barebaric/rayforge/website/docs/ui/bottom-panel.md

---
description:
  "The bottom panel in Rayforge provides job progress, G-code preview, and machine status. Monitor
  your laser cutter during operation."
---

# Bottom Panel

The Bottom Panel at the bottom of the Rayforge window provides manual control over your laser
cutter's position, real-time machine status, a log view for monitoring operations, a G-code viewer,
and an asset browser.

## Overview

The Bottom Panel combines several functions into one convenient interface:

1. **Dockable Tabs**: Switch between Console, G-code Viewer, and Assets using the icon strip on the
   left
2. **Jog Controls**: Manual movement and positioning (always visible)
3. **Machine Status**: Real-time position and connection state
4. **Work Coordinate System (WCS)**: Quick WCS selection (always visible)

Each panel area has an icon tab strip on the left that lets you switch between the **Console**, the
**G-code Viewer**, and the **Assets** browser. The jog controls and WCS controls on the right side
remain visible regardless of which tab is active. Tabs can be reordered by dragging within their
strip, and you can drag tabs between panel areas or onto dividers to rearrange the layout into
multiple columns. Empty columns are removed automatically.

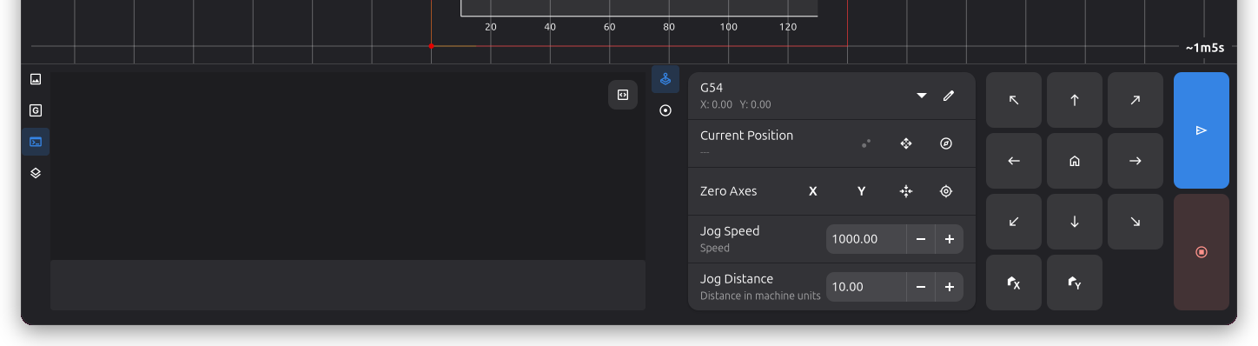
[picture p15: website/static/screenshots/bottom-panel-console.webp]
Bottom Panel


## Accessing the Bottom Panel

The Bottom Panel can be toggled via:

- **Menu**: View → Bottom Panel
- **Keyboard Shortcut**: Ctrl+L

<!-- prettier-ignore-start -->
:::note[Connection Required]
The jog controls are only available when connected to a machine that
supports jogging operations.
:::
<!-- prettier-ignore-end -->

## Jog Controls

The jog controls provide manual control over your laser cutter's position, allowing you to precisely
move the laser head for setup, alignment, and testing purposes.

### Homing Controls

Home your machine's axes to establish a reference position:

| Button | Function | Description |
| --- | --- | --- |
| Home All | Homes all axes | Homes all axes simultaneously |

<!-- prettier-ignore-start -->
:::tip[Homing Sequence]
It's recommended to home all axes before starting any job to ensure accurate
positioning.
:::
<!-- prettier-ignore-end -->

### Directional Movement

The jog controls provide buttons for directional movement:

```
  ↖  ↑  ↗
  ←  •  →
  ↙  ↓  ↘
```

| Button | Movement | Keyboard Shortcut |
| --- | --- | --- |
| ↑ | Y+ (Y- if machine is Y-flipped) | Up Arrow |
| ↓ | Y- (Y+ if machine is Y-flipped) | Down Arrow |
| ← | X- (left) | Left Arrow |
| → | X+ (right) | Right Arrow |
| ↖ (top-left) | X- Y+/- (diagonal) | - |
| ↗ (top-right) | X+ Y+/- (diagonal) | - |
| ↙ (bottom-left)  | X- Y-/+ (diagonal) | - |
| ↘ (bottom-right) | X+ Y-/+ (diagonal) | - |
| Z+ | Z axis up | Page Up |
| Z- | Z axis down | Page Down |

<!-- prettier-ignore-start -->
:::note[Focus Required]
Keyboard shortcuts only work when the main window has focus.
:::
<!-- prettier-ignore-end -->

### Visual Feedback

The jog buttons provide visual feedback:

- **Normal**: Button is enabled and safe to use
- **Warning (orange)**: Movement would approach or exceed soft limits
- **Disabled**: Movement is not supported or machine is not connected

### Jog Settings

Configure the behavior of jog operations:

**Jog Speed:**

- **Range**: 1-60,000 mm/min
- **Default**: 1,000 mm/min
- **Purpose**: Controls how fast the laser head moves
- **Persistence**: The last used speed is stored per machine

<!-- prettier-ignore-start -->
:::tip[Speed Selection]
- Use lower speeds (100-500 mm/min) for precise positioning
- Use higher speeds (1,000-3,000 mm/min) for larger movements
- Very high speeds may cause missed steps on some machines
:::
<!-- prettier-ignore-end -->

**Jog Distance:**

- **Range**: 0.1-1,000 mm
- **Default**: 10.0 mm
- **Purpose**: Controls how far the laser head moves per button press

<!-- prettier-ignore-start -->
:::tip[Distance Selection]
- Use small distances (0.1-1.0 mm) for fine-tuning
- Use medium distances (5-20 mm) for general positioning
- Use large distances (50-100 mm) for quick repositioning
:::
<!-- prettier-ignore-end -->

## Moving the Laser Head

In addition to jogging, the laser head can be moved to an exact position. All of these moves use the
**Jog Speed** setting described above.

### Move to Position Popover

Click the compass icon in the Current Position row to open the Move to Position popover. It is
prefilled with the current position, and coordinates are entered in the active work coordinate
system, matching the position readout:

| Control | Function |
| --- | --- |
| X / Y / Z | Target coordinates (Z only on machines with a Z axis) |
| Move | Moves the head to the entered coordinates |
| Lower-Left | Move to lower-left of the selection, or workarea if none  |
| Center | Move to center of the selection, or workarea if none |
| Upper-Right | Move to upper-right of the selection, or workarea if none |
| Move to WCS Origin | Move to X0 Y0 of the active WCS |

The popover and its shortcuts are disabled while the machine is offline.

### Click Canvas to Move Head

Click the move icon in the Current Position row (or press <kbd>Ctrl+M</kbd>) to arm the mode. The
next left-click on empty canvas space moves the head to that point, and the mode then deactivates
automatically. Right-clicking cancels the mode without moving the head. Arming this mode deactivates
Click to Zero, and vice versa.

### Move Head Here

Right-clicking empty canvas space offers a **Move Head Here** entry that moves the head directly to
the clicked point.

## Machine Status Display

The Control Panel displays real-time information about your machine:

### Current Position

Shows the laser head's position in the active coordinate system:

- Coordinates are relative to the selected WCS origin
- Updates in real-time as you jog or run jobs
- Format: X, Y, Z values in millimeters

### Connection Status

- **Connected**: Green indicator, machine is responding
- **Disconnected**: Gray indicator, no machine connection
- **Error**: Red indicator, connection or communication problem

### Machine State

- **Idle**: Machine is ready for commands
- **Run**: Job is currently executing
- **Hold**: Job is paused
- **Alarm**: Machine is in alarm state
- **Home**: Homing cycle is in progress

## Work Coordinate System (WCS)

The Control Panel provides quick access to Work Coordinate System management.

### Active System Selection

Select which coordinate system is currently active:

| Option | Type  | Description |
| --- | ----- | --- |
| G53 (Machine) | Fixed | Absolute machine coordinates, cannot be changed |
| G54 (Work 1)  | User  | First work coordinate system |
| G55 (Work 2)  | User  | Second work coordinate system |
| G56 (Work 3)  | User  | Third work coordinate system |
| G57 (Work 4)  | User  | Fourth work coordinate system |
| G58 (Work 5)  | User  | Fifth work coordinate system |
| G59 (Work 6)  | User  | Sixth work coordinate system |

### Setting WCS Zero

Define where the origin of the active WCS should be:

| Button | Function  | Description |
| --- | --- | --- |
| Click to Zero  | Set X,Y=0 | Click the crosshairs icon, then click on the canvas to set work zero |
| Go to WCS Zero | Move | Move the laser head to X0 Y0 of the active WCS |
| Edit Offsets | Edit | Manually edit WCS offset values |
| Zero X | Set X=0 | Makes current X position the X origin for active WCS |
| Zero Y | Set Y=0 | Makes current Y position the Y origin for active WCS |
| Zero Z | Set Z=0 | Makes current Z position the Z origin for active WCS |

<!-- prettier-ignore-start -->
:::note[G53 Cannot Be Changed]
Zero buttons are disabled when G53 (Machine Coordinates) is selected,
as machine coordinates are fixed by hardware.
:::
<!-- prettier-ignore-end -->

<!-- prettier-ignore-start -->
:::tip[Setting WCS Workflow]
1. Connect to your machine and home all axes
2. Select the WCS you want to configure (e.g., G54)
3. Jog the laser head to the desired origin position
4. Click Zero X and Zero Y to set this position as (0, 0)
5. The offset is stored in your machine's controller
:::
<!-- prettier-ignore-end -->

## Console Tab

The Console tab provides an interactive terminal-style interface for sending G-code commands and
monitoring machine communication. Click the console icon in the tab strip to switch to this view.

### Command Input

The command input box allows you to send raw G-code directly to the machine:

- **Multi-line Support**: Paste or type multiple commands
- **Enter**: Sends all commands
- **Shift+Enter**: Inserts a newline (for editing before sending)
- **History**: Use Up/Down arrows to navigate previously sent commands

### Log Display

The log shows communication between Rayforge and your machine with syntax highlighting for easy
reading:

- **User Commands** (blue): Commands you entered or sent during jobs
- **Timestamps** (gray): Time of each message
- **Errors** (red): Error messages from the machine
- **Warnings** (orange): Warning messages
- **Status Polls** (dim): Real-time position/status reports like
  `&lt;Idle|WPos:0.000,0.000,0.000|...&gt;`

### Verbose Mode

Click the terminal icon in the top-right corner of the console to toggle verbose output:

- **Off** (default): Hides frequent status polls and "ok" responses
- **On**: Shows all machine communication

### Auto-Scroll Behavior

The console automatically scrolls to show new messages:

- Scrolling up disables auto-scroll so you can review history
- Scrolling to the bottom re-enables auto-scroll
- New messages appear immediately when auto-scroll is active

### Using the Console for Troubleshooting

The console is invaluable for diagnosing issues:

- Verify commands are being sent correctly
- Check for error messages from the controller
- Monitor connection status and stability
- Review job execution progress in real-time
- Send diagnostic commands (e.g., `$$` to view GRBL settings)

## G-code Viewer Tab

The G-code Viewer tab displays the generated G-code for the current operations. Click the G-code
icon in the tab strip to switch to this view.

### Features

- **Syntax Highlighting**: G-code commands are color-coded for readability
- **Line Highlighting**: The currently executing line is highlighted during job execution
- **Auto-Refresh**: The G-code content updates automatically when operations or document settings
  change

## Assets Tab

The Assets tab shows all stock items and sketches in your document. Click the assets icon in the tab
strip to switch to this view.

When the asset list is empty, it displays buttons to add stock or create a new sketch. You can drag
assets from this list onto the canvas to place them. Double-clicking a stock asset opens its
properties.

Right-clicking an asset opens a context menu with options to create a new workpiece from the asset,
duplicate, copy, cut, or delete it. Right-clicking empty space in the asset list offers options to
create a new sketch, add stock, import a file, or paste from the clipboard.

When the Console or G-code Viewer tab is active, you can also press <kbd>Ctrl+F</kbd> to search
within the content.

## Laser Control

The Laser dock provides manual control over your laser for testing, alignment, and focusing. It
appears as a tab alongside the Controls dock in the bottom panel.

### Laser Head Selector

A dropdown lists all configured laser heads. When your machine has multiple heads, pick the one you
want to control. The subtitle shows the tool number and maximum power for the selected head.

### Toggle Button

The toggle button next to the head selector turns the laser on or off. When the laser is active, the
button turns red as a safety indicator. The laser can also be toggled from the toolbar button in the
main window header.

### Power

A slider and text entry control the laser power from 0 to 100 percent. When you switch to a
different laser head, the power resets to that head's configured focus power.

### Frequency and Pulse Width

These controls appear only when the selected laser head is a CO2 or Fiber type. They let you set the
PWM frequency (Hz) and pulse width (microseconds) for manual laser operation. For Diode lasers,
these fields are hidden.

### Duration (Auto-Off Timer)

Set a duration in seconds after which the laser automatically turns off. Set to 0 for continuous
operation — the laser stays on until you manually turn it off. A countdown label appears below the
controls while the timer is running.

### Safety

- All controls are disabled when no laser heads are configured
- The toggle button requires an active machine connection
- If the machine disconnects while the laser is on, the laser is turned off automatically and any
  running timer is cancelled

## Machine Compatibility

The Bottom Panel adapts to your machine's capabilities:

### Axis Support

- **X/Y Axis**: Supported by virtually all laser cutters
- **Z Axis**: Only available on machines with Z-axis control
- **Diagonal Movement**: Requires support for both X and Y axes

### Machine Types

| Machine Type | Jog Support | Notes |
| --- | --- | --- |
| GRBL (v1.1+) | Full | Supports all jog features |
| Smoothieware | Full | Supports all jog features |
| Custom Controllers | Variable | Depends on implementation |

## Safety Features

### Soft Limits

When soft limits are enabled in your machine profile:

- Buttons show orange warning when approaching limits
- Movement is automatically limited to prevent exceeding bounds
- Provides visual feedback to prevent crashes

### Connection Status

- All controls are disabled when not connected to a machine
- Buttons update sensitivity based on machine state
- Prevents accidental movement during operation

---

**Related Pages:**

- [Work Coordinate Systems (WCS)](../general-info/coordinate-systems.md) - Managing WCS
- [Machine Setup](../machine/general.md) - Configure your machine
- [Keyboard Shortcuts](../reference/shortcuts.md) - Complete shortcut reference
- [Main Window](main-window) - Main interface overview
- [General Settings](../machine/general.md) - Device configuration
