barebaric/rayforge/website/docs/application-settings/machines.md

---
description:
  "Manage machines in Rayforge - add, configure, export, import, and switch between different laser
  cutters and engravers for your projects."
---

# Machines

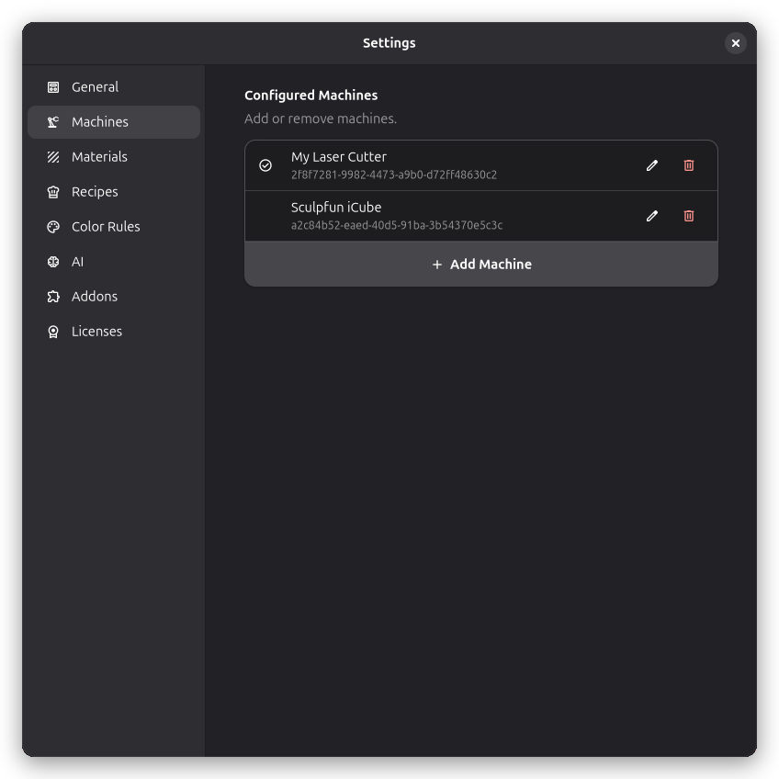
[picture p30: website/static/screenshots/app-settings-machines.webp]
Machines Settings


The Machines page in Application Settings shows a list of all configured machines. Each entry shows
the machine name and has buttons to edit or delete it. The currently active machine is marked with a
check icon.

## Adding a Machine

1. Click the **Add Machine** button at the bottom of the list
2. Select a device profile from the list to use as a template — each profile pre-configures the
   machine settings and G-code dialect

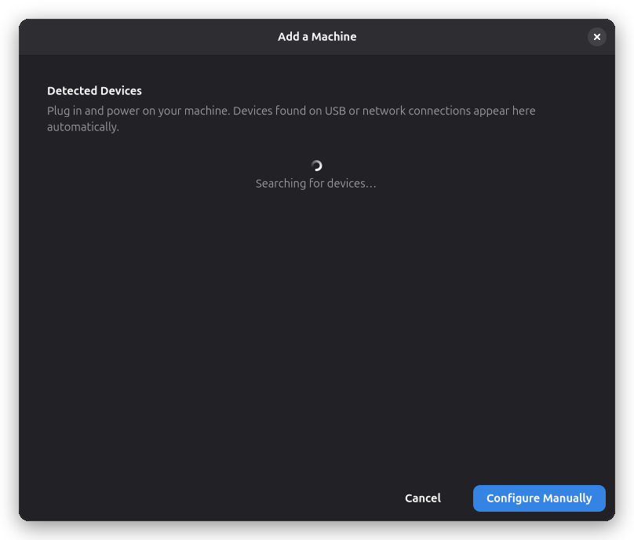
[picture p31: website/static/screenshots/app-settings-machines-add.webp]
Add Machine Dialog


3. The [machine settings dialog](../machine/general.md) opens where you can adjust the configuration

Alternatively:

- Click **Device Not Listed** to launch the
  [Configuration Wizard](../getting-started/first-time-setup.md), which walks you through
  configuring a machine step by step
- Click **Import from File…** to add a machine from a previously exported profile or from a
  LightBurn device profile (.lbdev). LightBurn profiles include camera calibration and laser
  settings that are applied to the new machine

## Editing a Machine

Click the edit icon next to a machine to open the [machine settings dialog](../machine/general.md).

## Machine Notes

The **Notes** category, directly after **General**, brings together guidance supplied by the device
profile and your own notes for that machine. Device notes are read-only; **My Notes** can be edited
with Markdown. Supported syntax includes headings, paragraphs, bold, italic, lists, links, inline
code, fenced code blocks, and expandable `:::details` sections.

When a profile includes setup guidance, it also appears on the wizard's final **Review & Name** page
and remains available under **Machine Settings → Notes** after the machine is created. Personal
notes are saved per machine and are not replaced when reviewing profile updates.

## Switching the Active Machine

Use the machine dropdown in the main window header to switch between configured machines. The
selection is remembered between sessions.

## Deleting a Machine

1. Click the delete icon next to the machine
2. Confirm the deletion

<!-- prettier-ignore-start -->
:::warning
Deleting a machine cannot be undone. Export the profile first if you want to preserve the
configuration.
:::
<!-- prettier-ignore-end -->
