barebaric/rayforge/website/docs/ui/3d-preview.md

---
description:
  "Preview your laser job in full 3D. Visualize toolpaths, rotary axis operations, and material
  removal before sending G-code to your machine."
---

# 3D View

The 3D view lets you visualize your G-code toolpaths and simulate job execution before sending them
to your machine.

3D Preview

## Opening 3D View

Access the 3D view:

- **Menu**: View → 3D View
- **Keyboard**: <kbd>F12</kbd>

## Navigation

### Mouse Controls

- **Rotate**: Left-click and drag (Z-axis), middle-click and drag (3-axis orbit)
- **Pan**: <kbd>shift</kbd> + middle-click and drag
- **Zoom**: Scroll wheel

### View Presets

Quick camera angles:

- **Top** (<kbd>1</kbd>): Bird's eye view
- **Front** (<kbd>2</kbd>): Front elevation
- **Right** (<kbd>3</kbd>): Right side view
- **Left** (<kbd>4</kbd>): Left side view
- **Back** (<kbd>5</kbd>): Back elevation
- **Isometric** (<kbd>7</kbd>): 3D isometric view

## Work Coordinate System Display

The 3D view visualizes the active Work Coordinate System (WCS) differently from the 2D canvas:

### Grid and Axes

- **Isolated display**: The grid and axes appear as if the WCS origin is the world origin
- **Offset applied**: The entire grid is shifted to align with the selected WCS offset
- **Labels relative to WCS**: Coordinate labels show positions relative to the WCS origin, not
  machine origin

This "in isolation" display makes it easy to understand where your job will run relative to the
selected work coordinate system, without being confused by the machine's absolute position.

### Changing WCS

The 3D view automatically updates when you change the active WCS:

- Select a different WCS from the toolbar dropdown
- The grid and axes shift to reflect the new WCS origin
- Labels update to show coordinates relative to the new WCS

<!-- prettier-ignore-start -->
:::tip[WCS in 3D View]
The 3D view shows your toolpaths relative to the selected WCS. When you change
WCS, you'll see the toolpaths appear to move because the reference point (the grid) has changed, not
because the toolpaths themselves moved.
:::
<!-- prettier-ignore-end -->

## Display Options

Visibility toggles are located as overlay buttons at the top-right of the 3D canvas. Each button
remembers its state between sessions:

- **Workpiece image**: Toggle the workpiece's base image on the stock surface — the same image shown
  on the 2D canvas
- **Stock**: Toggle the stock material blocks
- **Model**: Toggle the 3D machine model visibility
- **Grid**: Toggle the coordinate grid visibility
- **Ops underlay**: Toggle the semi-transparent raster engraving preview on the workpiece surface
- **Travel moves**: Toggle rapid travel move visibility
- **No-go zones**: Toggle no-go zone visibility. This button only appears when your machine has at
  least one no-go zone configured.

Perspective and orthographic projection are toggled with <kbd>P</kbd> or **View → Toggle
Perspective**.

### Toolpath Visualization

Customize what you see:

- **Show Rapid Moves**: Display travel moves (dotted lines)
- **Show Work Moves**: Display cutting/engraving moves (solid lines)
- **Color by Operation**: Different colors for each operation

<!-- prettier-ignore-start -->
:::tip[Per-Laser Colors]
When using machines with multiple laser heads, each laser can have its own
color configured in [Laser Settings](../machine/laser.md). This makes it easy to identify which
laser will perform each operation.
:::
<!-- prettier-ignore-end -->

### Laser Head Model

The 3D view renders a model of your laser head that moves along the toolpath during simulation. You
can assign a 3D model to each laser head in the [Laser Settings](../machine/laser.md) page of
Machine Settings. The model's scale, rotation, and focal distance can be adjusted to match your
physical setup.

During simulation, a glowing laser beam is drawn from the head downward when the laser is active.

## Physical Burn Model

When you engrave, the 3D view no longer shows the result as a flat overlay on top of the stock.
Laser raster and vector operations now **char the stock itself** — the preview shows burning driven
by a physically motivated model that accounts for:

- Your laser's **wavelength**, **optical wattage**, and **spot size** (configured in
  [Laser Settings](../machine/laser.md)).
- The **material's absorption** at that wavelength (defined in the
  [material library](../application-settings/materials.md#absorption)).
- The **scan speed**, which sets the energy delivered per unit area (fluence, in J/cm²).

The result is a power-keyed scorch ramp with a heat halo on top-facing surfaces. It works for rotary
too — engraving bakes into the rotary stock.

<!-- prettier-ignore-start -->
:::note[Calibration]
The burn model is physically motivated but not yet fully calibrated across all
materials and laser types. You can help improve it: run a
[material test grid](../features/operations/material-test-grid.md) and share the result photo along
with your machine data (wavelength, optical wattage, spot size, speed, and the powers/depths
tested).
:::
<!-- prettier-ignore-end -->

## Simulation

The 3D view includes a built-in simulator with playback controls overlaid at the bottom of the
canvas.

### Playback Controls

- **Play/Pause** (<kbd>space</kbd>): Animate toolpath execution
- **Step Forward/Back**: Advance or rewind by one operation at a time
- **Speed**: Cycle through playback speeds (1x, 2x, 4x, 8x, 16x)
- **Timeline slider**: Drag to scrub through the job

### Synchronized G-code View

The simulation stays in sync with the G-code viewer in the bottom panel. Stepping through the
simulation highlights the corresponding line in the G-code viewer, and clicking a line in the G-code
viewer jumps the simulation to that point.

### Layer Visibility

Toggle visibility of individual layers:

- Click a layer name to show or hide it
- Focus on specific layers for inspection

## Verification Checklist

Before sending to machine, verify:

- [ ] Toolpath is complete with no missing segments
- [ ] Engrave operations run before cuts
- [ ] Job starts at the expected position
- [ ] Holding tabs are in the correct locations

Some additional checks are performed automatically. When you run or export a job, Rayforge runs
[sanity checks](../features/sanity-checks.md) that verify machine extents, workarea boundaries, and
no-go zone collisions.

## Performance Tips

For large or complex jobs:

1. Hide rapid moves to focus on work moves only
2. Reduce the number of visible layers
3. Close other applications to free up GPU resources

## Troubleshooting

### Preview is blank or black

- Check that operations are enabled
- Verify objects have operations assigned

### Slow or laggy preview

- Hide rapid moves
- Hide 3D models
- Reduce the number of visible layers

---

**Related Pages:**

- [Work Coordinate Systems](../general-info/coordinate-systems.md) - WCS
- [Main Window](main-window) - Main interface overview
- [Settings](settings) - Application preferences
