barebaric/rayforge/website/i18n/uk/docusaurus-plugin-content-docs/current/machine/hardware.md

# Налаштування обладнання

Сторінка "Обладнання" у налаштуваннях машини налаштовує фізичні розміри, систему координат та
обмеження руху вашої машини.

Налаштування обладнання

## Осі

Налаштуйте діапазони осей та систему координат для вашої машини.

### Діапазон X/Y

Повний хід кожної осі в одиницях машини.

- Виміряйте фактичну область різання, а не зовнішній розмір машини
- Врахуйте будь-які перешкоди або обмеження
- Приклад: 400 для типового лазера K40

### Початок координат

Виберіть, де знаходиться початок координат (0,0) вашої машини. Це визначає, як інтерпретуються
координати.

- **Лівий нижній**: Найпоширеніший для пристроїв GRBL. X збільшується вправо, Y збільшується вгору.
- **Лівий верхній**: Поширений для деяких машин типу CNC. X збільшується вправо, Y збільшується
  вниз.
- **Правий верхній**: X збільшується вліво, Y збільшується вниз.
- **Правий нижній**: X збільшується вліво, Y збільшується вгору.

#### Визначення вашого початку координат

1. Виконайте回家 (homing) вашої машини за допомогою кнопки Home
2. Спостерігайте, куди переміщується лазерна головка
3. Ця позиція є вашим початком координат (0,0)

:::інформація Налаштування початку координат впливає на те, як генерується G-code. Переконайтеся, що
воно відповідає конфігурації homing у вашій прошивці. :::

### Напрямок осі

Змініть напрямок будь-якої осі за потреби:

- **Інвертувати вісь X**: Робить значення координат X від'ємними
- **Інвертувати вісь Y**: Робить значення координат Y від'ємними
- **Інвертувати вісь Z**: Увімкніть, якщо позитивна команда Z (наприклад, G0 Z10) переміщує головку
  вниз

### Вісь Z

Не кожен лазер має вісь Z — багато простих 2-вісних діодних машин її не мають. Використовуйте ці
налаштування, щоб повідомити Rayforge, чи може ваша машина рухатися по осі Z:

- **Має вісь Z**: Увімкніть, якщо ця машина має вісь Z (мотор фокусування, рухомий стіл або портал,
  що може рухатися вертикально). Якщо вимкнено, вісь Z вважається відсутньою: рухи по Z не
  генеруються, а 3D-полотно розміщує вміст на площині гравіювання замість того, щоб показувати
  головку, що рухається вздовж Z.
- **Інвертувати вісь Z**: Показується лише тоді, коли увімкнено **Має вісь Z**. Увімкніть, якщо
  позитивна команда Z (наприклад, G0 Z10) переміщує головку вниз.
- **Z Min / Z Max**: Показується лише тоді, коли увімкнено **Має вісь Z**. Найнижча та найвища
  координата Z у системі відліку машини. Рухи jog по Z обмежуються цим діапазоном, а спливач
  «Перемістити до позиції» приймає повний діапазон Z між цими двома значеннями.

### Орієнтація панелі

Орієнтація панелі повертає плоску робочу область, як вона відображається на екрані, і перенаправляє
вивід назад на машину. Це корисно, коли фізично портретне розташування столу зручніше редагувати в
альбомному.

- **Рідний**: Робоча область відображається точно так, як орієнтована машина
- **Повернути ліворуч**: Робоча область повертається на 90 градусів проти годинникової стрілки
- **Повернути праворуч**: Робоча область повертається на 90 градусів за годинниковою стрілкою

Ротаційні шари потребують орієнтації **Рідний**.

## Робоча область

Поля визначають непридатний простір навколо країв діапазонів осей. Це корисно, коли ваша машина має
ділянки, куди лазер не може дістати (наприклад, через складальну частину лазерної головки, кабельні
ланцюги або інші перешкоди).

- **Ліве/Верхнє/Праве/Нижнє поле**: Непридатний простір від кожного краю в одиницях машини

Коли поля встановлені, робоча область (придатний простір) розраховується як діапазони осей мінус
поля.

## Програмні обмеження

Налаштовані межі безпеки для переміщення головки машини. Коли увімкнено, елементи керування
переміщенням запобігатимуть руху за межами цих обмежень. Коли вимкнено, переміщення не обмежується.

- **Увімкнути програмні обмеження**: Вмикає або вимикає перевірку обмежень переміщення
- **X/Y Мінімальна відстань від початку**: Найменша допустима відстань від кута початку координат по
  кожній осі
- **X/Y Максимальна відстань від початку**: Найбільша допустима відстань від кута початку координат
  по кожній осі

Програмні обмеження оцінюються в машинних координатах і залишаються прив'язаними до фізичної
станини, тому вони не переміщуються, коли робочий початок скидається на нуль. Значення вводяться як
відстані від кута початку координат у бік станини. Без власних обмежень під час увімкнення
використовуються діапазони осей. Обмеження автоматично обмежуються, щоб залишатися в межах
діапазонів осей (від 0 до значення діапазону).

:::порада Використовуйте програмні обмеження для захисту ділянок вашої робочої поверхні, які ніколи
не повинні досягатися під час переміщення, наприклад, ділянок з оснащенням або чутливим обладнанням.
:::

## Дивіться також

- [Загальні налаштування](general) - Назва машини та налаштування швидкості
- [Налаштування пристрою](device) - Налаштування homing та осей GRBL
