barebaric/rayforge/website/i18n/zh-CN/docusaurus-plugin-content-docs/current/machine/hardware.md

# 硬件设置

机器设置中的硬件页面配置机器的物理尺寸、坐标系统和移动限制。

硬件设置

## 轴

配置机器的轴范围和坐标系统。

### X/Y 范围

每个轴在机器单位中的完整行程范围。

- 测量实际切割区域，而不是机器外部
- 考虑任何障碍物或限制
- 例如：典型的 K40 激光为 400

### 坐标原点

选择机器坐标原点 (0,0) 的位置。这决定了坐标的解释方式。

- **左下角**：GRBL 设备最常见。X 向右增加，Y 向上增加。
- **左上角**：某些 CNC 风格的机器常见。X 向右增加，Y 向下增加。
- **右上角**：X 向左增加，Y 向下增加。
- **右下角**：X 向左增加，Y 向上增加。

#### 查找原点

1. 使用归零按钮归零机器
2. 观察激光头移动到的位置
3. 该位置就是您的 (0,0) 原点

<!-- prettier-ignore-start -->
:::info
坐标原点设置影响 G 代码的生成方式。确保它与您的固件归零配置匹配。
:::
<!-- prettier-ignore-end -->

### 轴方向

如需要，反转任何轴的方向：

- **反转 X 轴方向**：使 X 坐标值为负
- **反转 Y 轴方向**：使 Y 坐标值为负
- **反转 Z 轴方向**：如果正 Z 命令（例如 G0 Z10）使头向下移动，则启用

### Z 轴

并非所有激光器都有 Z 轴 — 许多简单的 2 轴二极管机器没有。使用这些设置告诉 Rayforge 您的机器是否可以沿 Z 移动：

- **有 Z 轴**：如果这台机器有 Z 轴（对焦电机、可移动床台或可以垂直移动的龙门架），则启用。禁用时，Z 轴被视为不存在：不生成 Z 移动，3D 画布将内容分层放置在雕刻平面上，而不是显示沿 Z 移动的激光头。
- **反转 Z 轴方向**：仅在启用**有 Z 轴**时显示。如果正 Z 命令（例如 G0 Z10）使头向下移动，则启用。
- **Z Min / Z
  Max**：仅在启用**有 Z 轴**时显示。机器坐标系中的最低和最高 Z 坐标。Z 点动移动会被限制在此范围内，“移动到位置”弹出框接受两个值之间的完整 Z 范围。

### 面板方向

面板方向旋转平面工作区在屏幕上的呈现方式，并将输出重新映射回机器。当物理纵向工作台更容易以横向方式编辑时，这很有用。

- **原生**：工作区按机器的实际方向显示
- **向左旋转**：工作区逆时针旋转 90 度
- **向右旋转**：工作区顺时针旋转 90 度

旋转层需要**原生**方向。

## 工作区域

边距定义轴范围边缘周围不可使用的空间。当您的机器有激光无法到达的区域（例如，由于激光头组件、电缆链或其他障碍物）时，这很有用。

- **左/上/右/下边距**：从每个边缘开始的不可使用空间（机器单位）

设置边距后，工作区域（可用空间）计算为轴范围减去边距。

## 软限位

可配置的点动机器头的安全边界。启用后，点动控制将阻止超出这些限制的移动。禁用后，点动不受限制。

- **启用软限位**：开启或关闭点动限制检查
- **X/Y 距原点最小距离**：每个轴允许的距原点角的最小距离
- **X/Y 距原点最大距离**：每个轴允许的距原点角的最大距离

软限位在机器坐标中计算，并固定在物理工作台上，因此在重新设置工作原点时它们不会移动。数值以距坐标原点角向工作台内部的距离输入。启用但没有自定义边界时，使用轴范围。限位自动限制在轴范围内（0 到范围值）。

<!-- prettier-ignore-start -->
:::tip
使用软限位保护工作表面上永远不应到达的区域，例如有夹具或敏感设备的区域。
:::
<!-- prettier-ignore-end -->

## 另请参阅

- [常规设置](general) - 机器名称和速度设置
- [设备设置](device) - GRBL 归零和轴设置
