barebaric/rayforge/website/i18n/hi/docusaurus-plugin-content-docs/current/machine/hardware.md

---
description:
  "Rayforge में हार्डवेयर सेटिंग्स कॉन्फ़िगर करें — स्टेपर मोटर, त्वरण, चालन सीमाएँ, और अपने लेज़र
  कटर की भौतिक विमाएँ."
---

# हार्डवेयर सेटिंग्स

मशीन सेटिंग्स का हार्डवेयर पृष्ठ आपकी मशीन की भौतिक विमाएँ, निर्देशांक प्रणाली, और गति सीमाएँ
कॉन्फ़िगर करता है.

हार्डवेयर सेटिंग्स

## अक्ष

अपनी मशीन के लिए अक्ष विस्तार और निर्देशांक प्रणाली कॉन्फ़िगर करें.

### X/Y विस्तार

मशीन इकाइयों में प्रत्येक अक्ष की पूर्ण चालन सीमा.

- वास्तविक कटिंग क्षेत्र मापें, मशीन का बाहरी भाग नहीं
- किसी भी बाधा या सीमा की गिनती करें
- उदाहरण: एक सामान्य K40 लेज़र के लिए 400

### निर्देशांक मूल

चुनें कि आपकी मशीन का निर्देशांक मूल (0,0) कहाँ स्थित है. यह निर्धारित करता है कि निर्देशांक कैसे
व्याख्या किए जाते हैं.

- **निचला बायाँ**: GRBL डिवाइसों के लिए सबसे सामान्य. X दाईं ओर बढ़ता है, Y ऊपर बढ़ता है.
- **ऊपरी बायाँ**: कुछ CNC-शैली मशीनों के लिए सामान्य. X दाईं ओर बढ़ता है, Y नीचे बढ़ता है.
- **ऊपरी दायाँ**: X बाईं ओर बढ़ता है, Y नीचे बढ़ता है.
- **निचला दायाँ**: X बाईं ओर बढ़ता है, Y ऊपर बढ़ता है.

#### अपना मूल बिंदु खोजें

1. Home बटन से अपनी मशीन होम करें
2. देखें कि लेज़र हेड कहाँ चला जाता है
3. वह स्थिति आपका (0,0) मूल बिंदु है

<!-- prettier-ignore-start -->
:::info
निर्देशांक मूल सेटिंग प्रभावित करती है कि G-code कैसे जनरेट होता है. सुनिश्चित करें कि वह
आपके फ़र्मवेयर की होमिंग कॉन्फ़िगरेशन से मेल खाती है.
:::
<!-- prettier-ignore-end -->

### अक्ष दिशा

आवश्यकता होने पर किसी भी अक्ष की दिशा उलटें:

- **X-अक्ष दिशा उलटें**: X निर्देशांक मान ऋणात्मक बनाता है
- **Y-अक्ष दिशा उलटें**: Y निर्देशांक मान ऋणात्मक बनाता है
- **Z-अक्ष दिशा उलटें**: सक्षम करें यदि धनात्मक Z कमांड (जैसे, G0 Z10) हेड को नीचे ले जाता है

### Z-अक्ष

हर लेज़र में Z अक्ष नहीं होता — कई सरल 2-अक्ष डायोड मशीनों में नहीं होता. Rayforge को बताने के लिए
ये सेटिंग्स उपयोग करें कि आपकी मशीन Z में चल सकती है या नहीं:

- **Z-अक्ष सहित**: सक्षम करें यदि इस मशीन में Z अक्ष है (फ़ोकस मोटर, चलायमान बेड, या लंबवत चलने वाली
  गैंट्री). अक्षम होने पर Z अक्ष अनुपस्थित माना जाता है: कोई Z गति जनरेट नहीं होती, और 3D कैनवस Z पर
  चलते हेड दिखाने के बजाय सामग्री को उत्कीर्णन समतल पर परत बनाता है.
- **Z-अक्ष दिशा उलटें**: केवल तब दिखाया जाता है जब **Z-अक्ष सहित** सक्षम हो. सक्षम करें यदि धनात्मक
  Z कमांड (जैसे, G0 Z10) हेड को नीचे ले जाता है.
- **Z न्यूनतम / Z अधिकतम**: केवल तब दिखाया जाता है जब **Z-अक्ष सहित** सक्षम हो. मशीन फ़्रेम में
  न्यूनतम और अधिकतम Z निर्देशांक. Z जॉग गतियाँ इस सीमा तक सीमित होती हैं, और स्थिति पर ले जाएँ
  पॉपओवर दोनों मानों के बीच पूरी Z सीमा स्वीकार करता है.

### पैनल अभिविन्यास

पैनल अभिविन्यास समतल कार्यक्षेत्र को स्क्रीन पर प्रस्तुत होने अनुसार घुमाता है और आउटपुट को वापस
मशीन पर पुनः मैप करता है. यह तब उपयोगी होता है जब भौतिक रूप से पोर्ट्रेट-उन्मुख बेड को लैंडस्केप में
संपादित करना आसान हो.

- **Native**: कार्यक्षेत्र ठीक मशीन के उन्मुख होने अनुसार दिखाया जाता है
- **Rotate Left**: कार्यक्षेत्र 90 डिग्री वामावर्त घुमाया जाता है
- **Rotate Right**: कार्यक्षेत्र 90 डिग्री दक्षिणावर्त घुमाया जाता है

रोटरी लेयर को **Native** अभिविन्यास चाहिए.

## कार्य क्षेत्र

मार्जिन आपके अक्ष विस्तारों के किनारों के चारों ओर का अप्रयोग्य स्थान परिभाषित करते हैं. यह तब
उपयोगी है जब आपकी मशीन में ऐसे क्षेत्र हों जहाँ लेज़र नहीं पहुँच सकता (जैसे, लेज़र हेड असेंबली, केबल
चेन, या अन्य बाधाओं के कारण).

- **बायाँ/ऊपरी/दायाँ/निचला मार्जिन**: प्रत्येक किनारे से मशीन इकाइयों में अप्रयोग्य स्थान

मार्जिन सेट होने पर, कार्य क्षेत्र (उपयोग योग्य स्थान) अक्ष विस्तारों माइनस मार्जिन के रूप में गणना
होता है.

## सॉफ़्ट लिमिट

मशीन हेड जॉग करने के लिए कॉन्फ़िगर योग्य सुरक्षा सीमाएँ. सक्षम होने पर, जॉग नियंत्रण इन सीमाओं के
बाहर गति रोक देंगे. अक्षम होने पर, जॉगिंग सीमित नहीं होती है.

- **सॉफ़्ट लिमिट सक्षम करें**: जॉग लिमिट जाँच चालू या बंद करता है
- **X/Y न्यूनतम**: प्रत्येक अक्ष का न्यूनतम निर्देशांक
- **X/Y अधिकतम**: प्रत्येक अक्ष का अधिकतम निर्देशांक

सॉफ़्ट लिमिट का मूल्यांकन मशीन निर्देशांकों में किया जाता है और ये भौतिक बेड से बंधे रहते हैं, इसलिए
कार्य मूल बिंदु को फिर से शून्य पर सेट करने पर ये नहीं हिलते. मान निर्देशांक मूल कोने से बेड की ओर
की दूरियों के रूप में दर्ज किए जाते हैं. बिना कस्टम सीमाओं के सक्षम करने पर अक्ष विस्तारों का उपयोग
किया जाता है. सीमाएँ अक्ष विस्तारों (0 से विस्तार मान तक) के भीतर रहने के लिए स्वतः सीमित होती हैं.

<!-- prettier-ignore-start -->
:::tip
जॉगिंग के दौरान कभी न पहुँचे जाने वाले अपने कार्य सतह के क्षेत्रों की रक्षा के लिए सॉफ़्ट
लिमिट उपयोग करें, जैसे फ़िक्स्चर या संवेदनशील उपकरण वाले क्षेत्र.
:::
<!-- prettier-ignore-end -->

## यह भी देखें

- [सामान्य सेटिंग्स](general) - मशीन नाम और गति सेटिंग्स
- [डिवाइस सेटिंग्स](device) - GRBL होमिंग और अक्ष सेटिंग्स
