barebaric/rayforge/website/i18n/hi/docusaurus-plugin-content-blog/2024-12-15-welcome-to-rayforge.md

---
slug: welcome-to-rayforge
title: "Rayforge में आपका स्वागत है: आधुनिक लेज़र नियंत्रण सॉफ़्टवेयर"
authors: rayforge_team
tags: [introduction, features]
description:
  "Rayforge का परिचय — GRBL-आधारित लेज़र कटरों और उत्कीर्णकों के लिए एक आधुनिक, ओपन-सोर्स G-code
  सेंडर और नियंत्रण सॉफ़्टवेयर. निर्माताओं के लिए मुफ़्त लेज़र कटिंग सॉफ़्टवेयर."
---

Rayforge मुख्य विंडो

हम GRBL-आधारित लेज़र कटरों और उत्कीर्णकों के लिए विशेष रूप से डिज़ाइन किए गए एक आधुनिक, ओपन-सोर्स
G-code सेंडर और नियंत्रण सॉफ़्टवेयर, Rayforge का परिचय देने के लिए उत्साहित हैं.

<!-- truncate -->

## Rayforge क्यों?

लेज़र कटिंग और उत्कीर्णन की दुनिया में, विश्वसनीय, सहज सॉफ़्टवेयर होना उतना ही महत्वपूर्ण है जितना
गुणवत्तापूर्ण हार्डवेयर होना. Rayforge निम्नलिखित पर ध्यान केंद्रित करते हुए शुरुआत से बनाया गया है:

- **आधुनिक उपयोगकर्ता अनुभव**: Gtk4 और Libadwaita से बना, Rayforge एक साफ़, नेटिव इंटरफ़ेस देता है
  जो Linux और Windows पर घर जैसा लगता है
- **पेशेवर सुविधाएँ**: मल्टी-लेयर वर्कफ़्लो, 3D पूर्वावलोकन, कैमरा एकीकरण, और उन्नत पाथ जनरेशन
- **लचीलापन**: कई मशीन प्रोफ़ाइल, कस्टम मैक्रो, और विस्तृत कॉन्फ़िगरेशन विकल्पों का समर्थन
- **खुला विकास**: समुदाय-संचालित, सभी योगदानों का स्वागत

## Rayforge को भिन्न क्या बनाता है?

### मल्टी-लेयर ऑपरेशन

Rayforge की उल्लेखनीय सुविधाओं में से एक उसका मल्टी-लेयर वर्कफ़्लो है. अपने डिज़ाइन में भिन्न लेयरों
को भिन्न ऑपरेशन निर्दिष्ट करें — एक लेयर पर महीन विवरण उत्कीर्ण करें, फिर दूसरी पर टुकड़ा काटकर अलग
करें. सब एक ही इंटरफ़ेस में बिना रुकावट प्रबंधित.

### 3D G-code पूर्वावलोकन

मशीन को अपना जॉब भेजने से पहले, हमारे 3D G-code पूर्वावलोकन से देखें कि ठीक क्या होगा. संभावित
समस्याएँ होने से पहले पकड़ें और समय तथा सामग्री बचाएँ.

### कैमरा एकीकरण

सटीक वर्कपीस संरेखण, स्थापना, और पृष्ठभूमि ट्रेसिंग के लिए एक USB कैमरे का उपयोग करें. पहले से मौजूद
सामग्री पर डिज़ाइन स्थित करने या जिग बनाने के लिए परफ़ेक्ट.

### उन्नत पाथ जनरेशन

Rayforge में उच्च-गुणवत्ता छवि ट्रेसिंग, ट्रैवल समय अनुकूलन, पाथ स्मूदिंग, और स्पॉट आकार इंटरपोलेशन
शामिल है ताकि आपकी परियोजनाएँ ठीक योजना अनुसार निकलें.

## शुरुआत करना

Rayforge आज़माने के लिए तैयार? शुरुआत करने के लिए हमारी
[इंस्टॉलेशन गाइड](/docs/getting-started/installation) देखें. चाहे आप Ubuntu चला रहे हों, Snap के
माध्यम से कोई अन्य Linux वितरण, या Windows, हमने आपको कवर किया है.

## समुदाय से जुड़ें

Rayforge ओपन-सोर्स और समुदाय-संचालित है. हम सभी प्रकार के योगदानों का स्वागत करते हैं:

- [GitHub Issues](https://github.com/barebaric/rayforge/issues) पर बग रिपोर्ट करें और सुविधाएँ
  माँगें
- [पुल अनुरोधों](https://github.com/barebaric/rayforge/pulls) द्वारा कोड योगदान दें
- दस्तावेज़ीकरण सुधारें
- अपनी परियोजनाएँ और अनुभव साझा करें

---

_प्रश्न या प्रतिक्रिया है? GitHub पर बातचीत में शामिल हों या हमारा
[दस्तावेज़ीकरण](/docs/getting-started/installation) देखें._
