barebaric/rayforge/website/i18n/hi/docusaurus-plugin-content-blog/2025-01-10-multi-laser-support.md

---
slug: multi-laser-support
title: "Rayforge में मल्टी-लेज़र समर्थन"
authors: rayforge_team
tags: [features, multi-laser]
description:
  "Rayforge अब एक ही मशीन पर कई लेज़र समर्थन करता है. कटिंग और उत्कीर्णन वर्कफ़्लो के लिए भिन्न
  लेज़र हेड कॉन्फ़िगर करें और उनके बीच स्विच करें."
---

Rayforge की सबसे शक्तिशाली सुविधाओं में से एक है एक ही जॉब के भीतर भिन्न ऑपरेशनों को भिन्न लेज़र
निर्दिष्ट करने की क्षमता. यह मल्टी-टूल सेटअप और विशिष्ट वर्कफ़्लो के लिए रोमांचक संभावनाएँ खोलता है.

<!-- truncate -->

## मल्टी-लेज़र समर्थन क्या है?

यदि आपकी मशीन में कई लेज़र मॉड्यूल हैं — कहें, उत्कीर्णन के लिए एक डायोड लेज़र और कटिंग के लिए एक
CO2 लेज़र, या भिन्न सामग्रियों के लिए अनुकूलित भिन्न शक्ति के डायोड लेज़र — तो Rayforge आपको इस
सेटअप का पूरा लाभ उठाने देता है.

मल्टी-लेज़र समर्थन के साथ, आप:

- अपने जॉब में **भिन्न ऑपरेशनों को भिन्न लेज़र निर्दिष्ट** कर सकते हैं
- जॉब निष्पादन के दौरान **लेज़र मॉड्यूलों के बीच स्वतः स्विच** कर सकते हैं
- प्रत्येक ऑपरेशन के लिए सही टूल उपयोग करके **सामग्री और कार्य के लिए अनुकूलित** कर सकते हैं

## उपयोग प्रसंग

### संकर उत्कीर्णन और कटिंग

सोचिए आप किसी लकड़ी के साइन परियोजना पर काम कर रहे हैं:

1. **ऑपरेशन 1**: महीन टेक्स्ट और विस्तृत ग्राफ़िक्स उत्कीर्णित करने के लिए कम-शक्ति डायोड लेज़र
   उपयोग करें
2. **ऑपरेशन 2**: साइन आकृति काटकर अलग करने के लिए अधिक-शक्ति CO2 लेज़र पर स्विच करें

Rayforge के साथ, आप बस प्रत्येक ऑपरेशन को अपनी मशीन प्रोफ़ाइल में उपयुक्त लेज़र को निर्दिष्ट करते
हैं, और सॉफ़्टवेयर बाकी संभाल लेता है.

### सामग्री-विशिष्ट अनुकूलन

भिन्न लेज़र प्रकार भिन्न सामग्रियों में उत्कृष्ट होते हैं:

- **डायोड लेज़र**: लकड़ी उत्कीर्णन, चमड़े, और कुछ प्लास्टिक के लिए बेहतरीन
- **CO2 लेज़र**: एक्रिलिक, लकड़ी, और अन्य जैविक सामग्रियों काटने के लिए उत्कृष्ट
- **फ़ाइबर लेज़र**: धातुओं पर चिह्नांकन के लिए परफ़ेक्ट

यदि आपके पास गैंट्री प्रणाली पर कई लेज़र प्रकार हैं, तो Rayforge का मल्टी-लेज़र समर्थन आपको अपनी
परियोजना के प्रत्येक भाग के लिए अनुकूल टूल उपयोग करने देता है.

## कैसे सेट करें

### 1. अपनी मशीन प्रोफ़ाइल में कई लेज़र कॉन्फ़िगर करें

**Machine Setup → Multiple Lasers** पर जाएँ और अपनी प्रणाली में प्रत्येक लेज़र मॉड्यूल परिभाषित
करें. आप निर्दिष्ट कर सकते हैं:

- लेज़र प्रकार और शक्ति सीमा
- ऑफ़सेट स्थितियाँ (यदि लेज़र भिन्न स्थानों पर लगे हों)
- सामग्री संगतता

विस्तृत निर्देशों के लिए हमारा [लेज़र कॉन्फ़िगरेशन गाइड](/docs/machine/laser) देखें.

### 2. ऑपरेशनों को लेज़र निर्दिष्ट करें

अपनी परियोजना में ऑपरेशन बनाते समय:

1. ऑपरेशन चुनें (Contour, Raster आदि)
2. ऑपरेशन सेटिंग्स में, ड्रॉपडाउन से चुनें कि कौन सा लेज़र उपयोग करना है
3. उस लेज़र के लिए विशिष्ट ऑपरेशन पैरामीटर कॉन्फ़िगर करें

### 3. पूर्वावलोकन और चलाएँ

अपने टूलपाथ सत्यापित करने के लिए 3D पूर्वावलोकन का उपयोग करें, फिर जॉब मशीन को भेजें. Rayforge
आवश्यकता अनुसार लेज़रों के बीच स्विच करने के लिए उपयुक्त G-code कमांड स्वतः जनरेट करेगा.

## तकनीकी विवरण

पर्दे के पीछे, Rayforge लेज़र मॉड्यूलों के बीच स्विच करने के लिए G-code कमांड उपयोग करता है. सटीक
कार्यान्वयन आपके फ़र्मवेयर और हार्डवेयर सेटअप पर निर्भर करता है, लेकिन सामान्य दृष्टिकोणों में शामिल
हैं:

- **टूल ऑफ़सेट के साथ M3/M4**: टूल बदलाव कमांडों का उपयोग करके लेज़रों के बीच स्विच करें
- **GPIO नियंत्रण**: भिन्न लेज़र मॉड्यूल सक्षम/अक्षम करने के लिए फ़र्मवेयर-समर्थित GPIO पिन उपयोग
  करें
- **कस्टम मैक्रो**: लेज़र स्विचिंग के लिए प्री- और पोस्ट-ऑपरेशन मैक्रो परिभाषित करें

## शुरुआत करना

मल्टी-लेज़र समर्थन Rayforge 0.15 और बाद में उपलब्ध है. शुरुआत करने के लिए:

1. नवीनतम संस्करण पर अपडेट करें
2. अपनी मशीन प्रोफ़ाइल को कई लेज़रों के साथ कॉन्फ़िगर करें
3. किसी परीक्षण परियोजना पर इसे आज़माएँ!

अधिक विवरण के लिए [मशीन प्रोफ़ाइल दस्तावेज़ीकरण](/docs/machine/general) देखें.

---

_क्या आपके पास मल्टी-लेज़र सेटअप है? हम आपके अनुभव के बारे में सुनना चाहेंगे! अपनी परियोजनाएँ और
प्रतिक्रिया [GitHub](https://github.com/barebaric/rayforge) पर साझा करें._
