barebaric/rayforge/website/i18n/hi/docusaurus-plugin-content-blog/2026-01-29-rayforge-1.0-first-birthday.md

---
slug: rayforge-1.0-first-birthday
title: Rayforge 1.0 - पहली जयंती उत्सव
authors: rayforge_team
tags: [release, 1.0, milestone]
description:
  "Rayforge 1.0 यहाँ है — मुफ़्त ओपन-सोर्स लेज़र कटिंग और उत्कीर्णन सॉफ़्टवेयर जो एक एकल कमिट से
  पूर्ण-सुविधा LightBurn विकल्प बना."
---

Rayforge 1.0

आज Rayforge के लिए एक विशेष पड़ाव है - हम परियोजना की पहली जयंती पर ठीक संस्करण 1.0 रिलीज़ कर रहे
हैं! जो 1 फ़रवरी 2025 को एक एकल कमिट से शुरू हुआ था, वह पूर्ण-सुविधा लेज़र कटिंग और उत्कीर्णन
प्लेटफ़ॉर्म बन गया है.

<!-- truncate -->

## अब तक का सफ़र

पिछले वर्ष में, Rayforge एक बुनियादी लेज़र नियंत्रण उपकरण से एक व्यापक डिज़ाइन और विनिर्माण
प्लेटफ़ॉर्म में विकसित हुआ है. हमने सब कुछ शुरुआत से बनाया है: एक पैरामीट्रिक 2D CAD प्रणाली, 3D
G-code पूर्वावलोकन, मल्टी-लेयर समर्थन, मल्टी-लेज़र समर्थन, कैमरा संरेखण, वर्क निर्देशांक प्रणालियाँ,
और बहुत कुछ.

यह रिलीज़ उस दृष्टि की पराकाष्ठा है - एक स्थिर, उत्पादन-तैयार उपकरण जो वास्तविक दुनिया के लेज़र
कटिंग और उत्कीर्णन वर्कफ़्लो संभाल सकता है.

## 1.0 में नया क्या है

### परियोजना सहेजें/लोड करें

सबसे माँगी गई सुविधा अंततः यहाँ है. अब आप अपने पूरे वर्कफ़्लो सहेज सकते हैं और बाद में उन्हें
पुनर्स्थापित कर सकते हैं. `.ryp` (परियोजना) और `.rfs` (स्केच) फ़ाइल एक्सटेंशन पूरे सिस्टम में
पंजीकृत हैं, इसलिए आप अपनी परियोजनाएँ सीधे खोलने के लिए डबल-क्लिक कर सकते हैं. हाल की फ़ाइलों का
मेनू आपके काम तक त्वरित पहुँच देता है.

### टेक्स्ट समर्थन वाला पैरामीट्रिक स्केचर

स्केचर अब पूर्ण कॉन्स्ट्रेंट एकीकरण के साथ टेक्स्ट समर्थन करता है. अपने स्केच में टेक्स्ट जोड़ें,
आस्पेक्ट अनुपात कॉन्स्ट्रेंट लागू करें, और स्थापना तथा आकार पैरामीट्रिक रूप से नियंत्रित करें. यह
लेज़र-उत्कीर्णित साइन, लेबल, और सजावटी तत्वों के लिए डिज़ाइन की संभावनाओं की एक पूरी नई दुनिया खोलता
है.

### एकीकृत निचला पैनल

जॉग संवाद और लॉग दृश्य एक एकल, एकीकृत निचले पैनल में मिला दिए गए हैं. यह समेकन आवश्यक मशीन नियंत्रण
और निगरानी उपकरण आसानी से सुलभ रखते हुए एक साफ़ कार्यक्षेत्र देता है. पैनल में जॉग नियंत्रण और लॉग
आउटपुट तक टैब्ड पहुँच है, जिससे स्क्रीन स्थान खोए बिना ऑपरेशनों के बीच स्विच करना आसान हो जाता है.

### अन्य सुधार

- **निचला पैनल**: जॉग संवाद और लॉग दृश्य अब एकीकृत निचले पैनल में मिला दिए गए हैं
- **आयात संवाद**: त्रुटियाँ अब एकत्रित होकर साथ दिखाई देती हैं
- **आयातक**: बेहतर परीक्षण योग्यता के लिए लगभग पूरी तरह पुनर्लिखित
- **स्केचर स्थिरता**: सॉल्वर अब अधिक स्थिर खींचने के लिए बिंदुओं को झुकाव देता है
- **बग सुधार**: मल्टी-लेयर DXF आयात, संरेखण बग, केंद्रित समस्याएँ, और अधिक

## सुविधा मुख्य बिंदु

Rayforge 1.0 में 60 से अधिक सुविधाएँ शामिल हैं:

**डिज़ाइन उपकरण**

- पैरामीट्रिक स्केचिंग वाला 2D CAD
- ज्यामितीय और विमीय कॉन्स्ट्रेंट
- स्केच में टेक्स्ट समर्थन
- मल्टी-लेयर समर्थन

**विनिर्माण**

- 2.5D ऑपरेशन (कॉन्टूर, रास्टर, गहराई उत्कीर्णन)
- मल्टी-लेज़र समर्थन
- वर्क निर्देशांक प्रणालियाँ (G54-G59)
- पाथ अनुकूलन और स्मूदिंग
- स्वतः-स्थापना वाले होल्डिंग टैब

**आयात/निर्यात**

- SVG, DXF, PDF, JPEG, PNG, BMP, Ruida फ़ाइल समर्थन
- कई एल्गोरिदमों वाला वेक्टर ट्रेसिंग
- छवि पूर्व-प्रोसेसिंग (शोर हटाना, उलटें, थ्रेशोल्ड)

**मशीन नियंत्रण**

- मल्टी-मशीन प्रोफ़ाइल
- GRBL, Smoothieware, Marlin के लिए फ़र्मवेयर सेटिंग्स
- G-code मैक्रो और हुक
- वेरिएबल प्रतिस्थापन
- लाइव स्थिति वाला टर्मिनल कंसोल

**विज़ुअलाइज़ेशन**

- पूर्ण सिमुलेशन वाला 3D G-code पूर्वावलोकन
- कैमरा संरेखण
- डार्क और लाइट थीम
- बहुभाषी समर्थन

## एक नज़र पीछे

पहला कमिट 1 फ़रवरी 2025 को 19:37:27 बजे किया गया था. यह बुनियादी SVG रेंडरिंग समर्थन वाला एक सरल
"initial import" था. तब से, हमने:

- 28 संस्करण रिलीज़ किए (0.13 से 0.28, साथ में 1.0)
- 60 से अधिक सुविधाएँ जोड़ीं
- सैकड़ों बग ठीक किए
- उपयोगकर्ताओं और योगदानकर्ताओं का समुदाय बनाया
- Windows, Linux (deb, snap, flatpak), और macOS के लिए इंस्टॉलर बनाए

## आगे क्या?

संस्करण 1.0 एक पड़ाव है, गंतव्य नहीं. आगे के रोडमैप में शामिल है:

- संवर्धित वेक्टर उपकरण और संपादन क्षमताएँ
- व्यापक हार्डवेयर समर्थन
- बड़ी परियोजनाओं के लिए प्रदर्शन अनुकूलन
- अधिक मशीन प्रोफ़ाइल और डायलेक्ट
- समुदाय-संचालित पैकेज पारिस्थितिकी

## Rayforge 1.0 डाउनलोड करें

नवीनतम संस्करण हमारी वेबसाइट से लें: https://rayforge.org/

इंस्टॉलर उपलब्ध हैं:

- Windows (इंस्टॉलर)
- Linux (deb, snap, flatpak)
- macOS (dmg)

## समुदाय से जुड़ें

- **GitHub**: https://github.com/barebaric/rayforge
- **Discord**: https://discord.gg/sTHNdTtpQJ
- **Patreon**: https://www.patreon.com/c/knipknap

इस पिछले वर्ष में योगदान देने, परीक्षण करने, बग रिपोर्ट करने, या केवल Rayforge का उपयोग करने वाले हर
व्यक्ति को धन्यवाद. ओपन-सोर्स विनिर्माण का भविष्य बनाने के एक और वर्ष के लिए शुभकामनाएँ!

---

_जन्मदिन मुबारक, Rayforge! 🎂_
