barebaric/rayforge/website/i18n/de/docusaurus-plugin-content-docs/current/machine/remote.md

---
description:
  "Betreiben Sie Ihre Maschine über einen kleinen Computer direkt neben der Hardware, während
  Rayforge woanders läuft. Jobs überstehen Verbindungsabbrüche, und beim Wiederverbinden wird der
  Fortschritt exakt synchronisiert."
---

# Remote-Geräte

Betreiben Sie Ihre Maschine über einen kleinen Computer direkt neben der Hardware (zum Beispiel
einen Raspberry Pi in der Werkstatt), während Rayforge auf Ihrem Laptop oder Desktop läuft. Jobs
laufen auf dem Geräte-Host und laufen weiter, selbst wenn Rayforge die Verbindung trennt; beim
Wiederverbinden wird der Fortschritt exakt synchronisiert.
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
