barebaric/rayforge/website/content/docs/images/machine-camera.png

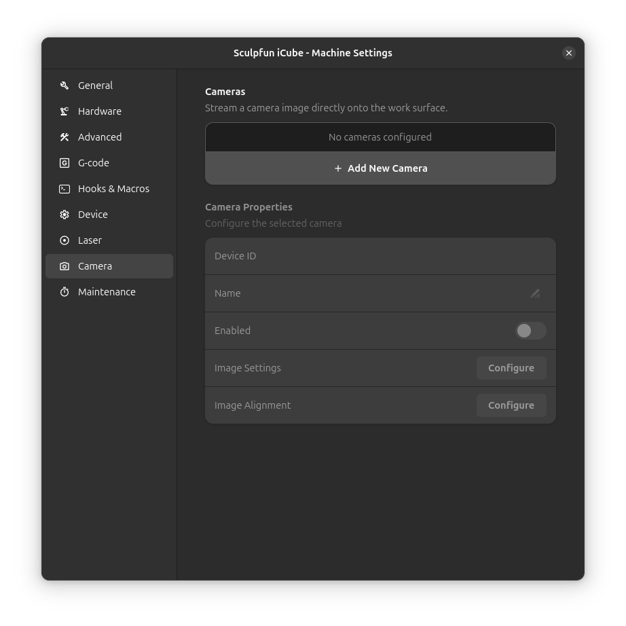
website/content/docs/images/machine-camera.png
