barebaric/rayforge/website/content/docs/images/machine-gcode.png

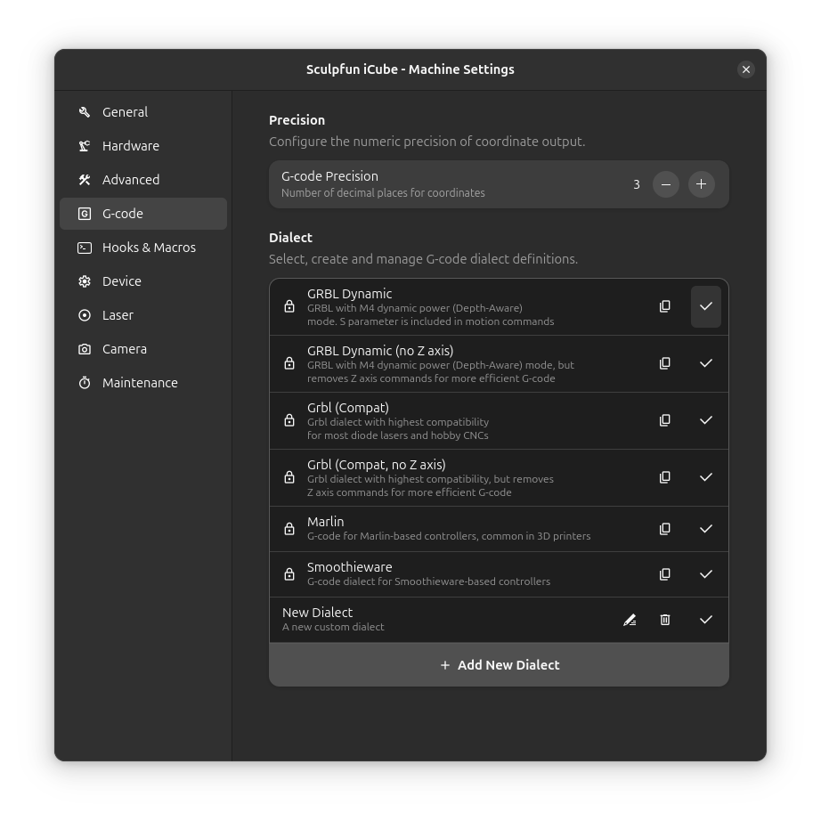
website/content/docs/images/machine-gcode.png
