barebaric/rayforge/website/i18n/hi/docusaurus-plugin-content-docs/current/features/operations/material-test-grid.md

---
description:
  "किसी भी सामग्री के लिए अनुकूल लेज़र शक्ति और गति सेटिंग्स खोजने के लिए एक सामग्री परीक्षण ग्रिड
  जनरेट करें. अपने लेज़र कटर को व्यवस्थित रूप से कैलिब्रेट करें."
---

# सामग्री परीक्षण ग्रिड

सामग्री परीक्षण ग्रिड जनरेटर विभिन्न सामग्रियों के लिए अनुकूल लेज़र सेटिंग्स खोजने में मदद के लिए
पैरामीट्रिक परीक्षण पैटर्न बनाता है.

## अवलोकन

सामग्री परीक्षण लेज़र कार्य के लिए आवश्यक है - भिन्न सामग्रियों को भिन्न शक्ति और गति सेटिंग्स
चाहिए. सामग्री परीक्षण ग्रिड यह प्रक्रिया स्वचालित करता है:

- कॉन्फ़िगर योग्य गति/शक्ति सीमाओं वाले परीक्षण ग्रिड जनरेट करके
- सामान्य लेज़र प्रकारों (डायोड, CO2) के लिए प्रीसेट देकर
- सुरक्षा के लिए निष्पादन क्रम अनुकूलित करके (सबसे तेज़ गतियाँ पहले)
- प्रत्येक परीक्षण सेल की सेटिंग्स पहचानने के लिए लेबल जोड़कर

## सामग्री परीक्षण ग्रिड बनाना

### चरण 1: जनरेटर खोलें

सामग्री परीक्षण ग्रिड जनरेटर तक पहुँचें:

- मेनू: **Tools → Material Test Grid**
- यह एक विशेष वर्कपीस बनाता है जो परीक्षण पैटर्न जनरेट करता है

### चरण 2: एक प्रीसेट चुनें (वैकल्पिक)

Rayforge सामान्य प्रसंगों के लिए प्रीसेट शामिल करता है:

| प्रीसेट | गति सीमा | शक्ति सीमा | उपयोग के लिए |
| --- | --- | --- | --- |
| **डायोड उत्कीर्णन** | 1000-10000 mm/min | 10-100% | डायोड लेज़र उत्कीर्णन |
| **डायोड कट** | 100-5000 mm/min | 50-100% | डायोड लेज़र कटिंग |
| **CO2 उत्कीर्णन** | 3000-20000 mm/min | 10-50% | CO2 लेज़र उत्कीर्णन |
| **CO2 कट** | 1000-20000 mm/min | 30-100% | CO2 लेज़र कटिंग |

प्रीसेट शुरुआती बिंदु हैं - चुनने के बाद आप सभी पैरामीटर समायोजित कर सकते हैं.

### चरण 3: पैरामीटर कॉन्फ़िगर करें

सेटिंग्स संवाद में परीक्षण ग्रिड पैरामीटर समायोजित करें. विकल्प बदलने पर ग्रिड कैनवस पर स्वतः अपडेट
होता रहता है:

सामग्री परीक्षण ग्रिड सेटिंग्स

#### परीक्षण प्रकार

- **उत्कीर्णन**: वर्गों को रास्टर पैटर्न से भरता है
- **कट**: वर्गों की आउटलाइन काटता है

#### गति सीमा

- **न्यूनतम गति**: परीक्षण की जाने वाली सबसे धीमी गति (mm/min)
- **अधिकतम गति**: परीक्षण की जाने वाली सबसे तेज़ गति (mm/min)
- ग्रिड के कॉलम भिन्न गतियों को दर्शाते हैं

#### शक्ति सीमा

- **न्यूनतम शक्ति**: परीक्षण की जाने वाली सबसे कम शक्ति (%)
- **अधिकतम शक्ति**: परीक्षण की जाने वाली सबसे अधिक शक्ति (%)
- ग्रिड की पंक्तियाँ भिन्न शक्ति स्तरों को दर्शाती हैं

#### ग्रिड विमाएँ

- **कॉलम**: गति भिन्नताओं की संख्या (प्रायः 3-7)
- **पंक्तियाँ**: शक्ति भिन्नताओं की संख्या (प्रायः 3-7)

#### आकार और स्पेसिंग

- **आकृति आकार**: प्रत्येक परीक्षण वर्ग का आकार mm में (डिफ़ॉल्ट: 20mm)
- **स्पेसिंग**: वर्गों के बीच अंतर mm में (डिफ़ॉल्ट: 5mm)

#### लेबल

- **लेबल शामिल करें**: गति और शक्ति मान दिखाने वाले अक्ष लेबल सक्षम/अक्षम करें
- लेबल बाएँ और ऊपरी किनारों पर दिखाई देते हैं
- **लेबल शक्ति (%)**: लेबल उत्कीर्णित करने की शक्ति सेटिंग
- **लेबल गति (mm/min)**: लेबल उत्कीर्णित करने की गति (डिफ़ॉल्ट: 1000 mm/min)

लेबल परीक्षण ग्रिड से पहले उत्कीर्ण किए जाते हैं, ताकि वे परीक्षण पैटर्न से ढके न जाएँ.

#### रेखा अंतराल (केवल उत्कीर्णन परीक्षण)

- **रेखा अंतराल (mm)**: उत्कीर्णन परीक्षण प्रकार उपयोग करते समय स्कैन रेखाओं के बीच स्पेसिंग
- छोटे मान घने भराव बनाते हैं लेकिन निष्पादन में अधिक समय लेते हैं
- सामान्य मान: 0.1-0.3mm

## ग्रिड लेआउट समझना

### ग्रिड संगठन

```
Power (%)     Speed (mm/min) →
    ↓      1000   2500   5000   7500   10000
  100%     [  ]   [  ]   [  ]   [  ]   [  ]
   75%     [  ]   [  ]   [  ]   [  ]   [  ]
   50%     [  ]   [  ]   [  ]   [  ]   [  ]
   25%     [  ]   [  ]   [  ]   [  ]   [  ]
   10%     [  ]   [  ]   [  ]   [  ]   [  ]
```

- **कॉलम**: गति बाएँ से दाएँ बढ़ती है
- **पंक्तियाँ**: शक्ति नीचे से ऊपर बढ़ती है
- **लेबल**: प्रत्येक पंक्ति/कॉलम के सटीक मान दिखाते हैं

### ग्रिड आकार गणना

**लेबल के बिना:**

- चौड़ाई = कॉलम × (आकृति_आकार + स्पेसिंग) - स्पेसिंग
- ऊँचाई = पंक्तियाँ × (आकृति_आकार + स्पेसिंग) - स्पेसिंग

**लेबल के साथ:**

- लेबल स्थान के लिए बाएँ और ऊपर 15mm मार्जिन जोड़ें

**उदाहरण:** 20mm वर्ग और 5mm स्पेसिंग वाला 5×5 ग्रिड:

- लेबल के बिना: 120mm × 120mm
- लेबल के साथ: 135mm × 135mm

## निष्पादन क्रम (जोखिम अनुकूलन) {#execution-order-risk-optimization}

Rayforge सामग्री क्षति रोकने के लिए परीक्षण सेल **जोखिम-अनुकूलित क्रम** में निष्पादित करता है:

1. **सबसे तेज़ गति पहले**: तेज़ गतियाँ सुरक्षित हैं (कम ताप संचय)
2. **गति के भीतर न्यूनतम शक्ति**: प्रत्येक गति स्तर पर जोखिम न्यूनतम करता है

यह धीमी, अधिक-शक्ति संयोजनों से शुरू होने वाली झुलसन या आग को रोकता है.

**3×3 ग्रिड के लिए उदाहरण निष्पादन क्रम:**

```
Order:  1  2  3
        4  5  6  ← Highest speed, power increasing
        7  8  9

(Fastest speed/lowest power executed first)
```

## सामग्री परीक्षण परिणाम उपयोग करना

### चरण 1: परीक्षण चलाएँ

1. अपनी सामग्री लेज़र में लोड करें
2. लेज़र ठीक से फ़ोकस करें
3. सामग्री परीक्षण ग्रिड जॉब चलाएँ
4. परीक्षण निगरानी करें - कोई सेल समस्या करे तो रोकें

### चरण 2: परिणाम मूल्यांकन करें

परीक्षण पूरा होने के बाद, प्रत्येक सेल जाँचें:

- **बहुत हल्का**: शक्ति बढ़ाएँ या गति घटाएँ
- **बहुत गहरा/झुलसा**: शक्ति घटाएँ या गति बढ़ाएँ
- **परफ़ेक्ट**: गति/शक्ति संयोजन नोट करें

### चरण 3: सेटिंग्स रिकॉर्ड करें

भविष्य के संदर्भ के लिए अपनी सफल सेटिंग्स दस्तावेज़ित करें:

- सामग्री प्रकार और मोटाई
- ऑपरेशन प्रकार (उत्कीर्णन या कट)
- गति और शक्ति संयोजन
- पास की संख्या
- कोई विशेष नोट

<!-- prettier-ignore-start -->
:::tip[सामग्री डेटाबेस]
भविष्य की परियोजनाओं में त्वरित खोज के लिए अपने सामग्री परीक्षण परिणामों का एक
संदर्भ दस्तावेज़ बनाने पर विचार करें.
:::
<!-- prettier-ignore-end -->

## उन्नत उपयोग

### अन्य ऑपरेशनों के साथ संयोजन

सामग्री परीक्षण ग्रिड सामान्य वर्कपीस हैं - आप उन्हें अन्य ऑपरेशनों के साथ जोड़ सकते हैं:

**उदाहरण वर्कफ़्लो:**

1. सामग्री परीक्षण ग्रिड बनाएँ
2. पूरे ग्रिड के चारों ओर कॉन्टूर कट जोड़ें
3. परीक्षण चलाएँ, स्वतंत्र काटें, परिणाम मूल्यांकन करें

यह परीक्षण टुकड़े को स्टॉक सामग्री से काटकर अलग करने के लिए उपयोगी है.

### कस्टम परीक्षण सीमाएँ

सूक्ष्म-ट्यूनिंग के लिए, संकीर्ण-सीमा परीक्षण बनाएँ:

**मोटा परीक्षण** (अनुमानित क्षेत्र खोजें):

- गति: 1000-10000 mm/min (5 कॉलम)
- शक्ति: 10-100% (5 पंक्तियाँ)

**सूक्ष्म परीक्षण** (अनुकूलित करें):

- गति: 4000-6000 mm/min (5 कॉलम)
- शक्ति: 35-45% (5 पंक्तियाँ)

### भिन्न सामग्रियाँ, वही ग्रिड

अपनी सामग्री लाइब्रेरी तेज़ी से बनाने के लिए भिन्न सामग्रियों पर वही ग्रिड कॉन्फ़िगरेशन चलाएँ.

## सुझाव और सर्वोत्तम प्रथाएँ

### ग्रिड डिज़ाइन

✅ **प्रीसेट से शुरू करें** - सामान्य प्रसंगों के लिए अच्छे शुरुआती बिंदु ✅ **5×5 ग्रिड उपयोग
करें** - विवरण और परीक्षण समय का अच्छा संतुलन ✅ **लेबल सक्षम करें** - परिणाम पहचानने के लिए आवश्यक
✅ **वर्ग ≥20mm रखें** - परिणाम देखने और मापने में आसान

### परीक्षण रणनीति

✅ **पहले स्क्रैप पर परीक्षण करें** - कभी अंतिम सामग्री पर परीक्षण न करें ✅ **एक बार में एक चर**

- गति या शक्ति सीमा परीक्षण करें, दोनों चरम नहीं ✅ **ठंडा होने दें** - उसी सामग्री पर परीक्षणों के
  बीच प्रतीक्षा करें ✅ **संगत फ़ोकस** - सभी परीक्षणों के लिए वही फ़ोकस दूरी

### सुरक्षा

⚠️ **परीक्षणों की निगरानी करें** - चल रहे परीक्षण कभी अकेला न छोड़ें ⚠️ **रूढ़िवादी शुरू करें** - कम
शक्ति सीमाओं से शुरू करें ⚠️ **वेंटिलेशन जाँचें** - उचित धुएँ का निकास सुनिश्चित करें ⚠️ **आग
निगरानी** - अग्निशामक तैयार रखें

## समस्या निवारण

### परीक्षण सेल गलत क्रम में निष्पादित होते हैं

- Rayforge जोखिम-अनुकूलित क्रम उपयोग करता है (सबसे तेज़ गतियाँ पहले)
- यह जानबूझकर है और बदला नहीं जा सकता
- ऊपर [निष्पादन क्रम](#execution-order-risk-optimization) देखें

### परिणाम असंगत हैं

- **जाँचें**: सामग्री समतल और ठीक से बंधी है
- **जाँचें**: पूरे परीक्षण क्षेत्र में फ़ोकस संगत है
- **जाँचें**: लेज़र शक्ति स्थिर है (पावर सप्लाई जाँचें)
- **आज़माएँ**: परीक्षण क्षेत्र घटाने के लिए छोटा ग्रिड

## संबंधित विषय

- **[3D पूर्वावलोकन](../../ui/3d-preview.md)** - चलाने से पहले परीक्षण निष्पादन का पूर्वावलोकन करें
- **[उत्कीर्णन](engrave)** - उत्कीर्णन ऑपरेशन समझना
- **[कॉन्टूर कटिंग](contour)** - कट ऑपरेशन समझना
