barebaric/rayforge/rayforge/builtin_addons/rayforge-addon-materials/materials/aluminum.webp

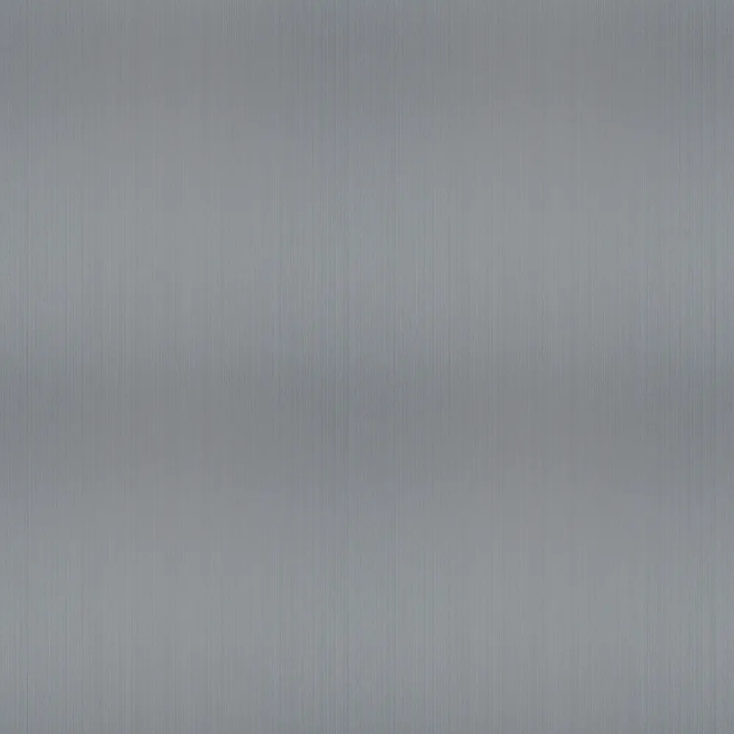
rayforge/builtin_addons/rayforge-addon-materials/materials/aluminum.webp
