barebaric/rayforge/rayforge/builtin_addons/rayforge-addon-materials/materials/ash.webp

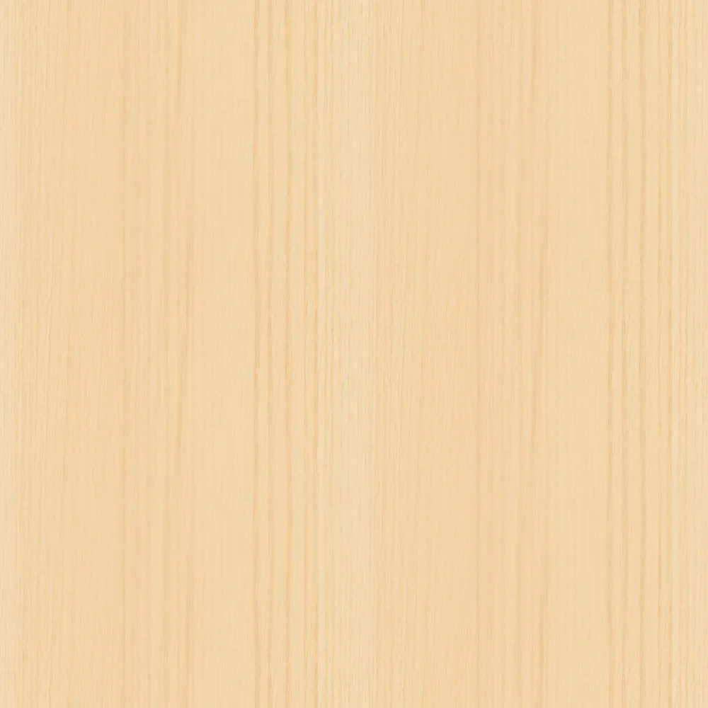
rayforge/builtin_addons/rayforge-addon-materials/materials/ash.webp
