barebaric/rayforge/rayforge/builtin_addons/rayforge-addon-materials/materials/bamboo.webp

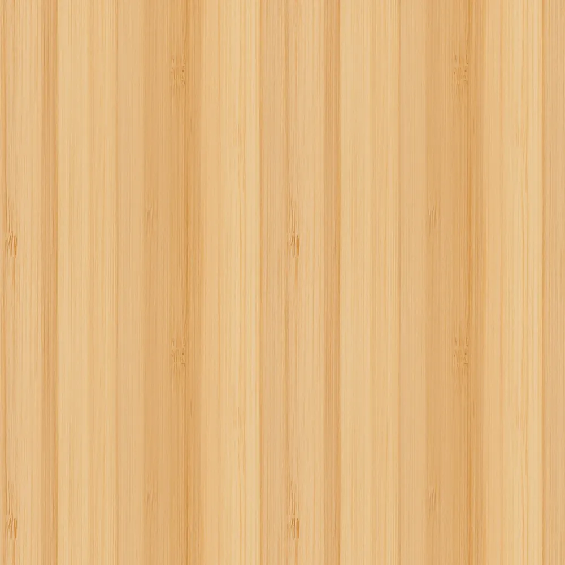
rayforge/builtin_addons/rayforge-addon-materials/materials/bamboo.webp
