barebaric/rayforge/rayforge/builtin_addons/rayforge-addon-materials/materials/birch.webp

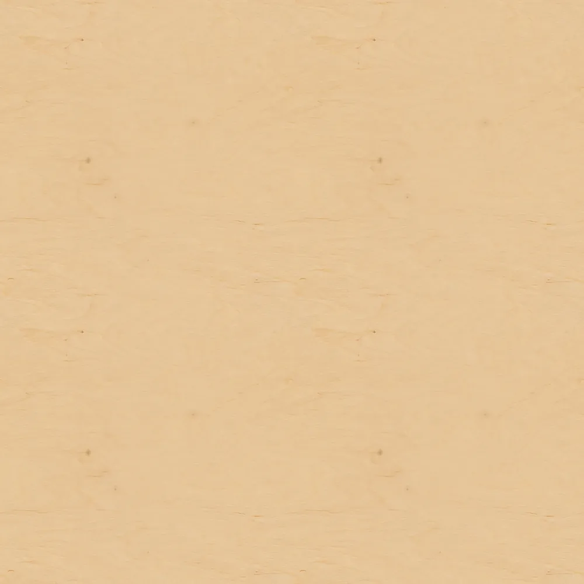
rayforge/builtin_addons/rayforge-addon-materials/materials/birch.webp
