barebaric/rayforge/rayforge/builtin_addons/rayforge-addon-materials/materials/brass.webp

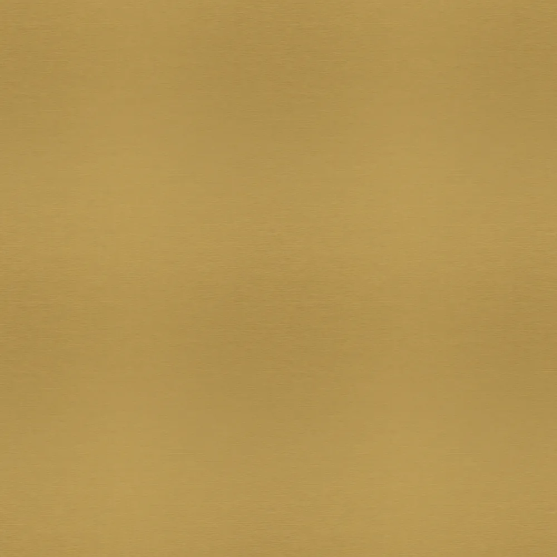
rayforge/builtin_addons/rayforge-addon-materials/materials/brass.webp
