barebaric/rayforge/rayforge/builtin_addons/rayforge-addon-materials/materials/cedar.webp

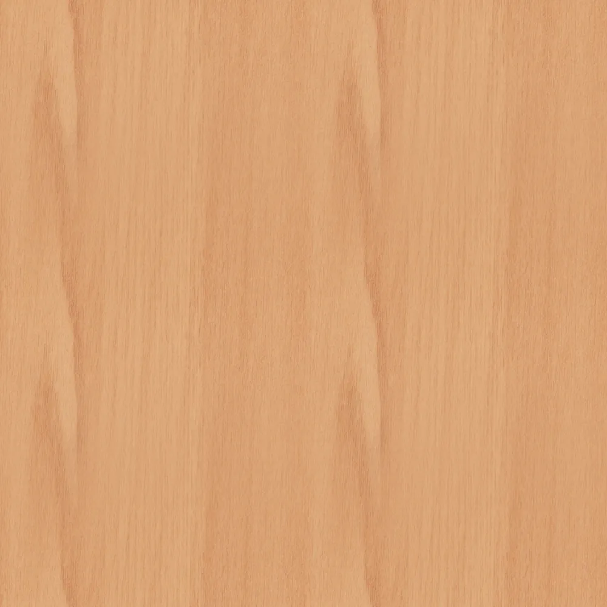
rayforge/builtin_addons/rayforge-addon-materials/materials/cedar.webp
