barebaric/rayforge/rayforge/builtin_addons/rayforge-addon-materials/materials/cherry.webp

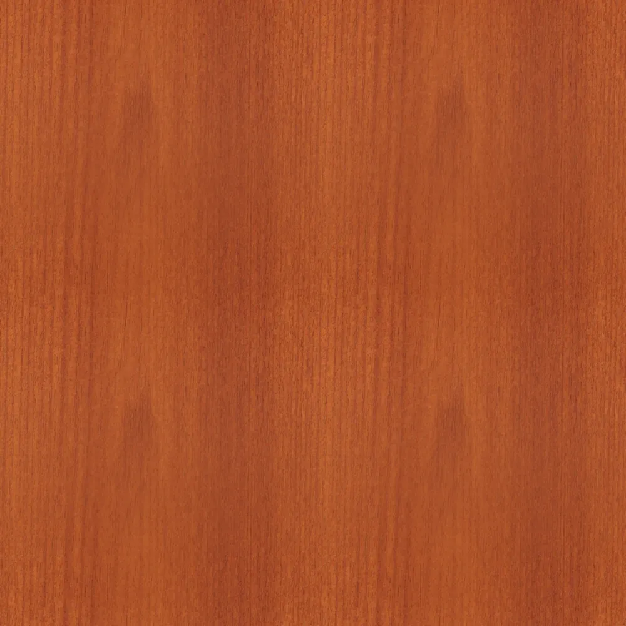
rayforge/builtin_addons/rayforge-addon-materials/materials/cherry.webp
