barebaric/rayforge/rayforge/builtin_addons/rayforge-addon-materials/materials/copper.webp

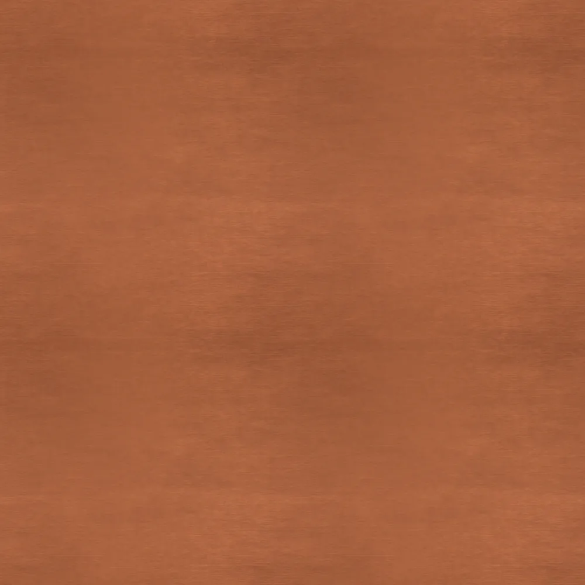
rayforge/builtin_addons/rayforge-addon-materials/materials/copper.webp
