barebaric/rayforge/rayforge/builtin_addons/rayforge-addon-materials/materials/cork.webp

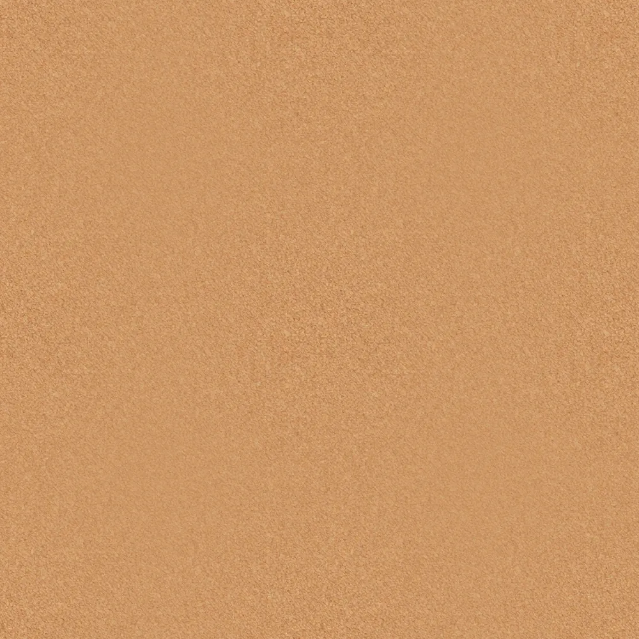
rayforge/builtin_addons/rayforge-addon-materials/materials/cork.webp
