barebaric/rayforge/rayforge/builtin_addons/rayforge-addon-materials/materials/elm.webp

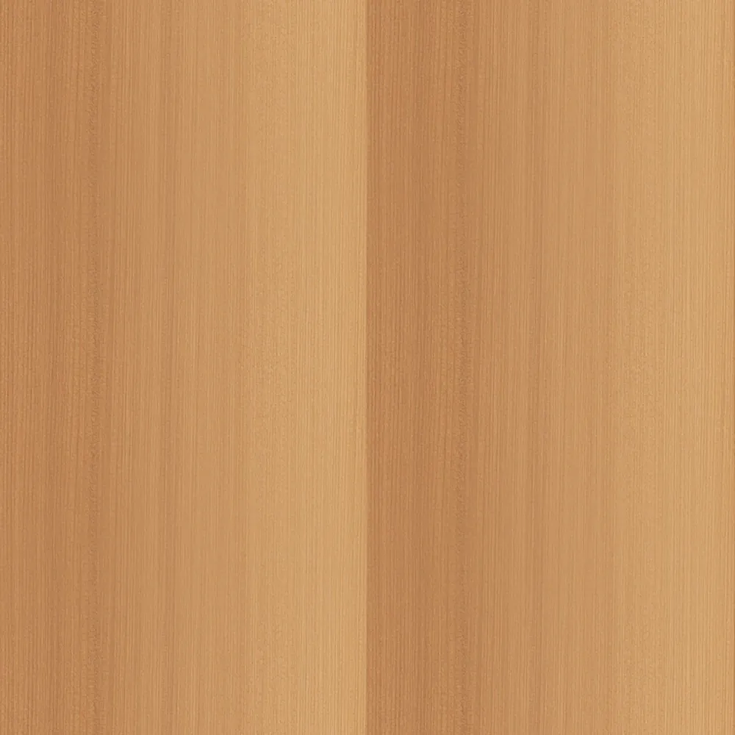
rayforge/builtin_addons/rayforge-addon-materials/materials/elm.webp
