barebaric/rayforge/rayforge/builtin_addons/rayforge-addon-materials/materials/fabric_canvas.webp

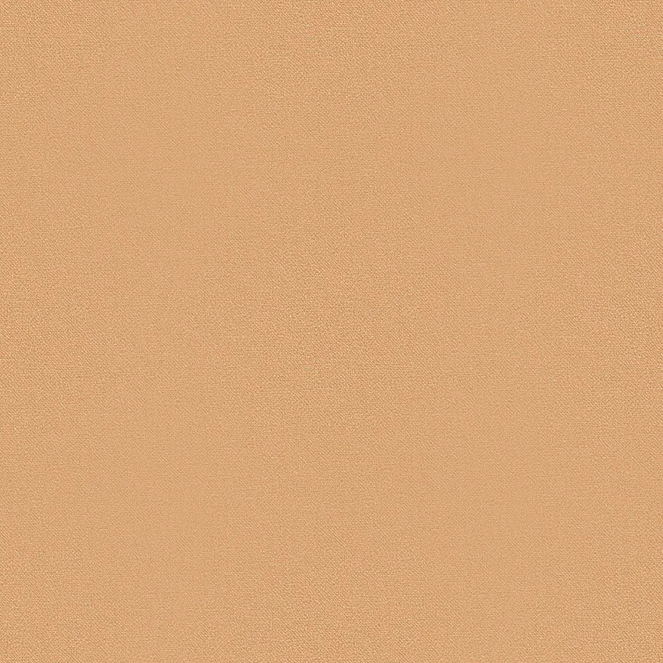
rayforge/builtin_addons/rayforge-addon-materials/materials/fabric_canvas.webp
