barebaric/rayforge/rayforge/builtin_addons/rayforge-addon-materials/materials/fabric_denim.webp

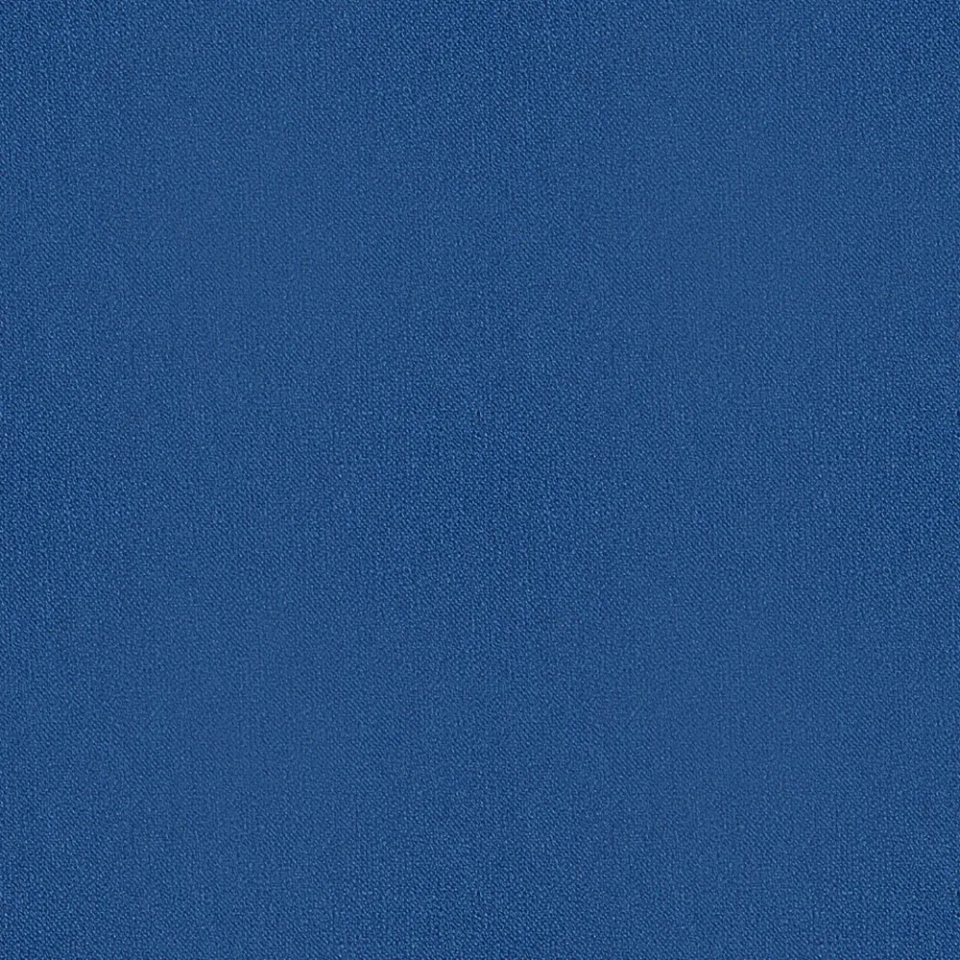
rayforge/builtin_addons/rayforge-addon-materials/materials/fabric_denim.webp
