barebaric/rayforge/rayforge/builtin_addons/rayforge-addon-materials/materials/fabric_felt.webp

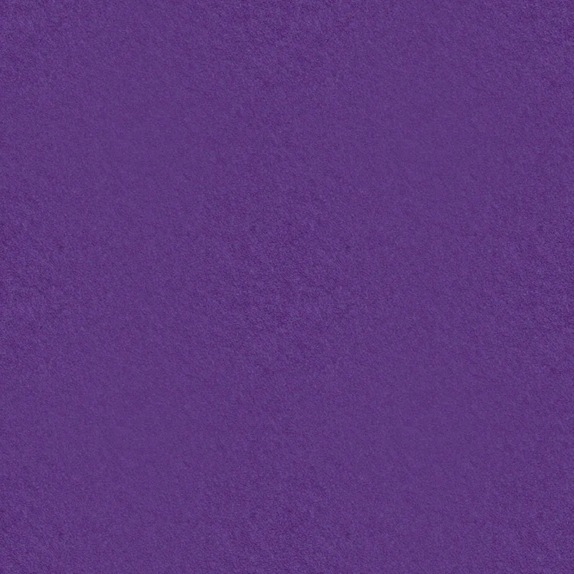
rayforge/builtin_addons/rayforge-addon-materials/materials/fabric_felt.webp
