barebaric/rayforge/rayforge/builtin_addons/rayforge-addon-materials/materials/galvanized_steel.webp

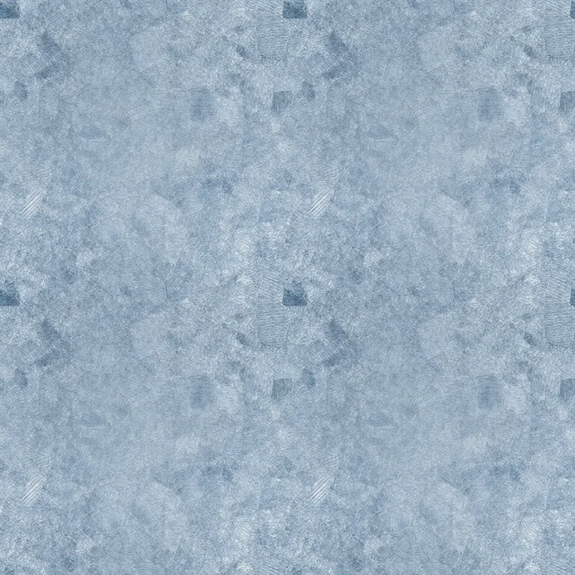
rayforge/builtin_addons/rayforge-addon-materials/materials/galvanized_steel.webp
