barebaric/rayforge/rayforge/builtin_addons/rayforge-addon-materials/materials/granite.webp

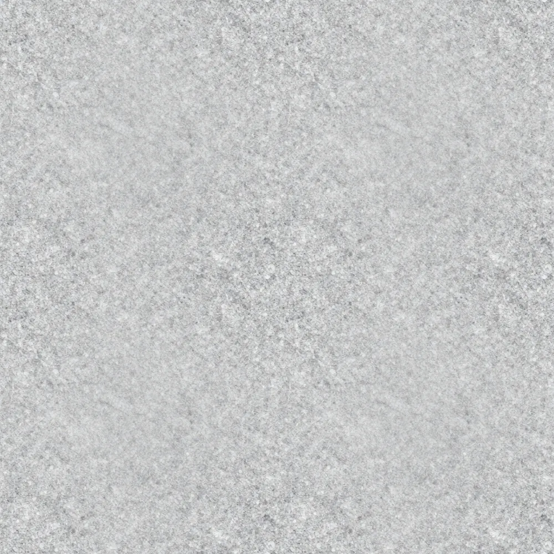
rayforge/builtin_addons/rayforge-addon-materials/materials/granite.webp
