barebaric/rayforge/rayforge/builtin_addons/rayforge-addon-materials/materials/hickory.webp

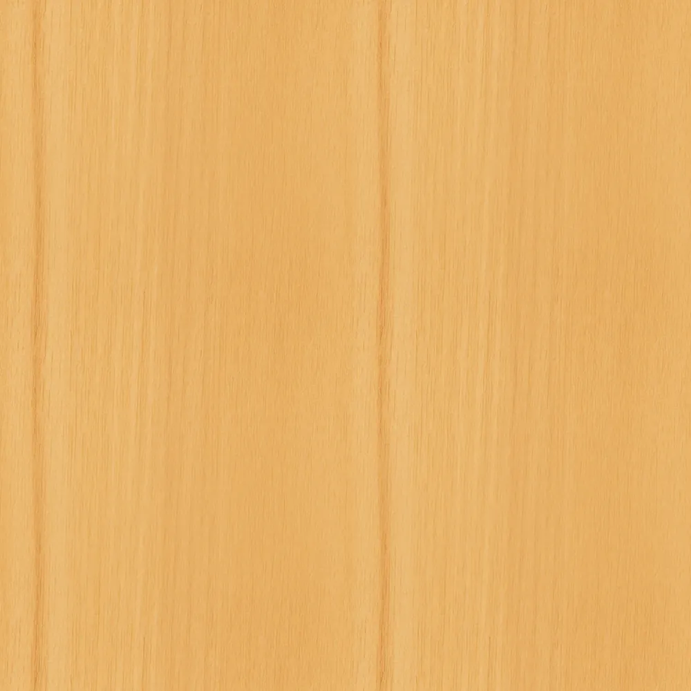
rayforge/builtin_addons/rayforge-addon-materials/materials/hickory.webp
