barebaric/rayforge/rayforge/builtin_addons/rayforge-addon-materials/materials/lead.webp

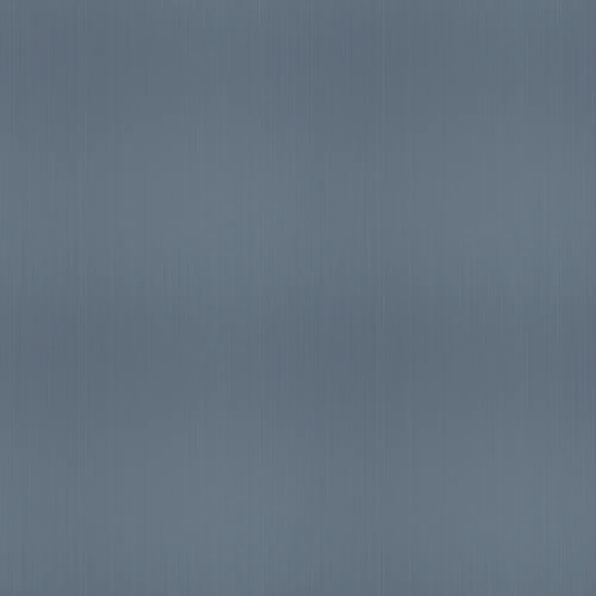
rayforge/builtin_addons/rayforge-addon-materials/materials/lead.webp
