barebaric/rayforge/rayforge/builtin_addons/rayforge-addon-materials/materials/leather.webp

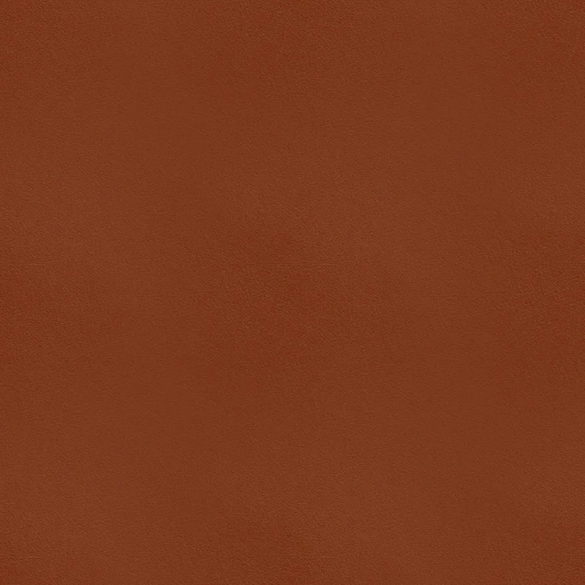
rayforge/builtin_addons/rayforge-addon-materials/materials/leather.webp
