barebaric/rayforge/rayforge/builtin_addons/rayforge-addon-materials/materials/mahogany.webp

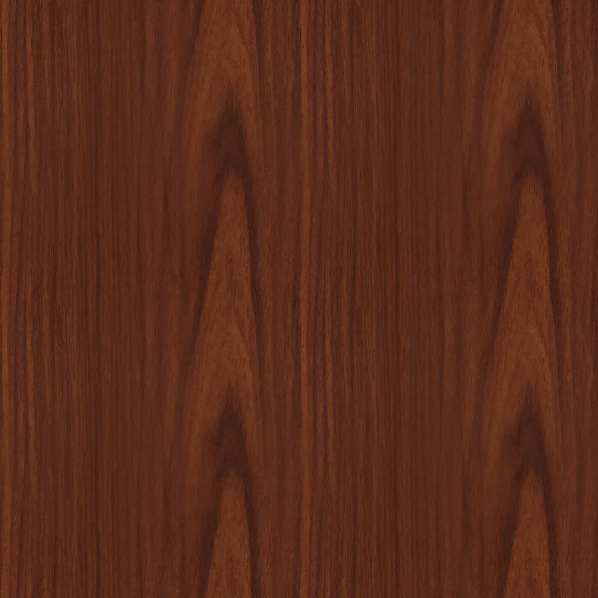
rayforge/builtin_addons/rayforge-addon-materials/materials/mahogany.webp
