barebaric/rayforge/rayforge/builtin_addons/rayforge-addon-materials/materials/maple.webp

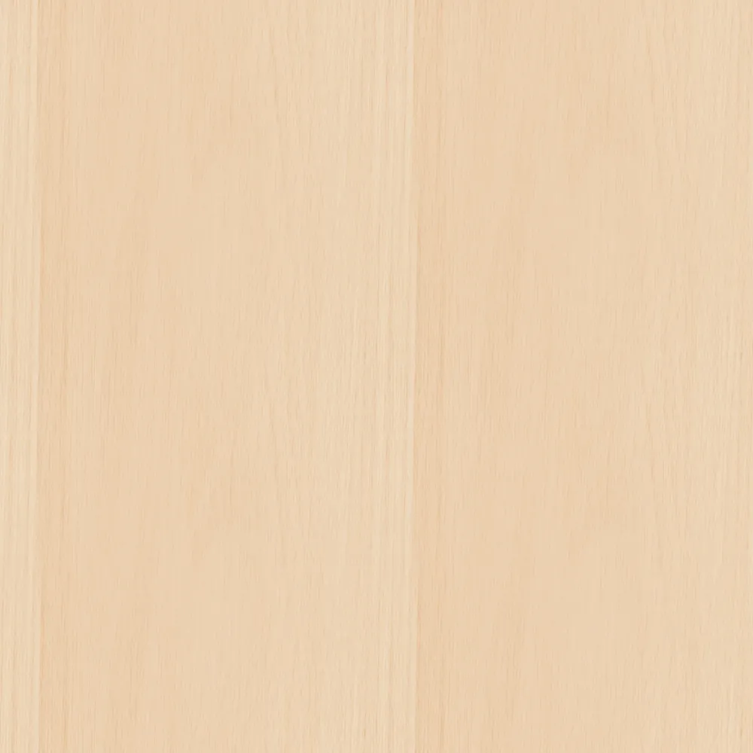
rayforge/builtin_addons/rayforge-addon-materials/materials/maple.webp
