barebaric/rayforge/rayforge/builtin_addons/rayforge-addon-materials/materials/marble.webp

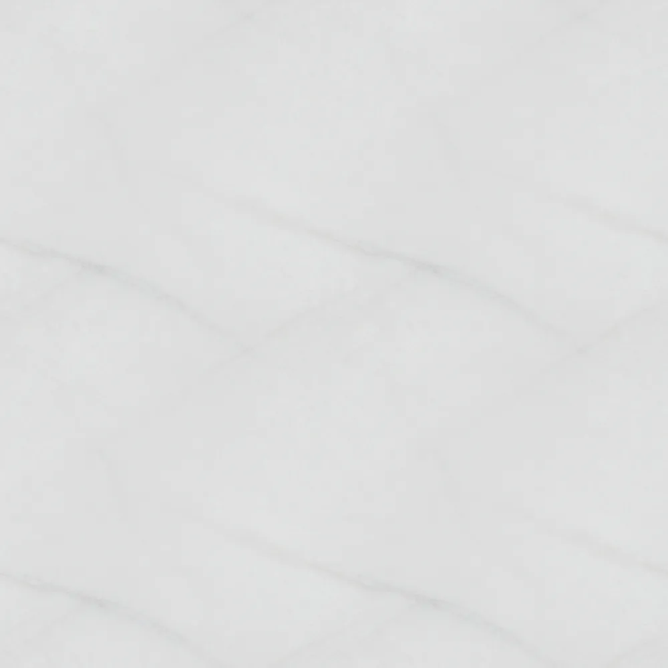
rayforge/builtin_addons/rayforge-addon-materials/materials/marble.webp
