barebaric/rayforge/rayforge/builtin_addons/rayforge-addon-materials/materials/nickel.webp

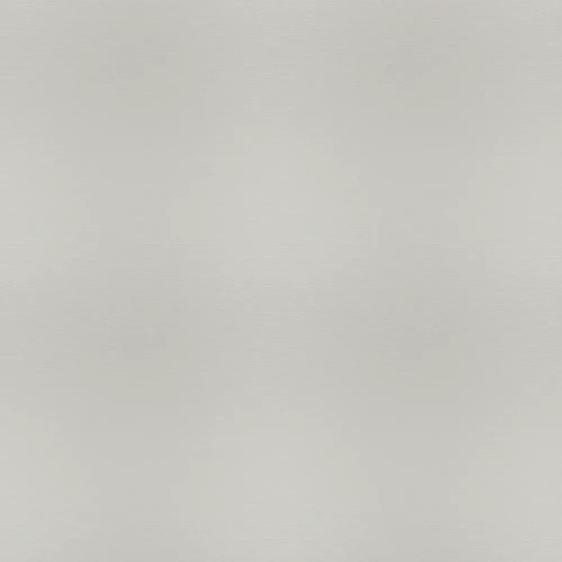
rayforge/builtin_addons/rayforge-addon-materials/materials/nickel.webp
