barebaric/rayforge/rayforge/builtin_addons/rayforge-addon-materials/materials/oak.webp

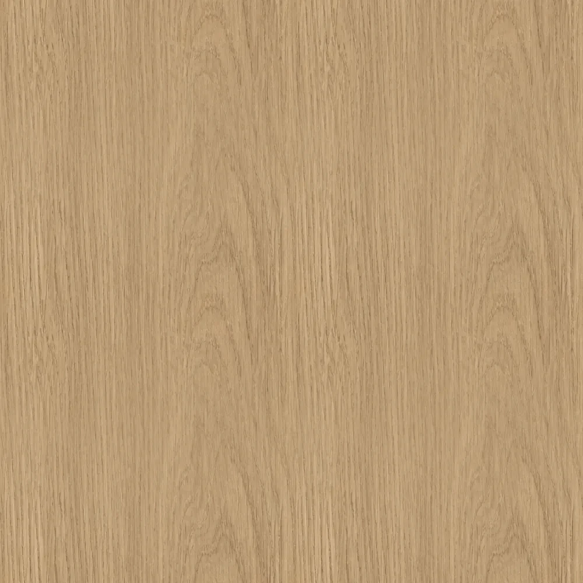
rayforge/builtin_addons/rayforge-addon-materials/materials/oak.webp
