barebaric/rayforge/rayforge/builtin_addons/rayforge-addon-materials/materials/pine.webp

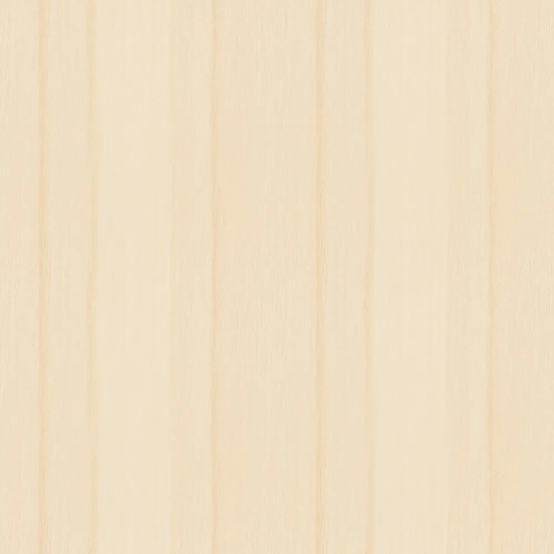
rayforge/builtin_addons/rayforge-addon-materials/materials/pine.webp
