barebaric/rayforge/rayforge/builtin_addons/rayforge-addon-materials/materials/plywood.webp

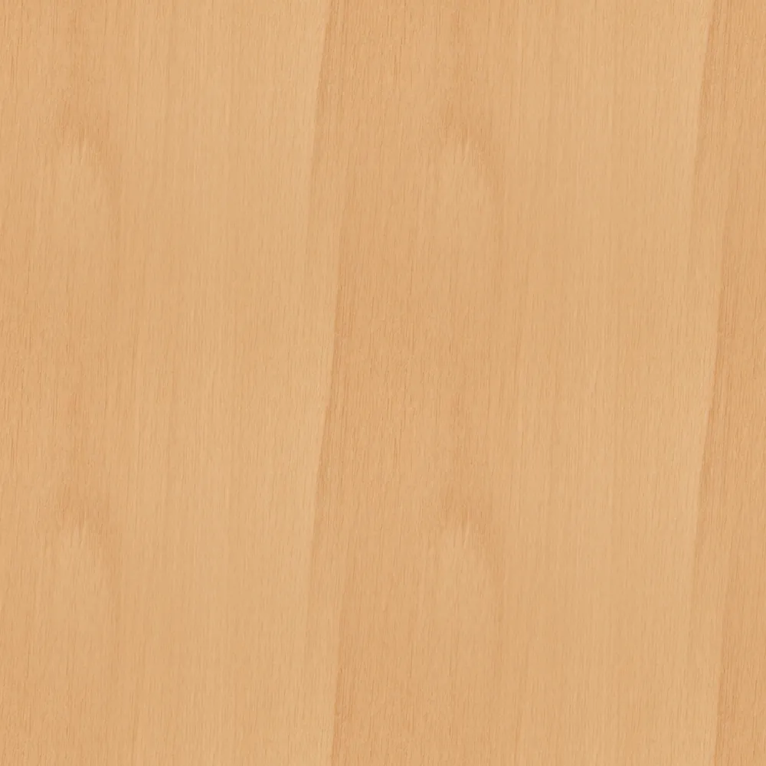
rayforge/builtin_addons/rayforge-addon-materials/materials/plywood.webp
