barebaric/rayforge/rayforge/builtin_addons/rayforge-addon-materials/materials/rosewood.webp

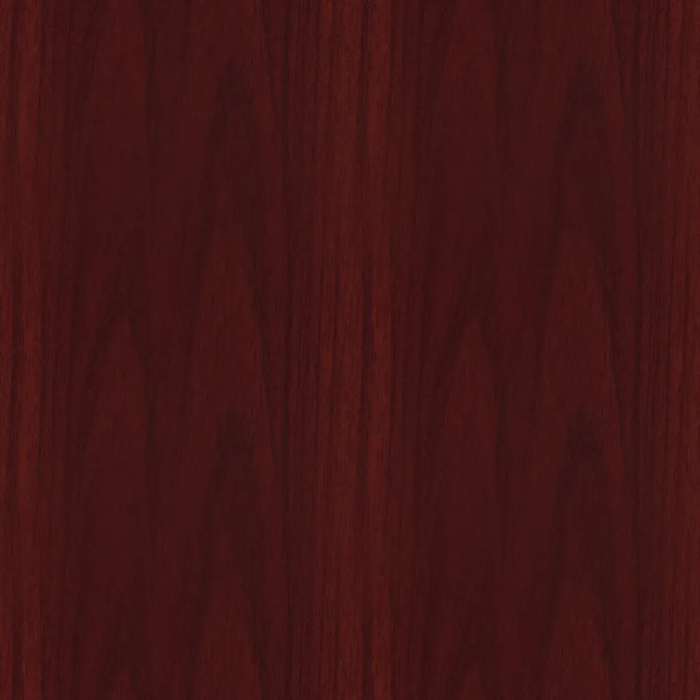
rayforge/builtin_addons/rayforge-addon-materials/materials/rosewood.webp
