barebaric/rayforge/rayforge/builtin_addons/rayforge-addon-materials/materials/slate.webp

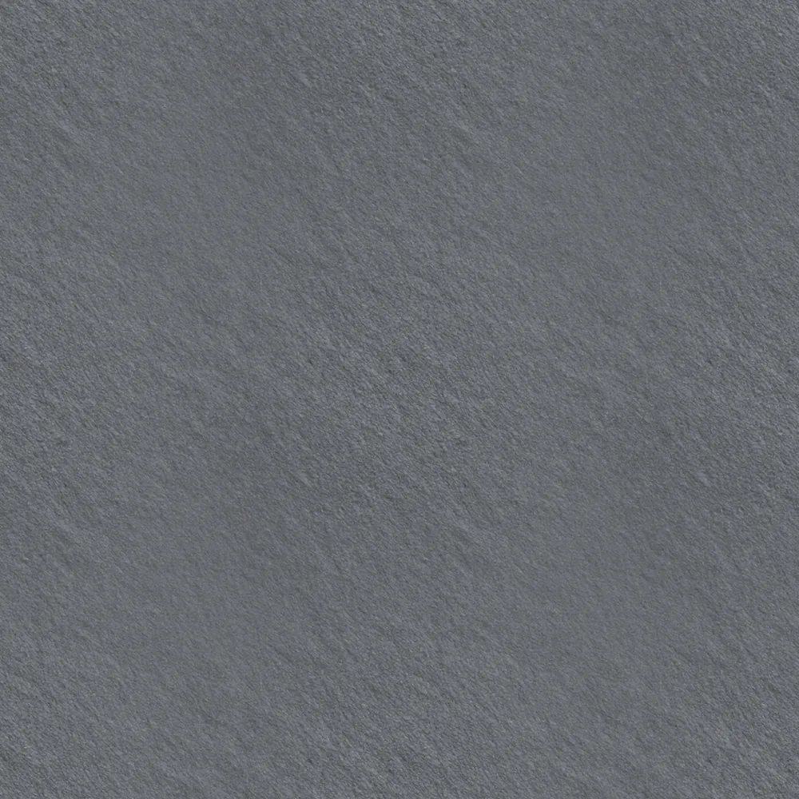
rayforge/builtin_addons/rayforge-addon-materials/materials/slate.webp
