barebaric/rayforge/rayforge/builtin_addons/rayforge-addon-materials/materials/slate_blue.webp

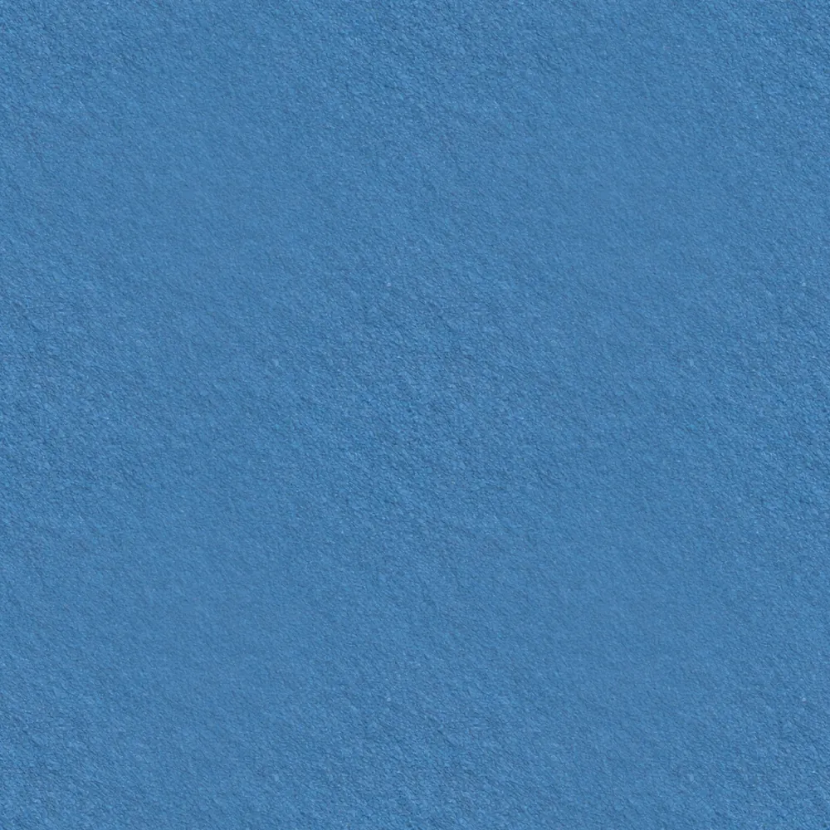
rayforge/builtin_addons/rayforge-addon-materials/materials/slate_blue.webp
