barebaric/rayforge/rayforge/builtin_addons/rayforge-addon-materials/materials/stainless_steel.webp

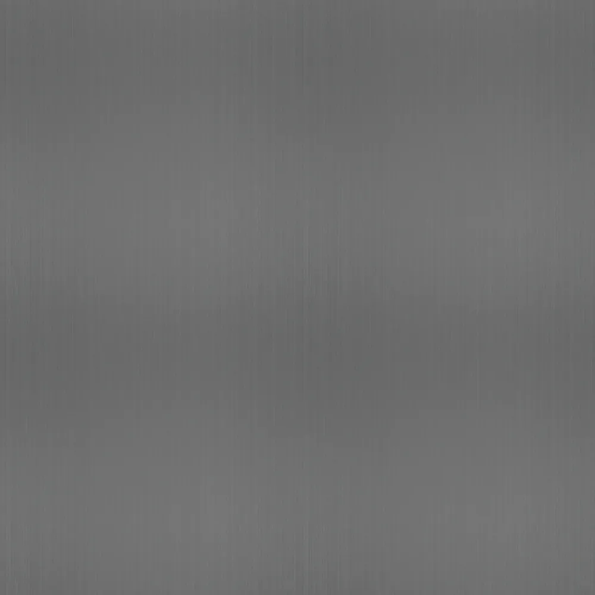
rayforge/builtin_addons/rayforge-addon-materials/materials/stainless_steel.webp
