barebaric/rayforge/rayforge/builtin_addons/rayforge-addon-materials/materials/stone.webp

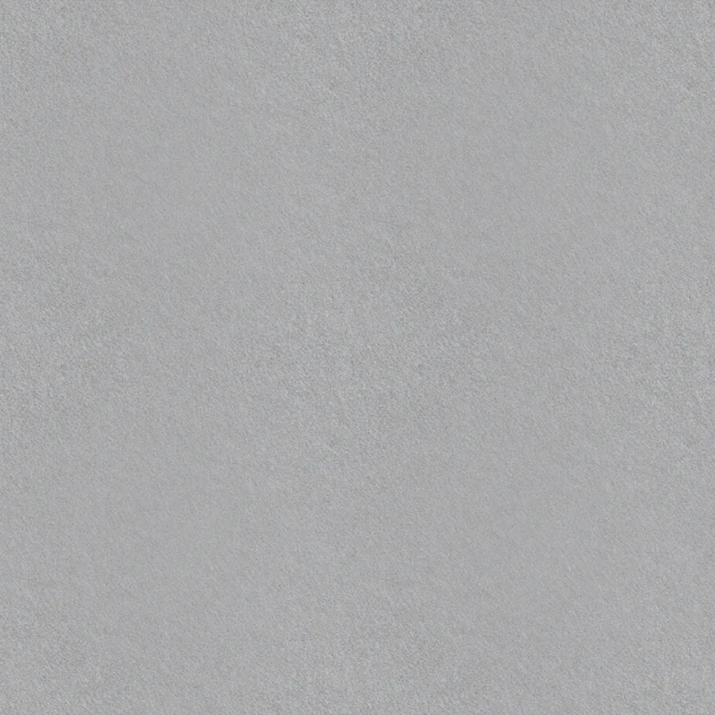
rayforge/builtin_addons/rayforge-addon-materials/materials/stone.webp
