barebaric/rayforge/rayforge/builtin_addons/rayforge-addon-materials/materials/teak.webp

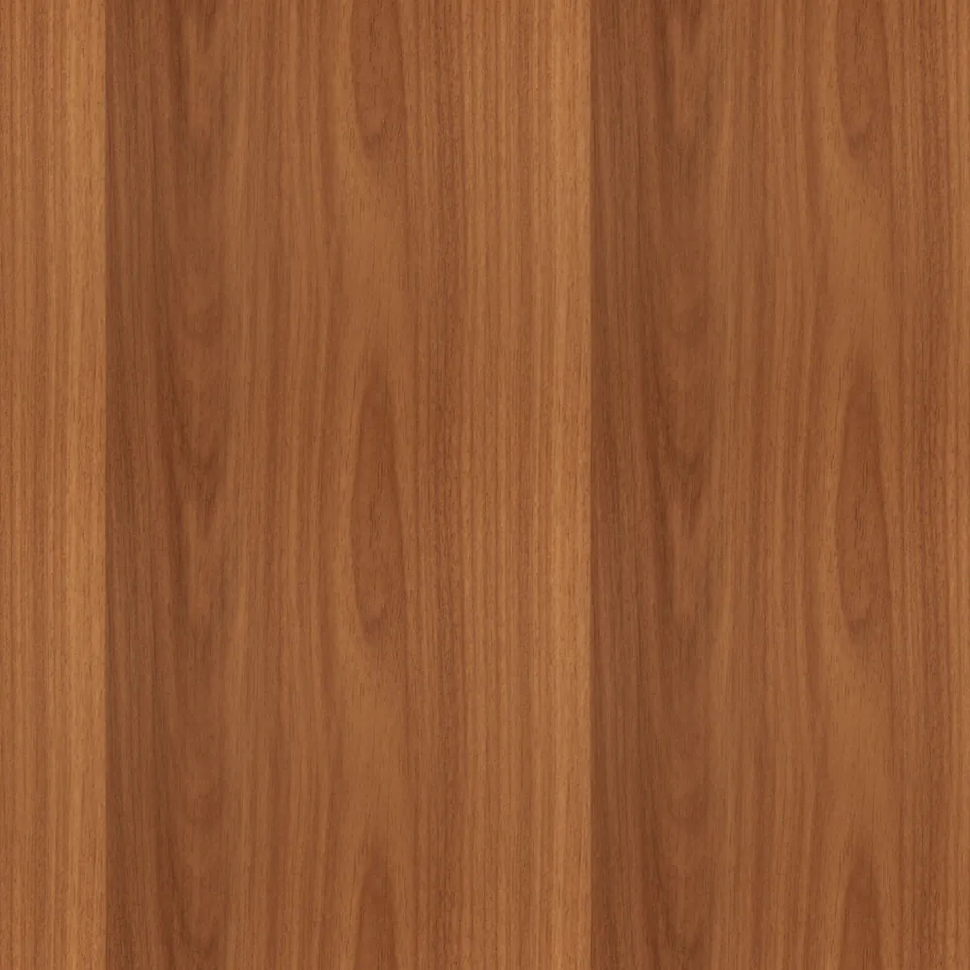
rayforge/builtin_addons/rayforge-addon-materials/materials/teak.webp
