barebaric/rayforge/rayforge/builtin_addons/rayforge-addon-materials/materials/titanium.webp

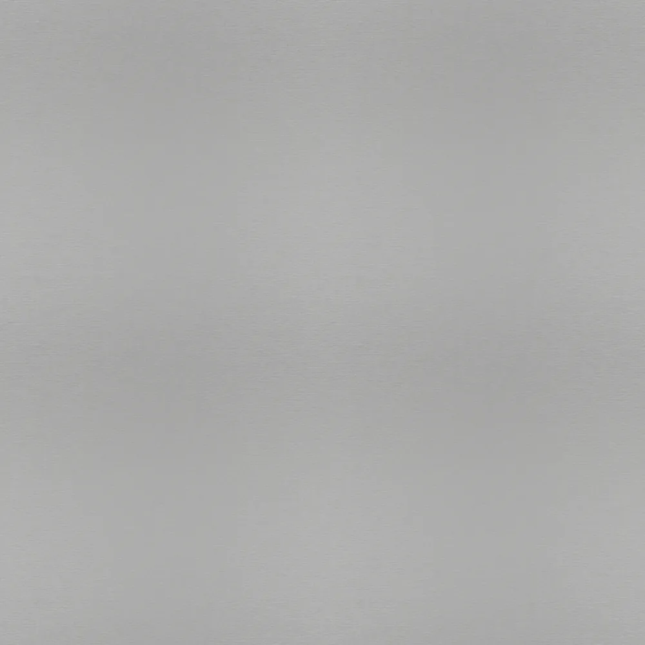
rayforge/builtin_addons/rayforge-addon-materials/materials/titanium.webp
