barebaric/rayforge/rayforge/builtin_addons/rayforge-addon-materials/materials/walnut.webp

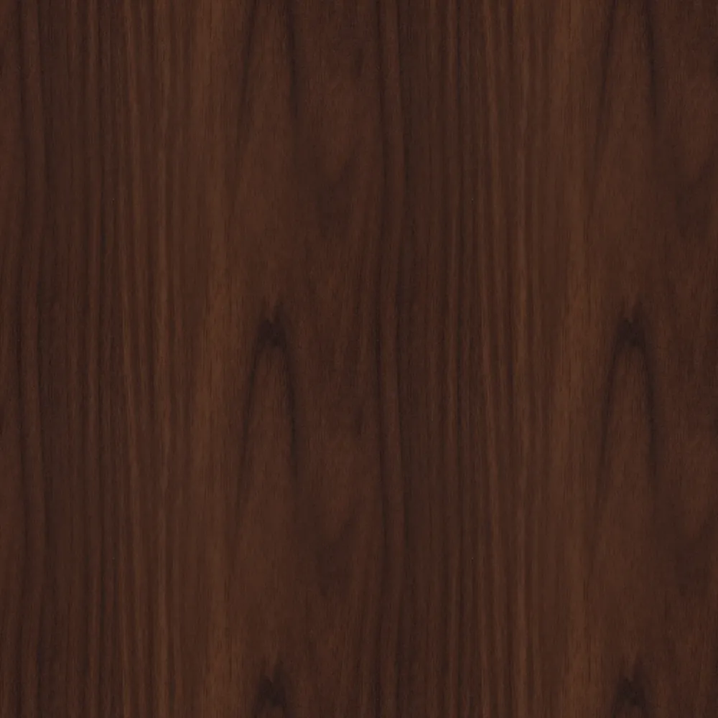
rayforge/builtin_addons/rayforge-addon-materials/materials/walnut.webp
