barebaric/rayforge/rayforge/resources/models/head-diode.FCStd

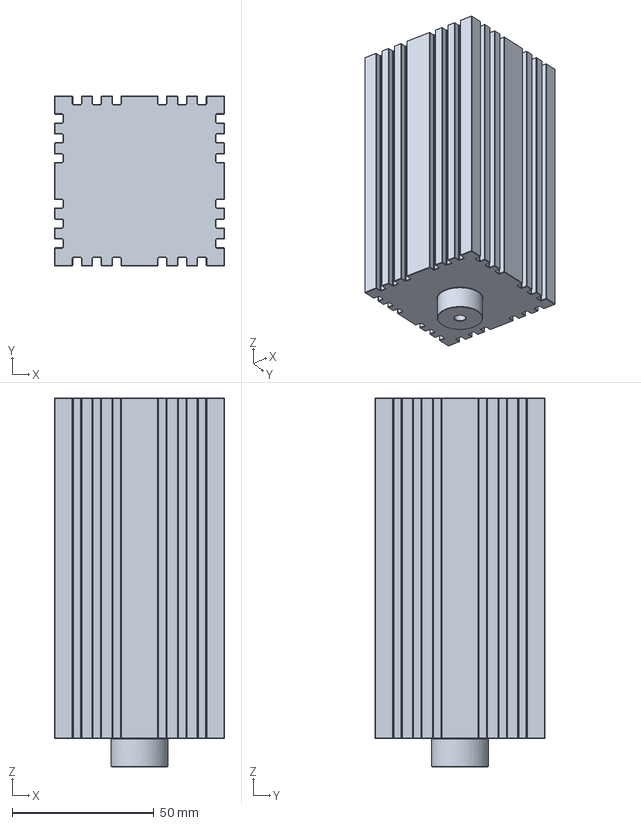
[picture p109: CAD file, 2026-05-10]
rayforge/resources/models/head-diode.FCStd
60.0 x 60.0 x 130.0 mm
