barebaric/rayforge/tests/image/dxf/acdbcircle.dxf

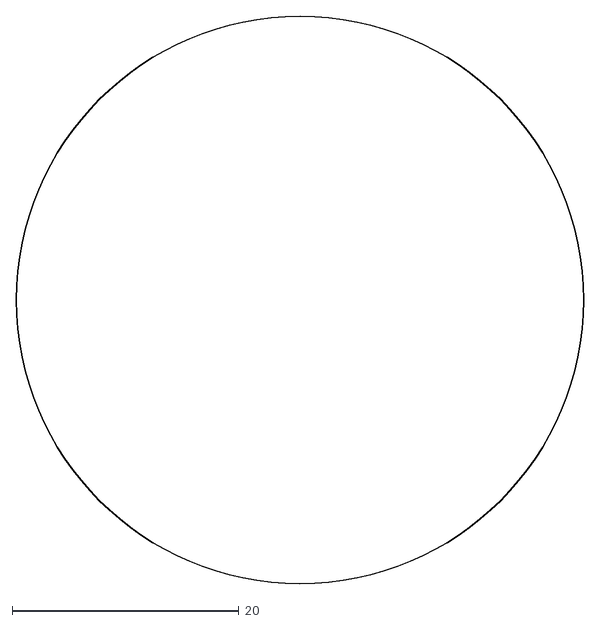
[picture p110: CAD file, 2026-01-08]
tests/image/dxf/acdbcircle.dxf
50.0 x 50.0
