barebaric/rayforge/rayforge/resources/models/head.FCStd

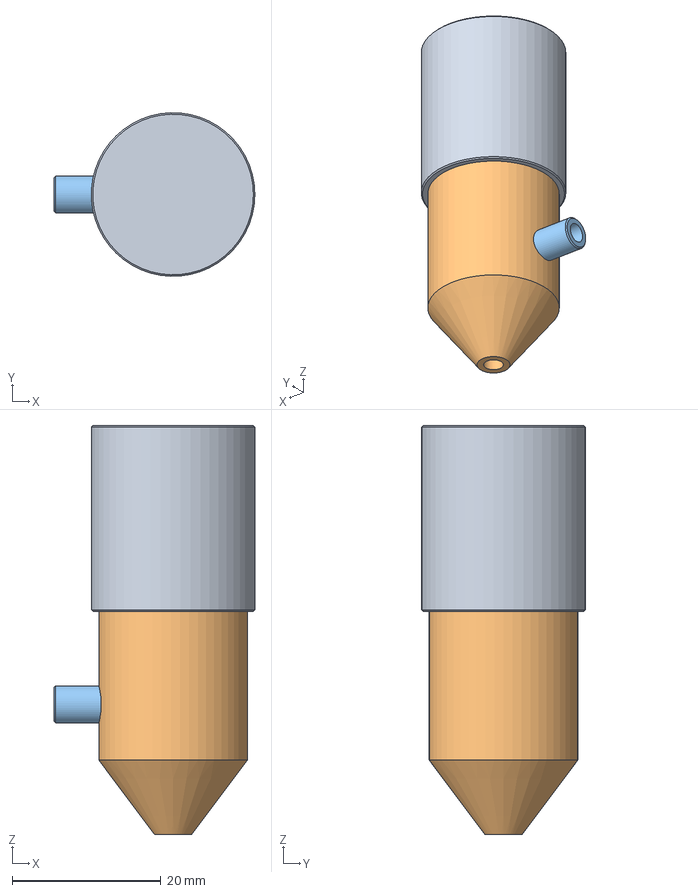
[picture p111: CAD file, 2026-05-05]
rayforge/resources/models/head.FCStd
27.0 x 22.0 x 55.0 mm
Lower body
Upper body
Air connector
