barebaric/rayforge/tests/image/dxf/acdbarc.dxf

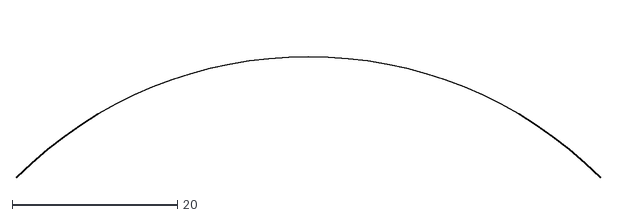
[picture p112: CAD file, 2026-01-08]
tests/image/dxf/acdbarc.dxf
70.7 x 19.5
