barebaric/rayforge/rayforge/resources/models/2axis-rotary.FCStd

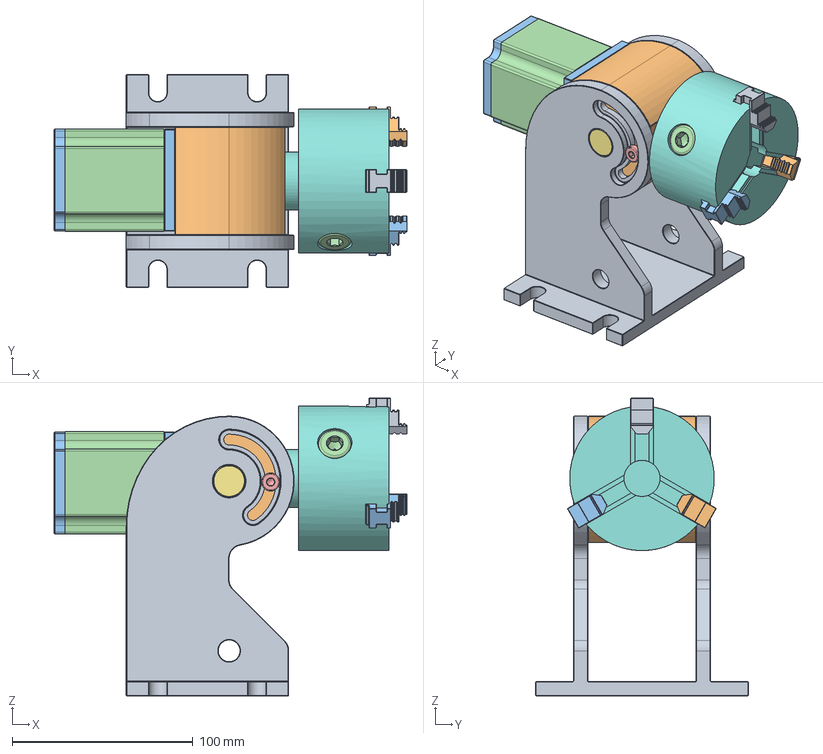
[picture p113: CAD file, 2026-04-10]
rayforge/resources/models/2axis-rotary.FCStd
195.5 x 118.0 x 165.0 mm
nema23
nema23-black
M6x10-Screw
M6x10-Screw002
Pin
chuck
Jaw1
M12x10-Screw
