barebaric/rayforge/rayforge/resources/models/creality-roller.FCStd

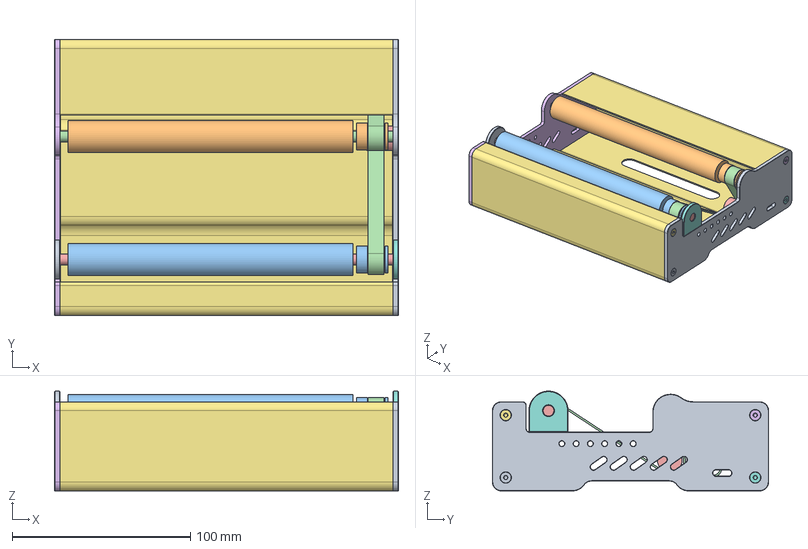
[picture p114: CAD file, 2026-04-01]
rayforge/resources/models/creality-roller.FCStd
193.0 x 155.0 x 56.0 mm
roller1
roller2
rod1
rod2
Body005 (Mirror #1)
Hull
Body008 (Mirror #2)
Belt
belt bearing
M3x8-Screw
M3x8-Screw004
M3x8-Screw007
M3x8-Screw008
M3x8-Screw017
M3x8-Screw018
M3x8-Screw019
M3x8-Screw020
