barebaric/rayforge/rayforge/resources/models/heads/head.FCStd

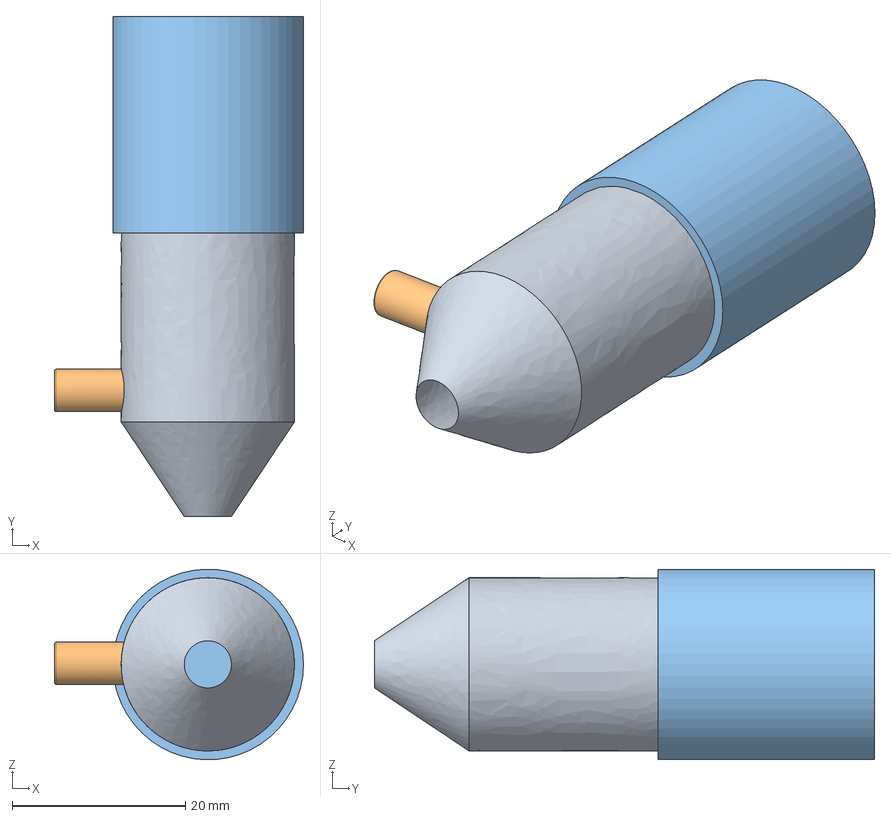
[picture p115: CAD file, 2026-04-05, an earlier design]
rayforge/resources/models/heads/head.FCStd
28.7 x 57.8 x 22.0 mm
