barebaric/rayforge/(list of files, cad)

Other CAD files:
tests/image/dxf/circle.dxf
