barebaric/rayforge/website/docs/features/operations/engrave.md

---
description:
  "Laser engraving modes in Rayforge — constant power, variable power, dithering, and 3D relief.
  Configure engrave operations for photos, text, and artwork."
---

# Engrave

Engrave operations fill areas with raster scanning lines, supporting multiple modes for different
engraving effects. From smooth grayscale photos to 3D relief effects, choose the mode that best
suits your design and material.

## Overview

Engrave operations:

- Fill closed shapes with scanning lines
- Support multiple engraving modes for different effects
- Work with both vector shapes and bitmap images
- Use bidirectional scanning for speed
- Create permanent marks on many materials

## Engrave Modes

### Variable Power Mode

Variable Power mode varies laser power continuously based on image brightness, creating smooth
grayscale engraving with gradual transitions.

**Best For:**

- Smooth grayscale photos and images
- Natural gradients and transitions
- Portraits and artwork
- Wood and leather engraving

**Key Features:**

- Continuous power modulation
- Min/max power control
- Smooth gradients
- Better tonal quality than dithering

### Constant Power Mode

Constant Power mode engraves at full power, with a threshold determining which pixels are engraved.
This creates clean black/white results.

**Best For:**

- Text and logos
- High-contrast graphics
- Clean black/white engravings
- Simple shapes and patterns

**Key Features:**

- Threshold-based engraving
- Consistent power output
- Faster than variable power mode
- Clean edges

### Dither Mode

Dither mode converts grayscale images to binary patterns using dithering algorithms, enabling
high-quality photo engraving with better tonal reproduction than simple threshold-based methods.

**Best For:**

- Engraving photographs on wood or leather
- Creating halftone-style artwork
- Images with smooth gradients
- When standard raster doesn't capture enough detail

**Key Features:**

- Multiple dithering algorithm choices
- Better detail preservation
- Perceived continuous tones
- Ideal for photographs

### Multiple Depths Mode

Multiple Depths mode creates 3D relief effects by varying laser power based on image brightness,
with multiple passes for deeper carving.

**Best For:**

- Creating 3D portraits and artwork
- Terrain and topographic maps
- Lithophanes (light-transmitting 3D images)
- Embossed logos and designs
- Relief sculptures

**Key Features:**

- Depth mapping from image brightness
- Configurable min/max depth
- Smooth gradients
- Multiple passes for deeper engraving
- Z-stepping between passes

## When to Use Engrave

Use engrave operations for:

- Engraving text and logos
- Creating images and photos on wood/leather
- Filling solid areas with texture
- Marking parts and products
- Creating 3D relief effects
- Halftone-style artwork

**Don't use engrave for:**

- Cutting through material (use [Contour](contour) instead)
- Precise outlines (raster creates filled areas)
- Fine line work (vectors are cleaner)

## Creating an Engrave Operation

### Step 1: Prepare Content

Engrave works with:

- **Vector shapes** - Filled with scanning lines
- **Text** - Converted to filled paths
- **Images** - Converted to grayscale and engraved

### Step 2: Add Engrave Operation

- **Menu:** Operations → Add Engrave
- **Shortcut:** <kbd>ctrl+shift+e</kbd>
- **Right-click:** Context menu → Add Operation → Engrave

### Step 3: Choose Mode

Select the engraving mode that best suits your needs:

- **Variable Power** - Smooth grayscale engraving
- **Constant Power** - Clean black/white engraving
- **Dither** - High-quality photo engraving
- **Multiple Depths** - 3D relief effects

### Step 4: Configure Settings

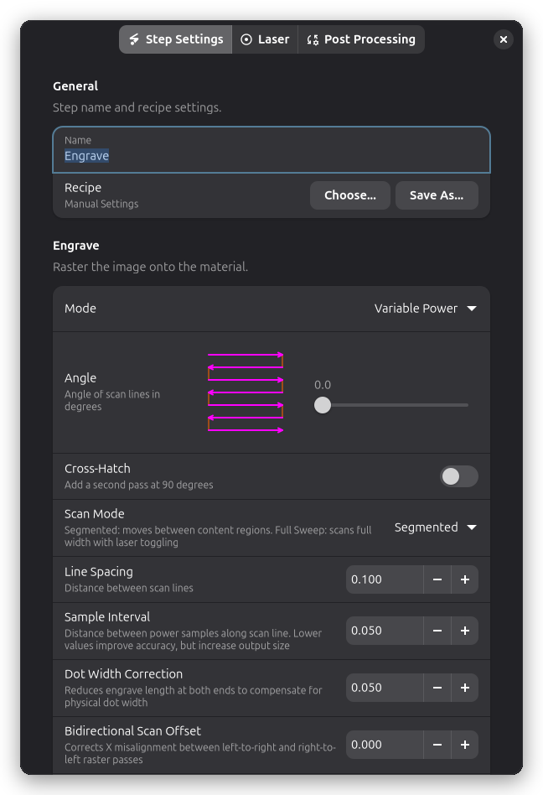
[picture p132: website/static/screenshots/step-settings-engrave-general-variable.webp]
Engrave step settings


## Engrave Settings

The **Engrave** and **Power** groups on the _Step Settings_ tab control the scan pattern, mode, and
power modulation, in row order. Laser power and speed live on the **Laser** page (see below).

### Mode

The **Mode** row selects one of the four engraving modes. Each mode exposes different settings,
described below.

### Mode-Specific Settings

#### Variable Power Mode Settings

Variable Power mode settings

**Min Power (%):**

- Laser power for lightest areas (white pixels)
- Usually 0-20%
- Set higher to avoid very shallow areas

**Max Power (%):**

- Laser power for darkest areas (black pixels)
- Usually 40-80% depending on material
- Lower = subtle relief, higher = dramatic depth

**Power Range Examples:**

| Min | Max | Effect |
| --- | --- | --- |
| 0%  | 40% | Subtle, light relief  |
| 10% | 60% | Medium depth, safe |
| 20% | 80% | Deep, dramatic relief |

**Inverting the image:**

Black engraves deep and white stays shallow. To swap them, for lithophanes (light areas should be
thin) or embossing (raised areas), select the workpiece and use **Tools - Invert Image**. See
[Image Editing](../../addons/image-editing.md).

**Brightness Range:**

Controls how image brightness values are mapped to laser power. The histogram shows the distribution
of brightness values in your image.

- **Auto Levels** (default): Automatically adjusts the black and white points based on image
  content. Values below the black point are treated as black, values above the white point are
  treated as white. This stretches the image's contrast to use the full power range.
- **Manual Mode**: Disable Auto Levels to manually set black and white points by dragging the
  markers on the histogram.

This is particularly useful for:

- Low-contrast images that need contrast enhancement
- Images with limited tonal range
- Ensuring consistent results across different source images

#### Constant Power Mode Settings

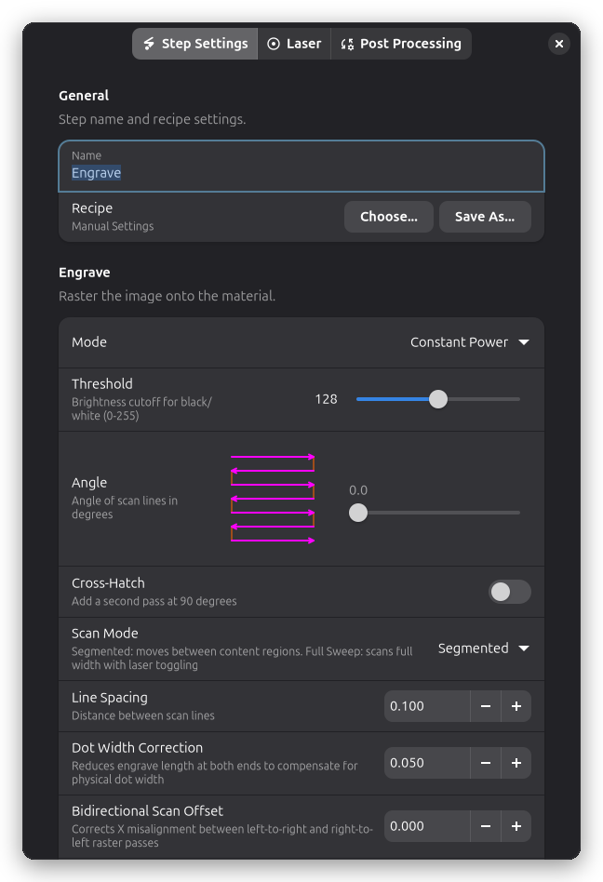
[picture p133: website/static/screenshots/step-settings-engrave-general-constant_power.webp]
Constant Power mode settings


**Threshold (0-255):**

- Brightness cutoff for black/white separation
- Lower = more black engraved
- Higher = more white engraved

**Typical values:**

- 128 (50% gray threshold)
- Adjust based on image contrast

#### Dither Mode Settings

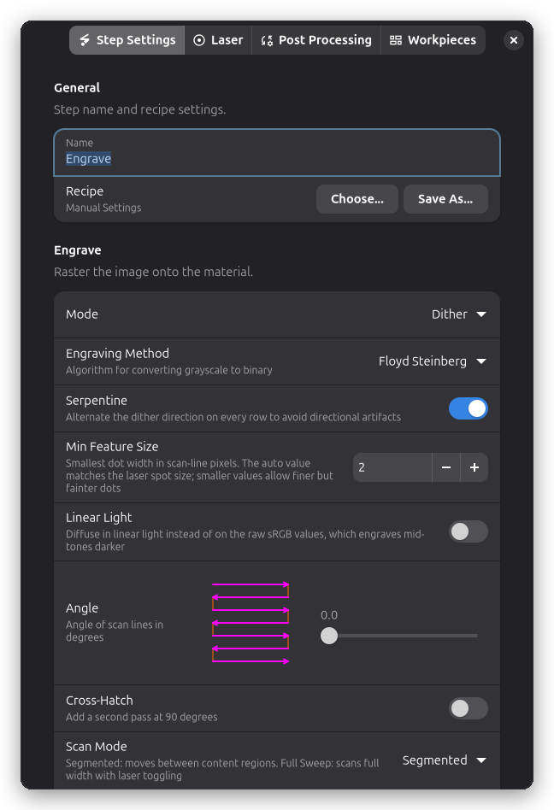
[picture p134: website/static/screenshots/step-settings-engrave-general-dither.webp]
Dither mode settings


**Dithering Algorithm:**

Choose the algorithm that best suits your image and material:

| Algorithm | Quality | Speed | Best For |
| --- | --- | --- | --- |
| Floyd-Steinberg | Highest | Slowest | Photos, portraits, smooth gradients |
| Bayer 2x2 | Low | Fastest | Coarse halftone effect |
| Bayer 4x4 | Medium  | Fast | Balanced halftone |
| Bayer 8x8 | High | Medium  | Fine detail, subtle patterns |
| Atkinson | Medium  | Medium  | High-contrast images, wood |
| Stucki | Highest | Slow | Portraits, smooth skin tones |
| Jarvis, Judice & Ninke | Highest | Slow | Soft gradients, fine grain |
| Sierra (3-row, 2-row, Lite) | High | Medium  | Lighter alternatives to Stucki |
| Burkes | High | Medium  | Photos, faster than Stucki |
| Newsprint | Medium  | Fastest | Clustered newspaper-style dots |
| Halftone | Medium  | Fast | Round dots, adjustable size and angle |

**Floyd-Steinberg** is default and recommended for most photo engravings. It uses error diffusion to
distribute quantization errors to neighboring pixels, creating natural-looking results.

**Bayer dithering** creates regular patterns that can produce artistic effects resembling
traditional halftone printing.

**Stucki, Jarvis, Sierra, Burkes and Atkinson** are error-diffusion algorithms like Floyd-Steinberg
that spread the error over a wider neighborhood, which gives a smoother grain in flat areas such as
skin tones. Atkinson diffuses only part of the error, which raises contrast. **Serpentine** (on by
default) alternates the scan direction on every row and avoids directional streaks.

**Min Feature Size** groups each scan line into cells before diffusing, so no dot is smaller than
the given number of pixels. The auto value matches the laser spot size, which keeps every dot at
full strength; smaller values allow finer but fainter dots.

**Linear Light** diffuses in linear light instead of on the raw sRGB values. Dithering the sRGB
values keeps the dot coverage at the tone the image shows on screen; linear light engraves mid-tones
noticeably darker.

**Newsprint** and **Halftone** group pixels into dots. Halftone draws round dots on a grid set by
**Halftone Cell Size** (the distance between dot centers) and **Halftone Angle**; use a cell size of
at least a few laser spot widths.

#### Multiple Depths Mode Settings

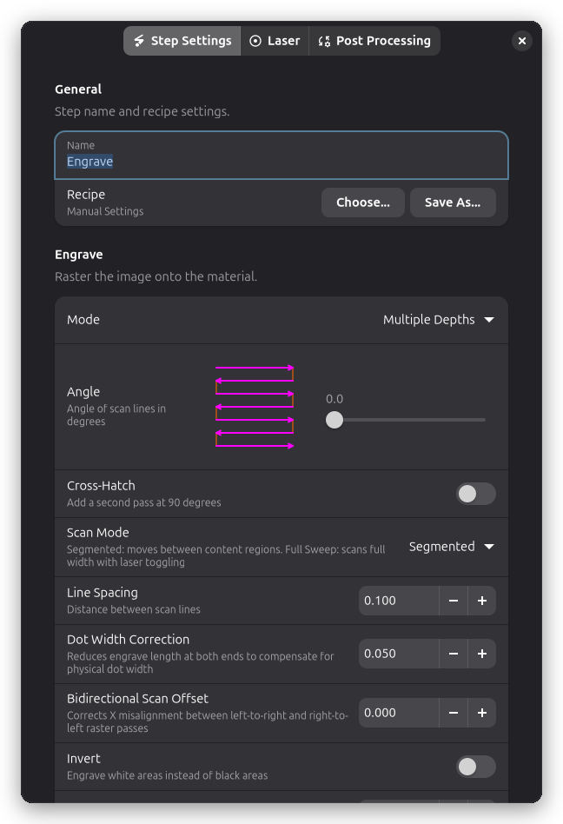
[picture p135: website/static/screenshots/step-settings-engrave-general-multi_pass.webp]
Multiple Depths mode settings


**Number of Depth Levels:**

- Number of discrete depth levels
- More levels = smoother gradients
- Typical: 5-10 levels

**Z Step-Down per Level (mm):**

- How far to step down between depth passes
- Creates deeper total depth with multiple passes
- Typical: 0.1-0.5mm

**Rotate Angle Per Pass:**

- Degrees to rotate each successive pass
- Creates crosshatch-like 3D effect
- Typical: 0-45 degrees

**Inverting the image:**

Black engraves deep and white stays shallow. To swap them, for lithophanes (light areas should be
thin) or embossing (raised areas), select the workpiece and use **Tools - Invert Image**. See
[Image Editing](../../addons/image-editing.md).

### Scan Pattern

#### Line Interval

**Line Interval (mm):**

- Spacing between scan lines
- Smaller = higher quality, longer job time
- Larger = faster, visible lines

| Interval | Quality | Speed | Use For |
| --- | --- | --- | --- |
| 0.05mm | Highest | Slowest | Photos, fine detail |
| 0.1mm | High | Medium  | Text, logos, graphics |
| 0.2mm | Medium  | Fast | Solid fills, textures |
| 0.3mm+ | Low | Fastest | Draft, testing |

**Recommended:** 0.1mm for general use

<!-- prettier-ignore-start -->
:::tip[Resolution Match]
For images, line interval should match or exceed image resolution. If your image is 10 pixels/mm
(254 DPI), use 0.1mm line interval or smaller.
:::
<!-- prettier-ignore-end -->

#### Sample Interval

**Sample Interval (mm):**

- Distance between samples along each scan line, in every raster mode
- In dithering it sets the length of each dot; in power-modulated engraving it sets how often the
  power changes along the line
- Smaller = finer detail, larger output files
- The auto value gives square dots in dithering (it follows the line spacing) and is half the laser
  spot width in power-modulated modes

**Recommended:** keep the auto value. A sample interval much larger than the line interval makes
each dot a long dash, which shows up as visible texture on gradations.

#### Scan Direction

**Scan Angle (degrees):**

- Direction of scan lines
- 0 = horizontal (left to right)
- 90 = vertical (top to bottom)
- 45 = diagonal

**Why change angle?**

- Wood grain: Engrave perpendicular to grain for better results
- Pattern orientation: Match design aesthetics
- Reduce banding: Different angle can hide imperfections

**Bidirectional Scanning:**

Rayforge always scans bidirectionally (left-to-right, then right-to-left), since firing on every
pass roughly doubles engraving speed compared to returning without firing between lines.

Slight mechanical or firing delay differences between the two directions can cause visible banding
on some machines. If you see this, calibrate the **Bidirectional Scan Offset** below to correct it
directly, rather than losing the speed benefit.

#### Bidirectional Scan Offset

Corrects a fixed mechanical or firing delay skew between left-to-right and right-to-left raster
passes, which otherwise misaligns alternate scan rows (visible as banding, especially in photo
engraves).

- Set in millimeters, positive or negative depending on which direction needs to shift
- A non-zero value here always wins; when it is 0, the step falls back to the machine's
  [Bidirectional Scan Offset by Speed](../../machine/advanced.md#bidirectional-scan-offset-by-speed)
  table, which interpolates an offset for this step's speed
- Defaults to 0 (no correction)

**Calibrating the offset:**

1. Engrave a test pattern with visible vertical detail (e.g. a fine grid) using bidirectional
   scanning
2. Compare alternate rows to find the direction and amount of misalignment
3. Adjust the offset in small increments (0.01-0.05mm) and re-test until alternating rows line up

If the misalignment changes noticeably across your usual engraving speeds, a single offset cannot
fix every job. Leave the step offset at 0 and enter a speed-dependent offset table in
[Machine Settings - Advanced](../../machine/advanced.md#bidirectional-scan-offset-by-speed) instead.

## Laser settings

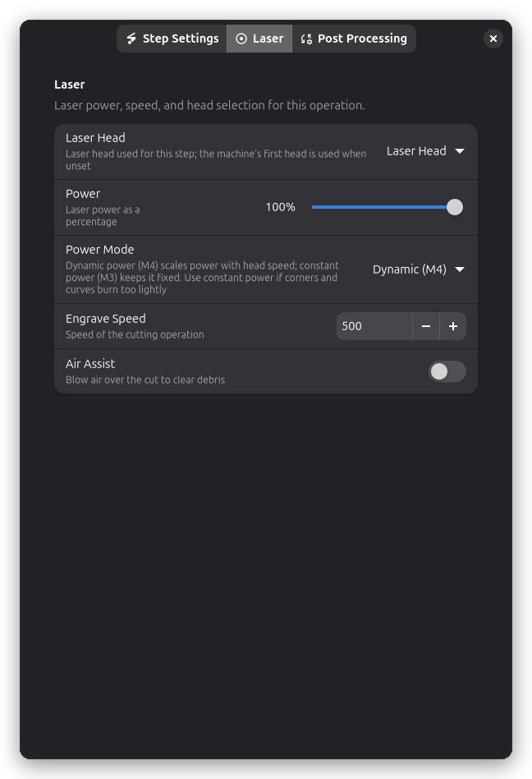
[picture p136: website/static/screenshots/step-settings-engrave-laser.webp]
Laser settings


Power, speed, and laser head selection live on the **Laser** page of the step settings dialog.

### Power & Speed

**Power (%):**

- Laser intensity for engraving
- Lower power for lighter marking
- Higher power for deeper engraving

**Speed (mm/min):**

- How fast the laser scans
- Faster = lighter, slower = darker

## Post-Processing

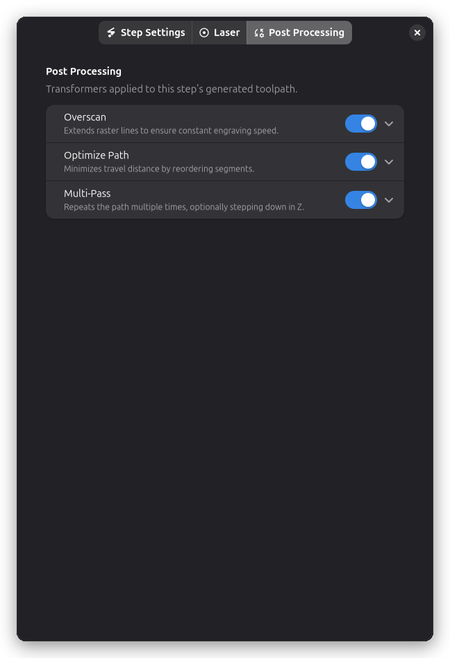
[picture p137: website/static/screenshots/step-settings-engrave-post.webp]
Engrave post-processing settings


Engrave operations support several post-processing options:

- **[Overscan](../overscan.md)** - Extend raster lines for consistent engraving quality
- **[Path Optimization](../path-optimization.md)** - Reduce travel distance
- **[Multi-Pass](../multi-pass.md)** - Repeat engraving for deeper results

### Overscan

**Overscan Distance (mm):**

- How far beyond the design the laser travels before turning around
- Allows laser to reach full speed before entering the design
- Prevents burn marks at line starts/ends

**Typical values:**

- 2-5mm for most jobs
- Larger for high speeds

See [Overscan](../overscan.md) for details.

## Tips & Best Practices

### Material Selection

**Best materials for engraving:**

- Wood (natural variations create beautiful results)
- Leather (burns to dark brown/black)
- Anodized aluminum (removes coating, reveals metal)
- Coated metals (removes coating layer)
- Some plastics (test first!)

**Challenging materials:**

- Clear acrylic (doesn't show engraving well)
- Metals without coating (requires special marking compounds)
- Glass (requires special settings/coatings)

### Quality Settings

**For best quality:**

- Use smaller line interval (0.05-0.1mm)
- Calibrate the Bidirectional Scan Offset if you see banding
- Increase overscan (3-5mm)
- Use lower power, multiple passes
- Ensure material is flat and secured

**For faster engraving:**

- Use larger line interval (0.15-0.2mm)
- Minimum overscan (1-2mm)
- Single pass at higher power

### Common Issues

**Burn marks at line ends:**

- Increase overscan distance
- Check acceleration settings
- Reduce power slightly

**Visible scan lines:**

- Decrease line interval
- Reduce power (over-burning creates gaps)
- Check that material is flat

**Uneven engraving:**

- Ensure material is flat
- Check focus consistency
- Verify laser power stability
- Clean laser lens

**Banding (dark/light stripes):**

- Calibrate the [Bidirectional Scan Offset](#bidirectional-scan-offset)
- Check belt tension
- Reduce speed
- Try different scan angle

## Troubleshooting

### Engraving too light

- **Increase:** Power setting
- **Decrease:** Speed setting
- **Check:** Focus is correct
- **Try:** Multiple passes

### Engraving too dark/burning

- **Decrease:** Power setting
- **Increase:** Speed setting
- **Increase:** Line interval
- **Check:** Material is appropriate

### Inconsistent darkness

- **Check:** Material is flat
- **Check:** Focus distance is consistent
- **Verify:** Laser beam is clean
- **Test:** Different area of material (grain varies)

### Image looks pixelated

- **Decrease:** Line interval
- **Check:** Source image resolution
- **Try:** Smaller line interval (0.05mm)
- **Verify:** Image isn't being upscaled

### Scan lines visible

- **Decrease:** Line interval
- **Reduce:** Power (over-burning creates gaps)
- **Try:** Different scan angle
- **Ensure:** Material surface is smooth

## Related Topics

- **[Contour Cutting](contour)** - Cutting outlines and shapes
- **[Overscan](../overscan.md)** - Improving engraving quality
- **[Material Test Grid](material-test-grid)** - Finding optimal settings
- **[Multi-Layer Workflow](../multi-layer.md)** - Combining engrave with other operations
