barebaric/rayforge/website/i18n/zh-CN/docusaurus-plugin-content-docs/current/addons/print-and-cut.md

# 打印与切割

通过在设计上注册参考点并将其匹配到材料上的实际物理位置，将激光切割对齐到预印材料上。这适用于切割贴纸、标签或任何需要与现有印刷品对齐的物品。

## 前提条件

此插件需要一台已配置的机器。在移动步骤中，您的机器必须已连接。您还需要在画布上选中一个工件或分组。

## 打开向导

在画布上选择一个工件或分组，然后打开
**工具 - 对齐到物理位置**。向导以三步对话框的形式打开，左侧显示工件的预览，右侧显示控制面板。

## 第一步：选择设计点

选择设计点

左侧面板显示所选工件的渲染图。直接在渲染图上点击以放置第一个对齐点（绿色标记），然后再次点击放置第二个点（蓝色标记）。一条虚线连接两个点。

选择两个对应于物理材料上可识别特征的点——例如，印刷的对准标记或明显的角落。两个点需要相距足够远以确保精确对齐。放置后可以拖动任一点来微调位置。

使用滚轮放大预览，中键拖动进行平移。底部的 **重置** 按钮清除两个点，让您重新开始。

两个点都放置好后，点击 **下一步** 继续。

## 第二步：记录物理位置

记录物理位置

在此页面上，您将激光移动到与所选两个设计点对应的物理位置。右侧面板显示一个方向键盘用于移动，以及一个距离控件来设置每步激光移动的距离。

将激光移动到与第一个设计点匹配的物理位置，然后点击位置1旁边的
**记录**。记录的坐标将显示在该行中。对位置2重复此过程。您可以随时点击 **前往**
按钮返回到已记录的位置。

**聚焦激光**
开关以配置的聚焦功率打开激光，在材料上产生一个可见的光点，帮助您精确定位。此开关需要在激光设置中设置大于零的聚焦功率值。

如果您的激光头带有对准指示器，**Pointer Alignment**
开关会在指示光点处而不是光束处记录位置，因此计算出的变换会跟随您瞄准的光点。它需要在[激光设置](../machine/laser.md)中配置指示器偏移。

激光的当前位置显示在面板底部。两个位置都记录后，点击 **下一步** 继续。

## 第三步：查看并应用变换

查看并应用变换

最后一页显示计算得出的对齐结果，包括平移偏移和旋转角度。这些值是根据您的设计点与记录的物理位置之间的差异计算得出的。

默认情况下，缩放锁定为1.0。如果您的物理材料在尺寸上与设计不同——例如由于打印机缩放——请启用
**允许缩放**
开关。缩放因子将根据两个点之间的物理距离与设计距离的比率计算得出。当缩放被锁定但距离不匹配时，会显示一条提示，表明第二个点可能无法精确对齐。

点击 **应用** 将画布上的工件移动和旋转以匹配物理位置。变换作为可撤销的操作应用。

## 相关主题

- [工件定位](../features/workpiece-positioning.md) - 手动定位和变换工件
- [激光设置](../machine/laser.md) - 配置激光的聚焦功率
