barebaric/rayforge/website/docs/getting-started/installation.mdx

---
description: "Install Rayforge — free open-source laser cutter software for Linux, Windows, and macOS. Supports Snap, Flathub, AppImage, and source installation."
---

# Installation

import InstallGuide from '@site/src/components/InstallGuide';
import InstallAnchors from '@site/src/components/InstallAnchors';

Rayforge is available for Linux, Windows, and macOS. Choose your platform below
and follow the installation instructions.

<InstallAnchors />

<InstallGuide />

---

## System Requirements

| Resource | Installed | Recommended |
|---|---|---|
| Disk Space | < 1 GB | Varies by project |
| RAM | 1 GB | Varies by project |

Actual disk and memory requirements depend on project complexity. Simple
projects may need little beyond the installed footprint, while complex projects
can easily consume 10 GB of RAM or more and require significant additional disk
space.

## Next Steps

Now that Rayforge is installed, proceed to
[First Time Setup](first-time-setup) to configure your machine.
