barebaric/rayforge/website/i18n/zh-CN/docusaurus-plugin-content-docs/current/general-info/usage-tracking.md

# 使用情况跟踪

Rayforge 包含可选的匿名使用情况跟踪，帮助我们了解应用程序的使用方式并优先考虑未来的开发。本页面解释了我们跟踪的内容、工作原理以及您的隐私。

## 完全可选

使用情况跟踪是**完全可选的**。当您首次启动 Rayforge 时，系统会询问您是否愿意参与：

- **是**：匿名使用数据将被发送到我们的分析服务器
- **否**：永远不会收集或传输任何数据

您可以随时在常规设置中更改此选择。

## 我们跟踪什么

启用后，我们只收集匿名的页面浏览数据——类似于网站分析。以下是我们能看到的内容：

| 数据 | 示例 |
| --- | --- |
| 屏幕分辨率 | 1920x1080 |
| 机器类型 | grbl、二极管激光、430x400 |
| 语言设置 | zh-CN |
| 浏览的页面/对话框 | /machine-settings/general |
| 页面停留时间 | 6分3秒 |
| 会话ID | a1b2c3d4-e5f6-... |

会话ID是每次启动Rayforge时生成的随机标识符。它使我们能够区分不同的使用会话，同时保持跟踪完全匿名。

## 我们看到什么

以下是分析仪表板的示例：

| 路径 | 访问者 | 访问次数 | 浏览量 | 跳出率 | 访问时长 |
| --- | --- | --- | --- | --- | --- |
| / | 1 | 1 | 5 | 0% | 27分35秒 |
| /machine-settings/general | 1 | 1 | 5 | 0% | 27分27秒 |
| /view/3d | 1 | 1 | 2 | 0% | 25分14秒 |
| /camera-alignment-dialog  | 1 | 1 | 2 | 0% | 6分3秒 |
| /machine-settings/camera  | 1 | 1 | 2 | 0% | 6分16秒  |
| /settings/general | 1 | 1 | 2 | 0% | 16分36秒 |
| /step-settings/rasterizer | 1 | 1 | 2 | 0% | 11秒 |

## 我们不跟踪什么

我们致力于保护您的隐私：

- **无个人信息** – 无姓名、电子邮件或账户
- **无文件内容** – 您的设计和项目保持私密
- **无机器标识符** – 无序列号或唯一ID
- **不存储IP地址** – 我们使用不存储IP的Umami分析
- **无跨站点跟踪** – 数据仅限于Rayforge

## 我们为什么跟踪

使用数据帮助我们：

- **识别热门功能** – 了解哪些功能运作良好
- **发现痛点** – 了解用户在哪里花费时间或遇到困难
- **优先开发** – 专注于人们实际使用的功能
- **了解多样性** – 了解需要支持哪些语言和屏幕尺寸

## 工作原理

Rayforge 使用 [Umami](https://umami.is/)，一个注重隐私的开源分析平台。跟踪功能：

- 在后台发送小型HTTP请求
- 不影响应用程序性能
- 离线工作（失败的请求会被静默忽略）
- 发送时使用与操作系统匹配的浏览器风格 User-Agent

## 禁用跟踪

您可以随时禁用跟踪：

1. 打开 **设置** → **常规**
2. 关闭 **发送匿名使用统计**

禁用后，绝对不会发送任何数据。

## 相关页面

- **[应用程序设置](../ui/settings.md)** – 配置跟踪偏好
