barebaric/rayforge/website/i18n/uk/docusaurus-plugin-content-docs/current/addons/print-and-cut.md

# Print & Cut

Вирівняйте лазерну різку на попередньо надрукованому матеріалі, зареєструвавши контрольні точки на
вашому дизайні та співставивши їх із фізичними позиціями на матеріалі. Це корисно для вирізання
наліпок, етикеток або будь-чого, що повинно збігатися з наявним друком.

## Передумови

Аддон потребує налаштованої машини. Ваша машина повинна бути підключена для кроку переміщення. Вам
також потрібно вибрати один workpiece або групу на полотні.

## Відкриття майстра

Виберіть один workpiece або групу на полотні, потім відкрийте **Інструменти - Вирівняти до фізичної
позиції**. Майстер відкривається як діалог із трьох кроків із попереднім переглядом вашого workpiece
зліва та елементами керування справа.

## Крок 1: Вибір точок дизайну

Вибір точок дизайну

Ліва панель показує відображення вашого вибраного workpiece. Натисніть безпосередньо на відображене
зображення, щоб розмістити першу точку вирівнювання (позначена зеленим), потім натисніть ще раз, щоб
розмістити другу точку (позначена синім). Пунктирна лінія з'єднує дві точки.

Виберіть дві точки, які відповідають розпізнаваним особливостям на вашому фізичному матеріалі —
наприклад, надруковані реєстраційні позначки або помітні кути. Точки повинні бути достатньо
віддалені одна від одної для точного вирівнювання. Ви можете перетягнути будь-яку точку після
розміщення для точного коригування позиції.

Використовуйте колесо прокрутки для збільшення попереднього перегляду та клік середньою кнопкою з
перетягуванням для панорамування. Кнопка **Скинути** внизу очищає обидві точки і дозволяє почати
заново.

Після розміщення обох точок натисніть **Далі**, щоб продовжити.

## Крок 2: Запис фізичних позицій

Запис фізичних позицій

На цій сторінці ви переміщуєте лазер до фізичних позицій, які відповідають двом вибраним точкам
дизайну. Права панель відображає напрямний блок для переміщення та елемент керування відстанню, який
визначає, на скільки лазер переміщується за крок.

Перемістіть лазер до фізичної позиції, що відповідає вашій першій точці дизайну, потім натисніть
**Записати** поруч із Позицією 1. Записані координати з'являться в рядку. Повторіть процес для
Позиції 2. Ви можете повернутися до записаної позиції в будь-який час, натиснувши кнопку **Перейти
до** поруч із нею.

Перемикач **Фокусний лазер** вмикає лазер на налаштованій потужності фокусування, створюючи видиму
крапку на матеріалі, щоб допомогти вам точно визначити позиції. Цей перемикач вимагає значення
потужності фокусування більше нуля в налаштуваннях лазера.

Якщо ваша лазерна головка має вирівнювальний вказівник, перемикач **Pointer Alignment** записує
позиції за крапкою вказівника замість променя, тож обчислене перетворення слідує за крапкою, на яку
ви цілись. Він вимагає налаштованого зсуву вказівника у [налаштуваннях лазера](../machine/laser.md).

Поточна позиція лазера відображається внизу панелі. Коли обидві позиції записані, натисніть
**Далі**, щоб продовжити.

## Крок 3: Перевірка та застосування перетворення

Перевірка та застосування перетворення

Остання сторінка показує обчислене вирівнювання як зсув переміщення та кут обертання. Ці значення
отримуються з різниці між вашими точками дизайну та записаними фізичними позиціями.

Типово масштабування заблоковане на 1.0. Якщо ваш фізичний матеріал відрізняється за розміром від
дизайну — наприклад, через масштабування принтера — увімкніть перемикач **Дозволити масштабування**.
Коефіцієнт масштабу обчислюється з відношення фізичної відстані до відстані дизайну між вашими двома
точками. Примітка з'являється, коли масштабування заблоковане, але відстані не збігаються, вказуючи
на те, що друга точка може не вирівнятися точно.

Натисніть **Застосувати**, щоб перемістити та повернути workpiece на полотні відповідно до фізичних
позицій. Перетворення застосовується як дія, яку можна скасувати.

## Пов'язані теми

- [Позиціонування workpiece](../features/workpiece-positioning.md) - Позиціонування та перетворення
  workpiece вручну
- [Налаштування лазера](../machine/laser.md) - Налаштувати потужність фокусування лазера
