barebaric/rayforge/website/i18n/hi/docusaurus-plugin-content-docs/current/getting-started/installation.mdx

---
description: "Rayforge इंस्टॉल करें — Linux, Windows, और macOS के लिए मुफ़्त ओपन-सोर्स लेज़र कटर सॉफ़्टवेयर. Snap, Flathub, और स्रोत इंस्टॉलेशन का समर्थन करता है."
---

# इंस्टॉलेशन

import InstallGuide from '@site/src/components/InstallGuide';
import InstallAnchors from '@site/src/components/InstallAnchors';

Rayforge Linux, Windows, और macOS के लिए उपलब्ध है. नीचे अपना प्लेटफ़ॉर्म चुनें और
इंस्टॉलेशन निर्देशों का पालन करें.

<InstallAnchors />

<InstallGuide />

---

## सिस्टम आवश्यकताएँ

| संसाधन | इंस्टॉल | अनुशंसित |
|---|---|---|
| डिस्क स्थान| < 1 GB | परियोजना अनुसार |
| RAM | 1 GB | परियोजना अनुसार |

वास्तविक डिस्क और मेमोरी आवश्यकताएँ परियोजना जटिलता पर निर्भर करती हैं. सरल परियोजनाओं को इंस्टॉल
फ़ुटप्रिंट से परे थोड़ा ही चाहिए होता है, जबकि जटिल परियोजनाएँ आसानी से 10 GB RAM या अधिक का उपभोग
कर सकती हैं और महत्वपूर्ण अतिरिक्त डिस्क स्थान चाहती हैं.

## अगले चरण

अब जब Rayforge इंस्टॉल हो गया है, अपनी मशीन कॉन्फ़िगर करने के लिए
[पहली बार का सेटअप](first-time-setup) पर आगे बढ़ें.
