barebaric/rayforge/website/i18n/zh-CN/docusaurus-plugin-content-docs/current/getting-started/quick-start.md

# 快速入门指南

现在 Rayforge 已安装完成，您的机器也已配置好，让我们运行您的第一个激光任务！本指南将带您了解导入设计、配置操作以及将 G 代码发送到您的机器。

## 第 1 步：导入设计

Rayforge 支持多种文件格式，包括 SVG、DXF、PDF、Ruida (.rd) 和光栅图像（JPEG、PNG、BMP）。

1. **点击** **文件 → 打开** 或按 <kbd>ctrl+o</kbd>
2. 导航到您的设计文件并选择它
3. 设计将显示在画布上

导入设计的画布

<!-- prettier-ignore-start -->
:::tip[还没有设计？]
您可以使用绘图器创建简单的形状，或从 [Flaticon](https://www.flaticon.com/) 或
[SVG Repo](https://www.svgrepo.com/) 等网站下载免费的 SVG 文件。
:::
<!-- prettier-ignore-end -->

## 第 2 步：定位您的设计

使用画布工具定位和调整您的设计：

- **平移**：中键拖动，或按住 <kbd>space</kbd> 拖动
- **缩放**：滚轮，或 <kbd>ctrl+"+"</kbd> / <kbd>ctrl+"-"</kbd>
- **移动**：点击并拖动您的设计
- **旋转**：选择设计并使用旋转手柄
- **缩放**：选择设计并拖动角手柄

## 第 3 步：分配操作

操作定义 Rayforge 如何处理您的设计。常见操作包括：

- **轮廓切割**：沿形状轮廓切割
- **光栅雕刻**：用往返线条填充形状（用于雕刻）
- **深度雕刻**：从图像创建 3D 深度效果

### 添加操作

1. 在画布上选择您的设计
2. 点击 **操作 → 添加操作** 或按 <kbd>ctrl+shift+a</kbd>
3. 选择操作类型（例如，"轮廓切割" 用于切割）
4. 配置操作设置：
   - **功率**：激光功率百分比（从低开始并测试！）
   - **速度**：移动速度，单位 mm/min
   - **次数**：重复操作的次数（适用于切割厚材料）

操作设置

<!-- prettier-ignore-start -->
:::warning[从低功率开始]
处理新材料时，始终从较低的功率设置开始并运行测试切割。逐渐增加功率，直到达到预期效果。使用[材料测试网格](../features/operations/material-test-grid.md)功能系统地找到最佳设置。
:::
<!-- prettier-ignore-end -->

## 第 4 步：预览

在发送到机器之前，在 3D 中预览刀具路径：

1. 点击 **视图 → 3D 预览** 或按 <kbd>F12</kbd>
2. 3D 预览窗口显示完整的刀具路径
3. 使用鼠标旋转和缩放预览
4. 验证路径看起来正确

3D 预览

<!-- prettier-ignore-start -->
:::tip[尽早发现错误]
3D 预览可帮助您发现问题，例如：

- 缺失路径
- 顺序错误
- 操作应用于错误的对象
- 超出工作区域的路径
:::
<!-- prettier-ignore-end -->

## 第 5 步：发送到机器

<!-- prettier-ignore-start -->
:::danger[安全第一]
- 确保工作区域清空
- 操作期间切勿离开机器
- 附近备有消防安全设备
- 佩戴适当的护目镜
:::
<!-- prettier-ignore-end -->

### 准备材料

1. 将材料放在激光床上
2. 根据机器说明聚焦激光
3. 使用[工件定位指南](../features/workpiece-positioning.md)中的方法之一定位您的设计

### 开始任务

1. **定位激光**：使用点动控制将激光移动到起始位置。点击 **视图 → 控制面板** 或按
   <kbd>ctrl+l</kbd>，然后使用箭头按钮或键盘箭头移动激光。

2. **框选设计**：运行框选功能以验证位置。点击
   **机器 → 框选**，激光将以低功率描绘设计边界框。验证它在材料范围内。

3. **开始任务**：点击 **机器 → 开始任务**
4. 在状态栏中监控进度

### 任务执行期间

状态栏右侧显示当前进度和总执行时间估计。使用控制面板中的暂停和停止按钮来控制任务。注意
<kbd>esc</kbd> 退出模拟模式，但不会停止活动任务。

## 第 6 步：完成

任务完成后：

1. 等待排风扇清除烟雾
2. 小心取出完成的作品
3. 如有必要，清洁激光床

<!-- prettier-ignore-start -->
:::success[恭喜！]
您已完成第一个 Rayforge 任务！现在您可以探索更多高级功能。
:::
<!-- prettier-ignore-end -->

## 下一步

现在您已完成第一个任务，探索这些功能：

- **[工件定位](../features/workpiece-positioning.md)**：掌握所有定位方法（对焦模式、边框预览、WCS、相机）
- **[多层操作](../features/multi-layer.md)**：为图层分配不同操作
- **[固定标签](../features/holding-tabs.md)**：在切割期间保持切割件固定
- **[相机集成](../machine/camera.md)**：使用相机进行精确对齐
- **[钩子和宏](../machine/hooks-macros.md)**：自动化重复任务

## 成功提示

1. **保存工作**：使用 <kbd>ctrl+s</kbd> 经常保存项目
2. **测试切割**：始终先在废料上运行测试切割
3. **材料数据库**：记录不同材料的成功功率/速度设置
4. **维护**：保持激光透镜清洁，定期检查皮带张力
5. **空气辅助**：如果您的机器有空气辅助，使用它以防止烧焦并提高切割质量

---

**需要帮助？** 查看[故障排除](../troubleshooting/connection.md)部分或访问
[GitHub Issues](https://github.com/barebaric/rayforge/issues) 页面。
