barebaric/rayforge/website/i18n/de/docusaurus-plugin-content-docs/current/getting-started/installation.mdx

# Installation

import InstallGuide from '@site/src/components/InstallGuide';
import InstallAnchors from '@site/src/components/InstallAnchors';

Rayforge ist für Linux, Windows und macOS verfügbar. Wähle deine Plattform unten
und folge den Installationsanweisungen.

<InstallAnchors />

<InstallGuide />

---

## Systemanforderungen

| Ressource | Installiert | Empfohlen |
|---|---|---|
| Speicherplatz | < 1 GB | Je nach Projekt |
| Arbeitsspeicher | 1 GB | Je nach Projekt |

Der tatsächliche Speicherplatz- und Arbeitsspeicherbedarf hängt von der Projektkomplexität ab.
Einfache Projekte benötigen kaum mehr als die Installationsgröße, während komplexe Projekte
leicht 10 GB RAM oder mehr verbrauchen und erheblichen zusätzlichen Speicherplatz
erfordern können.

## Nächste Schritte

Nachdem Rayforge installiert ist, fahre mit
[Ersteinrichtung](first-time-setup) fort, um deine Maschine zu konfigurieren.
