barebaric/rayforge/website/i18n/es/docusaurus-plugin-content-docs/current/getting-started/installation.mdx

# Instalación

import InstallGuide from '@site/src/components/InstallGuide';
import InstallAnchors from '@site/src/components/InstallAnchors';

Rayforge está disponible para Linux, Windows y macOS. Elige tu plataforma a continuación
y sigue las instrucciones de instalación.

<InstallAnchors />

<InstallGuide />

---

## Requisitos del Sistema

| Recurso | Instalado  | Recomendado |
|---|---|---|
| Espacio en disco | < 1 GB | Varía según el proyecto |
| RAM | 1 GB | Varía según el proyecto |

Los requisitos reales de disco y memoria dependen de la complejidad del proyecto.
Los proyectos simples pueden necesitar poco más de lo instalado, mientras que los
proyectos complejos pueden consumir fácilmente 10 GB de RAM o más y requerir un
espacio en disco adicional significativo.

## Siguientes Pasos

Ahora que Rayforge está instalado, continúa con
[Configuración Inicial](first-time-setup) para configurar tu máquina.
