barebaric/rayforge/website/i18n/fr/docusaurus-plugin-content-docs/current/getting-started/installation.mdx

# Installation

import InstallGuide from '@site/src/components/InstallGuide';
import InstallAnchors from '@site/src/components/InstallAnchors';

Rayforge est disponible pour Linux, Windows et macOS. Choisissez votre plateforme ci-dessous
et suivez les instructions d'installation.

<InstallAnchors />

<InstallGuide />

---

## Configuration Système Requise

| Ressource | Installé | Recommandé |
|---|---|---|
| Espace disque | < 1 Go | Variable selon le projet |
| Mémoire RAM | 1 Go | Variable selon le projet |

Les besoins réels en disque et en mémoire dépendent de la complexité du projet.
Les projets simples peuvent nécessiter peu de ressources au-delà de l'installation,
tandis que les projets complexes peuvent facilement consommer 10 Go de RAM ou plus
et nécessiter un espace disque supplémentaire important.

## Prochaines Étapes

Maintenant que Rayforge est installé, passez à la
[Configuration Initiale](first-time-setup) pour configurer votre machine.
