barebaric/rayforge/website/i18n/uk/docusaurus-plugin-content-docs/current/getting-started/installation.mdx

# Встановлення

import InstallGuide from '@site/src/components/InstallGuide';
import InstallAnchors from '@site/src/components/InstallAnchors';

Rayforge доступний для Linux, Windows та macOS. Виберіть свою платформу нижче
та дотримуйтесь інструкцій з встановлення.

<InstallAnchors />

<InstallGuide />

---

## Системні вимоги

| Ресурс | Встановлено | Рекомендовано |
|---|---|---|
| Дисковий простір | < 1 ГБ | Залежить від проекту |
| Оперативна пам'ять  | 1 ГБ | Залежить від проекту |

Фактичні вимоги до диска та пам'яті залежать від складності проекту. Прості проекти
можуть потребувати небагато більше встановленого обсягу, тоді як складні проекти можуть
легко спожити 10 ГБ оперативної пам'яті або більше та вимагати значного додаткового
дискового простору.

## Наступні кроки

Тепер, коли Rayforge встановлено, перейдіть до
[Першого налаштування](first-time-setup), щоб налаштувати вашу машину.
