barebaric/rayforge/website/i18n/zh-CN/docusaurus-plugin-content-docs/current/getting-started/installation.mdx

# 安装

import InstallGuide from '@site/src/components/InstallGuide';
import InstallAnchors from '@site/src/components/InstallAnchors';

Rayforge 适用于 Linux、Windows 和 macOS。选择您的平台并按照安装说明操作。

<InstallAnchors />

<InstallGuide />

---

## 系统要求

| 资源 | 安装占用 | 推荐 |
|---|---|---|
| 磁盘空间 | < 1 GB | 因项目而异 |
| 内存 | 1 GB | 因项目而异 |

实际的磁盘和内存需求取决于项目的复杂度。简单项目可能只需要很少的额外资源，而复杂项目可能轻松消耗 10 GB 或更多内存，并需要大量额外的磁盘空间。

## 下一步

现在 Rayforge 已安装完成，请继续[首次设置](first-time-setup)以配置您的机器。
