barebaric/rayforge/website/i18n/fr/docusaurus-plugin-content-docs/current/features/operations/contour.md

# Coupe de Contour

La coupe de contour trace le contour des formes vectorielles pour les couper librement du matériau.
C'est l'opération laser la plus courante pour créer des pièces, des enseignes et des pièces
décoratives.

## Aperçu

Les opérations de contour :

- Suivent les parcours vectoriels (lignes, courbes, formes)
- Coupent le long du périmètre des objets
- Supportent des passes uniques ou multiples pour les matériaux épais
- Peuvent utiliser des parcours de coupe intérieur, extérieur ou sur la ligne
- Fonctionnent avec toute forme vectorielle fermée ou ouverte

## Quand Utiliser le Contour

Utilisez la coupe de contour pour :

- Couper des pièces libres du matériau de stock
- Créer des contours et bordures
- Couper des formes dans le bois, l'acrylique, le carton
- Percer ou marquer (avec puissance réduite)
- Créer des pochoirs et modèles

**N'utilisez pas le contour pour :**

- Remplir des zones (utilisez [Gravure](engrave) à la place)
- Les images bitmap (convertissez-les d'abord en vecteurs)

## Créer une Opération de Contour

### Étape 1 : Sélectionner les Objets

1. Importez ou dessinez des formes vectorielles sur le canevas
2. Sélectionnez les objets que vous voulez couper
3. Assurez-vous que les formes sont des parcours fermés pour des coupes complètes

### Étape 2 : Ajouter une Opération de Contour

- **Menu :** Opérations → Ajouter Contour
- **Raccourci :** <kbd>ctrl+shift+c</kbd>
- **Clic droit :** Menu contextuel → Ajouter Opération → Contour

### Étape 3 : Configurer les Paramètres

Paramètres d'étape de contour

## Paramètres Clés

La boîte de dialogue des paramètres d'étape comporte quatre onglets : **Paramètres d'étape**,
**Laser**, **Post-Traitement** et **Pièces**. Les paramètres sont décrits ci-dessous dans l'ordre
des onglets.

### Paramètres de Contour

Paramètres d'étape de contour

Le groupe **Paramètres de Contour** de l'onglet _Paramètres d'étape_ contrôle la façon dont le
contour est tracé.

#### Côté de Coupe et Décalage de Parcours

Contrôle où le laser coupe par rapport au parcours vectoriel :

| Décalage | Description | Utilisation |
| --- | --- | --- |
| **Sur la Ligne** | Coupe directement sur le parcours | Coupes sur la ligne centrale, marquage |
| **Intérieur** | Coupe à l'intérieur de la forme | Pièces qui doivent correspondre à une taille exacte |
| **Extérieur** | Coupe à l'extérieur de la forme | Trous dans lesquels les pièces s'insèrent |

**Distance de Décalage :**

- Jusqu'où décaler vers l'intérieur/extérieur (mm)
- Typiquement défini à la moitié de votre largeur de kerf
- Kerf = largeur du matériau retiré par le laser
- Exemple : décalage de 0.15mm pour un kerf de 0.3mm

#### Ordre de Coupe

Contrôle l'ordre dans lequel les parcours imbriqués sont traités :

**Intérieur-Extérieur :**

- Coupe d'abord les caractéristiques intérieures, puis travaille vers l'extérieur
- Maintient les parties extérieures du matériau intactes le plus longtemps

**Extérieur-Intérieur :**

- Coupe d'abord le périmètre extérieur, puis se déplace vers l'intérieur
- Maintient la pièce fixée au stock le plus longtemps

**Recommandé :** Intérieur-Extérieur (défaut)

#### Supprimer les Parcours Intérieurs

Pour les designs comportant des trous ou des découpes internes, vous pouvez choisir de tracer
uniquement la limite la plus extérieure :

- **Supprimer les Parcours Intérieurs :** lorsqu'il est activé, seul le contour le plus extérieur
  est tracé
- Les trous internes et les découpes sont ignorés

Ceci est utile lorsque vous voulez découper une forme tout en préservant l'intérieur, comme pour
créer un cadre ou un contour sans couper les détails internes.

#### Surcoupe

Prolonge les parcours de coupe fermés au-delà de leur point de départ pour que le faisceau laser
chevauche le début de la coupe :

**Surcoupe :**

- Distance en unités machine pour prolonger la coupe au-delà de la jonction début/fin
- Définissez à **0** pour désactiver (défaut)
- Valeurs typiques : 1–5 pour la plupart des matériaux
- Maximum : 100

**Pourquoi utiliser la surcoupe :**

Au début et à la fin d'un contour fermé, le laser peut ne pas pénétrer complètement en raison de
l'accélération et de la décélération. La surcoupe garantit que le faisceau se chevauche à la
jonction, créant une coupe nette et complètement sectionnée. Ceci est particulièrement utile pour :

- Les matériaux épais où la pénétration complète est marginale
- Les coupes à grande vitesse où les effets d'accélération sont plus prononcés
- Les pièces qui doivent tomber sans post-traitement

La surcoupe s'applique à la fois aux contours extérieurs et aux trous internes.

<!-- prettier-ignore-start -->
:::tip[Entrée/Sortie vs Surcoupe]
[L'entrée/sortie](../lead-in-out.md) ajoute des mouvements
d'approche et de sortie à puissance nulle avant et après le parcours de coupe. La surcoupe prolonge
le parcours de coupe lui-même au-delà de la jonction. Ils peuvent être utilisés ensemble pour une
qualité de coupe optimale.
:::
<!-- prettier-ignore-end -->

#### Retraçage avec Seuil Personnalisé

Lorsque vous travaillez avec des images bitmap converties en vecteurs, vous pouvez contrôler quelles
parties sont tracées :

- **Rescan du contenu :** Active un seuil de luminosité personnalisé pour le traçage
- **Seuil de traçage (0.0-1.0) :** Valeur de coupure de luminosité lorsque le rescan est activé
  - Les valeurs plus basses ne tracent que les zones plus sombres
  - Les valeurs plus élevées incluent les zones plus claires

Ceci est utile lorsque le traçage par défaut ne capture pas le niveau de détail dont vous avez
besoin.

### Paramètres Laser

Paramètres laser

La puissance, la vitesse et la sélection de la tête laser se trouvent sur la page **Laser** de la
boîte de dialogue des paramètres d'étape.

#### Puissance & Vitesse

**Puissance (%) :**

- Intensité laser de 0-100%
- Puissance plus élevée pour les matériaux plus épais
- Puissance plus basse pour le marquage

**Vitesse (mm/min) :**

- À quelle vitesse le laser se déplace
- Plus lent = plus d'énergie = coupe plus profonde
- Plus rapide = moins d'énergie = coupe plus légère

#### Mode de Puissance

Le réglage du Mode de Puissance contrôle comment la puissance laser est émise pendant les mouvements
:

| Mode | G-code | Comportement |
| --- | --- | --- |
| **Dynamique (M4)** | `M4` | Ajuste la puissance à la vitesse de déplacement (défaut) |
| **Constant (M3)**  | `M3` | Maintient la puissance fixe quelle que soit la vitesse |

La puissance dynamique réduit la puissance lorsque la tête ralentit dans un virage, ce qui protège
le matériau, mais sur certaines machines elle laisse les coins et les courbes serrées visiblement
sous-brûlés. Passe en **Constant (M3)** si les coins et les courves brûlent trop faiblement.

#### Compensation de Kerf

Le kerf est la largeur du matériau retiré par le faisceau laser :

**Pourquoi c'est important :**

- Un cercle coupé « sur la ligne » sera légèrement plus petit que prévu
- Le laser retire ~0.2-0.4mm de matériau (selon la largeur du faisceau)

**Comment compenser :**

1. Mesurez votre kerf sur des coupes de test
2. Utilisez un décalage de parcours = kerf/2
3. Pour les pièces : décalez **vers l'intérieur** de kerf/2
4. Pour les trous : décalez **vers l'extérieur** de kerf/2

Voir [Kerf](../kerf.md) pour un guide détaillé.

## Post-Traitement

Paramètres de post-traitement du contour

Les opérations de contour supportent plusieurs options de post-traitement :

- **[Lissage de Parcours](../smooth.md)** - Réduire les bords irréguliers dans les parcours de coupe
- **[Ponts de Maintien](../holding-tabs.md)** - Maintenir les pièces coupées attachées au matériau
  de stock
- **[Rognage au Stock](../crop-to-stock.md)** - Limiter les coupes à la limite du matériau
- **[Optimisation de Parcours](../path-optimization.md)** - Réduire la distance de déplacement entre
  les coupes
- **[Passe Multiple](../multi-pass.md)** - Répéter les coupes pour les matériaux épais
- **[Entrée/Sortie](../lead-in-out.md)** - Ajouter des mouvements d'approche et de sortie à
  puissance nulle pour des extrémités de coupe plus propres

### Coupe Multi-Passes

Pour les matériaux plus épais qu'une seule passe ne peut couper :

**Passes :**

- Nombre de fois pour répéter la coupe
- Chaque passe coupe plus profond

**Profondeur de Passe (Z-step) :**

- De combien abaisser l'axe Z par passe (si supporté)
- Nécessite le contrôle de l'axe Z sur votre machine
- Crée une véritable coupe 2.5D
- Définissez à 0 pour des passes multiples à la même profondeur

<!-- prettier-ignore-start -->
:::warning[Axe Z Requis]
La profondeur de passe ne fonctionne que si votre machine dispose d'un contrôle de l'axe Z. Pour les
machines sans axe Z, utilisez des passes multiples à la même profondeur.
:::
<!-- prettier-ignore-end -->

## Conseils & Meilleures Pratiques

### Test de Matériau

**Testez toujours d'abord :**

1. Coupez de petites formes de test sur du rebut
2. Commencez avec des paramètres conservateurs (puissance plus basse, vitesse plus lente)
3. Augmentez progressivement la puissance ou diminuez la vitesse
4. Enregistrez les paramètres réussis

### Ordre de Coupe

**Meilleures pratiques :**

- Gravez avant de couper (garde le matériau sécurisé)
- Coupez les caractéristiques intérieures avant le périmètre extérieur
- Utilisez des ponts de maintien pour les pièces qui pourraient bouger
- Coupez les plus petites pièces d'abord (moins de vibrations)

## Dépannage

### Les coupes ne traversent pas le matériau

- **Augmentez :** Le paramètre de puissance
- **Diminuez :** Le paramètre de vitesse
- **Ajoutez :** Plus de passes
- **Vérifiez :** La mise au point est correcte
- **Vérifiez :** Le faisceau est propre (lentille sale)

### Brunissage ou brûlure excessifs

- **Diminuez :** Le paramètre de puissance
- **Augmentez :** Le paramètre de vitesse
- **Utilisez :** L'assistance air
- **Essayez :** Des passes multiples plus rapides au lieu d'une seule lente
- **Vérifiez :** Le matériau est approprié pour la découpe laser

### Les pièces tombent pendant la coupe

- **Ajoutez :** [Ponts de maintien](../holding-tabs.md)
- **Utilisez :** L'optimisation de l'ordre de coupe
- **Coupez :** Les caractéristiques intérieures avant l'extérieur
- **Assurez-vous :** Le matériau est plat et sécurisé

### Profondeur de coupe incohérente

- **Vérifiez :** L'épaisseur du matériau est uniforme
- **Vérifiez :** Le matériau est plat (pas gondolé)
- **Vérifiez :** La distance de mise au point est cohérente
- **Vérifiez :** La puissance laser est stable

### Coins ou courbes manqués

- **Diminuez :** La vitesse (surtout sur les coins)
- **Vérifiez :** Les paramètres d'accélération de la machine
- **Vérifiez :** Les courroies sont tendues
- **Réduisez :** La complexité du parcours (simplifiez les courbes)

## Détails Techniques

### Système de Coordonnées

Les opérations de contour fonctionnent en :

- **Unités :** Millimètres (mm)
- **Origine :** Dépend de la configuration de la machine et du travail
- **Coordonnées :** Plan X/Y (Z pour la profondeur multi-passe)

### Génération de Parcours

Rayforge convertit les formes vectorielles en G-code :

1. Décalage du parcours (si coupe intérieur/extérieur)
2. Optimisation de l'ordre du parcours (minimiser le déplacement)
3. Ajout des ponts de maintien (si configurés)
4. Génération des commandes G-code

### Commandes G-code

G-code de contour typique :

```gcode
G0 X10 Y10          ; Déplacement rapide au départ
M3 S204             ; Laser activé à 80% puissance
G1 X50 Y10 F500     ; Coupe vers le point à 500 mm/min
G1 X50 Y50 F500     ; Coupe vers le point suivant
G1 X10 Y50 F500     ; Continue la coupe
G1 X10 Y10 F500     ; Complète le carré
M5                  ; Laser éteint
```

## Sujets Connexes

- **[Gravure](engrave)** - Remplir des zones avec des motifs de gravure
- **[Ponts de Maintien](../holding-tabs.md)** - Maintenir les pièces sécurisées pendant la coupe
- **[Kerf](../kerf.md)** - Améliorer la précision de coupe
- **[Grille de Test de Matériau](material-test-grid)** - Trouver les paramètres puissance/vitesse
  optimaux
