barebaric/rayforge/website/i18n/hi/docusaurus-plugin-content-docs/current/features/operations/shrink-wrap.md

---
description:
  "श्रिंक-रैप ऑपरेशन उत्कीर्णन को आपके डिज़ाइन की सटीक आकृति में स्वतः फ़िट करते हैं. वेक्टर आउटलाइन
  के भीतर उत्कीर्णन के लिए आदर्श."
---

# श्रिंक रैप

श्रिंक रैप एक ऐसी सीमा जनरेट करके कई ऑब्जेक्टों के चारों ओर एक कुशल कटिंग पाथ बनाता है जो उनके
"चारों ओर सिकुड़ती" है. न्यूनतम बर्बादी के साथ शीट से कई पार्ट काटने के लिए उपयोगी है.

## अवलोकन

श्रिंक रैप ऑपरेशन:

- ऑब्जेक्ट समूहों के चारों ओर सीमा पाथ बनाते हैं
- सामग्री बर्बादी न्यूनतम करते हैं
- पाथ जोड़कर कटिंग समय घटाते हैं
- क्लीयरेंस के लिए ऑफ़सेट दूरियों का समर्थन करते हैं
- वेक्टर आकृतियों के किसी भी संयोजन के साथ काम करते हैं

## कब श्रिंक रैप उपयोग करें

श्रिंक रैप का उपयोग करें:

- शीट से कई छोटे पार्ट काटने के लिए
- सामग्री बर्बादी न्यूनतम करने के लिए
- कुशल नेस्टिंग सीमाएँ बनाने के लिए
- पार्ट समूहों को अलग करने के लिए
- कुल कटिंग समय घटाने के लिए

**श्रिंक रैप का उपयोग इनके लिए न करें:**

- एकल ऑब्जेक्टों के लिए (इसके बजाय [कॉन्टूर](contour) उपयोग करें)
- जिन पार्टों को व्यक्तिगत सीमाएँ चाहिए
- सटीक आयताकार कटों के लिए

## श्रिंक रैप कैसे काम करता है

श्रिंक रैप एक कम्प्यूटेशनल ज्यामिति एल्गोरिदम का उपयोग करके एक सीमा बनाता है:

1. सभी ऑब्जेक्टों के चारों ओर एक उत्तल हल के साथ **शुरू** करें
2. सीमा को ऑब्जेक्टों की ओर भीतर **सिकोड़ें**
3. ऑब्जेक्ट समूह के चारों ओर कसकर **लपेटें**
4. निर्दिष्ट दूरी से बाहर की ओर **ऑफ़सेट** करें

परिणाम एक कुशल कटिंग पाथ है जो क्लीयरेंस बनाए रखते हुए आपके पार्टों के समग्र आकार का पालन करता है.

## श्रिंक रैप ऑपरेशन बनाना

### चरण 1: ऑब्जेक्ट व्यवस्थित करें

1. जिन सभी पार्टों को लपेटना है उन्हें कैनवस पर रखें
2. वांछित स्पेसिंग के साथ उन्हें स्थित करें
3. कई अलग समूह एक साथ श्रिंक-रैप किए जा सकते हैं

### चरण 2: ऑब्जेक्ट चुनें

1. श्रिंक रैप में शामिल करने के लिए सभी ऑब्जेक्ट चुनें
2. भिन्न आकृतियाँ, आकार, और प्रकार हो सकते हैं
3. सभी चयनित ऑब्जेक्ट एक साथ लपेटे जाएँगे

### चरण 3: श्रिंक रैप ऑपरेशन जोड़ें

- **मेनू:** Operations Add Shrink Wrap
- **राइट-क्लिक:** संदर्भ मेनू Add Operation Shrink Wrap

### चरण 4: सेटिंग्स कॉन्फ़िगर करें

## मुख्य सेटिंग्स

स्टेप सेटिंग्स संवाद में तीन टैब हैं: **Step Settings**, **Laser**, और **Post Processing**. सेटिंग्स
नीचे टैब क्रम में वर्णित हैं.

### श्रिंक रैप

श्रिंक रैप स्टेप सेटिंग्स

_Step Settings_ टैब का **श्रिंक रैप** समूह नियंत्रित करता है कि हल सामग्री के चारों ओर कैसे फ़िट
होता है.

#### चिकनापन

नियंत्रित करता है कि सीमा ऑब्जेक्ट आकृतियों का कितनी निकटता से पालन करती है:

**अधिक चिकनापन:**

- ऑब्जेक्टों का अधिक निकटता से पालन करता है
- अधिक जटिल पाथ
- लंबा कटिंग समय
- कम सामग्री बर्बादी

**कम चिकनापन:**

- सरल, अधिक गोल पाथ
- छोटा कटिंग समय
- थोड़ी अधिक सामग्री बर्बादी

**अनुशंसित:** अधिकांश स्थितियों के लिए मध्यम चिकनापन

#### कट पक्ष

नियंत्रित करता है कि लेज़र श्रिंक-रैप पाथ के सापेक्ष कहाँ काटता है:

| कट पक्ष | विवरण | उपयोग के लिए |
| --- | --- | --- |
| **केंद्र रेखा** | सीधे पाथ पर काटता है  | मानक कटिंग |
| **बाहर** | सीमा के बाहर काटता है | कट थोड़ा बड़ा बनाने के लिए |
| **भीतर** | सीमा के भीतर काटता है | कट थोड़ा छोटा बनाने के लिए |

#### ऑफ़सेट दूरी

**ऑफ़सेट (mm):**

- पार्टों के चारों ओर कितनी क्लीयरेंस
- ऑब्जेक्टों से श्रिंक-रैप सीमा तक की दूरी
- बड़ा ऑफ़सेट = पार्टों के चारों ओर अधिक सामग्री बची

**सामान्य मान:**

- **2-3mm:** तंग रैप, न्यूनतम बर्बादी
- **5mm:** सुखद क्लीयरेंस
- **10mm+:** संभालने के लिए अतिरिक्त सामग्री

**ऑफ़सेट क्यों मायने रखता है:**

- बहुत छोटा: पार्टों में कटने का जोखिम
- बहुत बड़ा: सामग्री बर्बाद करता है
- विचार करें: कर्फ़ चौड़ाई, कटिंग सटीकता

### लेज़र सेटिंग्स

लेज़र सेटिंग्स

शक्ति, गति, और लेज़र हेड चयन स्टेप सेटिंग्स संवाद के **Laser** पृष्ठ पर रहते हैं.

अन्य कटिंग ऑपरेशनों की तरह:

**शक्ति (%):**

- कटिंग के लिए लेज़र तीव्रता
- वही जो आप [कॉन्टूर](contour) कटिंग के लिए उपयोग करते

**गति (mm/min):**

- लेज़र कितनी तेज़ चलता है
- अपनी सामग्री की कटिंग गति से मेल खाएँ

सीमा को एक से अधिक बार काटने के लिए, एक [मल्टी-पास](../multi-pass.md) पोस्ट-प्रोसेसर जोड़ें.

## उपयोग के प्रसंग

### बैच पार्ट उत्पादन

**प्रसंग:** एक बड़ी शीट से 20 छोटे पार्ट काटना

**श्रिंक रैप के बिना:**

- पूरी शीट सीमा काटें
- पार्टों के चारों ओर की सारी सामग्री बर्बाद करें
- लंबा कटिंग समय

**श्रिंक रैप के साथ:**

- पार्ट समूह के चारों ओर तंग सीमा काटें
- अन्य परियोजनाओं के लिए सामग्री बचाएँ
- तेज़ कटिंग (छोटी परिधि)

### नेस्टिंग अनुकूलन

**वर्कफ़्लो:**

1. पार्ट शीट पर कुशलता से नेस्ट करें
2. पार्ट खंडों में समूहित करें
3. प्रत्येक खंड श्रिंक रैप करें
4. खंड अलग-अलग काटें

**लाभ:**

- जारी रखते हुए पूरे हुए खंड हटा सकते हैं
- कटे हुए पार्ट संभालना आसान
- पार्ट खिसकने का कम जोखिम

### सामग्री संरक्षण

**उदाहरण:** महँगी सामग्री पर छोटे पार्ट

**प्रक्रिया:**

1. पार्ट कसकर व्यवस्थित करें
2. 3mm ऑफ़सेट के साथ श्रिंक रैप करें
3. शीट से स्वतंत्र काटें
4. शेष सामग्री बचाएँ

**परिणाम:** अधिकतम सामग्री दक्षता

## अन्य ऑपरेशनों के साथ संयोजन

### श्रिंक रैप + कॉन्टूर

सामान्य वर्कफ़्लो:

1. व्यक्तिगत पार्टों पर **कॉन्टूर** ऑपरेशन (विवरण काटें)
2. समूह के चारों ओर **श्रिंक रैप** (शीट से स्वतंत्र काटें)

**निष्पादन क्रम:**

- पहले: पार्टों में विवरण काटें (बंधे होने पर)
- अंत में: श्रिंक रैप समूह को स्वतंत्र काट देता है

विवरण के लिए [मल्टी-लेयर वर्कफ़्लो](../multi-layer.md) देखें.

### श्रिंक रैप + रास्टर

**उदाहरण:** उत्कीर्णित और कटे हुए पार्ट

1. पार्टों पर लोगो **रास्टर** उत्कीर्णित करें
2. पार्ट आउटलाइन **कॉन्टूर** काटें
3. पूरे समूह के चारों ओर **श्रिंक रैप**

**लाभ:**

- सारा उत्कीर्णन तब होता है जब सामग्री बंधी होती है
- अंतिम श्रिंक रैप पूरा बैच स्वतंत्र काट देता है

## पोस्ट-प्रोसेसिंग

श्रिंक रैप पोस्ट-प्रोसेसिंग सेटिंग्स

श्रिंक रैप ऑपरेशन कई पोस्ट-प्रोसेसिंग विकल्प समर्थन करते हैं:

- **[पाथ चिकना करें](../smooth.md)** - सीमा पाथ में खुरदरे किनारे घटाएँ
- **[होल्डिंग टैब](../holding-tabs.md)** - कटे हुए पार्टों को स्टॉक सामग्री से बंधा रखें
- **[स्टॉक पर क्रॉप करें](../crop-to-stock.md)** - कट सामग्री सीमा तक सीमित करें
- **[पाथ अनुकूलन](../path-optimization.md)** - ट्रैवल दूरी घटाएँ
- **[मल्टी-पास](../multi-pass.md)** - मोटी सामग्री के लिए कट दोहराएँ
- **[लीड-इन/आउट](../lead-in-out.md)** - साफ़ कट सिरों के लिए शून्य-शक्ति अप्रोच और एग्ज़िट गतियाँ
  जोड़ें

### पार्ट स्पेसिंग

**अनुकूल स्पेसिंग:**

- पार्टों के बीच 5-10mm
- श्रिंक रैप के लिए अलग ऑब्जेक्ट पहचानने के लिए पर्याप्त
- इतना अधिक नहीं कि सामग्री बर्बाद हो

**बहुत निकट:**

- पार्ट एक साथ लपेटे जा सकते हैं
- श्रिंक रैप अंतरालों पर पुल बना सकता है
- कटिंग के बाद अलग करना कठिन

**बहुत दूर:**

- सामग्री बर्बाद करता है
- लंबा कटिंग समय
- शीट का अकुशल उपयोग

### सामग्री विचार

**सर्वोत्तम के लिए:**

- उत्पादन रन (कई समान पार्ट)
- बड़ी शीटों से छोटे पार्ट
- महँगी सामग्रियाँ (बर्बादी न्यूनतम)
- बैच कटिंग जॉब

**आदर्श नहीं:**

- एकल बड़े पार्ट
- पूरी शीट भरने वाले पार्ट
- जब आपको पूरी शीट कट चाहिए

### सुरक्षा

**हमेशा:**

- जाँचें कि सीमा पार्टों के साथ ओवरलैप न करे
- सत्यापित करें कि ऑफ़सेट पर्याप्त है
- [3D पूर्वावलोकन](../../ui/3d-preview.md) में पूर्वावलोकन करें
- पहले स्क्रैप पर परीक्षण करें

**नज़र रखें:**

- श्रिंक रैप पार्टों में काट रहा हो (ऑफ़सेट बढ़ाएँ)
- श्रिंक रैप पूरा होने से पहले पार्ट खिसक रहे हों
- सामग्री टेढ़ी होकर पार्ट स्थिति से बाहर खींच रही हो

## उन्नत तकनीकें

### कई श्रिंक रैप

भिन्न समूहों के लिए अलग सीमाएँ बनाएँ:

**प्रक्रिया:**

1. पार्ट तार्किक समूहों में व्यवस्थित करें
2. समूह 1 श्रिंक रैप करें (ऊपरी पार्ट)
3. समूह 2 श्रिंक रैप करें (निचले पार्ट)
4. समूह अलग-अलग काटें

**लाभ:**

- जॉब के दौरान पूरे हुए समूह हटाएँ
- बेहतर संगठन
- पार्ट निकालना आसान

### नेस्टेड श्रिंक रैप

एक बड़ी सीमा के भीतर श्रिंक रैप:

**उदाहरण:**

1. भीतरी श्रिंक रैप: छोटे विस्तृत पार्ट
2. बाहरी श्रिंक रैप: बड़े पार्ट शामिल करता है
3. कॉन्टूर: पूरी शीट सीमा

**उपयोग के लिए:** जटिल बहु-पार्ट लेआउट

### क्लीयरेंस परीक्षण

उत्पादन रन से पहले:

1. श्रिंक रैप बनाएँ
2. [3D पूर्वावलोकन](../../ui/3d-preview.md) के साथ पूर्वावलोकन करें
3. सत्यापित करें कि क्लीयरेंस पर्याप्त है
4. जाँचें कि कोई पार्ट प्रतिच्छेदित नहीं है
5. स्क्रैप सामग्री पर परीक्षण करें

## समस्या निवारण

### श्रिंक रैप पार्टों में काटता है

- **बढ़ाएँ:** ऑफ़सेट दूरी
- **जाँचें:** पार्ट एक-दूसरे के बहुत निकट नहीं हैं
- **सत्यापित करें:** पूर्वावलोकन में श्रिंक रैप पाथ
- **गिनती करें:** कर्फ़ चौड़ाई (लेज़र बीम चौड़ाई)

### सीमा आकृतियों का पालन नहीं करती

- **बढ़ाएँ:** चिकनापन सेटिंग
- **जाँचें:** पार्ट ठीक से चयनित हैं
- **आज़माएँ:** छोटा ऑफ़सेट (बहुत दूर लपेट रहा हो सकता है)

### पार्ट एक साथ लपेटे जाते हैं

- **बढ़ाएँ:** पार्टों के बीच स्पेसिंग
- **जोड़ें:** व्यक्तिगत पार्टों के चारों ओर मैन्युअल कॉन्टूर
- **विभाजित करें:** कई श्रिंक रैप ऑपरेशनों में

### कटिंग में बहुत समय लगता है

- **घटाएँ:** चिकनापन (सरल पाथ)
- **बढ़ाएँ:** ऑफ़सेट (अधिक सीधी सीमाएँ)
- **विचार करें:** कई छोटे श्रिंक रैप

### कटिंग के दौरान पार्ट खिसकते हैं

- **जोड़ें:** पार्ट रोकने के लिए छोटे टैब ([होल्डिंग टैब](../holding-tabs.md) देखें)
- **उपयोग करें:** कटिंग क्रम: भीतर से बाहर
- **सुनिश्चित करें:** सामग्री समतल और बंधी है
- **जाँचें:** शीट टेढ़ी नहीं है

## तकनीकी विवरण

### एल्गोरिदम

श्रिंक रैप कम्प्यूटेशनल ज्यामिति उपयोग करता है:

1. **उत्तल हल** - बाहरी सीमा खोजें
2. **अल्फ़ा आकृति** - ऑब्जेक्टों की ओर सिकोड़ें
3. **ऑफ़सेट** - ऑफ़सेट दूरी से फैलाएँ
4. **सरल करें** - चिकनापन सेटिंग के आधार पर

### पाथ अनुकूलन

सीमा पाथ इनके लिए अनुकूलित है:

- न्यूनतम कुल लंबाई
- चिकने वक्र (चिकनापन पर आधारित)
- कुशल प्रारंभ/अंत बिंदु

### निर्देशांक प्रणाली

- **इकाइयाँ:** मिलीमीटर (mm)
- **परिशुद्धता:** 0.01mm सामान्य
- **निर्देशांक:** कार्यक्षेत्र जैसे ही

## संबंधित विषय

- **[कॉन्टूर कटिंग](contour)** - व्यक्तिगत ऑब्जेक्ट आउटलाइन काटना
- **[मल्टी-लेयर वर्कफ़्लो](../multi-layer.md)** - ऑपरेशन प्रभावी ढंग से जोड़ना
- **[होल्डिंग टैब](../holding-tabs.md)** - कटिंग के दौरान पार्ट सुरक्षित रखना
- **[3D पूर्वावलोकन](../../ui/3d-preview.md)** - कटिंग पाथ का पूर्वावलोकन
- **[सामग्री परीक्षण ग्रिड](material-test-grid)** - अनुकूल कटिंग सेटिंग्स खोजना
