barebaric/rayforge/website/i18n/hi/docusaurus-plugin-content-docs/current/features/operations/wavefront.md

---
description:
  "वेवफ़्रंट अनुकूली क्लीयरिंग पॉकेट क्षेत्रों को केंद्र से बाहर फैलते समकेंद्री टूलपाथ से भरती है.
  भराव घनत्व और सीमा क्लीयरेंस नियंत्रित करने के लिए स्टेप-ओवर और वॉल ऑफ़सेट कॉन्फ़िगर करें."
---

# वेवफ़्रंट

वेवफ़्रंट अनुकूली क्लीयरिंग बंद वेक्टर आकृतियों को समकेंद्री टूलपाथ से भरती है जो तालाब में लहरों की
तरह पॉकेट केंद्र से बाहर की ओर फैलती हैं. फैलते छल्ले भीतरी द्वीपों को स्वतः संभालते हैं और रास्टर
स्कैनिंग के नुकीले उलटफेरों के बिना चिकने, सतत टूलपाथ देते हैं.

## अवलोकन

पारंपरिक रास्टर उत्कीर्णन के विपरीत, जो समानांतर रेखाओं में इधर-उधर स्वीप करता है, वेवफ़्रंट
प्रत्येक पॉकेट के केंद्र से विकिरित होने वाले समकेंद्री पास जनरेट करता है. इससे एक समरूप, तरंग जैसी
फ़िनिश मिलती है जो उन अनुप्रयोगों के लिए उपयुक्त है जहाँ भराव पैटर्न स्वयं दृश्य परिणाम में योगदान
देता है.

वेवफ़्रंट ऑपरेशन:

- बंद वेक्टर आकृतियों (पॉकेट) को समकेंद्री पास से भरते हैं
- पॉकेट केंद्र से बाहर की ओर फैलते हैं
- भीतरी द्वीपों (पॉकेट के भीतर के छेद) के चारों ओर स्वतः मार्ग बनाते हैं
- दिशा उलटफेरों के बिना चिकने टूलपाथ देते हैं

## कब वेवफ़्रंट उपयोग करें

वेवफ़्रंट पॉकेट क्षेत्रों के लिए एक वैकल्पिक भराव पैटर्न है. इसके समकेंद्री छल्ले समानांतर रास्टर
रेखाओं से अधिक दृश्यात्मक रूप से सुखद हो सकते हैं, और फैलता पैटर्न वृत्तीय या प्राकृतिक आकृतियों को
स्वाभाविक रूप से पूरक होता है.

वेवफ़्रंट अनुकूली क्लीयरिंग का उपयोग करें:

- वेक्टर डिज़ाइनों में पॉकेट भरने के लिए
- मुहर और डाई निर्माण — वेवफ़्रंट पृष्ठभूमि पॉकेट साफ़ करता है जबकि उठी हुई सुविधाओं को भीतरी
  द्वीपों के रूप में सुरक्षित रखता है
- उन अनुप्रयोगों के लिए जहाँ भराव बनावट तैयार टुकड़े में दिखाई देती है

**वेवफ़्रंट का उपयोग इनके लिए न करें:**

- आउटलाइन पर काटने के लिए (इसके बजाय [कॉन्टूर](contour) उपयोग करें)
- बिटमैप छवियाँ भरने के लिए (इसके बजाय [उत्कीर्णन](engrave) उपयोग करें)
- पतली दीवार खंडों के लिए जहाँ कोई पॉकेट मौजूद नहीं

## वेवफ़्रंट ऑपरेशन बनाना

### चरण 1: ऑब्जेक्ट चुनें

1. कैनवस पर बंद वेक्टर आकृतियाँ आयात करें या बनाएँ
2. पॉकेट सीमा परिभाषित करने वाले ऑब्जेक्ट चुनें
3. सुनिश्चित करें कि आकृतियाँ बंद पाथ हैं

### चरण 2: वेवफ़्रंट ऑपरेशन जोड़ें

- **मेनू:** Operations → Add Wavefront
- **राइट-क्लिक:** संदर्भ मेनू → Add Operation → Wavefront

### चरण 3: सेटिंग्स कॉन्फ़िगर करें

अपनी सामग्री और वांछित फ़िनिश से मेल खाने के लिए स्टेप-ओवर और ऑफ़सेट समायोजित करें.

वेवफ़्रंट ऑपरेशन परिणाम

## मुख्य सेटिंग्स

स्टेप सेटिंग्स संवाद में तीन टैब हैं: **Step Settings**, **Laser**, और **Post Processing**. सेटिंग्स
नीचे टैब क्रम में वर्णित हैं.

### वेवफ़्रंट सेटिंग्स

वेवफ़्रंट स्टेप सेटिंग्स

_Step Settings_ टैब का **वेवफ़्रंट** समूह भराव पैटर्न नियंत्रित करता है.

#### स्टेप ओवर

क्रमिक वेवफ़्रंट पासों के बीच की दूरी (mm). छोटे मान अधिक पासों और लंबे जॉब समय के साथ घने कवरेज
देते हैं. बड़े मान पासों को दूर रखते हैं ताकि जल्दी पूरा हो.

**स्टेप ओवर डिफ़ॉल्ट रूप से लेज़र स्पॉट आकार होता है** और उसकी सीमा 0.05–50.0 mm है.

| स्टेप ओवर | रेखा घनत्व | जॉब समय |
| --- | --- | --- |
| 0.1 mm | घना, कई रेखाएँ  | सबसे धीमा |
| 0.3 mm | मध्यम | मध्यम |
| 1.0 mm+ | विरल, कम रेखाएँ | तेज़ |

अधिकांश अनुप्रयोगों के लिए सामान्य मान 0.1–0.5 mm हैं.

#### ऑफ़सेट

पॉकेट दीवार से अतिरिक्त क्लीयरेंस (mm). सबसे बाहरी वेवफ़्रंट पास और सीमा कॉन्टूर के बीच एक मार्जिन
बनाता है. यह तब उपयोगी है जब एक अलग [कॉन्टूर](contour) पास किनारा पूरा करेगा, या जब आप पॉकेट के
चारों ओर एक जानबूझकर बॉर्डर छोड़ना चाहते हों.

सीमा: 0.0–20.0 mm. डिफ़ॉल्ट 0.0 है (वेवफ़्रंट पास सीमा तक फैलते हैं).

### लेज़र सेटिंग्स

लेज़र सेटिंग्स

शक्ति, गति, और लेज़र हेड चयन स्टेप सेटिंग्स संवाद के **Laser** पृष्ठ पर रहते हैं.

**शक्ति (%):**

- कटिंग के लिए लेज़र तीव्रता
- अपनी सामग्री की कटिंग आवश्यकताओं से मेल खाएँ

**गति (mm/min):**

- लेज़र कितनी तेज़ चलता है
- अपनी सामग्री की कटिंग गति से मेल खाएँ

## वेवफ़्रंट कैसे काम करता है

1. **प्रवेश पास** — एक शीर्षाकार प्रवेश पॉकेट के केंद्र में उतरता है ताकि एक प्रारंभिक साफ़ क्षेत्र
   बने
2. **वेवफ़्रंट विस्तार** — साफ़ किए गए केंद्र से शुरू, समकेंद्री छल्ले बाहर की ओर फैलते हैं.
   प्रत्येक छल्ला पिछले से कॉन्फ़िगर की गई स्टेप-ओवर दूरी आगे निकलता है
3. **द्वीप प्रबंधन** — जैसे-जैसे वेवफ़्रंट बड़ा होता है, वह किसी भी भीतरी द्वीप से मिलता है और उनके
   चारों ओर मार्ग बनाता है, उन्हें खड़ा छोड़ देता है
4. **पूर्णता** — पूरा पॉकेट क्षेत्र कवर होने तक विस्तार जारी रहता है

## पोस्ट-प्रोसेसिंग

वेवफ़्रंट पोस्ट-प्रोसेसिंग सेटिंग्स

वेवफ़्रंट ऑपरेशन समर्थन करते हैं:

- **[पाथ चिकना करें](../smooth.md)** — टूलपाथ में खुरदरे किनारे घटाएँ
- **[पाथ अनुकूलन](../path-optimization.md)** — पासों के बीच ट्रैवल दूरी न्यूनतम करें

## सुझाव और सर्वोत्तम प्रथाएँ

### स्टेप ओवर चुनना

- घना कवरेज (छोटा स्टेप-ओवर) का अर्थ है अधिक पास और लंबा जॉब समय
- विरल कवरेज (बड़ा स्टेप-ओवर) तेज़ है लेकिन पासों के बीच अधिक सामग्री छोड़ता है
- अपने अनुप्रयोग के लिए घनत्व को जॉब समय के साथ संतुलित करें

### मुहर और डाई निर्माण

वेवफ़्रंट मुहर बनाने के लिए अच्छी तरह उपयुक्त है. फैलते समकेंद्री छल्ले स्वाभाविक रूप से पृष्ठभूमि
पॉकेट साफ़ करते हैं जबकि भीतरी द्वीपों के रूप में मानी गई उठी हुई सुविधाओं के चारों ओर नेविगेट करते
हैं.

### कॉन्टूर के साथ संयोजन

एक सामान्य वर्कफ़्लो है पॉकेट भीतर को वेवफ़्रंट से साफ़ करना, फिर साफ़ किनारे के लिए
[कॉन्टूर](contour) पास से सीमा पूरी करना. कॉन्टूर कट के लिए पर्याप्त मार्जिन छोड़ने के लिए ऑफ़सेट
सेट करें.

## संबंधित विषय

- **[कॉन्टूर](contour)** — वेक्टर आउटलाइन पर कटिंग
- **[उत्कीर्णन](engrave)** - रास्टर उत्कीर्णन पैटर्न से क्षेत्र भरना
- **[श्रिंक रैप](shrink-wrap)** — ऑब्जेक्टों के चारों ओर सीमा कटिंग
- **[पाथ चिकना करें](../smooth.md)** — टूलपाथ किनारे परिष्कृत करें
