barebaric/rayforge/website/i18n/zh-CN/docusaurus-plugin-content-docs/current/features/operations/contour.md

# 轮廓切割

轮廓切割沿矢量形状的轮廓进行切割，将它们从材料上切下来。这是创建零件、标志和装饰品最常见的激光操作。

## 概述

轮廓操作：

- 沿矢量路径（线、曲线、形状）行进
- 沿对象周边切割
- 支持厚材料的单次或多次遍
- 可使用内部、外部或在线切割路径
- 适用于任何闭合或开放的矢量形状

## 何时使用轮廓

对以下情况使用轮廓切割：

- 从材料上切割零件
- 创建轮廓和边框
- 从木材、亚克力、纸板上切割形状
- 打孔或划线（降低功率）
- 创建模板和样板

**不要将轮廓用于：**

- 填充区域（改用[雕刻](engrave)）
- 位图图像（先转换为矢量）

## 创建轮廓操作

### 第 1 步：选择对象

1. 在画布上导入或绘制矢量形状
2. 选择要切割的对象
3. 确保形状为闭合路径，以实现完整切割

### 第 2 步：添加轮廓操作

- **菜单：** 操作 → 添加轮廓
- **快捷键：** <kbd>ctrl+shift+c</kbd>
- **右键点击：** 上下文菜单 → 添加操作 → 轮廓

### 第 3 步：配置设置

轮廓步骤设置

## 关键设置

步骤设置对话框包含三个选项卡：**步骤设置**、**激光**和**后处理**。设置按选项卡顺序说明如下。
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
