barebaric/rayforge/website/content/docs/images/step-contour-step-settings.png

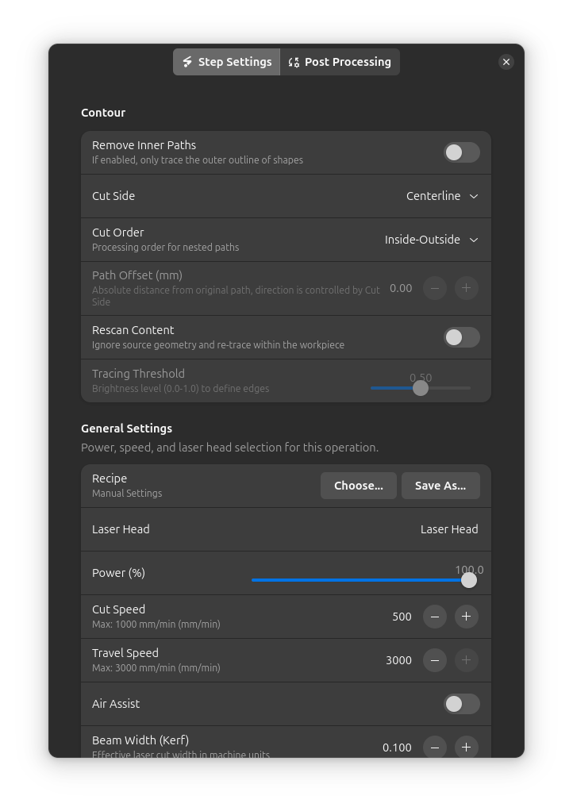
website/content/docs/images/step-contour-step-settings.png
