barebaric/rayforge/tests/image/bmp/img-8-bit-gray-2.bmp

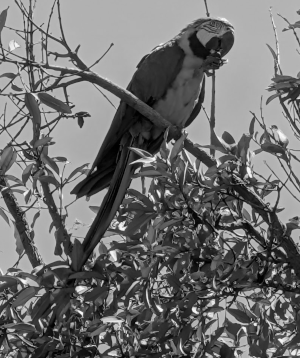
tests/image/bmp/img-8-bit-gray-2.bmp
