barebaric/rayforge/CHANGELOG.md

# Changelog

All notable changes to Rayforge will be documented in this file.

The format is based on [Keep a Changelog](https://keepachangelog.com/en/1.0.0/),
and this project adheres to [Semantic Versioning](https://semver.org/spec/v2.0.0.html).

## 1.14.0

### Added

- Machine: remote machines. Rayforge can now drive a machine that is
  attached to another computer on the network: a raydriver daemon
  running next to the hardware hosts the connection, and the new
  "Remote machine (raydriver)" driver connects to a device on that
  daemon. The daemon resolves the device's protocol and capabilities,
  so one driver covers GRBL, Smoothie and Marlin devices alike. The
  machine wizard discovers daemons and their devices on the network;
  alternatively the daemon is entered manually with hostname, port
  and token, and the device list is read live from the daemon.
  Probing works over the remote connection. Jobs run on the device
  host and keep going if Rayforge disconnects; reconnecting resyncs
  progress exactly (raydriver 1.3.2)
- Import: the import dialog's Layer Source combo starts from the
  choice made in the previous import. The auto-switch to color
  grouping only applies until a source has been picked manually; a
  remembered choice always wins

### Changed

- Optimize: raster scan lines stay in emission order by default.
  Reordering them makes the machine reverse and hop its Y axis
  between rows, and the mechanical play taken up on every reversal
  displaces the rows enough to show up as irregular horizontal
  banding. A new Reorder Scan Lines toggle (off by default) restores
  the old travel-optimizing behavior for machines with calibrated
  axes (raygeo 1.76.0, discussion #686)
- Engrave: the Sample Interval row is shown in every raster mode,
  and its auto value is mode-aware. In dithering the sample pitch is
  the length of each dot, not just a power-sampling distance; dither
  and constant-power modes now default it to the line spacing for
  square cells, while power-modulated modes keep half the spot
  width, where finer sampling smooths the power ramp (discussion
  #686)
- Dependencies: raygeo upgraded to 1.76.0, raydriver to 1.3.2

### Fixed

- Windows: the app launches again on machines with Windows Security.
  The installer shipped MSYS2's python-opencv, whose unsigned
  face-recognition DLL (libopencv_face-500.dll) Windows Security
  blocks; since the app imports cv2 at startup, the main window never
  appeared. The build now uses the same pinned contrib-free
  opencv-python wheel as macOS, provides python3.dll so the
  MSVC-built wheel loads under MSYS2's mingw Python, and a build-time
  guard fails the build if an OpenCV contrib DLL ever re-enters the
  bundle (#697)
- Machine: remote machines keep the generic remote driver when a
  probe matches a curated device profile; previously the machine was
  adopted as that local profile (e.g. GRBL serial) and appeared as a
  standard local device in machine settings. The wizard also skips
  profile selection for remote devices, which are identified by
  daemon and device instead of a local hardware profile
- Machine: the remote device picker reports problems inline instead
  of as a traceback: a failed device list (e.g. a wrong token) shows
  a "check the hostname and token" hint, and the picker shows its
  status (searching, no devices) instead of a silent empty dropdown.
  The token field explains how to get it ("raydriver daemon status"
  on the device host), and TLS fields are hidden for loopback
  daemons, which need no certificate

### Documentation

- A new Remote Devices page describes setting up a raydriver daemon
  on the device host, getting the token, and connecting from
  Rayforge, with screenshots of the wizard and machine settings, in
  all languages
- The engrave docs describe the Sample Interval setting and its
  mode-aware defaults, and the optimize docs describe the Reorder
  Scan Lines toggle, in all languages

## 1.14.0-beta2

### Added

- Engrave: the Dither mode's error-diffusion algorithms gain two new
  settings. Min Feature Size groups each scan line into cells before
  diffusing and stretches each cell's dot across the cell; Auto (the
  default) derives the cell width from the laser spot size, matching
  the former spot-derived setting, and smaller values allow finer but
  fainter dots. Linear Light diffuses in linear light instead of on
  the raw sRGB values, for users who want the previous, darker
  mid-tone rendering (#689)

### Changed

- Engrave: Serpentine now defaults to on for new steps, avoiding
  directional artifacts out of the box; documents saved before this
  change keep their stored value. Bayer and the screens are unaffected
- Dependencies: raygeo upgraded to 1.74.0

### Fixed

- Engrave: Dither mode no longer deletes short runs after diffusing.
  That filter removed exactly the isolated dots that carry light tones
  (82-98% of dots at sRGB 192-224), which destroyed smooth gradation
  and made engravings look darker and blotchier than other software.
  The error diffusion now runs in raygeo on the raw sRGB values, so
  dot coverage matches the tone the image shows on screen (#686)

## 1.14.0-beta1

### Added

- Addons: automatic update checks can be turned off; a new switch on
  the General settings page skips the addon update check at startup
  (#651, by heiserhorn)
- Addons: external addon services can be disabled; a new switch on
  the Addons settings page stops every connection to remote addon
  and license services, so the addon registry is not fetched,
  update checks and URL installs are skipped, and premium license
  validation answers "not found" without reaching the network (#652,
  by heiserhorn)

### Changed

- Machine: the Smoothie, Marlin and simple GRBL serial drivers now
  run their entire protocol stacks in Rust through the raydriver
  library. Class names, setup settings and existing machine
  configurations stay unchanged; connection handling, ping-pong
  streaming, status and position polling, holds and cancels move
  into the Rust sessions (raydriver 1.0.0)
- Console: with Show verbose enabled, the machine conversation shows
  every written line for the Rust-backed GRBL (Serial), GRBL
  (simple), Smoothie and Marlin drivers: streamed G-code, realtime
  commands and status polls are all reported, not only the device's
  replies (raydriver 1.0.0b5)
- CNC: profile passes follow the exact line-and-arc offset and emit
  arcs as true G2/G3 walls instead of segmented polylines, honouring
  the cut direction on both the polygon and curve-true paths.
  Adaptive clearing no longer strands uncut floor: the entry spiral
  machines the seed disk, the ramp entry seeds its actual swath at
  tool width and keeps clear of islands, the core resume strategy
  clears step-over-scale remainders, and an erosion pass machines
  slivers that high step-overs strand. Descents into material are
  emitted as cutting moves instead of rapid-classified travels (at
  the cut feed for now, since steps carry no plunge feed yet), wall
  margin now reaches the clearing pass's island clearance, and a
  wrong-side safehold reports an error instead of panicking
  (raygeo 1.73.0)
- Dependencies: ruida-pa upgraded to 0.24.0, which consolidates its
  modules under the ruida_pa namespace

### Fixed

- Tabs: the Tab Power setting takes effect again. The step's power
  and tab_power were missing from the settings handed to the tab
  generator, so the transformer always saw tab_power=0 and degraded
  every tab to the gap mode no matter what the Tab Power field said;
  tabs with Tab Power above 0% are now cut at reduced power
  (tab_power * power) instead of being skipped (#667)
- Addons: installs that fail while importing the addon's entry point
  are no longer invisible. Previously the error was only recorded
  internally, the addons list skipped the row and the install
  reported success; the row is now shown with its error, the failure
  dialog includes the actual error text, uninstall matches
  error-only addons, and unparsable addon directories can be cleaned
  up by directory name (#425)
- Addons: the zip download fallback also runs when the git clone
  fails; it previously ran only when GitPython itself was
  unavailable, so a clone failure (e.g. no usable git binary in a
  frozen macOS app) aborted the install even though the zip download
  would have worked
- Machine: custom Marlin firmware forks that announce themselves with
  a bare banner or plain ok acknowledgements instead of the start
  boot line can connect again; the Marlin driver now accepts any
  unprompted output as the connection handshake (raydriver 1.0.0)
  (#672)
- CNC: the ramp entry step passes its real tool radius to the ramp
  spec instead of relying on raygeo's 3.0 mm default, which is wrong
  for every tool that is not 6 mm wide, so the cleared area now
  matches the swath the ramp's floor-level tail actually machined
  (raygeo 1.71.0)
- Sketcher: long chains of connected segments no longer drift into
  phantom constraint conflicts after changing a parameter. The angle
  constraint's gradient treated the intersection of the two
  constrained lines as fixed when it actually moves with the line
  endpoints, so the solver terminated early with large residuals;
  the gradient is now evaluated by finite differences, which is
  exact including the intersection movement (#671)
- Import: children of a group in a LightBurn (.lbrn2) project stay on
  their own layers; they were merged onto the group's layer, which is
  often layer 0 or missing, putting shapes on the wrong layer with
  the wrong settings. Layers also import sorted by the file's
  priority value instead of in order of first appearance, so
  outlines no longer cut before their holes (#666, by medoix)
- Import: layers created by an import without a source colour pick an
  unused palette colour instead of all sharing the default, so the
  layers of a multi-layer import are distinguishable when operation
  colours are set to layer (#665, by medoix)
- Import: .lbrn2 paths that reference vertices or primitives stored
  on an earlier shape import again instead of being skipped, so
  repeated outlines are no longer lost; paths that end a rounding
  error short of their start close the gap instead of importing as
  open contours left out of the generated job (#664, by medoix)
- Camera: closing the lens calibration result dialog now keeps the
  calibration instead of silently discarding it; only an explicit
  Discard throws the result away. Alignment point coordinates are
  entered in the display unit measured from the work area origin,
  the point bubble explains what X and Y mean, and finishing the
  wizard without an applied alignment warns first (#648)
- UI: removing a machine no longer crashes the UI widgets that touch
  it; the removal could raise "No machine found with ID ..." from
  the machine manager, aborting the setup wizard finalize mid-way
  and leaving duplicate machine entries behind (#662)
- Packaging: deb packages ship compiled gettext catalogs again;
  packages were built with .po sources only, so the interface fell
  back to English (#303)
- macOS: the app launches again on macOS versions older than 26; the
  1.13.2 bundle shipped a Homebrew freetype built for macOS 26 whose
  binaries reference the macOS 26-only libhvf. The bundled binaries
  are now built from source on macOS 15, and a build-time gate fails
  the build if any bundled binary declares a higher minimum macOS
  version (#659)

## 1.13.2

### Added

- DXF: imports are flattened onto the Z=0 plane by default. 3D CAD
  exports often contain a part's outlines at two Z heights (top and
  bottom face of the stock), and the surviving Z values made the
  head plunge below the material surface mid-job. When the drawing
  spans more than one Z height, the import dialog offers a "Flatten
  Z Coordinates" switch under Import Mode (on by default); turning
  it off keeps the original Z heights and shows a warning banner.
  Flat drawings show no new UI, and the choice survives re-import
  and project reload (#646)
- Addons: addons not provided by the Rayforge team get a dedicated
  icon in the addon registry and the installed addons list, and
  installing one asks for confirmation first, naming its author and
  linking to its repository so the code can be reviewed. This
  applies to registry installs, premium addon unlocks, and manual
  URL installs (#647)
- Devices: a built-in profile for the OMTech SH-G570 (80W CO2 laser
  cutter, 700 x 500 mm work area, Ruida controller) (#641, by
  neostar)

### Fixed

- UI: file chooser errors are surfaced instead of failing silently.
  When the chooser cannot open at all - e.g. in the flatpak sandbox
  when the host's xdg-desktop-portal FileChooser is missing or
  broken - clicking Import or Open did nothing, with no log output
  and no UI feedback; real failures are now reported through each
  context's existing channel: main window toast, wizard error
  dialog, or the surrounding dialog's toast/error label (#649)
- Machine: the machine creation wizard prefills saved driver
  settings that are zero; previously only truthy values were
  restored, so a profile value of 0.0 (e.g. the OMTech SH-G570's
  image power bias) was replaced by the driver default (#641)
- Windows: sdist builds work again; pyo3 0.29 embeds the library
  name python3.dll directly into abi3 import tables, and MSYS2's
  mingw Python ships libpython3.dll but no python3.dll, so raygeo
  failed to import with "DLL load failed while importing raygeo"
  (raygeo 1.67.3) (#650)

## 1.13.1

### Fixed

- UI: renaming a workpiece or group no longer hangs or crashes; the
  focus change triggered by closing the rename editor re-entered the
  rename handling (#633)
- Machine: switching between machines no longer leaves the previous
  machine unable to reconnect; a cleaned-up driver is rebuilt instead
  of being reused, so switching back reconnects instead of failing
  with "Direct mode requires the direct backend" and a status stuck
  at Unknown until restart (#635, by medoix)
- Machine: selecting a work coordinate system works on Ruida
  controllers; Ruida's WCS names are not G-code commands, so the
  selection now goes through the driver instead of being sent as raw
  G-code, and a rebuilt Ruida driver keeps the machine's selection
  instead of reverting it to MACHINE (#636, by medoix)
- G-code: scanline merging restores the cutting power after each
  zero-power bridge between merged collinear cut lines; previously
  jobs with shared edges (Merge Lines feeding Optimize) only burned
  the first cut while the head kept moving (raygeo 1.67.2) (#639)

## 1.13.0

### Added

- Machine: device profiles gain reverse X/Y/Z axis switches, so they
  can ship machines whose controller reports negative machine
  coordinates (e.g. Grbl controllers where machine zero sits at the
  corner opposite the homing switches). The settings are wired into
  the profile review, machine export and machine creation (#613)
- Devices: a built-in profile for the FoxAlien Vasto (desktop CNC
  router, 400 x 400 mm, Grbl 1.1h, typically fitted with the FoxAlien
  40W diode module). The controller reports negative machine
  coordinates, so the profile ships origin top-right with both axes
  reversed (#615)
- Machine: a park position drives the head to a configurable machine
  coordinate after homing all axes, for machines whose homing
  pull-off parks the head past the machine origin, outside the soft
  limit range. The move uses the dialect's Move To Park command,
  which the grbl dialect flavors and all built-in Grbl profiles ship;
  the position is set on the Advanced settings page, and unset means
  no move (#619)
- Machine: a cleanup button in the G-code dialect list header deletes
  all custom dialects that no machine references, after a
  confirmation dialog lists the affected dialects (#632)

### Changed

- Machine: the reverse-axis setting subtitle states the actual
  semantics, machine coordinates count down from the origin, instead
  of the vague "Makes coordinate values negative" (#613)

### Fixed

- Canvas: the green work-origin marker is drawn as arrows above the
  extent frame and no-go zones, so it stays visible when the work
  origin sits on the frame corner; the arrowheads keep a fixed
  device-space size that no longer scales with zoom (#625)
- Windows: upgrading no longer deletes the previous installation
  before checking the deletion succeeded. The installer makes sure no
  instance is running, moves the previous installation aside with a
  rename, and renames it back if writing the new files fails, so a
  locked file can no longer leave the old version half-deleted and
  unusable (#627)
- Windows: the uninstaller no longer deletes whole file-extension
  registry keys shared with other applications (.png, .bmp, .jpeg,
  .jpg, .svg, .svgz, .dxf), discarding associations owned by other
  software; it removes only the Rayforge ProgID keys and restores the
  default association it replaced (#627)
- Windows: shared file types are registered via OpenWithProgids, which
  adds Rayforge to the "Open with" menu, instead of being claimed as
  the default; Rayforge-owned formats (.ryp, .rfs, .rd) keep their
  default registration (#627)
- Devices: the Creality Falcon A1 is declared with both axes
  reversed, because it homes to the maximum end of both axes and its
  machine coordinates count down from the park corner; jogs, soft
  limit clamping and G-code generation stay inside the reachable
  range again. Existing Falcon A1 machines pick the change up through
  the profile review flow, and the wizard now asks which profile
  matches instead of silently adopting the Falcon 2 Pro 22W, which
  shares the A1's USB id (#619)
- Devices: the Falcon A1 profile parks the head at the machine origin
  after homing, so the head lands inside the soft-limit range and the
  first jog after homing is no longer rejected with error:15 (#619)
- UI: the raster Line Spacing field's up/down arrows step in 0.1 mm
  increments instead of a full millimeter, so finer values are
  reachable; other fields keep their step of 1 (#629)

### Documentation

- The device docs describe the FoxAlien Vasto's confirmed coordinate
  layout: homing drives to the bottom-left corner while the controller
  reports negative machine positions, so machine zero sits at the
  opposite corner
- The projector-mode docs and the main-window screenshots show the
  arrow-shaped work-origin marker instead of a crosshair

## 1.13.0-beta5

### Added

- Addons: five hooks report job lifecycle and progress to addons:
  on_job_started, on_job_updated (rate-limited to roughly 1 Hz),
  on_job_paused, on_job_resumed and on_job_finished with the job's
  outcome. Plugin API version 23 -> 24, additive (#614)
- Machine: the jog speed set in the bottom panel is remembered per
  machine instead of resetting to 1000 mm/min (#617)

### Changed

- Machine: the soft limit rows in the hardware settings and wizard are
  retitled to "X Min Distance from Origin" and friends, with an
  explanation that the values are distances from the origin corner
  into the bed, not machine coordinates (#624)

### Fixed

- Machine: disabling soft limits now persists across restarts; the
  toggle silently reverted to enabled with full-axis bounds (#624)
- Machine: soft limits clamp the machine position against the physical
  bed again, so right and top jogs are no longer blocked after the
  work origin was zeroed at an object, and no jog can run past the bed
  into a firmware soft-limit alarm (#623)
- Canvas: the green work origin marker is visible again; it was drawn
  thinner than a pixel at most zoom levels (#623)
- Canvas: perfectly horizontal or vertical lines are selectable again
  and get a thin but fully usable selection box with resize handles
  (#609)
- Material test grid: a Line Interval of 0 resolves to the laser spot
  size as the setting's description promises, instead of exhausting
  memory (#620)
- Material test grid: only the speeds the grid actually engraves with
  are validated against the machine's maximum, removing the bogus "Cut
  speed (500 mm/min) exceeds the machine's maximum" warning on
  machines limited to the grid's top speed (#607)
- macOS: closing a dialog while the main window is in native full
  screen no longer blanks the window; dialogs detach their transient
  parent so GTK's macOS backend cannot tear the full-screen window out
  of its Space (#616)

### Documentation

- The hardware docs describe the soft limit fields as distances from
  the origin, in all languages

## 1.13.0-beta4

### Changed

- Republished 1.13.0-beta3 with its changelog and AppStream release
  notes included, so the Flatpak build can ship it. There are no
  functional changes.

## 1.13.0-beta3

### Fixed

- Machine: the focus laser now lights on GRBL firmware that applies the
  spindle PWM at motion start (confirmed on Creality Falcon and
  Sculpfun iCube) by arming it with a zero-distance move
- Machine: dialect edits apply to the connected session immediately
  instead of waiting for the next reconnect or job
- Laser control: the on/off toggle returns to its previous state when
  the command fails or times out instead of drifting out of sync
- Console: commands sent to the machine appear with verbose output, not
  only the device's replies
- Job generation: a step whose workpiece selection matches nothing now
  fails with a clear error instead of making Send and Frame wait
  forever without feedback (#596)
- Usage reporting: machine reports no longer raise a TypeError in the
  usage tracker
- macOS: closing a dialog while the main window is in native full
  screen no longer leaves a blank window behind

### Documentation

- Document the x86-64-v2 CPU requirement of the Linux packages, with a
  command to check and alternatives for older CPUs
- Fix the translated Bidirectional Scan Offset links to point at the
  explicit anchor used by the machine settings page

## 1.13.0-beta2

### Added

- Laser: a new Offset Fill step fills closed shapes with rings that run
  parallel to the outline, one Line Interval apart (defaulting to the
  laser spot size). An Offset sets the distance of the first ring from
  the outline and Fill Direction cuts Outside-Inside or Inside-Outside;
  holes stay free and open paths are ignored. Path Optimization, Smooth,
  Multi-Pass and Crop to Stock apply as on Contour (#524)
- Optimize: the path optimizer gains Choose Best Start Point, which
  starts each closed path at the vertex nearest the laser head, and
  Prefer Corners, which starts at a sharp corner when the path has one
  so the seam is less visible. Both are off by default (#523)
- Sketcher: Polygon tool (G+X) for regular polygons and stars, made of
  plain points and lines that constraints keep regular (#522)
- Vector editing: edit the nodes of imported paths: drag nodes and curve
  handles, delete and insert nodes, and turn segments into curves or
  lines (#521)
- Workpieces: the X/Y position can refer to the bounding box corner,
  the box center, or the geometry provider's reference point, which is
  the fixed origin for sketches. When parameters change or a sketch is
  edited, the chosen point stays fixed, so parametric cut and engrave
  sketches keep their alignment (#587)

### Fixed

- Console: raw machine communication is shown again with Show verbose;
  since the GRBL protocol moved into the Rust driver, only high-level
  state changes were displayed (#573)
- Machine: jog limits are evaluated in work coordinates, so jogs toward
  the origin no longer clamp to zero on machines whose machine
  coordinates are offset from the work origin; the soft limits toggle
  now disables jog limit checks as a whole and persists (#574)
- Canvas: the laser position dot follows the work position, so it no
  longer lands outside the work area when the controller carries a work
  coordinate offset (#580)
- Renaming a workpiece, group, step, layer or stock item no longer
  triggers a full re-render, which could crash GTK in large projects
  (#571)
- AppImage: TLS certificate verification for update and addon registry
  checks works, and GTK can compile keymaps on Wayland instead of
  crashing (#578)
- Properties: stepping the X/Y position spin row with several items
  selected no longer hangs the application in a move loop between the
  old and the new position (#594)
- Layers: double-clicking a word while renaming a sketch or workpiece
  no longer opens the sketch editor and hangs GTK's focus handling
  (#582)
- Recent files: file names containing underscores, ampersands and other
  special characters are shown correctly (#583)
- Ruida: identical workpieces are collapsed into one Ruida layer, and
  the last requested power is re-applied at genuine layer boundaries,
  so duplicated workpieces are no longer cut with the laser off (#564)
- Sketcher: the path tool closes a path onto its start point and ends
  editing instead of leaving a duplicate loose corner
- Sketcher: drag snapping no longer flickers on geometry coupled to the
  drag, both-axis snaps are recorded as a single coincident constraint,
  and array templates keep the coincident pairs that close their shapes

### Performance

- Sketcher: constraint solving and drags are much faster. The solver
  partitions constraints into independent components, leaves points no
  constraint references out of the solve, uses constant-time point
  lookups, and runs single-threaded to avoid BLAS synchronization
  overhead. A 60-rectangle sketch solves in about 11 ms instead of
  720 ms, and drag frames on large sketches drop from hundreds of
  milliseconds to under one.

## 1.13.0-beta1

### Added

- Import: HPGL plot files (`.plt`, `.hpgl`) from cutting plotters and
  CAD programs, with one selectable layer per pen. Pen moves, circles,
  arcs and rectangles are supported; labels and other skipped
  instructions are listed in the import dialog (#517)
- Import: Adobe Illustrator (`.ai`) and EPS/PostScript files. AI files
  saved with PDF compatibility (the default since Illustrator 9) import
  like PDFs; EPS, PostScript and older AI files are converted to PDF
  with Ghostscript, an optional dependency, with a clear message when
  it is missing. Text becomes outlines and the EPS bounding box sets
  the page size (#517)
- Import: GIF, TIFF and WebP bitmaps, traced like PNG. Animated GIFs
  and multi-page TIFFs import their first frame or page (#517)
- Import: compressed SVG (`.svgz`, Inkscape's "Compressed SVG"), with
  the same options as plain SVG. The file type is registered with the
  desktop, AppStream and the Windows installer (#546)
- Import: sources can be reloaded from disk in place and relinked to
  another file, updating every workpiece made from them as one undo
  step. Rayforge watches imported files and offers to reload those
  that changed, with an Auto-reload option and a General preference
  to turn watching off (#513, #537)
- Engrave: more dithering algorithms for photos. The error-diffusion
  kernels Atkinson, Stucki, Jarvis-Judice-Ninke, Sierra (3-row,
  2-row, Lite) and Burkes, with an optional serpentine scan, plus a
  clustered-dot Newsprint screen and a round-dot Halftone screen with
  adjustable cell size and angle. LightBurn imports keep the image
  layer's dither mode (#514)
- Laser: the Frame button opens a popover with an "Include Overscan
  Margin" switch. When it is off the frame traces only the envelope
  the laser burns instead of the full machine path, so it no longer
  overshoots the artwork by the raster overscan margin (raygeo 1.65.0,
  #563)
- Path clean-up tools in the Object menu and canvas context menu:
  Close Paths and Join Open Paths with a tolerance in mm, Delete
  Duplicates (duplicate contours inside a workpiece and stacked copies
  of whole workpieces), and Break Apart (one workpiece per contour,
  holes and open paths included). Each is a single undo step (#516)
- Contour: Perforation post-processor for dashed cuts. The laser
  fires for a Cut Length and is off for a Skip Length along every
  contour, starting with a full cut at the start of each contour; off
  by default (#525)
- Sketcher: boolean operations. Union, Difference, Intersection and
  Exclude bake the selected closed regions into multi-ring polygons
  (outer contours counter-clockwise, hole contours clockwise), so
  difference results cut correctly; the Sketch menu gains a Boolean
  section with shortcuts, and undo/redo restores the original
  entities and fills (#398)
- Optimize: acceleration-aware scanline merging. Parallel cut lines
  on the same scan row, including rows spanning multiple workpieces,
  are bridged at zero power when the machine's motion profile makes
  the merged sweep faster; a cost guard ensures merging never makes a
  job slower than the time estimate. Enabled by default, with a
  "Merge Scanlines" switch and an optional manual max-gap override
  (raygeo 1.60.0)
- Ruida: the setup wizard connection page gains a Connection mode
  selector (Auto, Network, USB) that shows only the fields relevant
  to the chosen transport; Auto opens USB when available and falls
  back to the network
- Ruida: network connections can use TCP alongside UDP; ruida-pa was
  upgraded to 0.22.0 (thanks to @medoix, #520)
- Machine: a Z homing mode lets machines choose between a Home Switch
  and the auto-focus Probe routine where the driver supports both.
  The Ruida driver routes Z home to its auto-focus routine by default,
  so existing machines keep homing Z as before (#548)
- Machine: a speed-dependent bidirectional scan offset table in the
  Advanced settings interpolates the raster offset for each step's
  speed, for lasers whose left-to-right/right-to-left skew grows with
  speed; a per-step offset still overrides the table (#307)
- Camera: the camera view can extend beyond the work area, with
  adjustable margins and border transparency (#543)
- Settings: a new Mouse Gestures page rebinds the 2D and 3D canvas
  and sketch-editor navigation gestures, helping with setups where
  specific mouse buttons are not delivered (#390)
- Linux: official AppImage builds are attached to GitHub releases
- Windows: Publish Rayforge through WinGet ("winget install rayforge")
- Image Editing addon: non-destructive image edits stored per
  workpiece and applied wherever its image is used (canvas, 3D preview,
  operations). The first edit is Tools > Invert Image (#515)
- Image Editing: Tools > Adjust Image... corrects the brightness,
  contrast and gamma of the selected images and sharpens them with an
  unsharp mask whose radius is in mm. The canvas shows the result while
  editing, and Apply is a single undo step (#515)
- Addons: the `register_image_edits` hook and image edit registry
  (plugin API 23) let addons provide their own image edits
- Step settings: a new Workpieces tab shows which workpieces a step
  processes on its layer. A step normally processes every workpiece of
  its layer; generated content like the Material Test Grid restricts
  its step to the workpiece it creates, and that selection is now
  visible instead of hidden

### Changed

- Engrave: Invert moved from the operation to the workpiece, as the
  Invert Image edit. Older projects are converted when they are opened,
  so their output stays the same (#515)
- Machines: the GRBL Serial driver now runs its entire protocol stack
  (handshake, character-counting flow control, streaming, stall
  detection and deadlock recovery) in Rust through the raydriver
  library. The experimental "GRBL (Rust)" driver replaces the old
  Python implementation under the familiar "GRBL (Serial)" name, so
  existing machine configurations continue to work unchanged.
  Machines saved while the driver carried its experimental name keep
  working through a compatibility alias
- Addon API 22: actions registered via the `register_actions` hook
  accept an `enabled_when` predicate for their enabled state, and the
  hook is invoked again when an addon is enabled while the window
  exists, so addons no longer need `action_extension_registry` for
  either
- Upgrade raygeo to 1.66.0: full-sweep raster passes are limited to
  each scan line's own content extent, so a shape that narrows in X
  (for example an hourglass) no longer sweeps the widest extent on
  every row (#565)
- Updated translations

### Fixed

- Addon API: disabling an addon did not reliably remove its
  `action_extension_registry` handlers when several addons registered
  same-named handlers, which could leave stale handlers behind or
  strip other addons' handlers
- Engrave: the step's Bidirectional Scan Offset had no effect since
  the pipeline moved to raygeo intents, because the value no longer
  reached the transformer; changing it now also refreshes the cached
  toolpath (#307)
- Step settings: choice rows backed by an enum (such as the Engrave
  step's dithering algorithm) now show the step's actual value when
  the dialog opens and after undo, instead of the first entry
- Machine: the running job ETA is derived from the modeled time
  remaining at the acknowledged command frontier instead of the recent
  command speed, so it no longer collapses during buffered bursts or
  swings on jobs that mix fast and slow phases (#496)
- Ruida: homing a single X or Y axis now jogs only that axis instead
  of moving both to the origin (#545)
- Engrave: the Crop to Stock post-processor is now offered on Engrave
  steps, so raster content can be clipped to the stock boundary (#508)
- Devices: the Sculpfun S30 focus laser uses constant power (M3), so
  it lights while the head is stationary; a dedicated Sculpfun S9
  profile was added (#512)
- Ruida: the setup wizard no longer requires the optional USB device
  and Magic fields, so Next is enabled again once a valid hostname is
  entered; the Magic field is prefilled with the standard 0x88
  (#501, #504)
- GRBL (Network): a new FluidNC protocol variant uses FluidNC's
  native command endpoint over its WebSocket and tolerates its
  response shapes, replacing the confusing "did not receive a valid
  HTTP response" error on ESP3D-style handshakes (#490)
- Device export: zipping a machine export no longer fails with "ZIP
  does not support timestamps before 1980" when exported 3D models
  carry such timestamps (#500)
- Text rendering: on-canvas text is drawn through Pango instead of
  Cairo's toy font API. Sketcher constraint labels and dimension
  input, pie menu labels, camera overlay messages, and the histogram
  placeholder now pick fonts with proper fallback, fixing garbled
  text and wrong sizes, especially for non-Latin languages (thanks
  to @atkaper, #507)
- macOS: adding a camera no longer crashes Rayforge; the app bundle
  now declares `NSCameraUsageDescription`, and the first frame waits
  for the capture session to settle before reading (#510)
- Material test: resizing the workpiece no longer leaves the grid's
  cells and labels misaligned with the workpiece image until the next
  rebuild; toolpath outputs are stamped with the size their ops were
  generated at instead of the workpiece's live size (#568)

## 1.12.0

### Added

- Addons: a new built-in "Automation" addon, debuting with the
  "Command" step. Add your own machine code at any position in a
  layer's workflow — one command per line, sent exactly where the
  step sits (#449). Handy for pre-positioning the head, toggling air
  assist between operations, or sending controller-specific codes.
  Lines can use the same variables as macros (`machine.*`, `layer.*`,
  `job.*`), the text is stored with the project, and a warning
  appears on machines whose driver does not consume machine code
  (e.g. Ruida)
- About dialog: a GitHub Discussions button next to Report an Issue

### Changed

- Usage tracking (opt-in) now reports the host OS and one anonymous
  machine event per configured machine, carrying its type (driver,
  laser type, optical power, bed size, rotary); each launch counts as
  its own session, and the consent prompt was reworded. Machine names
  and identifiers are never sent

### Fixed

- SVG: files that contain a DOCTYPE declaration, such as those
  exported by Affinity Studio, import again (raygeo 1.58.2, #484)
- Click to Zero and Click Canvas to Move Head round the clicked
  position to the machine's precision, so the machine can hit the
  requested position exactly; the ruler labels use a font that fits
  them (thanks to @atkaper, #479)
- Ruida: ruida-pa was upgraded to 0.21.2, fixing UDP connections on
  Windows (thanks to @StevenIsaacs, #486)
- Machine: a reported position outside the soft limits no longer
  turns every jog into a long move back to the nearest limit, which
  could drive an axis into its end stop (e.g. on a Ruida RDC8445S
  whose controller reports Z around 3176 mm). Jogs heading further
  out of range are now blocked, jogs back towards the range are
  allowed and stop at the far limit, and the soft-limit warning
  matches exactly (thanks to @medoix, #488)

## 1.12.0-beta2

### Added

- Machine: a new Notes category in Machine Settings combines the
  guidance shipped with the device profile with your own notes for
  the machine. Device notes are read-only; My Notes are edited with
  a built-in Markdown editor (headings, emphasis, lists, links,
  code blocks, and expandable details sections). Profile setup
  guidance also appears on the setup wizard's review page, and
  personal notes survive profile updates (thanks to @atkaper, #471)
- Camera: lens calibration now supports ArUco/AprilTag marker grids
  and printable dot grids alongside ChArUco boards. Marker grids
  tolerate partial views, and their dictionary, ID offset, origin
  corner and numbering order are all editable, so factory-printed
  patterns can be calibrated against directly instead of printing
  a new card (thanks to @TOverbye, #466)
- Drivers: the Ruida driver honors the step Power Mode setting —
  Dynamic enables the controller's power scaling and Constant
  disables it. The driver setup gains Power Scaling and Vector
  Power Floor toggles, and serial ports can be bound from a USB
  device dropdown with VID:PID matching (thanks to @StevenIsaacs,
  #476)
- Translations: Hindi is now available

### Changed

- raygeo and raydriver now ship aarch64 (ARM64) Linux wheels, so
  ARM64 installs use prebuilt binaries instead of compiling from
  source

### Fixed

- Framing now works on Ruida machines: framing became a driver
  capability, and the Ruida driver traces the outline with beam-off
  absolute moves (#470)
- Print and cut: capturing an alignment point now accounts for
  Pointer Alignment, so the computed transform no longer lands one
  pointer offset away from the printed marks; the wizard's jog
  panel gains a Pointer Alignment switch (#478)

## 1.12.0-beta1

### Added

- Drivers: a new "Ruida RPA" driver connects Rayforge to Ruida-based
  controllers over USB or UDP directly, or via TUI RPC through the
  Ruida Protocol Analyzer. It ships with all installs, and new
  Generic Ruida RPA and Monport MP-570 60W CO2 device profiles are
  included (thanks to @StevenIsaacs, #404)
- Camera: network cameras are supported as stream sources alongside
  USB cameras, with automatic reconnection after read failures
  (thanks to @atkaper, #438)
- Drivers: a new GRBL driver `GRBL (Rust)` (`GrblSerialNextDriver`):
  the complete GRBL serial protocol stack (character-counting flow
  control, job streaming, stall detection, deadlock recovery,
  cancel/safety shutdown, settings, WCS and probing) now runs in Rust
  through the `raydriver` package. Dialects and settings remain
  Rayforge data; this driver is experimental and can be selected per
  machine as a drop-in alternative to `GRBL (Serial)`
- Machine control: the laser head can now be moved to an arbitrary
  position. A "Move to Position" popover in the Current Position area
  offers direct X/Y (and Z, when available) coordinate entry and hosts
  the selection/workarea corner and WCS origin shortcuts, a "Click
  Canvas to Move Head" mode mirrors Click to Zero, and the canvas
  background context menu gains a "Move Head Here" action. These moves
  run at the configured Jog Speed (#452, #458)
- Machine control: Ctrl+M arms the "Click Canvas to Move Head" mode
  from the keyboard
- Machine control: a per-head pointer offset makes an alignment
  laser's dot a first-class aiming reference. While "Pointer
  Alignment" is on, aiming moves (Move to Position, the corner and
  WCS origin shortcuts, Click Canvas to Move Head, Move Head Here,
  and framing) are shifted so the pointer dot lands on the aimed
  position, zeroing accounts for the offset, and the canvas shows
  the pointer dot next to the beam dot. Starting a job asks whether
  to turn alignment off first, since jobs always burn with the
  unshifted beam (#423)
- Drivers: serial ports can be bound by USB VID:PID instead of a
  device path, so auto-reconnect follows the machine to its new
  port after the OS re-enumerates USB devices (#459)
- Laser: each step gains a Power Mode setting, Dynamic (M4) or
  Constant (M3). Constant power avoids power sags at corners during
  vector cuts, while raster engraving keeps dynamic power (#437)
- Laser: the Frame operation gains a Round Corners toggle and a
  corner radius setting, avoiding sharp, fragile corners without
  hand-drawing a rounded outline (#447, #448)
- Laser: framing at 0% power is now allowed and traces the outline
  with the beam off, so machines with an auxiliary alignment laser
  can frame without firing the main laser
- Sketcher: array tools now also lay out text boxes (#399)
- Machine: the dialect editor warns when "Continuous laser mode" is
  enabled on a dialect whose movement templates have no {s_command}
  placeholder, a combination that previously dropped all laser
  power (#403)
- Machine: G-code fields that contain only a number show a warning,
  since the value is most likely a mistake (#393, #396)
- Devices: a built-in profile for the Creality Falcon A1 Pro
  (thanks to @atkaper, #461)
- Devices: a built-in profile for the Creality Falcon 2 Pro 22W,
  shipping camera lens calibration and image settings as a starting
  default; the 40W profile's work area is corrected to the official
  400 x 415 mm spec (#463)
- Devices: the Falcon A1 and Falcon 10W profiles emit a bounds
  comment in the G-code preamble so their firmware can trace the
  job outline before running it
- Drivers: `move_to` accepts an optional absolute Z target; machines
  with a Z axis receive it in the same move
- Drivers: drivers may opt into live reconfiguration via
  `update_settings` instead of a teardown/rebuild when their setup
  arguments are edited

### Changed

- The prototype Ruida (UDP) driver has been removed; the RuidaRPA
  driver supersedes it, and affected device profiles were migrated
- Raster: the default threshold is now 254, so only pure white stays
  unengraved
- Upgrade raygeo to 1.56.1, which omits zero-length travel moves from
  generated G-code; this builds on 1.55.0's power-mode-aware laser
  commands (constant-power M3 output), frame corner radius support, and
  the contour nesting classification fix (#456)

### Fixed

- Machine: the time estimate in the machine dropdown counts down
  again while a job runs. The ETA now falls back to the job's
  estimated duration when GRBL acknowledges buffered commands faster
  than the machine executes them (previously no estimate was shown
  at all for short jobs), the dropdown refreshes it once per second
  instead of only on driver callbacks, and every bound status label
  (button face and popup rows) receives the update
- GRBL: flow-control state jammed by lost acknowledgements is
  detected and healed, so a firmware that stays silent after a
  cancel (e.g. the Sculpfun iCube over Bluetooth) no longer leaves
  "Read from Device" hanging and the machine controls dead (#428)
- GRBL: the work coordinate offset is refreshed from the WCS
  read-back, so zeroing again right after setting a zero no longer
  reads a stale position and writes the old offset back
- Machine: Z jog moves are clamped to the configured Z axis
  extents, the Move to Position popover accepts the full Z range,
  and the hardware settings page gains Z Min/Z Max rows (#459)
- Camera: the ChArUco card is detected again on blurry, unevenly
  lit frames by falling back through progressively more tolerant
  detection passes (#443, #465)
- Machine: dialect copies on existing machines stay linked to the
  built-in dialect they came from, so fixes to built-in dialects
  reach machines while user edits remain preserved
- Ruida: job encoding is routed by driver capability instead of a
  stale dialect, fixing garbled output after switching drivers (#420)
- Configuration, machine profiles, and recipes are persisted
  atomically with backups, so an interrupted save can no longer
  destroy them (#455)
- macOS: the full-screen main window stays visible when a dialog
  closes on top of it (#453)
- Material test: the test speed is capped at the machine's live
  speed limit (#439, #440)
- SVG: files that define a viewBox but no width/height attributes
  now import at the correct scale (thanks to @MausRundung, #434)
- Laser: rounded Frame corners are rendered with arc tolerance, so
  they come out smooth instead of segmented
- Sketcher: helper geometry now moves together with the array
  members it belongs to
- 3D simulation: the playback slider position is re-derived when the
  playback range shrinks
- Right panel: the estimated job time now stays fully visible in the
  status bar; its container's bottom margin was increased so it is no
  longer clipped behind adjacent widgets

## 1.11.2

### Fixed

- GRBL: cancelling a job now hard-aborts the streaming sender instead
  of waiting for the controller's RX buffer to drain, so the machine
  stops immediately; interactive commands issued while a cancelled job
  is winding down can no longer resume it, and a transient connection
  error no longer grays out the machine controls for the rest of the
  session (#428)
- Selecting a driver that requires connection details no longer
  crashes the app with a GTK assertion and a crash loop at startup
  (#415)
- Machine settings: a fast editing burst of driver setup arguments can
  no longer leave a cancelled driver rebuild touching live driver
  state (#416)
- The Machine Settings dialog is now a single instance per main window
  instead of opening duplicates, and the machine counters action opens
  the maintenance page instead of a nonexistent page (thanks to
  @StevenIsaacs, #416)
- Preview assembly failures for everyday states such as an empty
  document are no longer logged as errors
- Material textures are included again in wheel-based installs,
  repairing blank material thumbnails on flatpak and deb installs
  (#419)

### Changed

- Upgrade raygeo to 1.52.0
- Windows builds now use the UCRT64 environment, following the MSYS2
  deprecation of MINGW64

## 1.11.1

### Fixed

- Importing DXF or LBRN2 files on macOS no longer produces a garbled,
  wrongly scaled result caused by the generic binary MIME type routing
  files to the Ruida importer (#384)
- Sketcher: dragging elements no longer resizes the main window
  because the status bar's width changed while a drag was in progress
  (#385)
- Print and cut: the wizard now launches on machines whose position
  reports include an extra rotary axis instead of failing with an
  unpack error (#394)
- GRBL: reading device settings no longer aborts on grblHAL bitmask
  values, so the settings dialog refreshes correctly (#401)
- Material test: grid dimensions are truncated to whole numbers before
  the test grid is generated, repairing broken grids (thanks to
  @atkaper, #405)

## 1.11.0

### Fixed

- Sketcher: undoing a guide drag no longer spuriously rotates every
  array member, which could cause overlapping rectangles and missing
  contours in ops
- 3D simulation playback no longer stalls on large jobs; the playhead,
  slider, and G-code viewer now stay in sync (#370)
- 3D simulation: rotary arcs are reconstructed correctly, fixing
  stalls, off-cylinder X swings, and a frozen cylinder
- Simulation: playback completion anchors the final command so trailing
  M5s are applied and the laser turns off

### Performance

- Sketcher: point-usage reference counting and coincident-point
  caching make drag operations faster
- Sketcher: solver iterations capped at 5000 to guard against stalls

## 1.11.0-beta3

### Added

- Sketcher: new contour offset tool replaces selected contours with their
  offset; lone circles, arcs, and ellipses are updated in place, while
  chains of connected segments are replaced by a new polygon entity with
  a move/rotate/scale handle frame; open paths become closed slots with
  round end caps, and a live-preview dialog controls the distance
- Sketcher: grouped tools (arrays, constraints, waypoints, rectangles)
  are now presented as pie-menu submenus that appear in a partial outer
  ring when the inner ring runs out of space; radial corridors prevent
  accidental submenu switches

### Changed

- Upgrade raygeo to 1.49.0

### Fixed

- Startup dialogs (consent, setup wizard, profile/schema reviews) now
  run strictly in sequence so they no longer stack into an invisible
  modal that steals input and leaves buttons unresponsive

### Testing

- UI tests now run in a virtual display with a software renderer, so
  they no longer require a running desktop session

## 1.11.0-beta2

### Added

- Sketcher: new curve-along array tool distributes copies of the
  selection along a line, arc, or bezier guide, rotated to follow the
  curve's tangent
- Sketcher: Point on Curve constraint pins a point onto a bezier path;
  select a point plus a curve with the coincident tool
- Sketcher: rectangles are now defined with perpendicular constraints,
  so they stay rectangles when rotated
- Sketcher: circle, ellipse, rectangle, and rounded-rectangle tools
  share one interaction model: drag to commit, Shift draws from the
  center, Ctrl constrains to a square or circle
- Sketcher: dragging a radius point keeps the entity's center pinned
- Raster: dither mode now applies the histogram levels (auto levels,
  brightness range, white point) before dithering, so they shape the
  output; the Power section hides itself when it has no effect

### Changed

- Upgrade raygeo to 1.48.0
- The "Multiple Depths" raster depth mode is disabled on machines whose
  driver cannot support it (e.g. Ruida), and affected steps show a
  warning when opened
- The pie menu has an opaque background with outlined labels and grows
  to fit long item labels
- The right panel collapses entirely when it has no content
- Split the Sculpfun iCube profile into 3W and Pro-5W variants

### Fixed

- Windows: the installer now removes the previous installation before
  copying and aborts with a clear message when files are still locked;
  stale DLLs from older versions no longer crash the app at startup
- Travel speed settings are no longer hidden on machines whose driver
  speaks a binary protocol (e.g. Ruida), and machines created from a
  profile are no longer saved with the wrong G-code dialect
- The machine settings dialog could fail to open when stored driver
  settings did not match the selected driver type
- Discovery: serial ports are probed in parallel and ports that
  answered before a scan timeout are still reported
- Discovery: picking a network device after a USB device no longer
  stamps the board's USB identity onto it, and machines whose USB
  description carries only the brand name still match their profile
- OctoPrint: configured machine dimensions are picked up during
  probing, and transient state text no longer leaks into the profile
  name
- Sketcher: snap lines no longer reference stale geometry, the solver
  no longer re-triggers itself in a loop, and drags no longer jitter
  between moving snap attractors
- Sketcher: constraints violated by re-anchoring an array are now
  flagged
- Canvas: modifier key state is re-synced on focus changes so Shift/
  Ctrl no longer get stuck after dialogs or focus loss

### Performance

- Sketcher drags now solve only the dragged geometry and reuse a cached
  snap index, so dragging stays smooth regardless of sketch size

## 1.11.0-beta1

### Added

- On first launch, the machine setup wizard now opens automatically and
  discovers nearby devices for you
- The wizard checks serial-port and camera permissions before
  discovery, and when access is missing explains how to fix it per
  platform with one-click copyable commands
- Network device discovery via mDNS: OctoPrint servers and ESP3D boards
  appear in the wizard alongside USB serial devices
- Discovery now matches devices to profiles by USB id with confidence
  scoring, and marks already-configured devices as read-only
- GRBL auto-selects the G-code dialect from the `$I` compile flags;
  OctoPrint and Smoothieware are probed over the network
- Sketcher: mirror the selection vertically or horizontally across its
  center
- Sketcher: duplicate the selection in-place with Ctrl+D
- Sketcher: nudge selected entities with the arrow keys
- Sketcher: parametric circular array (polar pattern) tool with a guide
  circle and live preview dialog
- Sketcher: rectangles now create a center point; Shift-click draws the
  rectangle symmetrically around the start point
- New `--script` CLI flag runs Python at startup so scripts can register
  plugins and template functions; built-in text-box template functions
  (date, time, uuid, etc.) are available via a public registry
- `.rfs` sketch files now record a schema version (backward-compatible
  with older files)
- New right panel display mode setting
- 3D preview: a physical, fluence-based burn model chars the stock as
  you engrave (and works for rotary), with a power-keyed scorch ramp and
  heat halo
- Stock material-fold compute nodes in the pipeline, and the material
  manager now guarantees a default stock material

### Changed

- Upgrade raygeo to 1.47.0
- USB serial ports sort ahead of hardware ports; the port selector now
  shows the device path plus a dimmed description, and a configured but
  unplugged port stays pinned to the top
- Tool outputs (laser/aux) are turned off when a job is stopped or
  aborted
- Refined app icon and centralized icon generation
- Updated translations (de, es, fr, pt, uk, zh_CN)

### Fixed

- Slow GRBL serial handshake with grblHAL compatibility level 0
- Discovery shows the real GRBL banner and survives slow-booting devices
- Sketcher: text-editing undo/redo, stale cache, workspace lifecycle,
  control-point drag undo, and font changes are now handled correctly
- Sketcher: Ctrl+S now saves the document instead of triggering the
  symmetry tool
- Line-mode bezier violating the loop-vertex convention
- Bezier flipping to the opposite bow when committing a path segment
- Workflow row step button outline not updating on laser color change
- Sketcher saved-state tracking and history coalescing, with undo/redo
  buttons

### Performance

- Sketcher hot paths optimized: coincident-point lookup, ellipse
  tessellation, arc polygonization, and text-box tool costs
- Snap index is cached and invalidated on registry mutation

## 1.10.3

### Changed

- AppStream metainfo entries reordered and corrected to pass the
  Flathub linter

### Internal

- Added AppStream metainfo validation to lint

## 1.10.2

### Added

- Laser heads now carry physical power data: emission wavelength and
  optical output wattage, with researched values shipped for all
  built-in device profiles and effective fallback values shown when
  unset. These values are not used by any feature yet; they lay the
  groundwork for upcoming physics-based features. Laser settings are
  split into Properties and Optics groups
- Machines created from a device profile now detect when that profile
  has changed and offer a review dialog listing every differing
  setting before applying updates
- The Creality Falcon 10W preamble now turns on the extraction fan
- New device profile for the NEJE Master 2s

### Changed

- Upgrade raygeo to 1.45.1

### Fixed

- Framing applied the active work coordinate system offset twice,
  driving the head toward doubled coordinates (#362)
- A failed background job rebuild could wedge all later job sends;
  failures now surface as an error instead of blocking forever
- Toggling "Rescan Content" on a contour step now takes effect, and
  the threshold row appears directly below it
- Built-in device profiles for two-axis lasers now correctly report
  no Z axis, and the Z setting survives wizard edits and profile
  exports
- Numeric spin entries no longer lose in-progress text when a value
  gets clamped or after switching the display unit
- The 3D simulator camera no longer overshoots or spins wildly on
  far clicks; pan, zoom, and orbit now track the pointer consistently
  in every view
- The simulator always turns the laser off at the end of a job
- Expected cancellations during rapid rebuilds no longer produce
  tracebacks in the log
- Jog panel "Home All" button now sends $H instead of per-axis
  homing commands, fixing a hang on firmwares that do not support
  $HX/$HY/$HZ (#363)

## 1.10.1

### Fixed

- GRBL: the driver now owns the hold/pause state, so the hold/resume
  toggle stays in sync and Resume actually sends "~" instead of
  re-sending "!" (pause)
- GRBL: status polling is no longer starved while the send loop waits
  on a full RX buffer, so driver state no longer goes stale during
  pauses and buffer stalls
- GRBL: a job is now aborted (with a connection error) instead of
  retrying forever when the device stops responding during a buffer
  stall
- GRBL: realtime console commands (~, !, ?) are sent directly via the
  control path instead of being streamed as buffered gcode, so they no
  longer queue behind commands or start phantom jobs
- GRBL: the UI now reflects the RUN state at job start when status
  polling is disabled
- Refusing to start a job while another is running now shows an
  actionable message telling the user to wait for it to finish or press
  Stop
- Machine job failure notifications are now localized per job type
  (frame vs. send) with complete, translatable sentences
- The camera calibration wizard now passes the generated CharucoBoard
  to the capture page, so Capture Frame works again

## 1.10.0

### Added

- Stock is now rendered as solid, physically-shaded solids in the 3D
  canvas, with support for material textures; rotary stock appears as a
  textured cylinder rod with material selection
- Materials can carry textures (with roughness and metallic appearance
  fields) and per-instance stock colors, and textures are optimized to
  WebP to keep material files small
- New 3D canvas visibility toggles for stock, workpiece images, and the
  raster underlay; the no-go zone toggle is hidden when the machine has
  no no-go zones
- New Z-axis presence toggle for 2-axis lasers, and the 3D canvas now
  layers content correctly on machines without a Z axis
- Middle-click orbit now pivots on the object under the cursor instead
  of the floor plane
- Configurable panel orientation: device profiles and the machine
  wizard can rotate the working plane, and the 2D/3D canvases render
  the document in the rotated panel space
- CNC step settings dialog now has a spindle section (head selection,
  RPM, tool diameter, cooling) and icons for all CNC steps
- Material test grid labels are engraved in the user's preferred speed
  unit instead of hardcoded mm/min
- Hidden layers are dimmed in the layer list
- Steps warn when their speed exceeds the active machine's maximum

### Changed

- Upgrade raygeo to 1.43.0 (from 1.39.1)
- Material test step rows are now unit-aware (speed, offset)

### Fixed

- Framing now drives the rotary axis instead of the physical Y axis on
  rotary layers (#356)
- Arcs using more than a full circle no longer collapse when overcut
  (#357)
- Rotary toolpaths no longer sink below the cylinder in the 3d simulator
- Steps with generated workpieces no longer apply to every workpiece in
  the layer
- Material test preview no longer misaligns with the engraved ops after
  the workpiece is resized, and the grid no longer engraves smaller
  than the workpiece
- Raster histogram (levels) changes now commit on release instead of
  mid-drag and invalidate the compute cache properly
- Travel speed setting hidden on machines without support, and the
  speed field cursor no longer jumps when a value is clamped
- Workpiece selectability stays in sync with layer visibility
- 3D canvas: the raster texture underlay now draws correctly, and the
  laser beam no longer draws over the head model
- Ruida driver falls back to the machine reference point for named WCS
  on job start
- Camera alignment/calibration date comparison is now timezone-safe
- Traced contours no longer come out wider than the image content

## 1.9.3

### Added

- The recipe editor now shows all step settings (laser, raster,
  contour, frame, shrinkwrap, wavefront, material test, and CNC),
  matching the step settings dialog
- Layer items can now be renamed inline by double-clicking, using the
  context menu, or pressing F2
- When importing with "Map to Existing" layers, layers that still
  carry auto-generated names (e.g. "Layer 1") are renamed to the
  imported layer's name; manually renamed layers are left untouched

### Changed

- Recipe post-processing settings now use an apply toggle instead of
  the tri-state menu
- Upgrade raygeo to 1.39.1

### Fixed

- Shrinkwrap no longer runs once per face when the workpiece has
  multiple faces
- In the 3D preview, the toolpath and scanline trail are now
  depth-tested against the models, so they no longer draw on top of
  the laser head

## 1.9.2

### Fixed

- Loading projects that store a null ``opsproducer_dict`` no longer
  crashes (e.g. when an engrave step has no legacy producer
  parameters)
- Renaming a step now updates the step list in the main window's right
  pane immediately

## 1.9.1

### Added

- New "CNC Essentials" addon with Experimental CNC machining operations:
  adaptive clearing, flat spiral, helix plunge, inner and outer profiling,
  ramp entry, slotting, and toroidal clearing (disabled by default; enable
  it in the addon manager)
- Pipeline progress now shows the currently running operation with a
  friendly, translatable status label instead of an internal name

### Changed

- Recipes now target one or more step types instead of a single
  capability; the recipe editor gained a searchable step-type selector,
  and existing recipes are migrated automatically
- Post-processor settings (lead-in/out, multipass, overscan) can now be
  stored per recipe and applied to the targeted steps
- Show a confirmation dialog when enabling experimental addons
- Upgrade raygeo to 1.38.3

### Fixed

- Generated G-code could be wrong when axis reversal or a non-bottom-left
  origin was combined with a WCS offset
- Air assist settings in laser steps were not emitted to the G-code
  (M8/M9)

## 1.9.0

### Added

- Playback speeds up to x64 in simulated playback
- 3D preview renders raster scanlines at the physical laser dot
  width for a more accurate preview
- Addon-contributed settings pages now update live when the settings
  dialog is open
- Addon manifests support a default enabled/disabled state

### Changed

- Upgrade raygeo to 1.37.0
- Memory improvements in the pipeline: op data now uses a compressed
  array, assembly intermediates are released between builds, the
  final job ops are no longer cached, and a kinematic mapping is only
  computed when a rotary module is present

### Fixed

- 3D canvas panning now follows the mouse 1:1
- Cylinder angle interpolation during rotary animation could be
  incorrect
- 3D models could obscure ops in the 3D view
- Raster preview artifacts when zooming out (moire) fixed with
  max-reduction mipmaps
- Toolpath and scanline trail drawn above the raster texture
- 3D canvas not grabbing keyboard focus when clicked
- Right panel could obscure the canvas overlays
- 3D model loading errors no longer crash the app
- Machine switch config update now runs on the main thread
- `--exit` watcher is only armed after the uiscript has run

### Performance

- 3D canvas vertex uploads are prepared in a worker thread, reducing
  main-thread stalls during pipeline finishes

## 1.9.0-beta4

### Added

- Simulated playback now advances by simulated machine time at
  (approximately) real machine speed, with a 1x-16x speed multiplier:
  the toolpath reveal, laser head, and laser beam interpolate within
  each command so playback is smooth instead of stepping one command
  per frame
- Step forward/backward buttons glide to the next command over a short
  fixed duration instead of jumping; rapid clicks coalesce into a
  single glide that covers the net number of commands
- Zoom and orbit now rotate around the point under the cursor
- Playback controls (play, step, speed, slider) shown as a bar below
  the 3D canvas
- The 2D and 3D canvas grids draw in the preferred length unit
- Warn when a project uses cooling methods not supported by the
  current machine
- Recipe manager shows the selected step in the recipe description

### Changed

- Upgrade raygeo to 1.33.0: simulated playback now runs at accurate
  machine speed, ops no longer move slightly through the cylinder
  during rotary simulation, and stroke-only cut lines are no longer
  missing from the generated ops
- Internal: 3D canvas refactored into a scene presenter, camera
  controller, playback overlay, renderer registry, and chunked upload
  controller
- Updated translations

### Fixed

- Texture alpha no longer brightens after a layer completes
- Laser beam rendered over the scanline ring buffer
- Scanline overlay stays visible after playback completes
- Legacy opsproducer step parameters migrated when loading projects
- Step settings refresh when a recipe is applied
- Material colors applied per-widget in lists
- Simple GRBL driver wakes an in-flight ping-pong on cancel
- 3D canvas background falls back to the theme view background color
- Frequency and pulse width preserved in MachineState.copy

## 1.9.0-beta3

### Added

- Unit system support: metric/imperial selection in the machine
  settings, with automatic unit-system detection for GRBL (from `$13`)
  and Marlin (via `M149`) drivers and in the configuration wizard
- Length, speed, and acceleration inputs are now unit-aware: they
  convert between the configured display unit and base units, update
  live when the display unit changes, and show the unit as a tooltip
- The 2D and 3D canvas grids now follow the user's preferred length
  unit: grid lines snap to multiples of that unit and axis labels are
  displayed in it, updating live when the preference changes
- Generic service registry and settings-page hooks so addons can
  publish key-resolved services and contribute their own pages to the
  Settings dialog

### Changed

- Addon manifest `requires` are now enforced at load time with a
  topological pass so dependencies load before dependents
- Bump addon API version to 18
- Upgrade raygeo to 1.32.1

### Fixed

- Raster engraving could be rendered up to one pixel smaller than the
  workpiece size due to pixel-count truncation (raygeo 1.32.1), which
  could be larger if the workpiece is scaled.

## 1.9.0-beta2

### Added

- Unified machine configuration wizard with AI-powered device spec
  lookup
- Import SVG colors as layers
- Color rules that map SVG colors to step types, with a settings
  page to manage the rules
- Recipes can now target specific step types
- Assembly warnings (e.g. failed faces or regions) surfaced as toast
  notifications
- Right-click context menu on steps in the layer workflow strip with a
  delete option

### Changed

- Kerf and path offset merged into a single offset setting, defaulting
  to half the laser head spot size
- Raster power range on engrave steps renamed to min/max power level so
  it no longer clashes with the hardware max power setting
- Upgrade raygeo to 1.31.2 (SVG color layer import, multi-face parts,
  and fixed SVG `<defs>`/`<use>` traversal)
- Bump pypdf to 6.14.2, GitPython to 3.1.58, and aiohttp to 3.14.3 to
  fix security vulnerabilities
- Updated translations

### Fixed

- 3D toolpaths drawn at full brightness on first open instead of
  power-dimmed
- Raster full-sweep mode no longer engraves empty masked regions at
  full power (raygeo 1.31.2)
- Raster multi-pass mode no longer mixes Z levels when optimizing, and
  cross-hatch now interleaves both angles per pass instead of running
  all passes of one angle before the other
- CNC step attributes no longer dropped from project files on save
- ChArUco detection failing on some array shapes (camera calibration,
  by trixdaddy)
- Intent-rebuild hot loop on documents without workflow content
- Missing features dialog now reports the original step type
- Restored macOS Monterey-compatible bundles (by pgilfernandez)
- Replaced deprecated GTK CSS APIs
- Icons that fell back to the system theme (which breaks on some
  platforms) now ship with the app

## 1.9.0-beta1

### Added

- Array / Pattern tool with Grid, Point Rotation, and Circular modes
- Dot width correction for raster engraving (#316, by vyvcodd)
- LightBurn import: support for importing raster settings
  (dotWidth, interval, angle, scan_angle)
- Allow renaming layers and steps directly in the layer/step
  settings dialogs
- Asyncio support for parallel workpiece processing in the pipeline
- Configurable pipeline cache budget in settings
- Error notifications for pipeline failures

### Changed

- Upgrade raygeo to 1.27.0 (from 1.24.0) with migrated G-code encoder,
  BidirScanOffsetTransformer, and MultiPassTransformer to Rust;
  transformer application now uses Rust apply_transformers dispatch
- Replaced multiprocessing pipeline with raygeo intent
  orchestration: compute, raster, shrinkwrap, wavefront, contour,
  and view rendering now run in raygeo threads instead of
  subprocesses for improved performance and reliability
- Rewrote 3D scene compiler to use Rust `compile_scene_3d` with
  chunked GL upload for improved 3D canvas rendering performance
- Pipeline cache is now preserved across document and machine swaps
  for faster rebuilds
- Improved addon translation fallback: English is now used when
  no matching locale is found
- Wavefront icon and improved Gtk SVG compatibility for other icons
- Bump pypdf to 6.13.3
- Bump GitPython to 3.1.51

### Fixed

- Blank sketcher UI text on packaged installs (#315)
- Dragging of layers now works correctly
- Use persistent /dev/v4l/by-id/ paths for camera identification
  on Linux (#318)
- Spinrow input field too narrow in some cases
- Settings widget auto-value bugs: raster/wavefront sliders
  showing wrong defaults, overscan Automatic Distance switch
  permanently greyed out, and auto overscan/lead-in-out distance
  recalculating to a smaller value on toggle (#314, by vyvcodd)
- Fixed job generation hangs in the pipeline
- Fixed in-flight intent not cancelling on force_rebuild
- Fixed 3D rotary rendering missing mapped operations
- Fixed rotary module fallback not triggering pipeline rebuild on
  machine changes
- Fixed a race condition on Windows

## 1.8.5

### Changed

- Upgrade raygeo to 1.21.3 to fix adaptive wavefronts generating
  wave duplicates and mask_scan/dither raster mode ignoring
  step_power
- Group selections in the properties panel no longer reset
  relative positions, angles, and transformations between
  grouped workpieces (#311)

## 1.8.4

### Added

- Speed vs Offset mode in the material test grid for empirical
  bidirectional offset calibration (#312) by Github user vyvcodd.

### Changed

- Major pipeline refactor: replace OpsProducer system with
  assembler registry; all step settings now read/write step
  attributes directly (#309)
- Updated translations

### Fixed

- Upgrade raygeo to 1.12.2 to fix label power in material test
  grid
- Text from addons not translated

## 1.8.3

### Added

- Language selector in the General settings page to change the UI
  language at runtime (#303)
- Drag handle grab gizmo below the selection frame for easier
  workpiece grabbing (#173)
- Support for tool numbers outside the 0-255 range, with new device
  profile for Makera Carvera (#302)
- Air assist toggle to the material test grid (#304)
- CNC spindle and coolant fields in the G-code dialect

### Changed

- Upgrade raygeo to 1.21.1 with faster smoothing and 3D rendering
  performance
- Text rendering now handled by raygeo for better font support
  across platforms
- Updated translations

### Fixed

- G-code placeholders being incorrectly rejected in the encoder
  context
- Axis replacement mode emitting duplicate Y words causing GRBL
  error 25 (#310)
- Toggle buttons of varsets not changing background color when
  toggled on
- Material test grid missing workpiece UID section commands
- Out of memory crash when opening SVG files containing circles
- macOS-only transport test failures (#306)
- Pixi environment solving for osx-arm64 (#306)

## 1.8.2

### Added

- Configurable GRBL protocol variant for Longer Ray5 (by Uwe Woessner)
- Device profile modifications for Longer Ray5 (by Uwe Woessner)

### Changed

- Upgrade raygeo to 1.15.1
- Bump addon API version to 17 for incompatible raygeo changes
- Replace Cairo text path with Pango-based text_to_geometry for robust font
  fallback (#293)
- Defer histogram computation to idle callback and cap render resolution in
  raster widget
- Update pypdf to version 6.12.2
- Update macOS setup to use Brewfile (by Lukas Huber)
- Updated translations

### Fixed

- Various device profiles missing `{extra_cmd}` in G-code dialect causing
  A axis not emitted (#301)
- GRBL buffer stall recovery resending G-code to freshly reset firmware
  after cancel
- Contour producer dropping open contours in Outside/Inside cut modes
- Overscan transformer doubling up for drivers with native overscan (Ruida)
- Website markdown links using trailing-slash bug in React Router

## 1.8.1

### Added

- Wavefront (adaptive clearing) toolpath operation for efficient area
  clearing
- Migrate raygeo from local source to PyPI package

### Changed

- Upgrade raygeo to releases 0.8.0 through 0.13.2 with numerous API
  improvements and renames
- Update dependencies (aiohttp, pypdf) to fix security vulnerabilities
- Updated translations

### Fixed

- Multi-step composite blit positioning for correct step content placement
- GRBL error state recovery when machine enters HOLD
- Backward compatibility for legacy bezier curve formats in raygeo

## 1.8.0

### Added

- LightBurn device profile (.lbdev) import with camera calibration and
  device configuration
- Import LightBurn layer settings as Rayforge step parameters

### Changed

- Updated translations

## 1.8.0-beta3

### Added

- LightBurn (.lbrn / .lbrn2) file format import support

### Changed

- Updated to latest raygeo 0.6 API (Geometry API, bezier_to, fit_curves,
  optimizer, canonical imports)
- Updated translations

### Fixed

- Optimizer no longer splits continuous scanlines
- Tab clip points now correctly scaled by workpiece size to match producer
  transformation
- Fixed multiprocessing warnings on Python 3.12

## 1.8.0-beta2

### Added

- Device profile for the Acmer P3 laser engraver
- Lens calibration dialog with status icons and tooltips in camera
  properties, split from the image settings dialog

### Changed

- macOS app icons updated to Tahoe (Liquid Glass-style) design
- Rotary module selection is now disabled when the machine has no
  rotary modules
- Updated translations

### Fixed

- Slider power value no longer clamped to 1% after dialog re-population

## 1.8.0-beta1

### Added

- Simple GRBL serial driver with ping-pong protocol for devices with
  buffer-counting issues (GrblSerialSimpleDriver)
- "Go to WCS Zero" button in the Current Position section (#247)
- Device profile for the Creality Falcon 10W (#266)
- Device profile for the Sculpfun C1 engraver
- Allow finer raster line spacing (0.001 mm) for microfabrication (#252)
- Deadlock detection toggle in GRBL serial and telnet driver settings

### Changed

- Rewrote Ops container from List[Command] to Struct-of-Arrays with
  index-based access; ported all transformers, encoders, producers, and
  the 3D simulator to the new API
- Migrated tab operations, merge lines, overscan, lead-in/out, and hull
  computation to raygeo 0.6 Rust backend
- Replaced Python raster scan loops with Rust-accelerated raygeo functions
  (rasterize_power_modulation, rasterize_mask_scan, rasterize_multi_pass)
- Delegated image processing to raygeo.image (sRGB conversion, dithering,
  grayscale normalization)
- Adaptive deadlock timeouts based on per-command time estimates instead
  of fixed values
- Machine settings now apply immediately without requiring a restart
- Bumped addon API minimum version to 15 for raygeo 0.6
- File dialogs prefer Rayforge project and sketch MIME types over ZIP

### Fixed

- Fixed O(n) OpPlayer.seek() causing 3D canvas slider to freeze on large
  jobs; now uses pre-computed snapshots with binary search
- Fixed GRBL network disconnect with MKS DLC32 boards (#273)
- Fixed buffer stall recovery aborting jobs during slow moves (#256)
- Fixed machine settings not applying until restart (#267)
- Fixed ValueError when removing the active machine (#280)
- Fixed manual laser control routing
- Fixed WCS dropdown coordinates not updating on sync
- Detect and recover from crashed/unresponsive worker processes (#283)
- Fixed pipeline stress test: stale completions and busy state
- Fixed node state race: emit PROCESSING after task creation
- Skip stale cancelled tasks in worker pool queue
- Shut down multiprocessing Manager in TaskManager.shutdown() to prevent
  semaphore leaks
- Hardened pool shutdown for Windows CI

## 1.7.10

### Fixed

- Fixed contour offset producing hundreds of garbage micro-contours on shapes
  with multiple holes (raygeo v0.2.0)

## 1.7.9

### Added

- Raygeo version info in about dialog

### Fixed

- Fixed mirrored bezier control points and arc parameters in raygeo
- Fixed raster and frame icons not showing on some GTK versions

## 1.7.8

### Added

- Distance preset buttons in Print and Cut wizard for quick selection
- Updated addon API version to 13

### Changed

- Migrated geometry processing from Python to Rust (raygeo) for improved performance

### Fixed

- Fixed WCS offset applied twice in Move to Selection buttons (#245)

## 1.7.7

### Fixed

- Fixed shallow copy of extra_axes in Command causing rotary 3D preview
  distortion (#243)
- Fixed mirrored arcs rendered as full circles in G-code and 3D preview

## 1.7.6

### Added

- Space+drag pan gesture for canvas navigation (#241)
- Custom resolution option for camera image settings

### Fixed

- Fixed capability defaults being overwritten by duplicate step keys (#239)
- Fixed RX buffer override not applied in Creality Falcon device profiles

### Performance

- Numerous performance improvements for raster engraving operations

### Changed

- 2D canvas laser path alpha normalization for improved visibility at low power

## 1.7.5

### Added

- Overcut option for contour operations

### Fixed

- Fixed operations preview misalignment when zooming past the base image
  resolution cap

### Performance

- Massive performance improvements across geometry processing, path
  optimization, and vector operations

## 1.7.4

### Fixed

- Fixed crash when loading GLB models with texture visuals instead of vertex colors
- Improved 3D model lighting with a fill light and raised ambient brightness
- Remapped laser power LUT lookup so low-power paths remain visible

## 1.7.3

### Fixed

- Fixed SVG vector extraction missing group transforms for basic shapes (#237)
- Fixed error when dismissing the import file dialog
- Disabled export/send buttons when pipeline data is stale, with tooltip
  prompting recalculation (F5)

### Changed

- Updated MarlinSerialDriver maturity level to EXPERIMENTAL (#236)
- Updated recalculate button icon in the main toolbar
- Updated translations

## 1.7.2

### Added

- Experimental Marlin driver with probing/auto configuration support (#236)
- Camera resolution selection in camera image settings (#233)
- Camera visibility toggle in SketchStudio (#235)
- RX buffer size override option for GRBL serial driver (#234)

### Fixed

- Fixed job generation stuck after cancellation
- Fixed RX buffer size handling in GRBL serial (#234)
- Fixed atomic buffer space checks and flow control in GrblSerialDriver (#234)
- Fixed cooperative cancellation not working in worker subprocesses

### Changed

- Updated GitPython dependency to 3.1.50
- Various code cleanups

## 1.7.1

### Added

- Add a diode laser 3D model
- Reset button for sketch parameters in the panel
- Boundary tolerance checks for extent and workarea validations

### Fixed

- Fixed Gtk deprecation warning
- Fixed Gtk warning from duplicate WCS row in BottomPanel
- Improved GRBL command parsing and line ending handling

### Changed

- Updated translations

## 1.7.0

### Added

- Configuration wizard with GRBL probing support for automatic device
  detection and setup

### Changed

- Enhance text rendering by integrating Pango for improved layout and metrics

## 1.7.0-beta3

### Added

- Manual laser control dock with per-head power, frequency, pulse width,
  and auto-off timer (#225)
- Search field in the machine profile selector
- Machine profiles for Sculpfun S30 Pro Max, S40 MAX, and S70 MAX,
  and Elidor Z6

### Changed

- Dock layout: new dock items are now placed next to their buddy item
  when restoring a saved layout that doesn't include them
- Serial transport: switch to non-blocking read for improved OS lock
  management (#231)
- Serial transport: offload write operations to executor to prevent
  blocking
- Serial transport: open ports in exclusive mode to avoid clashes with
  other apps
- GRBL: flush serial buffer after every write

### Fixed

- GRBL: cache detected RX buffer size in the machine config file to
  avoid buffer overflows on devices that do not report it via `$I`
- GRBL: laser-off command (M5) no longer sent during active jog, which
  caused error:9
- Deadlock detection triggered incorrectly when status polling was off
- Deadlock detection when GRBL doesn't report Bf: in status reports

## 1.7.0-beta2

### Added

- Job sanity check system that reports machine extent violations, workarea
  violations, and no-go zone collisions before sending or exporting
- Device profiles for 10 popular laser cutters: Ortur LM3/LM4, Atomstack
  X40 Pro/A70, TwoTrees TTS-55, NEJE Master 3 Max, Creality Falcon 2 Pro,
  OMTech Polar 50W, Longer Ray5, and Thunder Laser Nova 35
- Context menus for workpieces in the layer tab (move, delete, properties)
- Context menus in the asset browser with copy, cut, paste, and duplicate
- Paste action in the canvas background context menu
- Visual selection state in layer columns synced with the canvas
- Multi-item selection with Ctrl-click, Shift-click range, and cross-layer
  drag
- Horizontal and vertical auto-constraints from snap guides in the sketcher
  path tool
- Sketch parameters shown as a separate preferences group in the properties
  panel
- Locale-aware number formatting in sliders

### Fixed

- GRBL buffer deadlock from lost ok responses on \r\r\n line endings
- Wrong visibility icon for initially invisible layers
- IndexError when laser combo selection is out of sync with machine heads
- AttributeError on startup from early view_stack signal connection
- Circle and ellipse sketches missing preview thumbnails
- Canvas stuck in shift-pressed state after layer interaction
- Incorrect 3D view mouse controls in the documentation (#229)

## 1.7.0-beta1

### Added

- CO2 laser settings: PWM frequency and pulse width support for compatible
  machines
- Experimental OctoPrint driver (untested)
- Parametric text template support in the sketcher
- Device profile for the Sculpfun iCube Ultra
- Grid toggle button in the 3D canvas visibility overlay
- Project inclusion toggle in the Save Debug Log dialog

### Changed

- Image processing (resize, grayscale, dithering, color LUT) now operates in
  linear light for more accurate results
- Visual improvements to the device profile selector
- Tab power slider is now hidden for non-cut steps

### Fixed

- GRBL buffer overflow on devices with smaller RX buffers
- Parametric text not updating correctly with volatile expressions
- Crash in MergeLinesTransformer when a cutting command appeared before any
  positioning command

## 1.6.1

### Added

- Ruida driver with jogging, position reporting, air assist, layer selection,
  auto-connect, status polling, and ref points support
- Driver maturity enum with warning banner for non-stable drivers
- Generic GRBL, Smoothieware, and Ruida device profiles
- Allow editing workpiece vectors directly (vector deletion) by double clicking
  a workpiece
- Job time estimate shown in 3D canvas

### Changed

- Replace asyncio-serial by threading in serial transport reader loop to reduce
  read buffer overflows when the asyncio loop is congested (#208)
- Print and cut: replace scale checkbox by an adw toggle button
- Project files are now zipped internally
- Creality Falcon A1 profile now uses Grbl Raster dialect

### Fixed

- Pipeline held reference to old machine after switching to a new machine
- Pipeline recalculation loop
- Power percentage rounding in step summary

## 1.6

### Added

- Device profiles replace machine profiles with declarative packages that bundle
  machine config and G-code dialect together
- Export and import UI for sharing device profiles between machines or users
- Per-layer Work Coordinate System (WCS) assignment with edit button in layer
  settings
- Redesigned layer system with visual workflow indicators in each layer column
- Drag-and-drop layer reordering in the layer list
- Workpieces are reorderable in the layer list to change z-order
- Middle-click pan in the layer list
- Layer columns now show subtitles and have limited default width
- New documents start with a default of 3 layers
- Rotary mode now supports true 4th axis and axis replacement (switching X or
  Y for rotary)
- Machine settings offer settings for roller-type rotary axis
- Material test grid supports new parameter combinations with extra speed or
  power labels in multipass mode
- GRBL Telnet driver for networked grblHAL and ESP3D controllers (thanks to
  gyordanov)
- Update checker notifies when a new Rayforge version is available
- Right panel is now a floating overlay for more canvas space
- Values next to sliders are now editable entry fields
- Setting to choose whether ops use layer color or laser color
- Double clicking a workpiece in the layer box opens its properties
- Print and cut addon for aligning laser cuts with printed material (#180)
- Device profile for the Creality Falcon A1
- Right-click context menu for empty canvas space
- Sketcher: support changing text color using the fill tool
- Site search on the Rayforge website
- Sponsor page on the Rayforge website

### Changed

- Major refactoring of kinematics and 3D simulator for better rotary support
- Improved error messages for Grbl alarms
- Kinematics now build dynamically from AxisSet and AxisMapper
- Massively decreased memory usage of multi-layer PDFs
- Reduced memory required for vertex storage by storing power values instead
  of colors
- 2D canvas adapts to rotary mode automatically
- 3D canvas displays rotaries correctly in all configurations
- GRBL serial driver: improved deadlock recovery, comment stripping before
  sending G-code, improved buffer handling
- Air assist state no longer resets between workpieces
- 2D simulator removed (superseded by the 3D simulator)
- Layer settings dialog is now non-modal
- Bottom panel is now visible by default
- Status polling is disabled during job execution by default

### Fixed

- WCS marker not updating in 2D canvas when changing WCS in layer settings
- WCS synchronization fails if device does not report Z coordinates
- Re-syncing WCS with the machine did not clear stale offsets
- G0 and G1 feedrate is shared (#210)
- Air assist disabled after workpiece (#208)
- Sketcher shortcut shadowed by New Project shortcut
- 1 key shortcut shadowed dimension input (#207)
- Canvas not centered when opening a project with rotary layer
- Opening a layer in rotary replacement mode overwrites machine Y dimensions
- Textures not drawn with proper opacity in 3D canvas
- Textures stretched too wide around the cylinder in rotary mode
- 3D canvas axis extent frame with inverted margins when origin is top-right
- 3D canvas not updating ops when rotary config changes
- Laser head not moving in Y in flat mode
- Cylinder not rotating during playback
- Drawing trails behind laser in rotary simulation
- Clipping when zooming in 3D canvas in orthographic view
- No Z in G-code for rotary in Z replacement mode
- G-code for rotary missing rotary command
- Terminal window visible on Windows
- Debouncing caused material test not to update when switching presets (#187)
- Deleting the active machine could lead to no machine being active
- Stale ops in 3D canvas after deleting a layer
- Multiple GRBL serial driver robustness improvements
- GRBL alarm codes were mapped to wrong error descriptions
- Snap fails to launch with gpu-2404 slot not connected error (#196)
- Pipeline applied gear ratio even for visual representation (#195)
- Delayed main thread callbacks not cancellable via handle.cancel()
- GRBL sending initial $I as realtime command though it is not one
- Base image of inverted SVG not inverted after import
- Rotary cylinder rendered with diameter of chuck instead of workpiece (#195)
- Beta version string parsing for debian releases
- Zero axis not working over GRBL network connection (#220)
- Jog distance not applying when entered via keyboard (#221)
- Gtk imported in worker subprocesses (#224)
- Various Gtk warnings

## 1.5.2

### Fixed

- G-code production could fail if no rotary axis commands were defined
- G5 commands in LinuxCNC and Marlin templates did not respect the omit
  unchanged axis flag
- 2D canvas showing stale ops when operation generates zero ops
- Model preview showing models in wrong orientation by default
- Point light not turning off when laser is off
- Potential race conditions in the pipeline and 3D canvas
- Model preview now displays colors correctly

## 1.5.1

### Changed

- Post processor page is more compact by putting each post processor into an expander
- 3D canvas: better line width for rendered ops

### Fixed

- GRBL serial not connecting (#196)
- Auto brightness toggle setting not remembered in raster step settings

## 1.5

### Added

- 3D simulator with full playback: play/pause, step forward/backward, scrubber,
  and speed control (1x to 16x)
- End-to-end bezier curve support (G5) through the entire pipeline, from import
  to G-code output
- No-go zones: define restricted areas in machine settings with collision checking
- 3D model support for rotary axes (GLB format) with shading and proper coloring
- Global model manager for storing and reusing 3D models across machines
- Import dialog now offers three layer modes: flatten, merge to existing, or
  create new layers
- Imported layers automatically get sensible default workflow steps
- Dockable bottom panel: tabs can be rearranged freely and split into separate
  columns
- Layer list moved into the bottom panel with drag-and-drop from asset list
- Asset browser overhaul: all assets visible, multi-selection, drag to canvas,
  thumbnails for most image formats, helpful empty-state placeholder
- Lead-in / lead-out postprocessor for zero-power approach and exit moves
- Material test: labels engraved first for cleaner results
- Material test: overscan transformer support
- Material test: independent label engraving speed setting
- Ctrl+F search in console and G-code viewer
- Addons can register their own toggles in the View menu
- YUYV camera protocol support
- Canvas remembers state of view toggles between sessions
- Double clicking a stock asset opens its properties
- Drag assets from the asset list to the layer list
- Continuous laser mode and modal feedrate G-code options
- GRBL raster dialect that omits unnecessary M4/M5 spindle commands
- Grbl MKS DLC32 machine profile
- Laser head model rendered in the 3D simulator

### Changed

- Canvas is significantly more responsive during drag, pan, and zoom operations
  by suppressing expensive path rendering until interaction stops
- Multi-step workflows composite into a single surface for faster rendering
- Large images are automatically scaled to prevent multi-gigabyte memory spikes
- Image handling rewritten to avoid unnecessary copies, reducing overall RAM usage
- Smarter caching: base images cached on source assets and reused across workpieces
- Cache memory limit in the 2D canvas prevents unbounded memory growth
- Time estimation updates instantly instead of recomputing from scratch
- Pipeline recalculation can now be toggled off in settings
- Status bar removed; machining time moved to layer list header, ETA to machine
  dropdown, status messages to canvas overlay
- Visibility toggles for perspective, model, and no-go zones moved to canvas
  overlays
- Rows in main window expanders are more compact
- Bottom panel layout of coordinate controls and jog widget is responsive
- Decreased default merge lines tolerance to 0.01
- Crop-to-stock now crops to workarea if no stock is defined in the document
- Illustrator files now use correct 72 DPI instead of 70

### Fixed

- Race condition causing 2D canvas re-renders to hang
- Race condition in doceditor.wait_until_settled_sync()
- Status overlay displayed even when no message was set
- Stale job shown in 3D canvas after changes
- 3D canvas not showing dimmed versions of travel moves
- Wide strokes rendered incorrectly in import dialog preview
- Item layers not added when importing from the command line
- Tabs cutting paths in more than one place
- Addon installation failing in Snap packages
- 2D and 3D canvas stealing focus from the sketcher
- Sketch parameters could not be edited in the properties panel
- Crop-to-stock linearized arcs unnecessarily
- Deadlock when switching WCS while 3D canvas visible
- 3D canvas not updating fully after hardware changes
- Toggling no-go zones off undimmed vertices in the 3D canvas
- Mapping of stepped down vertices in rotary mode
- Drag and drop bug in the asset browser
- No G-code output if document contained an empty layer
- Editing machine settings resetting the canvas perspective
- Single instance lock: second window now gracefully exits
- Two memory leaks in the 3D simulator (shared memory and shader)
- 3D canvas empty if G-code viewer was not open

## 1.4.1

### Changed

- PDF import now falls back to `fitz` when `pymupdf` is not installed (#186)
- DPI setting in the SVG import dialog is now persistent between sessions

## 1.4

### Added

- Full rotary axis support with 3D visualization
- Support for multiple rotary modules
- Configurable rotary mode per layer
- Rotary icon displayed on rotary layers
- PDF direct vector import with layer support
- Improved five factor camera de-distortion algorithm
- Charuco card based calibration wizard with guided setup process
- Sketcher: ellipse tool replaces circle tool for more flexibility
- Sketcher: many tools automatically constrain geometry during creation
- Sketcher: magnetic snap now works while creating geometry
- Sketcher: replaced snap to grid with smarter magnetic snap
- Sketcher: equality constraint now works on ellipses
- Configure frame speed in laser head settings
- Corner dwell time setting for framing
- Repeat count setting for framing
- New merge lines post-processor to avoid double cutting
- Machine profile for Acmer S1 added
- Dialects support separate laser on command for focusing
- Add a DPI setting to the SVG import dialog if the SVG is unitless

### Changed

- More compact left panel layout with add buttons moved into group headers
- G-code viewer moved into the bottom panel
- 3D canvas performance improvements
- Dialects are now isolated copies (templates)
- GRBL buffer size tracking improved
- Texture dimension limit prevents memory exhaustion
- Addon manager: safer threading approach

### Fixed

- Material test producer bugs (issues #181 and #182)
- GRBL position reporting for machines with only X and Y axes (#179)
- Sketcher: distance constraint shadowing the line
- Texture renderer memory exhaustion on large images
- Race condition in worker initialization

## 1.3.2

### Added

- Raster step settings now display angle numerically

### Fixed

- Import issues on Windows
- Unknown G-code dialects now fall back to Grbl instead of causing errors
- Duplicate error notifications from the driver

## 1.3.1

### Fixed

- Icon sizing issues on systems with Gtk 4.21
- Windows and macOS build issues
- Conflicting menu shortcuts in the sketcher

## 1.3

### Added

- Sketcher: full support for bezier curves with intuitive handle-based editing
- Sketcher: new unified path tool that combines lines and curves
- Sketcher: grid tool for visual reference and alignment
- Sketcher: toggle buttons to show/hide construction geometry and constraints
- Sketcher: hold Shift to constrain movement to the nearest axis
- Sketcher: endpoints connected by coincident constraint can be made smooth or symmetric
- Sketcher: "straighten" tool to convert bezier curves to straight lines
- Sketcher: path edit tool can now connect to existing points
- Sketcher: conflicting constraints now shown in the panel
- Raster operation: sample interval and power levels settings
- G-code viewer now shows line count and byte size

### Changed

- Sketcher moved to an add-on (installed and enabled by default)
- G-code now omits unchanged coordinates for more compact output
- Removed obsolete "no-Z" G-code dialect variants
- G-code viewer always shows at least the first 20,000 lines
- Sketcher: hide gray background area for cleaner editing
- AI workpiece generator now creates sketches when geometry can be mapped

### Fixed

- Most icons not displayed on systems with Gtk 4.21 or higher
- Fillet and chamfer tools not working correctly
- Texture encoder drawing spaced dots instead of lines in some cases
- G1 emitted without coordinates when all coordinates unchanged
- Loading project files with unknown assets

## 1.2.1

### Added

- Buttons to move to center, bottom/left and top/right of workpiece
- Support for setting a "tab power"
- Sketcher: allow entering dimensions while adding geometry

### Changed

- Better button layout in the control panel
- Sketcher: circle now uses diameter constraint consistently, not sometimes radius
- Laser dot now always drawn on top, not obscured by workpieces

### Fixed

- Builtin addon yaml files not included in .snap
- Imprecise tab location while dragging the tab handle
- Tabs not working on beziers

## 1.2

### Added

- AI workpiece generation
- Camera image enhancement with temporal noise reduction (thanks
  to MausRundung)
- Fisheye lens distortion correction with radial and tangential parameters
  (thanks to MausRundung)
- Zoom, pan and keyboard navigation in camera alignment dialog
  (thanks to MausRundung)
- Complete addon system rewrite and refactoring
- Tons of new materials in core materials addon
- Sketcher: live preview for line tool
- Sketcher: show dimensions while adding geometry
- Sketcher: snap-to-grid on Ctrl press
- Sketcher: highlight hovered entities and constraints
- Sketcher: toolbar shows currently available shortcuts
- Sketcher: Shift+Double click selects connected geometry
- Sketcher: allow arc radius changes while adding second arc endpoint
- Path optimizer now also optimizes inter-workpiece travel
- Mach4 G-code dialect
- Post-processor: crop-to-stock
- Click canvas to set zero feature
- Support for configuring cut/raster colors per laser
- Support for duplicating stock and non-rectangular stock
- Convert workpiece to stock (right-click menu)
- RAYFORGE_DISABLE_3D environment variable
- Machine profile for OMTech K40+
- Navigation and zoom icons for UI controls

### Changed

- Stock is now a document-level concept - no more stock per layer
- Improved camera selection dialog (left/right indicators, keyboard support)
- Imported items and stock now aligned with WCS origin by default
- Stock placed at WCS origin by default
- Sketcher: preserve selection when creating lines, arcs, or circles
- Sketcher symmetry constraint click order now aligns with FreeCAD
- Maximum laser G-code power increased to 100.000
- Addon terminology changed from "plugin" to "addon"
- Context now lazy loads most services for better performance

### Fixed

- Undoing text box left entries in history manager stack
- Y axis drawn on wrong side of canvas
- Auto layout for rotated stock
- SVG exporter stacking multiple workpieces on top of each other
- Text color in Sketcher while editing
- When opening project file referencing non-existent laser, assign default laser
- Text box rotates while typing on Windows
- Addon handling issues on Windows

### macOS Specific

- Narrow macOS app menu window to MainWindow - pgilfernandez
- macOS app menu actions fix - pgilfernandez

## 1.1.2

### Fixed

- Text box rotating while typing in sketcher
- Assets cannot be deleted after loading from a project file
- Empty sketches showing as black squares after loading from project
- Maybe: Pie menu not opening in correct location on Windows

## 1.1.1

- Fix screenshot link in appstream file causing Flatpak build to fail.

## 1.1

### Added

- Major: MacOS support was added thanks to Github user pgilfernandez!
- Major: Complete data pipeline backend rewrite with improved performance
  and memory management
- Major: Unified raster operations - the old "raster", "depth", and
  "dither" operations are now replaced by a single, unified raster operation
- Major: G-code console replacing the log view with a fully featured terminal
- SVG and DXF export support - export your documents or selected objects
- Angle constraints now available in the sketcher
- New "Raster (Dither)" operation type with configurable algorithms
- Built-in G-code dialect supporting dynamic power mode
- Auto thresholding for Variable Power and Multipass raster modes
- Histogram in raster engraver to help setting thresholds
- Symbolic visualization of raster direction in rasterizer
- Configurable line distance in all raster operations
- Axis extents, work surface, and soft limits can now be configured per machine
- RAYFORGE_MAX_WORKERS environment variable to limit the number of processes
- macOS packaging scripts and resources for better platform support
- `--uiscript` CLI argument for executing scripts after the UI is up
- Optional (opt-in) anonymous usage statistic collection
- Material files can now contain translations

### Changed

- Machine selector moved to the window header for easier access
- G-code viewer and control panel toggles are now independent
- Machine settings dialog reorganized for better clarity
- Pressing "reset position" on a workpiece places it at WCS origin,
  not machine origin
- Workpiece properties now show the position in WCS coordinates
- Contour and shrinkwrap operations use proper tolerance instead of
  laser dot size
- Increased maximum laser spot size to 10 mm
- File dialog now selects BMP by default instead of all supported files
- Imported images are now placed at reference origin by default
- Added Ukrainian translations
- Re-assigned Alt key bindings to avoid clashing with main menu actions

### Fixed

- Multiple memory leaks in the data pipeline
- Race conditions between worker pool task completion and pipeline shutdown
- Camera device scanning crash on Windows
- Multipass post-processor exception
- Rasterizer angle causing distortion
- Various macOS issues: shm_open length errors, SVG rendering fallback,
  keyboard shortcuts
- Workpiece stage not emitting correct node state
- Zoom resolution stuck until resizing at least once
- Blurry view overlay on startup
- Race condition leads to stale vectors for cancelled tasks
- Memory for view artifacts released late
- Unresponsive serial ports now handled gracefully with log message
- Simulation preview strokes now stay constant across zoom levels
- Speed entered in Jog dialog is now correctly converted to base units
- Switching to 3D view sometimes showed no operations
- Some icons not appearing when running the snap on non-GNOME environments
- GRBL connection handshake timeout handled with backoff retry

## [1.0.1] - 2026-02-01

### Fixed

- Some strings were not translatable
- Reformatted the 1.0 appstream release notes to not trip the Flatpak build up

## [1.0] - 2026-02-01

### Added

- Major: Project save/load support
- Major: The sketcher now supports text, with many bells and whistles
- Major: The jog dialog has been merged together with the log view into a bottom panel
- Sketcher supports aspect ratio constraints
- Engraving steps now have an invert setting
- The raster engraver now supports setting the engraving angle in degrees
- A recent files menu entry was added
- Installers for all platforms now register the .ryp (project) and .rfs (sketch) file extensions

### Changed

- Command line interface: `--direct-vector` renamed to `--vector`; added
  `--trace` to force trace mode. Default is now to try vector import first,
  falling back to trace if not supported
- Import errors now collected and displayed in import dialog
- Importers almost completely rewritten for testability
- Sketcher: The solver now biases points to their previous position for more stable dragging
- Simulation mode keyboard shortcut changed to F11 to avoid conflic with "Save as..."
- Remember G-code view and control panel visibility across sessions
- Increased precision of power sliders and display digits everywhere
- Import dialog now shows number of vectors per layer
- Error message shown when attempting to delete a dialect that is in use
- Chinese translations were added
- When opening bitmap images from CLI, default to import the whole image, not tracing

### Fixed

- Traceback in the sketcher when adding a constraint (affected Windows build only)
- Fixed a potential memory leak and stale ops display
- Multi layer DXF import
- Numerous alignment bugs in importers
- Traceback when using invert switch in import dialog
- Sketches not properly centered on the surface after import

### Documentation

- Updated importer developer documentation

### Build

- Added hicolor-icon-theme dependency to snap build

## [0.28.4] - 2026-01-22

### Fixed

- Traceback when dialect contained deprecated attributes
- Debian package missing asyncudp dependency

## [0.28.3] - 2026-01-18

### Added

- Option to enable/disable WCS injection in G-code dialect

### Fixed

- Depth engraver not respecting master power setting
- Traceback when using invert image in import dialog

## [0.28.2] - 2026-01-17

### Fixed

- Test that depended on specific version string

## [0.28.1] - 2026-01-17

### Fixed

- Invalid ampersand in appstream XML

## [0.28] - Work Coordinate Systems, True Arcs, and a New Package Manager

### Added

- Full support for Work Coordinate Systems (WCS) G54-G59
  - "Set Origin Here" button to define temporary work zero at any point
  - Visual feedback with active WCS origin marked on 2D canvas
  - 3D view renders geometry relative to active WCS
  - WCS integrated across G-code encoder, 2D/3D views, and GRBL drivers
  - Ability to create set G-code offsets in machine settings
  - Offline configuration of WCS settings and offsets
- True arc support and superior geometry handling
  - DXF and SVG importers now preserve arcs and bezier curves
  - Machine settings to configure arc support and tolerance
  - Non-uniform scaling of designs with arcs handled gracefully
- Package Manager for extensibility
  - Install, update, and manage extensions
  - Automatic update checks on startup
- New Sketcher tools
  - Rectangle tool with support for rounded rectangles
  - Fillet tool for rounded corners
  - Chamfer tool for beveled corners
- Machine connectivity improvements
  - Configurable GRBL polling (disable during job runs)
  - GRBL corruption detection
  - GRBL error messages more descriptive
  - Support for reading WCO and extended status fields
- User interface enhancements
  - "Import whole image" checkbox for direct raster import
  - Multi-layer SVG import option
  - Supporter recognition section in About dialog
  - Maintenance counter alerts link to maintenance counter page
  - Sketch instances automatically added to document on creation

### Changed

- G-code generator now strips unneeded trailing zeros
- Diagonal jogging now jogs in a direct line instead of two separate commands
- Connection and device errors displayed prominently next to device selector
- Debug log button moved from log view to help menu
- Stock list and sketch list merged into unified asset list
- Importing complex DXF and SVG files is now significantly faster
- Makera Air G-code now uses inline power commands
- G-code dialect editor now checks variable existence and bracket balance

### Fixed

- Job Control & Safety
  - Application getting stuck in "Running" state after job cancellation
  - Race condition where driver alarms might self-clear
- Framing
  - Runaway issue with framing position drifting cumulatively
  - Framing bounds calculation for full circles
- Machine & Drivers
  - Position reporting not updating until machine settings saved
- Import Fixes
  - SVG import dialog not allowing direct vector import of SVGs without layers
  - Vector misalignment when importing certain SVG files
  - DXF import failing on files with blocks containing solid fills
  - Raster image with tracing threshold set to 1 not importing full image
- Platform-Specific Fixes
  - (Windows) Dialog closing passing focus to wrong window
  - (Windows) PNG files not opening via file selector
- General Fixes
  - Duplicate axis labels drawn on canvas
  - Depth Engraver treating semi-transparent pixels as black
  - Material test grid including invalid power on/off toggles
  - Laser position indicator updating infrequently or moving wrong direction
  - Incorrect position readout in Jog dialog
  - Inconsistent button states during G-code job execution
  - Recipes not saved correctly when creating from step settings dialog
  - Multi-layer SVGs incorrectly imported as single layer
  - Coordinate systems issues for machines with negative axes
  - G-code dialect changes not applied without restart
  - Selected laser parameters not loading initially in machine settings UI
  - Imported SVGs not scaled correctly when resized non-uniformly
  - 3D canvas turntable rotation broken
  - Axis grid not aligned for machines without bottom left origin
  - Tracebacks and crashes in machine settings dialog and G-code generation
  - `pluggy` and `GitPython` dependencies not included in Debian package

## [0.27.1] - Maintenance Release

### Changed

- Importing complex SVG files is now significantly faster through intelligent
  path simplification

### Fixed

- SVG files with complex or invalid clipping paths rendered incorrectly
- Fills in sketches loaded from disk could not be toggled on or off
- On-screen position of laser dot not taking machine's configured origin into
  account

## [0.27] - Enhanced Sketching, Machine Control & UI Refinements

### Added

- Expressions and parameters in sketches
  - Expression editor with syntax highlighting and auto-completion
  - Instance parameters for each sketch instance
- Filled shapes support in sketcher
- Rounded rectangle tool
- Drag-select for multiple sketch elements
- Variable substitutions in preamble and postscript G-code sections
- Support for machines with top-right and bottom-right origins
- Negative axis support
- Configurable single-axis homing option
- Machine hours recording support
- Intro video to homepage

### Changed

- Sketches treated as "templates" that can be placed multiple times
- Sketch parameters have dedicated section in properties panel
- Construction line dash lengths measured in pixels for consistent look
- Double-clicking stock opens stock properties
- `Ctrl+N` shortcut for creating new sketch
- "Preferences" renamed to "Settings"
- "Edit Recipe" dialog uses three tabs: General, Applicability, Settings to Apply
- `ESC` and `Ctrl+W` close machine settings
- Machine settings menu entry cleaned up by removing "..."
- Raster import dialog renamed to "Import Dialog"
- Export sketch default location is original import location
- Many icons replaced with built-in icons
- Machine settings dialog redesigned for clearer layout
- Dark mode text readability improvements
- Asset list unified (stock and sketch lists merged)
- "New Sketch" button removed from main toolbar
- Main window no longer updates unnecessarily on workpiece transforms

### Fixed

- Import dialog not working correctly for many file formats
- Focus-related bugs in sketcher
- Sketches not resizable using drag and drop
- Editing sketch resetting instance's size on canvas
- Distance constraints not selectable or highlighting on hover
- Arcs going in wrong direction in sketch-generated geometry
- Titles from varset not properly escaped
- "Reverse axis" setting affecting G-code output
- Race condition in GRBL serial driver
- Boolean variables in device settings not applied
- Key text in simulation mode not readable in dark mode
- Popover not readable in dark mode in camera alignment dialog
- Laser dot drawn too large
- Varset variables with type Var not subclassed showing as "unsupported"
- Menu not closing when clicking surface
- Missing icons on some Linux distributions
- Race condition in tasker test
- Expression editor not closing when pressing enter
- Sketch not using input parameters
- Varset out of sync after var key rename
- Dragging sketches to surface failing
- Step list drag & drop reordering broken
- Sketches not positioned at center of sketcher surface when re-editing
- Excessive linearization precision causing lag
- Pyright detecting invalid `str` argument in machine dialect definition
- Perpendicular constraint hit detection
- Radius constraints not always recognized
- Constrained geometry not being green after loading sketch

## [0.26] - Parametric 2D Sketcher & Major Performance Upgrades

### Added

- Parametric 2D Sketcher
  - Create 2D geometry with lines, circles, and arcs
  - Constraint system: Coincident, Vertical, Horizontal, Tangent,
    Perpendicular, Point on Line/Shape, Symmetry, Distance, Diameter,
    Radius, Equal Length/Radius
  - Import/Export sketches with parametric constraints preserved
  - Context-aware pie menu for quick tool access
  - Keyboard shortcuts inspired by FreeCAD
  - Full undo/redo support
- Adaptive precision grid based on zoom level
- Machine profile for Makera Carvera Air CNC machine

### Changed

- Default cut mode for vector CAM operations changed to 'Centerline'
- Significant performance optimizations for moving, scaling, rotating geometry
- Significantly reduced memory consumption
- Complex vector files handled more smoothly during toolpath generation

### Fixed

- 3D view and G-code output mirrored when using Y-down machine configuration
- Smoothieware driver issues
- `.dxf` files not visible in import dialog
- Save button incorrectly enabled when workflow is empty

## [0.25] - Import Workflow Overhaul

### Added

- Interactive import dialog with pre-canvas configuration
- Enhanced tracing configuration in import dialog
- Threshold slider for contour operation
- "Object -> Split Workpiece" command
- Groups now have "natural size" property
- Support for configuring custom G-code dialects
- DXF layer support for importing as Groups

### Changed

- Tracing logic improved for transparent images
- Contour operation now processes inner edges before outer edges (configurable)
- Debouncing in processing pipeline for snappier UI

### Fixed

- Geometry incorrectly removed from vector inputs if cut side not "centerline"
- Items scaled down on import even when fitting machine area
- Step box displaying 0% power regardless of actual setting
- Workpiece operations not drawn correctly when grouping/ungrouping
- Imported images displayed with masks
- Notifications not cleared when user begins editing

## [0.24] - 2025-11-07

### Added

- Operation Recipes: Save and reuse operation settings (laser head, speed,
  power, kerf) for specific operation types
- Automatic recipe selection based on operation type, machine, stock material,
  and thickness
- Dedicated profile for xTool D1 Pro with updated start G-code macros (M17 and
  M106)
- Support for configuring specific port numbers for Grbl connections
- Session-based log file system for easier troubleshooting and debugging
- Dialog to display metadata associated with imported images
- Dedicated option to toggle laser on at low power for easy focusing

### Changed

- Step settings dialog now has tabs, separating post-processing settings
- Windows distribution now uses "onedir" installer bundle for faster startup
- Machine branding strings updated from "Xtool" to "xTool" capitalization
- Macros can now be executed directly from main application menu
  (Machine -> Macros)

### Fixed

- Various issues causing application crashes on Windows systems
- Race condition in logging setup that could lead to duplicate log entries
- Workpieces retaining stale operation settings after cut and paste to new layer
- "Remove inner edges" function failing to execute correctly
- Tracebacks when copying elements with tabs
- Incorrect tab placement during shrinkwrap or frame operations
- Segmentation fault during certain import scenarios
- Task bar remaining visible after completing import operations
- Global shortcuts incorrectly captured while editing text fields in workpiece
  properties panel
- Logging reliability by ensuring all logs flushed before application exits

## [0.23.2] - 2025-11-03

### Fixed

- Crashes on Windows due to Gtk 4 API incompatibility
- Crash when sending job due to not running event loop

## [0.23.1] - 2025-11-02

### Added

- New Windows installer
- French translation

### Changed

- RayforgeContext object introduced for future API support
- ArtifactStore refactored

### Fixed

- Git command line briefly opening on Windows startup
- Test suite issues on Windows
- "Reset to natural size" buttons not working for DXF and Ruida imports
- Warning for resizing on import now persistent until dismissed
- Debouncing for some step settings
- Bug where two events in rapid succession could cause stale operations

## [0.23] - 2025-10-25

### Added

- G-code Viewer & Simulator with full playback and synchronized G-code text
- Depth Engraver operation for multi-pass engravings with varying depths
- Shrink Wrap operation for form-fitting contours
- Frame operation for rectangular frames around workpieces
- Material Test Grid tool for finding optimal power and speed settings
- Material Manager in settings for managing material libraries and materials
- Flip & Mirror tools for horizontal/vertical object flipping
- Engraving overscan option for maintaining constant velocity
- Offset and kerf compensation for cutting operations
- Native importers for JPEG, full-color PNG, and BMP files
- Jog controls dialog for manual laser positioning
- Multi-head laser support with step assignment to specific heads
- Cross-hatch fill option for Raster Engraving operation
- Stock material assignment to individual layers
- Machining time estimate in status bar with progress and ETA during execution
- Preferred length unit setting in preferences
- Machine acceleration values in machine profiles
- Snap to grid functionality (Ctrl key while moving/rotating)
- Adjustable rasterizer threshold with undo/redo support
- French translation

### Changed

- Backend almost completely redesigned for performance
- Task manager redesigned around process pool
- Toolpath optimizer significantly faster and enabled by default
- Rendering pipeline uses shared memory for faster data transfer
- Tracing engine switched to vtracer for higher quality
- Stock handling completely redesigned
- "Edge" and "Outline" producers merged into single "Contour" operation
- Higher baud rates supported for serial connections
- GRBL streaming protocol supported

### Fixed

- Dependencies not correctly installed when installing with pip
- 3D view not updating correctly when toggling step visibility
- Contour operation now produces path even if offsetting fails
- Traceback when zooming into large workpiece
- Alignment issues across all importers
- PDF importer clipping direction bug
- SVG importer vector alignment problems

## [0.22] - 2025-10-01

### Added

- Tabbing system for holding parts in place during cutting
  - Flexible configuration (global or per-step)
  - Automatic placement
  - Manual control via context menu
  - Interactive editing with drag handles
- G-code macros and hooks with variable substitution
- Direct SVG vector import option

### Changed

- Work surface panning smoother
- Grouping and ungrouping faster
- Main menu and toolbar reorganized with keyboard shortcuts
- Global preference for UI speed units
- Step settings dialog closes with Esc or Ctrl+W
- Workpieces automatically scaled down if too large for surface
- DXF and Ruida imports pre-split into component parts
- Auto-layouter respects stock boundaries
- PDF importer auto-crops to content

### Fixed

- Select All (Ctrl+A) not selecting groups correctly
- Misleading error for non-existent serial ports
- Task manager warning on shutdown
- Auto-layouter 90° rotation bug

## [0.21] - 2025-09-14

### Added

- Micrometric resolution support for imports and G-code generation
- Configurable decimal places in G-code output
- Stock material area definition
- Device alarm reset button for GRBL machines
- Automatic alarm reset on connection option
- Official PPA for Ubuntu

### Changed

- Snap package now supports GRBL serial port connections
- Camera backend on Linux defaults to V4L2
- New icons for layers
- Workpiece properties panel reorganized
- Connection and device status messages now translated

### Fixed

- 3D editor switch not working
- Device drivers not shutting down correctly on close
- Flickering "RUN" status with GrblSerial devices

## [0.20.2] - 2025-08-20

### Fixed

- ImportError when opening the app

## [0.20.1] - 2025-08-20

### Added

- Context menu on work surface (right-click)

### Changed

- Baud Rate field now a dropdown

### Fixed

- Crash during job execution
- Serial Grbl driver issues
- USB port selection lost when machine disconnected
- Layer list rendering artifacts
- Camera view alignment

## [0.20] - 2025-08-19

### Added

- 3D G-Code Previewer with orbit, pan, zoom controls
- Z Step Down per Pass option
- DXF importer with full geometry support
- Ruida (.rd) importer
- Auto-Layout tool
- Shear tool for skewing workpieces
- Grouping and ungrouping support

### Changed

- ESC key deselects items on canvas
- Smoothing algorithm replaced with more effective version
- Operation generation more efficient

### Fixed

- Invalid G-code when travel speed not set
- On-screen laser dot position slightly misplaced
- Resizing multiple selected objects incorrectly in Y-up mode
- Export Debug Log not working
- Creating new machine from profile failing
- Windows installer issues

## [0.19.1] - 2025-08-08

### Fixed

- Traceback on Windows startup
- Missing icons on Windows

## [0.19] - 2025-08-???

### Added

- New GRBL drivers (Network and Serial Port) with firmware settings UI
- Canvas alignment tools (top, bottom, left, right, center)
- Object distribution tools (horizontal, vertical)
- Ctrl+PageUp/PageDown for moving objects between layers
- Themed icon support for light/dark themes
- Ctrl + < shortcut for machine settings
- Spanish translation

### Changed

- Canvas and camera stream performance improved
- Default camera overlay opacity 20%
- Status icons replaced with modern symbolic icons

### Fixed

- "Remove All Workpieces" button not working
- Worksteps unnecessarily regenerated when unrelated step removed
- "Smoothness" slider not functional
- Canvas grid aspect ratio issue
- Rendering failure with large on-screen dimensions
- Camera toggle not updating canvas immediately
- On-screen laser dot position

## [0.18.4] - 2025-08-04

### Fixed

- Custom postscript used even if disabled
- Machine config lost on startup (race condition)
- Home, Pause and Cancel buttons not working
- Laser dot shown in wrong position when zoomed

## [0.18.3] - 2025-08-03

### Added

- --version CLI flag

### Changed

- Sliders in workstep settings now smoother (debouncing)

### Fixed

- Ops not removed when deleting workpiece
- Performance: removing step no longer re-generates all steps
- Subtitle not showing in driver selection if no driver initially selected

## [0.18.2] - 2025-08-03

### Added

- Experimental GRBL driver

### Fixed

- Performance regression for canvas rendering

### Changed

- Workstep settings dialog can be moved

## [0.18.1] - 2025-08-03

### Fixed

- Camera stream not disabling when switching machines
- Performance regression for canvas rendering

## [0.18] - 2025-08-03

### Added

- Layer support
- Multi-machine support
- Machine profiles (Sculpfun iCube, Other)
- G-code dialects (Marlin, GRBL, Smoothieware)
- Theme preferences with dark mode improvements
- Debug information collection button in machine view

### Changed

- Main window panel redesigned
- Paths more precise with reduced rounding errors
- Smoothing algorithm polished
- Camera rendering speed massively improved

### Fixed

- Boundary alignment for rastering with chunked images
- Smoothing angle threshold up to 179 degrees
- Travel optimizer running when disabled
- Driver description not shown in dropdown subtitle

## [0.17] - 2025-07-28

### Added

- Undo and redo support for all actions
- Main menu at top of window
- Copy, cut, paste support
- Ctrl+D duplicate shortcut
- Multiple selection in canvas
- Select-by-frame support
- Flipped Y-axis support
- About dialog with version info

## [0.16.2] - 2025-07-25

### Fixed

- Non-square work surfaces shown as square (now proper aspect ratio)

## [0.16.1] - 2025-07-25

### Fixed

- Path disappearing when zooming

## [0.16] - 2025-07-25

### Added

- Improved resize tool
- Workpiece rotation
- Path smoothing option in work step dialog
- Better progress bar with status messages
- Progress shown during export operations

### Changed

- Canvas now displays travel move optimization result
- Worksteps processed in parallel
- Larger surfaces supported via tiling (removes 32,000 x 32,000 limit)

### Fixed

- Numerous Windows EXE bugs

## [0.15] - 2025-07-???

### Added

- Camera alignment UI with on-screen editing
- German and Portuguese languages
- Smoothieware support (via Telnet)

### Fixed

- Many Windows EXE bugs, test suite now passes in CI/CD

## [0.14] - 2025-07-12

### Added

- Camera configuration (USB cameras via OpenCV)
- Live feed picture overlay on canvas
- Image settings (white balance, brightness, contrast, transparency)
- Image alignment and de-distortion support

## [0.13] - 2025-07-10

### Added

- GRBL serial connection support
- Workpiece properties panel for precise position and dimensions
- Experimental Windows installer
