barebaric/rayforge/website/i18n/hi/docusaurus-plugin-content-docs/current/machine/maintenance.md

---
description:
  "लेज़र कटर रखरखाव गाइड — नियमित सफ़ाई, संरेखण जाँच, और घटक देखभाल से अपनी मशीन को शीर्ष स्थिति में
  रखें."
---

# रखरखाव

मशीन सेटिंग्स का रखरखाव पृष्ठ आपको मशीन उपयोग ट्रैक करने और रखरखाव कार्य निर्धारित करने में मदद करता
है.

रखरखाव सेटिंग्स

## उपयोग ट्रैकिंग

Rayforge ट्रैक करता है कि आपकी मशीन कितने समय से उपयोग में है. यह जानकारी आपको उचित अंतरालों पर
निवारक रखरखाव निर्धारित करने में मदद करती है.

### कुल घंटे

कुल घंटे काउंटर मशीन पर जॉब चलाने में बिताए गए सभी समय को ट्रैक करता है. यह संचयी काउंटर रीसेट नहीं
किया जा सकता और मशीन उपयोग का पूरा इतिहास देता है.

समग्र मशीन आयु ट्रैक करने और बड़े सर्विस अंतरालों की योजना बनाने के लिए इसका उपयोग करें.

## कस्टम रखरखाव काउंटर

विशिष्ट रखरखाव अंतराल ट्रैक करने के लिए आप कस्टम काउंटर बना सकते हैं. प्रत्येक काउंटर का एक नाम होता
है, घंटे ट्रैक करता है, और अधिसूचना थ्रेशोल्ड के साथ कॉन्फ़िगर किया जा सकता है.

### काउंटर बनाना

1. नया काउंटर बनाने के लिए जोड़ें बटन पर क्लिक करें
2. एक वर्णनात्मक नाम दर्ज करें (जैसे, "Laser Tube", "Belt Tension", "Mirror Cleaning")
3. चाहें तो घंटों में एक अधिसूचना थ्रेशोल्ड सेट करें

### काउंटर सुविधाएँ

- **कस्टम नाम**: किसी भी रखरखाव कार्य के लिए काउंटर लेबल करें
- **घंटा ट्रैकिंग**: जॉब निष्पादन के दौरान समय स्वतः संचित करता है
- **अधिसूचना थ्रेशोल्ड**: रखरखाव देय होने पर याद दिलाए
- **रीसेट क्षमता**: रखरखाव करने के बाद काउंटर रीसेट करें

### उदाहरण काउंटर

**Laser Tube**: प्रतिस्थापन की योजना बनाने के लिए CO2 ट्यूब घंटे ट्रैक करें (प्रायः 1000-3000 घंटे).
आगे की योजना बनाने के लिए 2500 घंटों पर अधिसूचना सेट करें.

**Belt Tension**: अंतिम बेल्ट टेंशनिंग के बाद के घंटे ट्रैक करें. रखरखाव करने के बाद रीसेट करें.

**Mirror Cleaning**: अंतिम दर्पण सफ़ाई के बाद के उपयोग ट्रैक करें. सफ़ाई के बाद रीसेट करें.

**Bearing Lubrication**: बेयरिंग रखरखाव अंतरालों के लिए घंटे ट्रैक करें.

## काउंटर रीसेट करना

रखरखाव करने के बाद, प्रासंगिक काउंटर रीसेट करें:

1. काउंटर के बगल में रीसेट बटन पर क्लिक करें
2. संवाद में रीसेट की पुष्टि करें
3. काउंटर शून्य पर वापस आ जाता है

<!-- prettier-ignore-start -->
:::tip[रखरखाव कार्यक्रम]
सामान्य रखरखाव अंतराल:

- **दैनिक**: लेंस साफ़ करें, दर्पण संरेखण जाँचें
- **साप्ताहिक**: रेल साफ़ करें, बेल्ट तनाव जाँचें
- **मासिक**: बेयरिंग लुब्रिकेट करें, विद्युत कनेक्शन जाँचें
- **वार्षिक**: पूर्ण निरीक्षण, घिसे हुए पार्ट बदलें

अपने उपयोग पैटर्न और निर्माता की अनुशंसाओं के आधार पर अंतराल समायोजित करें.
:::
<!-- prettier-ignore-end -->

## यह भी देखें

- [लेज़र सेटिंग्स](laser) - लेज़र हेड कॉन्फ़िगरेशन
- [हार्डवेयर सेटिंग्स](hardware) - मशीन विमाएँ
