barebaric/rayforge/website/i18n/de/docusaurus-plugin-content-docs/current/troubleshooting/connection.md

# Verbindungsprobleme

Diese Seite hilft dir, Probleme beim Verbinden von Rayforge mit deiner Lasermaschine über serielle
Verbindung zu diagnostizieren und zu lösen.

## Schnelldiagnose

### Symptome

Häufige Verbindungsprobleme sind:

- "Port muss konfiguriert werden"-Fehler beim Verbindungsversuch
- Verbindung schlägt wiederholt fehl und verbindet sich neu
- Serieller Port erscheint nicht in der Portliste
- "Zugriff verweigert"-Fehler beim Versuch, den seriellen Port zu öffnen
- Gerät scheint verbunden zu sein, reagiert aber nicht auf Befehle

---

## Häufige Probleme und Lösungen

### Keine seriellen Ports erkannt

**Problem:** Das serielle Port-Dropdown ist leer oder zeigt dein Gerät nicht an.

**Diagnose:**

1. Prüfen, ob dein Gerät eingeschaltet und über USB verbunden ist
2. Versuche, das USB-Kabel abzuziehen und wieder anzustecken
3. Teste das USB-Kabel mit einem anderen Gerät (Kabel können ausfallen)
4. Versuche einen anderen USB-Port an deinem Computer

**Lösungen:**

**Linux:**

Zuerst füge deinen Benutzer zur `dialout`-Gruppe hinzu (erforderlich für Snap- und
Nicht-Snap-Installationen auf den meisten Debian-basierten Distributionen):

```bash
sudo usermod -a -G dialout $USER
```

Dann abmelden und wieder anmelden, damit die Änderung wirksam wird.

Wenn du die Snap-Version verwendest, musst du außerdem serielle Port-Berechtigungen gewähren:

```bash
sudo snap connect rayforge:serial-port
```

Siehe [Snap-Berechtigungen](snap-permissions) für detaillierte Linux-Einrichtung.

**Windows:**

1. Geräte-Manager öffnen (Win+X, dann Geräte-Manager auswählen)
2. Suche unter "Anschlüsse (COM & LPT)" nach deinem Gerät
3. Wenn du ein gelbes Warnsymbol siehst, aktualisiere oder installiere den Treiber neu
4. Notiere die COM-Port-Nummer (z.B. COM3)
5. Wenn das Gerät überhaupt nicht aufgeführt ist, kann das USB-Kabel oder der Treiber defekt sein

**macOS:**

1. Systeminformationen → USB prüfen, um zu verifizieren, dass das Gerät erkannt wird
2. CH340/CH341-Treiber installieren, wenn Ihr Controller diesen Chipsatz verwendet
3. Nach `/dev/tty.usbserial*` oder `/dev/cu.usbserial*`-Geräten suchen

### "Zugriff verweigert"-Fehler

**Problem:** Du erhältst "Permission denied" oder ähnliche Fehler beim Versuch zu verbinden.

**Unter Linux:**

Dein Benutzer muss in der `dialout`-Gruppe sein (oder `uucp` bei einigen Distributionen). Dies ist
für **Snap- und Nicht-Snap-Installationen** auf Debian-basierten Distributionen erforderlich, um
AppArmor DENIED-Meldungen zu vermeiden:

```bash
# Dich selbst zur dialout-Gruppe hinzufügen
sudo usermod -a -G dialout $USER

# Verifizieren, dass du in der Gruppe bist (nach Abmelden/Anmelden)
groups | grep dialout
```

**Wichtig:** Du musst dich abmelden und wieder anmelden (oder neu starten), damit Gruppenänderungen
wirksam werden.

**Zusätzlich für Snap-Installationen**, gewähre dem Snap seriellen Port-Zugriff:

```bash
sudo snap connect rayforge:serial-port
```

Siehe den Leitfaden [Snap-Berechtigungen](snap-permissions) für weitere Details.

**Unter Windows:**

Schließe alle anderen Anwendungen, die den seriellen Port verwenden könnten, einschließlich:

- Frühere Rayforge-Instanzen
- Serielle Monitor-Tools
- Andere Laser-Software
- Arduino IDE oder ähnliche Tools

### Falscher serieller Port ausgewählt

**Problem:** Rayforge verbindet sich, aber die Maschine reagiert nicht.

**Diagnose:**

Du hast möglicherweise den falschen Port ausgewählt, besonders wenn mehrere USB-Geräte verbunden
sind.

**Lösung:**

1. Alle anderen USB-Seriell-Geräte trennen
2. Notieren, welche Ports in Rayforge verfügbar sind
3. Deinen Laser-Controller einstecken
4. Die Portliste aktualisieren - der neue Port ist dein Laser
5. Unter Linux erscheinen Laser-Controller typischerweise als:
   - `/dev/ttyUSB0` (häufig für CH340-Chipsätze)
   - `/dev/ttyACM0` (häufig für native USB-Controller)
6. Unter Windows die COM-Port-Nummer aus dem Geräte-Manager notieren
7. Vermeide Ports namens `/dev/ttyS*` unter Linux - dies sind Hardware-Seriell-Ports, nicht USB

<!-- prettier-ignore-start -->
:::warning[Hardware-Seriell-Ports]
Rayforge warnt dich, wenn du `/dev/ttyS*`-Ports unter Linux
auswählst, da diese typischerweise keine USB-basierten GRBL-Geräte sind. USB-Seriell-Ports verwenden
`/dev/ttyUSB*` oder `/dev/ttyACM*`.
:::
<!-- prettier-ignore-end -->

<!-- prettier-ignore-start -->
:::tip[Maschine wechselt nach Wiederverbindung den Port]
Wenn sich der Port deiner Maschine ändert
(z. B. von `/dev/ttyUSB0` zu `/dev/ttyUSB1`) nach einem Neustart oder Wiederverbinden, binde sie
über ihre USB-Identität: Gib die VID:PID des Geräts (z. B. `0403:6001`) in das Feld für den
seriellen Port ein, anstatt einen Port-Pfad. Die automatische Wiederverbindung folgt der Maschine
dann zu ihrem neuen Port. Siehe
[Seriellen Port binden](../machine/general.md#serieller-port-binden).
:::
<!-- prettier-ignore-end -->

### Falsche Baudrate

**Problem:** Verbindung wird hergestellt, aber Befehle funktionieren nicht oder produzieren
verstümmelte Antworten.

**Lösung:**

GRBL-Controller verwenden typischerweise eine dieser Baudraten:

- **115200** (am häufigsten, GRBL 1.1+)
- **9600** (ältere GRBL-Versionen)
- **250000** (weniger häufig, einige benutzerdefinierte Firmware)

Versuche verschiedene Baudraten in Rayforge's Geräteeinstellungen. Die häufigste ist **115200**.

### Verbindung bricht ständig ab

**Problem:** Rayforge verbindet sich erfolgreich, trennt und verbindet sich aber ständig neu.

**Mögliche Ursachen:**

1. **Wackeliges USB-Kabel** - Mit bekannt funktionierendem Kabel ersetzen (vorzugsweise kurz, <2m)
2. **USB-Stromprobleme** - Versuche einen anderen USB-Port, vorzugsweise am Computer selbst statt an
   einem Hub
3. **EMI/Interferenzen** - USB-Kabel von Motorleitungen und Hochspannungsnetzteilen fernhalten
4. **Firmware-Probleme** - Aktualisiere deine GRBL-Firmware wenn möglich
5. **USB-Port-Konflikte** - Unter Windows verschiedene USB-Ports versuchen

**Fehlerbehebungsschritte:**

```bash
# Unter Linux Systemprotokolle während des Verbindens überwachen:
sudo dmesg -w
```

Suche nach Nachrichten wie:

- "USB disconnect" - deutet auf physische/Kabelprobleme hin
- "device descriptor read error" - oft ein Strom- oder Kabelproblem

### Gerät reagiert nach Verbindung nicht

**Problem:** Verbindungsstatus zeigt "Verbunden", aber die Maschine reagiert nicht auf Befehle.

**Diagnose:**

1. Prüfen, dass der korrekte Firmware-Typ ausgewählt ist (GRBL vs. andere)
2. Verifizieren, dass die Maschine eingeschaltet ist (Controller und Netzteil)
3. Prüfen, ob die Maschine in einem Alarmzustand ist (erfordert Referenzfahrt oder Alarm-Löschen)

**Lösung:**

Versuche, einen manuellen Befehl in der Konsole zu senden:

- `?` - Statusbericht anfordern
- `$X` - Alarm löschen
- `$H` - Maschine referenzieren

Wenn es keine Antwort gibt, überprüfe Baudrate und Port-Auswahl.

---

## Verbindungsstatus-Meldungen

Rayforge zeigt verschiedene Verbindungsstatus:

| Status | Bedeutung | Aktion |
| --- | --- | --- |
| **Getrennt**  | Nicht mit einem Gerät verbunden | Port konfigurieren und verbinden |
| **Verbinde**  | Versucht, Verbindung herzustellen | Warten, oder Konfiguration prüfen wenn hängenbleibend |
| **Verbunden** | Erfolgreich verbunden und empfängt Status | Bereit zur Verwendung |
| **Fehler** | Verbindung mit Fehler fehlgeschlagen | Fehlermeldung für Details prüfen |
| **Ruhend** | Wartet vor Wiederverbindungsversuch | Vorherige Verbindung fehlgeschlagen, erneut versuchen in 5s |

---

## Deine Verbindung testen

### Schritt-für-Schritt Verbindungstest

1. **Die Maschine konfigurieren:**
   - Einstellungen → Maschine öffnen
   - Ein Maschinenprofil auswählen oder erstellen
   - Den korrekten Treiber wählen (GRBL Serial)
   - Den seriellen Port auswählen
   - Baudrate einstellen (typischerweise 115200)

2. **Verbindungsversuch:**
   - Auf "Verbinden" im Maschinen-Bedienfeld klicken
   - Den Verbindungsstatus-Indikator beobachten

3. **Kommunikation verifizieren:**
   - Wenn verbunden, versuche eine Statusabfrage zu senden
   - Die Maschine sollte ihre Position und ihren Status melden

4. **Grundlegende Befehle testen:**
   - Referenzfahrt versuchen (`$H`) wenn deine Maschine Endschalter hat
   - Oder Alarme löschen (`$X`) falls erforderlich

### Debug-Protokolle verwenden

Rayforge enthält detaillierte Protokollierung für Verbindungsprobleme. Um Debug-Protokollierung zu
aktivieren:

```bash
# Rayforge vom Terminal mit Debug-Protokollierung ausführen
rayforge --loglevel DEBUG
```

Prüfe die Protokolle auf:

- Verbindungsversuche und Fehlschläge
- Serielle Daten gesendet (TX) und empfangen (RX)
- Fehlermeldungen mit Stack-Traces

---

## Erweiterte Fehlerbehebung

### Port-Verfügbarkeit manuell prüfen

**Linux:**

```bash
# Alle USB-Seriell-Geräte auflisten
ls -l /dev/ttyUSB* /dev/ttyACM*

# Berechtigungen prüfen
ls -l /dev/ttyUSB0  # Mit deinem Port ersetzen

# Sollte zeigen: crw-rw---- 1 root dialout
# Du musst in der 'dialout'-Gruppe sein

# Port manuell testen
sudo minicom -D /dev/ttyUSB0 -b 115200
```

**Windows:**

```powershell
# COM-Ports in PowerShell auflisten
[System.IO.Ports.SerialPort]::getportnames()

# Oder Geräte-Manager verwenden:
# Win + X → Geräte-Manager → Anschlüsse (COM & LPT)
```

### Firmware-Kompatibilität

Rayforge ist für GRBL-kompatible Firmware konzipiert. Stelle sicher, dass dein Controller läuft:

- **GRBL 1.1** (am häufigsten, empfohlen)
- **GRBL 0.9** (älter, kann eingeschränkte Funktionen haben)
- **grblHAL** (moderner GRBL-Fork, unterstützt)

Andere Firmware-Typen (Marlin, Smoothieware) werden derzeit nicht über den GRBL-Treiber unterstützt.

### USB-zu-Seriell-Chipsätze

Häufige Chipsätze und ihre Treiber:

| Chipsatz | Linux | Windows | macOS |
| --- | --- | --- | --- |
| **CH340/CH341** | Eingebauter Kernel-Treiber | [CH341SER-Treiber](http://www.wch.cn/downloads/) | Erfordert Treiber |
| **FTDI FT232** | Eingebauter Kernel-Treiber | Eingebaut (Windows 10+) | Eingebaut |
| **CP2102 (SiLabs)** | Eingebauter Kernel-Treiber | Eingebaut (Windows 10+) | Eingebaut |

---

## Immer noch Probleme?

Wenn du alles oben versucht hast und immer noch keine Verbindung herstellen kannst:

1. **Die GitHub-Issues prüfen** - Jemand hat möglicherweise das gleiche Problem gemeldet
2. **Einen detaillierten Issue-Bericht erstellen** mit:
   - Betriebssystem und Version
   - Rayforge-Version (Snap/Flatpak/AppImage/Quellcode)
   - Controller-Board-Modell und Firmware-Version
   - USB-Chipsatz (Geräte-Manager unter Windows oder `lsusb` unter Linux prüfen)
   - Vollständige Fehlermeldungen und Debug-Protokolle
3. **Mit einer anderen Anwendung testen** - Versuche, dich mit einem seriellen Terminal (minicom,
   PuTTY, Arduino Serial Monitor) zu verbinden, um zu verifizieren, dass die Hardware funktioniert

---

## Verwandte Seiten

- [Snap-Berechtigungen](snap-permissions) - Linux Snap-Berechtigungseinrichtung
- [Debug-Modus](debug) - Diagnose-Protokollierung aktivieren
- [Allgemeine Einstellungen](../machine/general.md) - Maschineneinrichtungsleitfaden
- [Geräteeinstellungen](../machine/device.md) - GRBL-Konfigurationsreferenz
