barebaric/rayforge/website/i18n/uk/docusaurus-plugin-content-docs/current/machine/maintenance.md

# Технічне обслуговування

Сторінка "Обслуговування" у налаштуваннях машини допомагає відстежувати використання машини та
планувати завдання з технічного обслуговування.

Налаштування обслуговування

## Відстеження використання

Rayforge відстежує, як довго ваша машина використовується. Ця інформація допомагає планувати
профілактичне обслуговування у відповідних інтервалах.

### Загальні години

Лічильник загальних годин відстежує весь час, витрачений на виконання завдань на машині. Цей
кумулятивний лічильник не може бути скинутий і забезпечує повну історію використання машини.

Використовуйте це для відстеження загального віку машини та планування основних інтервалів
обслуговування.

## Власні лічильники обслуговування

Ви можете створювати власні лічильники для відстеження специфічних інтервалів обслуговування. Кожен
лічильник має назву, відстежує години та може бути налаштований з порогом сповіщення.

### Створення лічильника

1. Натисніть кнопку додати, щоб створити новий лічильник
2. Введіть описову назву (наприклад, "Лазерна трубка", "Натяг паса", "Очищення дзеркала")
3. Встановіть поріг сповіщення в годинах, якщо бажаєте

### Функції лічильника

- **Власні назви**: Позначте лічильники для будь-якого завдання обслуговування
- **Відстеження годин**: Автоматично накопичує час під час виконання завдань
- **Пороги сповіщень**: Отримуйте нагадування, коли обслуговування необхідне
- **Можливість скидання**: Скидайте лічильники після виконання обслуговування

### Приклади лічильників

**Лазерна трубка**: Відстежуйте години трубки CO2 для планування заміни (зазвичай 1000-3000 годин).
Встановіть сповіщення на 2500 годин, щоб планувати заздалегідь.

**Натяг паса**: Відстежуйте години з моменту останнього натягу паса. Скиньте після виконання
обслуговування.

**Очищення дзеркала**: Відстежуйте використання з моменту останнього очищення дзеркала. Скиньте
після очищення.

**Змащування підшипників**: Відстежуйте години для інтервалів обслуговування підшипників.

## Скидання лічильників

Після виконання обслуговування ви можете скинути відповідний лічильник:

1. Натисніть кнопку скидання поруч із лічильником
2. Підтвердьте скидання в діалозі
3. Лічильник повертається до нуля

:::порада Графік обслуговування Типові інтервали обслуговування:

- **Щодня**: Очистіть лінзу, перевірте вирівнювання дзеркал
- **Щотижня**: Очистіть рейки, перевірте натяг пасів
- **Щомісяця**: Змастіть підшипники, перевірте електричні з'єднання
- **Щороку**: Повний огляд, замініть зношені частини

Налаштуйте інтервали на основі ваших моделей використання та рекомендацій виробника. :::

## Дивіться також

- [Налаштування лазера](laser) - Конфігурація лазерної головки
- [Налаштування обладнання](hardware) - Розміри машини
