barebaric/rayforge/(threads)

Thread 3 (2025-05-12):

how to use a GRBL laser cnc via usb/serial ?

ErwanMAS, 2025-05-12:
My hardware is a Genmitsu 3018-PROVer with  laser Kit .

This is connected via usb/serial .

knipknap, 2025-05-12:
Rayforge only supports network connection, no USB/Serial support yet. To add it, someone who has such a device would have to implement the support. (I don't.)

knipknap, 2025-07-10:
Serial connections are now supported in release 0.13.

Thread 6 (2025-08-02):

The cut won't start.

zamby, 2025-08-02:
I'm pressing Start, but it's not working. I'm using FluidNC over the network because I don't see the USB device in the setup.
The above exception was the direct cause of the following exception:

Traceback (most recent call last):
  File "/snap/rayforge/123/lib/python3.12/site-packages/rayforge/tasker/task.py", line 88, in run
    await self._task
  File "/snap/rayforge/123/lib/python3.12/site-packages/rayforge/widgets/mainwindow.py", line 591, in send_coro
    await driver_mgr.driver.run(ops, config.machine)
  File "/snap/rayforge/123/lib/python3.12/site-packages/rayforge/driver/grbl.py", line 239, in run
    await self._upload(gcode, 'rayforge.gcode')
  File "/snap/rayforge/123/lib/python3.12/site-packages/rayforge/driver/grbl.py", line 188, in _upload
    async with session.post(
  File "/snap/rayforge/123/lib/python3.12/site-packages/aiohttp/client.py", line 1488, in __aenter__
    self._resp: _RetType = await self._coro
                           ^^^^^^^^^^^^^^^^
  File "/snap/rayforge/123/lib/python3.12/site-packages/aiohttp/client.py", line 770, in _request
    resp = await handler(req)
           ^^^^^^^^^^^^^^^^^^
  File "/snap/rayforge/123/lib/python3.12/site-packages/aiohttp/client.py", line 748, in _connect_and_send_request
    await resp.start(conn)
  File "/snap/rayforge/123/lib/python3.12/site-packages/aiohttp/client_reqrep.py", line 534, in start
    raise ClientResponseError(
aiohttp.client_exceptions.ClientResponseError: 400, message="Invalid status code:\n\n  b'HTTP/1.1 1 '\n              ^", url='http://192.168.188.102/upload'
2025-08-02 14:09:14,692 - rayforge.tasker.manager - ERROR - Unhandled exception in managed task 'send-job':
Traceback (most recent call last):
  File "/snap/rayforge/123/lib/python3.12/site-packages/aiohttp/client_proto.py", line 315, in data_received
    messages, upgraded, tail = self._parser.feed_data(data)
                               ^^^^^^^^^^^^^^^^^^^^^^^^^^^^
  File "aiohttp/_http_parser.pyx", line 558, in aiohttp._http_parser.HttpParser.feed_data
aiohttp.http_exceptions.BadStatusLine: 400, message:
  Invalid status code:

    b'HTTP/1.1 1 '
                ^

The above exception was the direct cause of the following exception:

Traceback (most recent call last):
  File "/snap/rayforge/123/lib/python3.12/site-packages/aiohttp/client_reqrep.py", line 532, in start
    message, payload = await protocol.read()  # type: ignore[union-attr]
                       ^^^^^^^^^^^^^^^^^^^^^
  File "/snap/rayforge/123/lib/python3.12/site-packages/aiohttp/streams.py", line 672, in read
    await self._waiter
aiohttp.http_exceptions.HttpProcessingError: 400, message:
  Invalid status code:

    b'HTTP/1.1 1 '
                ^

The above exception was the direct cause of the following exception:

Traceback (most recent call last):
  File "/snap/rayforge/123/lib/python3.12/site-packages/rayforge/tasker/manager.py", line 132, in _run_task
    await task.run(context)
  File "/snap/rayforge/123/lib/python3.12/site-packages/rayforge/tasker/task.py", line 88, in run
    await self._task
  File "/snap/rayforge/123/lib/python3.12/site-packages/rayforge/widgets/mainwindow.py", line 591, in send_coro
    await driver_mgr.driver.run(ops, config.machine)
  File "/snap/rayforge/123/lib/python3.12/site-packages/rayforge/driver/grbl.py", line 239, in run
    await self._upload(gcode, 'rayforge.gcode')
  File "/snap/rayforge/123/lib/python3.12/site-packages/rayforge/driver/grbl.py", line 188, in _upload
    async with session.post(
  File "/snap/rayforge/123/lib/python3.12/site-packages/aiohttp/client.py", line 1488, in __aenter__
    self._resp: _RetType = await self._coro
                           ^^^^^^^^^^^^^^^^
  File "/snap/rayforge/123/lib/python3.12/site-packages/aiohttp/client.py", line 770, in _request
    resp = await handler(req)
           ^^^^^^^^^^^^^^^^^^
  File "/snap/rayforge/123/lib/python3.12/site-packages/aiohttp/client.py", line 748, in _connect_and_send_request
    await resp.start(conn)
  File "/snap/rayforge/123/lib/python3.12/site-packages/aiohttp/client_reqrep.py", line 534, in start
    raise ClientResponseError(
aiohttp.client_exceptions.ClientResponseError: 400, message="Invalid status code:\n\n  b'HTTP/1.1 1 '\n              ^", url='http://192.168.188.102/upload'

knipknap, 2025-08-02:
Thank you for the bug report! Can you paste the version info from the about dialog?

knipknap, 2025-08-19:
Since several releases were made since and the potential fix, and no others have reported this, I am closing the issue. But feel free to re-open if the issue persists.

Closed 2025-08-19.

Thread 7 (2025-08-03):

Marlin v2.1.1+ dialect: G moves with S

WildRikku, 2025-08-03:
I noticed you implemented GCode dialects and that's great! I'd like to suggest one that has become possible by newer Marlin versions and is used by my setup.

Since Marlin 2.1.1, S for power can be included with G0 and G1 (usually G1 since G0 is for travel moves). That would remove the need to turn the laser on and off with M commands during the operation, however, it is not defined if G0 and G1 share the value (meaning G0 would be with laser on when S was set on G1) or not. So it might be sensible to do `G0 Xx Yy S0 ... G1 Xx Yy Ss`.

The way the Creality software does it is different though and I am not entirely sure why: It uses `G1 S3` to turn the laser down before every G0 travel move. So their code looks like:

```
G92 X0 Y0 Z0
G90
G0 F3000
G1 F1500
M3 I
G0 X87.999 Y55.555
G1 S3
G0 X78.111
G1 X77.999 S501
G1 X42.333 S999
G1 X42.222 S501
G0 X32.333
G1 X32.222 Y55.555 S3
```

I'm not entirely sure what's going on there and will investigate, however, I wanted to point out the variant with S in the G command since I think that's currently not possible with the template you created, because that's one more variable to replace.

knipknap, 2025-08-03:
I see, thank you for the issue and for looking into this! I think it wouldn't be hard to add support for this in the dialect objects. The GcodeEncoder would need some changes to support it, but I think it is mostly trivial changes.

WildRikku, 2025-09-28:
I needed my printer for a bunch of 3D printing, but I'll have another laser project the next couple days and I'll take a look and give you feedback!

WildRikku, 2025-10-06:
Just to let you know: Due to my weird setup, I'm waiting for the 0.23 release to come to PyPi, which has the fixes for installation via pip. As soon as that drops, I'll run some tests. Thank you for your patience and effort.

Thread 9 (2025-08-10):

Group/ungroup feature

xupwup, 2025-08-10:
**Is your feature request related to a problem? Please describe.**
After importing a DXF, I want to move parts of the drawing. My DXF is made by onshape and contains auto-layouted components. I want to move things to optimally use my material.

**Describe the solution you'd like**
A group/ungroup feature. In this case mainly ungroup (the entire dxf file seems to be one group). I also expected to find this in the right-click menu, but there doesn't seem to be one.

**Describe alternatives you've considered**
you could theoretically split the dxf into pieces in another tool

**Additional context**
Add any other context or screenshots about the feature request here.

knipknap, 2025-08-11:
I thought about it, and it's even more complicated 😄 . Because resizing a group of already-rotated workpieces requires a new type of transformation (shearing/matrix transformation) for each workpiece. So this affects pretty much the entire application from import to generation to output. Implementation plan:

1. Add support for matrix transformations and for shearing single workpieces in the UI.
2. Change core data model to support groups: Introduce DocItem which contains attributes shared between Layer, Workpiece, and WorkpieceGroup. This involves changing the ops generator pipeline to support groups as well.
3. Change the canvas and UI to support grouping/ungrouping.
4. Change the importer.

I will try to make it part of release 0.20.

knipknap, 2025-08-19:
Released with Rayforge 0.20. Please re-open if you have any issues with it.

Thread 13 (2025-08-21):

Migrate potrace to a version that doesn't depend on native libraries

matoushybl, 2025-08-21:
**Is your feature request related to a problem? Please describe.**
I tried running rayforge on Arch, but stumbled upon the dependency potrace requiring the agg native library to be present on the system, this library was only available in AUR, but even with it installed, rayforge couldn't start because of missing symbols.

**Describe the solution you'd like**
I think it would be beneficial to move away from this library. There are multiple benefits - less dependencies and support for multiple platforms - like running the software on a RPi or other hardware with different architectures. There is an alternative in [this](https://github.com/tatarize/potrace) library which seems to implement the same API only using numpy, but even this library doesn't seem to be actively maintained.

**Describe alternatives you've considered**
* Use a different bitmap tracing solution

**Additional context**
I should be able to contribute a change like this myself, but I wanted to present this idea first before doing it. I understand that Arch support is not a requirement for this project, but I believe there are other more clear benefits of moving.

What do you think?

knipknap, 2025-08-21:
That would be nice! The problem with the pure python potrace is that it is slow... extremely so. Maybe using it as a fallback? I have not found any other tracers that come close in quality and speed to the one I used in the end.

I originally even started out with my own tracer, but while the basics are easy, it gets nontrivial when you want it to succeed on edge cases ...

matoushybl, 2025-08-22:
That makes sense, I thought all of the heavy lifting was done by numpy, but it doesn't seem so.
I also found [this](https://github.com/visioncortex/vtracer) in one of potrace's PRs, it is a Rust library (more easily manageable when using natively) with python bindings. It even directly compares to AGG and potrace. I'll try using it an report back the results.

knipknap, 2025-09-24:
So the app has changed so much since I made this branch that I re-did it based on latest master. It seems to work decently well, perhaps it also benefited from a couple of denoiser and image importer improvements that I made recently.

I am tempted to make the switch to vtracer, also because of #29 @cejote. But it would help if someone else also tested it...

fllmn, 2025-09-25:
Not a problem, right now I'm targeting release 0.22 for the flatpak build. If there's new release before that's done I can just drop the potrace dependency.

knipknap, 2025-09-29:
Merged with 305fee72a3c75df3a827c3dbc2504af2ce293f65

matoushybl, 2025-09-30:
Sorry for the inactivity and broken promises.

Thanks for the amazing work on the app! Looking forward to using my laser again after a lot of frustration with lightburn and meerkat.

Closed 2025-09-29.

Thread 15 (2025-08-28):

Feature request: Support for micrometric resolution and scaled G-code workflow

LorenzoTell, 2025-08-28:
Hello,

I would like to share some work I did on Rayforge related to high-resolution micrometric engraving and propose a potential feature improvement. I made a Direct Laser Lithography System and this software comes handy in the workflow of all the open-source tools developed in LabµFab (Arg)

I managed to unpack the snapd package using a custom script on my machine (Lenovo, Intel Core i3-2310M, 7.6 GB RAM, Intel HD Graphics 3000, running Manjaro Linux with KDE Plasma 6.3.6, Qt 6.9.1, kernel 5.15.189). After unpacking, I modified the script to allow the print head in X and Y axes to work with a step size of 0.001 mm. Additionally, I modified the G-code generation to work with a scaled visualization, making it easier to design micrometric engravings on screen. The G-code is then rescaled automatically for the actual engraving. Finally, the script repackages everything back into a snapd and now I use the software with this mods.

It would be ideal if this functionality—a range of work unit scales—could be added as a feature in the preferences, so users can directly set micrometric or custom scales without needing to unpack and modify the snap manually.

I was unable to set up the development environment on my machine due to issues with pypotrace and potrace. That's why I unpacked the Snapd Install.

The software is a great and a measured response to a big necessity. I want to sincerely thank Barebaric for developing this software. There was nothing similar available for Linux, and my personal attempts to create something alike over the past two months only led to headaches and failed tries. I will be following the development of the program closely, and when possible, I would love to donate to support the excellent work you’ve done.

knipknap, 2025-08-28:
Wow, that sounds like an awesome set of features! Anywhere I can look at the changes you made?

I will try to provide an easier way to get a development environment running as well.

LorenzoTell, 2025-08-28:
I felt a bit embarrassed to push a branch with such rough hardcoding, but I can definitely share the modifications.

gcode.py with the mods: https://github.com/LorenzoTell/Misselaneous/blob/debdde04c3d3793268563b734d779adec51ccc79/gcode.py

In laser_preferences_page.py I changed the "lower" value from 0.01 to 0.001:

spot_size_x_adjustment = Gtk.Adjustment(
    lower=0.001,
    upper=0.2,
    step_increment=0.01,
    page_increment=0.05,
)
spot_size_y_adjustment = Gtk.Adjustment(
    lower=0.001,
    upper=0.2,
    step_increment=0.01,
    page_increment=0.05,
)

This enable me to work in microscale with x10 scale svg images, and when gcode is generating I return them to original size. Thats because script importer, maybe how cairo is being implemented, lower the import resolution of the images (lower resolution for me is not being able to import a 30µm feature)

knipknap, 2025-09-10:
I just pushed support for this. The machine settings now have a new setting for the precision under "Advanced":

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

You can test by upgrading from the Snap edge channel.
Let me know if you have any issues with it.

Thread 16 (2025-09-05):

Decouple UI from using OpsGenerator directly

knipknap, 2025-09-05:
Currently the surface "owns" the OpsGenerator. This is not ideal for testability, and makes it hard to add other UIs.

This issue is to investigate architectural changes to achieve better decoupling.

This should also include adding end to end tests for import to generated results.

Thread 20 (2025-09-10):

Connecting a GRBL usb machine on linux

niekiebasson-dev, 2025-09-10:
Good day.

The Bug
When trying to connect my Grbl controlled CNC with Rayforge, no port selection window appears when selecting "GRBL (Serial)" in the machine preferences. I have tried with Version 0.20.2post5 Version 0.20.2post4 and the stable versions 0.20.1 and 0.20.2. Unfortunately none of the "Serial" options opened a selection box from where I can select the port or device to use with Rayforge. I have noticed on a Youtube video https://www.youtube.com/watch?v=5g8ivET-c0w&t=84s at 1:36 the video shows a selection box for the port selection as well as baudrate where my installation does not give these options.

Will you be able to assist?

Screenshot of setup page.
https://github.com/user-attachments/assets/e61d952d-a16b-4939-9dad-f7415cfd95db

Screenshot of system details
https://github.com/user-attachments/assets/8d1b7f5a-b403-4048-b464-9158aaa39c28

https://github.com/user-attachments/files/22256448/rayforge_debug_2025-09-10_16-06-56.zip

niekiebasson-dev, 2025-09-10:
Thank you for the prompt response.
I see the following
#USERNAME adm tty dialout cdrom sudo dip plugdev users lpadmin systemd-journal

knipknap, 2025-09-10:
Hrm, that is all perfectly fine. I think I was on the wrong track and this is not related to your serial config itself at all.

Can you try to delete your config (rm -R ~/.config/rayforge) and see if that changes anything?

If it does not, can you try running from the command line like so:

`rayforge --loglevel DEBUG`

to see if there is any relevant log output?

knipknap, 2025-09-10:
I also just added two commits:
- one to warn if there are permission issues (not likely to help as we excluded that as the source of your problem)
- one that changes how the UI is updated, possibly fixing the error

niekiebasson-dev, 2025-09-10:
Hi

Have done the update to Version 0.20.2post2,1also restarted the PC. Same results for opening from snapstore as well as terminal rayforge --loglevel DEBUG

Log files from  DEBUG run
[rayforge_debug_2025-09-10_22-11-48.zip](https://github.com/user-attachments/files/22262185/rayforge_debug_2025-09-10_22-11-48.zip)

And Screenshot
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

Closed 2025-09-13.

Thread 24 (2025-09-18):

Embedded generators

klattimer, 2025-09-18:
There are already python libraries for generating cool laser cutting things, e.g. https://github.com/florianfesti/boxes and https://github.com/lkesteloot/jigsaw

It seems that it would be fairly simple to create, at least at first, a basic UI for accessing the functions of libraries like this to provide an attractive feature set.

knipknap, 2025-09-18:
Thanks for the feature request! I think this would be cool to have. I was thinking that things like this would be especially great to support the creation of material libraries in the app.

I am not sure yet if I would add this to the app directly, or if I would implement addon support first...

Thread 31 (2025-09-24):

ARM architecture target (RaspberryPi, etc)

srsabu, 2025-09-24:
Is anyone else working on attempting to get Rayforge to run under Raspbian (or similar ARM based Linux)?  I've started to look at it, and I'm currently learning what I need to about Pixi but wanted to see if there were opportunities to collaborate or at least not replicate something someone else was doing.

knipknap, 2025-09-24:
I am not aware of anyone working on it. One thing that maybe would make this easier is if #13 were done, as potrace and libagg are the biggest headaches to get running...

fllmn, 2025-09-25:
I'm at least intending to figure out if the flatpak builds/runs on aarch64 as part of #28  as it needs to included in the flatpak meta data.

I'll let you know how it goes

fllmn, 2025-09-26:
Good news, it does build under emulation (qemu) although it takes ages. Runs better than expected on a RPi 3 but I won't be able to test cutting right new

srsabu, 2025-09-27:
I'm kicking off a flatpak build (on the Pi 4).  We'll see how long it takes.

srsabu, 2025-10-02:
So the build has died a few times on the Pi 4 (always on OpenCV).  I am getting a heatsink/fan for it to see if it's just throttling to un-usability based on the prolonged load.

Thread 41 (2025-10-02):

Refactor stock handling (to support materials later)

knipknap, 2025-10-02:
While thinking about supporting materials, I realized that the current approach for handling stock is a flawed design. Material MUST be a StockItem feature, not a WorkPiece feature, because otherwise you might encounter multiple materials in a single layer, which is not intended and not going to work - a layer is supposed to define a single process, so by design it cannot work on multiple materials at the same time.

# Stock Architecture Refactoring Plan

## Overview

This document describes the required refactoring of the stock architecture to support material assignment and multiple stock items per document.

## Current Issues

1. **Single Stock Constraint**: Current architecture assumes one stock layer per document - all layers operate on the same stock
2. **Material Assignment**: Materials need to be assigned to StockItems, not WorkPieces
3. **Layer-Stock Relationship**: Layers need to reference which stock they operate on
4. **Multiple Stock Support**: Need to support multiple different stock items in the same document

## New Architecture Requirements

### 1. Remove Stock Layer Concept

- Eliminate the special StockLayer class
- StockItems become first-class citizens in the document
- StockItems can exist independently of layers
- Multiple layers can reference the same StockItem

### 2. Material Assignment to StockItem

**File**: `rayforge/core/stock.py` (updated)

```python
from ..config import material_mgr

class StockItem(DocItem):
    def __init__(self, geometry: Optional[Geometry] = None, name: str = "Stock")

    @property
    def material(self) -> Optional[Material]

    @material.setter
    def material(self, material: Optional[Material])

    def get_material_display_name(self) -> str

    def to_dict(self) -> Dict[str, Any]

    @classmethod
    def from_dict(cls, data: Dict[str, Any]) -> "StockItem"
```

**New properties**:
- `material_uid: Optional[str]` - Reference to Material.uid
- `thickness: Optional[float]` - Thickness in mm

### 3. Multiple Layers Per Stock

**File**: `rayforge/core/layer.py` (updated)

```python
class Layer(DocItem):
    def __init__(self, name: str)

    @property
    def stock_item(self) -> Optional["StockItem"]

    @stock_item.setter
    def stock_item(self, stock_item: Optional["StockItem"])

    def to_dict(self) -> Dict

    @classmethod
    def from_dict(cls, state: Dict[str, Any]) -> "Layer"
```

**New properties**:
- `stock_item_uid: Optional[str]` - Reference to StockItem.uid

### 4. Updated Document Structure

**File**: `rayforge/core/doc.py` (updated)

```python
class Doc(DocItem):
    def __init__(self)

    def add_stock_item(self, stock_item: StockItem)

    def remove_stock_item(self, stock_item: StockItem)

    def get_stock_item_by_uid(self, uid: str) -> Optional[StockItem]

    @property
    def layers(self) -> List[Layer]

    def to_dict(self) -> Dict

    @classmethod
    def from_dict(cls, state: Dict[str, Any]) -> "Doc"
```

**New properties**:
- `stock_items: List[StockItem]` - First-class stock items in document

### 5. Updated WorkPiece (No Material Assignment)

**File**: `rayforge/core/workpiece.py` (updated)

```python
class WorkPiece(DocItem):
    def __init__(self, name: str, vectors: Optional[Geometry] = None)
    # Note: No material_uid or material property here
    # Material is handled at the stock level
    # ... rest of WorkPiece class remains the same ...
```

## UI Design: Stock-to-Layer Mapping

### 1. Stock Panel

**Design**: Stock panel placed above the layer panel, using the same visual design as the existing layer list widget.

**Features**:
- Shows all stock items with their materials and dimensions
- Visibility toggle for each stock item (same as layer visibility)
- Add/Delete buttons (same as layer panel)
- Stock properties editing (same approach as current layer editing)

### 2. Layer-Stock Assignment

**Implementation**: Each layer has a dropdown in its properties to select which stock item it operates on.

**Behavior**:
- Default to "Whole Surface" (virtual default stock) if no stock assigned
- Show material and thickness info for selected stock
- Update workpiece coloring based on stock assignment

### 3. Workpiece Visualization

**Approach**: Workpieces are colored by the stock item they're on.

**Implementation**:
- Each stock item gets a unique color
- Workpieces inherit color from their stock item
- "Whole Surface" workpieces use default color
- Color coding updates automatically when stock assignments change

### 4. Default Stock Handling

**Concept**: "Whole Surface" as a virtual default stock.

**Behavior**:
- New layers default to "Whole Surface" stock
- No stock assignment required for basic functionality
- Users can assign specific stock items when needed
- Prevents errors from unassigned layers

### 5. User Workflow

**Creating Stock**:
1. Click [+ Add] in Stock Panel
2. Creates default rectangular stock (same as current approach)
3. Edit stock properties (material, thickness, dimensions) as needed

**Assigning Stock to Layer**:
1. Select layer in Layer Panel
2. Open layer properties
3. Select stock from dropdown (or "Whole Surface")
4. Workpieces automatically colored by stock assignment

**Managing Stock Visibility**:
1. Click eye icon (👁) in Stock Panel to toggle visibility
2. Workpieces on hidden stock become invisible
3. Layer operations continue to work regardless of stock visibility

## Migration Strategy

### Phase 1: Backend Changes
1. Update StockItem class to include material_uid and thickness
2. Update Layer class to include stock_item_uid
3. Update Doc class to manage stock_items as first-class citizens
4. Remove StockLayer class
5. Update serialization/deserialization

### Phase 2: UI Changes
1. Implement Stock Panel with stock management
2. Update Layer Panel to show stock assignments
3. Add stock-to-layer assignment mechanisms
4. Implement workpiece-stock visualization
5. Remove stock layer from UI

### Phase 3: Workflow Integration
1. Update workflow processing to use stock item material
2. Update recipe matching to use stock item properties
3. Update job generation to handle multiple layers per stock

## Benefits of New Architecture

1. **Clear Material Assignment**: Materials are assigned to the physical stock, not the design workpiece
2. **Multiple Layers Per Stock**: One piece of stock can have multiple processing layers
3. **Single Stock Per Layer**: Each layer operates on only one type of stock, avoiding material conflicts
4. **Flexible Design**: WorkPieces can be placed across multiple stock items if needed
5. **Recipe Compatibility**: Recipes can match StockItem (material + thickness + machine) → Workflow
6. **Better Organization**: Stock items are first-class citizens, easier to manage
7. **Scalability**: Can easily support more complex stock-workpiece relationships

## Implementation Notes

- This refactoring should be done before implementing the material system
- UI changes should focus on Stock Panel and layer properties dropdown
- Stock Panel should reuse existing layer list widget design patterns
- Color coding for workpieces provides clear visual feedback
- "Whole Surface" default prevents errors from unassigned layers

Thread 45 (2025-10-04):

Exception in g-code related to power range

heathkh, 2025-10-04:
Note: I'm working on a PR with a fix here: https://github.com/heathkh/rayforge/tree/fix/power-out-of-range-error

**Describe the bug**

Getting an exception and g-code generation fails:

```
2025-10-04 09:37:52,430 - rayforge.shared.tasker.manager - ERROR - Unhandled exception in managed task 'frame-job':
Traceback (most recent call last):
File "/home/kyle/git/rayforge-ws2/rayforge/shared/tasker/manager.py", line 260, in _run_task
await task.run(context)
File "/home/kyle/git/rayforge-ws2/rayforge/shared/tasker/task.py", line 90, in run
await self._task
File "/home/kyle/git/rayforge-ws2/rayforge/machine/cmd.py", line 60, in frame_coro
frame = ops.get_frame(
power=head.frame_power,
speed=machine.max_travel_speed,
)
File "/home/kyle/git/rayforge-ws2/rayforge/core/ops/container.py", line 396, in get_frame
frame_ops.set_power(power)
~~~~~~~~~~~~~~~~~~~^^^^^^^
File "/home/kyle/git/rayforge-ws2/rayforge/core/ops/container.py", line 322, in set_power
cmd = SetPowerCommand(power)
File "/home/kyle/git/rayforge-ws2/rayforge/core/ops/commands.py", line 204, in init
raise ValueError(
f"Power must be between 0.0 and 1.0, but got {power}"
)
ValueError: Power must be between 0.0 and 1.0, but got 5.0
```

**To Reproduce**
Steps to reproduce the behavior:

Enable depth-engrave step and click the "frame" button

**Versions:**
[959cf84](https://github.com/barebaric/rayforge/commit/959cf84379eb64d1df4fc9edacbef8bbf67d253d)

knipknap, 2025-10-04:
Closed by #44

Closed 2025-10-04.
