barebaric/rayforge/rayforge/machine/driver/grbl/grbl_network.py

import asyncio
import inspect
import logging
from collections.abc import Awaitable, Callable
from gettext import gettext as _
from typing import (
    TYPE_CHECKING,
    Any,
    cast,
)
from urllib.parse import quote

import aiohttp

from ....context import RayforgeContext
from ....core.varset import ChoiceVar, HostnameVar, PortVar, Var, VarSet
from ....core.varset.hostnamevar import is_valid_hostname_or_ip
from ....pipeline.encoder.base import EncodedOutput, OpsEncoder
from ....pipeline.encoder.gcode import GcodeEncoder
from ....shared.units.system import UnitSystem, inches_to_mm
from ...discovery.spec import DiscoverySpec, MdnsRecognizer
from ...transport import HttpTransport, TransportStatus, WebSocketTransport
from ..driver import (
    Axis,
    DeviceConnectionError,
    DeviceStatus,
    Driver,
    DriverPrecheckError,
    DriverSetupError,
    Pos,
)
from .grbl_fingerprint import fingerprint_grbl_http
from .grbl_probe import probe_grbl_device
from .grbl_util import (
    CommandRequest,
    apply_setting_to_varset,
    command_url,
    detect_unit_system_from_settings,
    eeprom_info_url,
    execute_url,
    fluidnc_command_url,
    fluidnc_status_url,
    fw_info_url,
    gcode_to_p_number,
    get_grbl_setting_varsets,
    grbl_setting_re,
    hw_info_url,
    is_report_in_inches,
    parse_grbl_parser_state,
    parse_state,
    prb_re,
    status_url,
    sync_state_wco,
    upload_url,
    wcs_re,
)

if TYPE_CHECKING:
    from raygeo.ops import Ops

    from ....core.doc import Doc
    from ...device.profile import DeviceProfile
    from ...models.laser import Laser
    from ...models.machine import Machine


logger = logging.getLogger(__name__)


class GrblNetworkDriver(Driver):
    """
    A next-generation driver for GRBL-compatible controllers that use a
    modern file upload API and allows reading/writing device settings.
    """

    label = _("GRBL (Network)")
    subtitle = _("Connect to a GRBL-compatible device over the network")
    supports_settings = True
    supports_probing = True
    supports_unit_detection = True
    reports_granular_progress = False
    # ESP3D v3 firmware advertises a dedicated _esp3d._tcp service;
    # FluidNC only announces the generic _http._tcp and is confirmed
    # by fingerprinting its [ESP800] firmware-info endpoint.
    DISCOVERY = DiscoverySpec(
        mdns=MdnsRecognizer(
            services=("_esp3d._tcp.local.",),
            fingerprint=fingerprint_grbl_http,
        )
    )

    def __init__(self, context: RayforgeContext, machine: "Machine"):
        super().__init__(context, machine)
        self.host = None
        self.port = None
        self.ws_port = None
        self.protocol = None
        self.http = None
        self.websocket = None
        self.keep_running = False
        self._is_cancelled = False
        self._connection_task: asyncio.Task | None = None
        self._current_request: CommandRequest | None = None
        self._cmd_lock = asyncio.Lock()
        self._report_in_inches: bool = False
        self.is_fluidnc = False

    @classmethod
    async def probe(
        cls, context: "RayforgeContext", **kwargs: Any
    ) -> tuple["DeviceProfile", list[str]]:
        return await probe_grbl_device(cls, context, **kwargs)

    @property
    def machine_space_wcs(self) -> str:
        return "G53"

    @property
    def machine_space_wcs_display_name(self) -> str:
        return _("Machine Coordinates (G53)")

    @property
    def resource_uri(self) -> str | None:
        if self.host:
            # We assume port 80 is the control port for locking purposes
            # even if ws_port is different.
            return f"tcp://{self.host}:{self.port}"
        return None

    @classmethod
    def precheck(cls, **kwargs: Any) -> None:
        host = cast(str, kwargs.get("host", ""))
        if not is_valid_hostname_or_ip(host):
            raise DriverPrecheckError(
                _("Invalid hostname or IP address: '{host}'").format(host=host)
            )

    @classmethod
    def get_setup_vars(cls) -> "VarSet":
        return VarSet(
            vars=[
                HostnameVar(
                    key="host",
                    label=_("Hostname"),
                    description=_("The IP address or hostname of the device"),
                ),
                PortVar(
                    key="port",
                    label=_("HTTP Port"),
                    description=_("The HTTP port for the device"),
                    default=80,
                ),
                PortVar(
                    key="ws_port",
                    label=_("WebSocket Port"),
                    description=_(
                        "The WebSocket port for the device. For FluidNC,"
                        " use the same port as HTTP (usually 80)."
                    ),
                    default=81,
                ),
                ChoiceVar(
                    key="protocol",
                    label=_("Protocol variant"),
                    description=_(
                        "Standard, ESP3D, Longer, or FluidNC variant"
                    ),
                    default="ESP3D",
                    choices=["ESP3D", "Longer", "FluidNC"],
                    null_label=_("Standard"),
                ),
            ]
        )

    @classmethod
    def create_encoder(cls, machine: "Machine") -> "OpsEncoder":
        """Returns a GcodeEncoder configured for the machine's dialect."""
        assert machine.dialect is not None
        return GcodeEncoder(machine.dialect)

    def _setup_implementation(self, **kwargs: Any) -> None:
        host = cast(str, kwargs.get("host", ""))
        port = cast(int, kwargs.get("port", 80))
        ws_port = cast(int, kwargs.get("ws_port", 81))
        protocol = cast(str, kwargs.get("protocol", "ESP3D"))
        if not host:
            raise DriverSetupError(_("Hostname must be configured."))

        self.host = host
        self.port = port
        self.ws_port = ws_port
        self.protocol = protocol

        self.http_base = f"http://{host}:{port}"
        self.is_fluidnc = protocol == "FluidNC"
        if self.is_fluidnc:
            self.http = HttpTransport(
                f"{self.http_base}{fluidnc_status_url}",
                receive_interval=0.5,
            )
        else:
            self.http = HttpTransport(
                f"{self.http_base}{status_url}", receive_interval=0.5
            )
        self.http.received.connect(self.on_http_data_received)
        self.http.status_changed.connect(self.on_http_status_changed)

        ws_url = f"ws://{host}:{ws_port}/"
        self.websocket = WebSocketTransport(ws_url, self.http_base)
        self.websocket.received.connect(self.on_websocket_data_received)
        self.websocket.status_changed.connect(self.on_websocket_status_changed)

    async def cleanup(self):
        self.keep_running = False
        if self._connection_task:
            self._connection_task.cancel()
        if self.websocket:
            await self.websocket.disconnect()
            self.websocket.received.disconnect(self.on_websocket_data_received)
            self.websocket.status_changed.disconnect(
                self.on_websocket_status_changed
            )
            self.websocket = None
        if self.http:
            await self.http.disconnect()
            self.http.received.disconnect(self.on_http_data_received)
            self.http.status_changed.disconnect(self.on_http_status_changed)
            self.http = None
        await super().cleanup()

    async def _http_get(self, url: str) -> str:
        logger.debug(
            f"GET {url}",
            extra={
                "log_category": "RAW_IO",
                "direction": "TX",
                "data": f"GET {url}",
            },
        )
        async with (
            aiohttp.ClientSession() as session,
            session.get(url) as response,
        ):
            data = await response.text()
        logger.debug(
            f"GET {url} response: {data}",
            extra={
                "log_category": "RAW_IO",
                "direction": "RX",
                "data": data.encode("utf-8"),
            },
        )
        return data

    async def _send_command(self, command):
        if not self.host:
            # Raise a user-friendly error immediately if host is not configured
            raise DeviceConnectionError(
                _(
                    "Host is not configured. Please set a valid"
                    " IP address or hostname."
                )
            )

        encoded = quote(command, safe="")
        command_path = fluidnc_command_url if self.is_fluidnc else command_url
        url = f"{self.http_base}{command_path.format(command=encoded)}"
        logger.debug(
            f"GET {url}",
            extra={
                "log_category": "RAW_IO",
                "direction": "TX",
                "data": f"GET {url}",
            },
        )
        try:
            async with (
                aiohttp.ClientSession() as session,
                session.get(url) as response,
            ):
                response.raise_for_status()  # Check for 4xx/5xx errors
                data = await response.text()
            logger.debug(
                f"GET {url} response: {data}",
                extra={
                    "log_category": "RAW_IO",
                    "direction": "RX",
                    "data": data.encode("utf-8"),
                },
            )
            return data
        except aiohttp.ClientError as e:
            msg = _(
                "Could not connect to host '{host}'. Check the IP address"
                " and network connection."
            ).format(host=self.host)
            raise DeviceConnectionError(msg) from e

    async def _upload(self, gcode, filename):
        """
        Overrides the base GrblDriver's upload method with a standard
        multipart/form-data POST request.
        """
        form = aiohttp.FormData()
        if self.protocol in ("Longer", "FluidNC"):
            form.add_field("path", "/")
            form.add_field("size", str(len(gcode)))
            form.add_field(
                "file",
                gcode,
                filename=filename,
                content_type="application/octet-stream",
            )
        else:
            form.add_field(
                "file", gcode, filename=filename, content_type="text/plain"
            )
        url = f"{self.http_base}{upload_url}?path=/"

        log_data = f"POST to {url} with file '{filename}' size {len(gcode)}"
        logger.debug(
            log_data,
            extra={
                "log_category": "RAW_IO",
                "direction": "TX",
                "data": log_data,
            },
        )
        async with (
            aiohttp.ClientSession() as session,
            session.post(url, data=form) as response,
        ):
            response.raise_for_status()
            data = await response.text()

        logger.debug(
            f"POST {url} response: {data}",
            extra={
                "log_category": "RAW_IO",
                "direction": "RX",
                "data": data.encode("utf-8"),
            },
        )
        return data

    async def _execute(self, filename):
        url = f"{self.http_base}{execute_url.format(filename=filename)}"
        logger.debug(
            f"GET {url}",
            extra={
                "log_category": "RAW_IO",
                "direction": "TX",
                "data": f"GET {url}",
            },
        )
        async with (
            aiohttp.ClientSession() as session,
            session.get(url) as response,
        ):
            data = await response.text()

        logger.debug(
            f"GET {url} response: {data}",
            extra={
                "log_category": "RAW_IO",
                "direction": "RX",
                "data": data.encode("utf-8"),
            },
        )
        return data

    async def _connect_implementation(self):
        if not self.host:
            self._update_connection_status(
                TransportStatus.DISCONNECTED, "No host configured"
            )
            return

        self.keep_running = True
        self._connection_task = asyncio.create_task(self._connection_loop())

    async def _connection_loop(self) -> None:
        assert self.http and self.websocket
        while self.keep_running:
            self._update_connection_status(TransportStatus.CONNECTING)
            try:
                if self.is_fluidnc:
                    logger.info("Fetching firmware info...")
                    await self._http_get(f"{self.http_base}/api/status")
                else:
                    logger.info("Fetching hardware info...")
                    await self._http_get(f"{self.http_base}{hw_info_url}")

                    logger.info("Fetching device info...")
                    await self._http_get(f"{self.http_base}{fw_info_url}")

                    logger.info("Fetching EEPROM info...")
                    await self._http_get(f"{self.http_base}{eeprom_info_url}")

                logger.info("Starting HTTP and WebSocket transports...")
                async with asyncio.TaskGroup() as tg:
                    tg.create_task(self.http.connect())
                    tg.create_task(self.websocket.connect())

            except Exception as e:  # noqa: BLE001 - connection loop boundary
                self._update_connection_status(TransportStatus.ERROR, str(e))
            finally:
                if self.websocket:
                    await self.websocket.disconnect()
                if self.http:
                    await self.http.disconnect()

            self._update_connection_status(TransportStatus.SLEEPING)
            await asyncio.sleep(5)

    async def run(
        self,
        encoded: EncodedOutput,
        doc: "Doc",
        ops: "Ops",
        on_command_done: Callable[[int], None | Awaitable[None]] | None = None,
    ) -> None:
        if not self.host:
            raise ConnectionError("Driver not configured with a host.")

        gcode = encoded.text
        op_map = encoded.op_map

        try:
            self._is_cancelled = False

            # For GRBL driver, we don't track individual commands
            # since we upload the entire file at once
            if on_command_done is not None:
                # Call the callback for each op to indicate completion
                num_ops = op_map.op_count if op_map else 0

                for op_index in range(num_ops):
                    result = on_command_done(op_index)
                    if inspect.isawaitable(result):
                        await result

            await self._upload(gcode, "rayforge.gcode")
            if not self._is_cancelled:
                await self._execute("rayforge.gcode")
        except Exception as e:
            self._update_connection_status(TransportStatus.ERROR, str(e))
            raise
        finally:
            if not self._is_cancelled:
                self.job_finished.send(self)

    async def run_raw(self, machine_code: str) -> None:
        """
        Executes a raw G-code string by uploading it as a file to the device
        and then starting the job.
        """
        if not self.host:
            raise ConnectionError("Driver not configured with a host.")

        lines = [
            line.strip() for line in machine_code.splitlines() if line.strip()
        ]
        if not lines:
            return
        for line in lines:
            logger.info(line, extra=self._log_extra("USER_COMMAND"))

        try:
            self._is_cancelled = False
            await self._upload(machine_code, "rayforge_raw.gcode")
            if not self._is_cancelled:
                await self._execute("rayforge_raw.gcode")
        except Exception as e:
            self._update_connection_status(TransportStatus.ERROR, str(e))
            raise
        finally:
            if not self._is_cancelled:
                self.job_finished.send(self)

    async def execute_interactive_command(self, command: str) -> list[str]:
        """
        Sends a command via HTTP and waits for the full response from the
        WebSocket, including an 'ok' or 'error:'.
        """
        async with self._cmd_lock:
            if not self.websocket or not self.websocket.is_connected:
                raise DeviceConnectionError("Device is not connected.")

            logger.info(command, extra=self._log_extra("USER_COMMAND"))
            request = CommandRequest(command=command)
            self._current_request = request
            try:
                # Trigger command via HTTP. We don't care about the response.
                await self._send_command(command)
                # Wait for the response to arrive on the WebSocket.
                await asyncio.wait_for(request.finished.wait(), timeout=10.0)
                return request.response_lines
            except asyncio.TimeoutError as e:
                msg = f"Command '{command}' timed out."
                raise DeviceConnectionError(msg) from e
            finally:
                self._current_request = None

    async def set_hold(self, hold: bool = True) -> None:
        await self._send_command("!" if hold else "~")

    async def cancel(self, emergency: bool = False) -> None:
        self._is_cancelled = True
        # Soft reset: send Ctrl-X (0x18) as a raw byte.  _send_command
        # URL-encodes the argument, so '\x18' becomes '%18' on the wire —
        # which is what the ESP3D/FluidNC web interface interprets as the
        # GRBL soft-reset byte.  (Do NOT pass the literal string '%18',
        # because quote() would double-encode the '%' to '%2518'.)
        await self._send_command("\x18")
        await self._send_safety_shutdown(emergency)
        self.job_finished.send(self)

    async def _send_safety_shutdown(self, emergency: bool = False) -> None:
        """
        Best-effort transmission of the dialect's tool-off commands so
        a cancelled or aborted job cannot leave persistent PWM outputs
        energized.
        """
        dialect = self.dialect
        commands = dialect.get_safety_off_commands()
        if emergency and dialect.emergency_stop:
            commands.append(dialect.emergency_stop)
        for command in commands:
            try:
                logger.info(command, extra=self._log_extra("USER_COMMAND"))
                await self._send_command(command)
            except DeviceConnectionError as e:
                logger.warning(f"Safety command '{command}' failed: {e}")

    def can_home(self, axis: Axis | None = None) -> bool:
        """GRBL supports homing for all axes."""
        return True

    async def home(self, axes: Axis | None = None) -> None:
        """
        Homes the specified axes or all axes if none specified.

        Args:
            axes: Optional axis or combination of axes to home. If None,
                 homes all axes. Can be a single Axis or multiple axes
                 using binary operators (e.g. Axis.X|Axis.Y)
        """
        dialect = self.dialect

        # Execute the homing command(s)
        if axes is None:
            await self.execute_interactive_command(dialect.home_all)
        else:
            for axis in axes:
                cmd = dialect.home_axis.format(axis_letter=axis.name)
                await self.execute_interactive_command(cmd)

        # The following works around a quirk in some Grbl versions:
        # After homing, the machine is still in G54, but forgets its
        # offset. To re-activate the offset, we toggle to another
        # WCS and then back.
        # Just sending G54 is ignored if GRBL thinks it's already in G54.
        active_wcs = self._machine.active_wcs
        temp_wcs = "G55" if active_wcs == "G54" else "G54"

        # Flush planner buffer
        await self.execute_interactive_command("G4 P0.01")

        # Toggle sequence
        await self.execute_interactive_command(temp_wcs)
        await self.execute_interactive_command(active_wcs)

        park = self._machine.park_position_after_homing
        if axes is None and park is not None:
            template = self.dialect.move_to_park
            if template:
                await self.execute_interactive_command(
                    template.format(x=park[0], y=park[1])
                )

    async def move_to(self, pos_x, pos_y, pos_z=None, speed=None) -> None:
        cmd = self._format_move_to(float(pos_x), float(pos_y), pos_z, speed)
        await self.execute_interactive_command(cmd)

    async def select_tool(self, tool_number: int) -> None:
        """Sends a tool change command for the given tool number."""
        dialect = self.dialect
        cmd = dialect.tool_change.format(tool_number=tool_number)
        await self.execute_interactive_command(cmd)

    async def clear_alarm(self) -> None:
        dialect = self.dialect
        response = await self.execute_interactive_command(dialect.clear_alarm)
        has_error = any(line.startswith("error:") for line in response)
        if not has_error:
            self.state.error = None
            self.state_changed.send(self, state=self.state)

    async def set_power(self, head: "Laser", percent: float) -> None:
        """
        Sets the laser power to the specified percentage of max power.

        Args:
            head: The laser head to control.
            percent: Power percentage (0.0-1.0). 0 disables power.
        """
        # Get the dialect for power control commands
        dialect = self.dialect

        if percent <= 0:
            # Disable power
            cmd = dialect.laser_off
        else:
            # Enable power with the specified percentage
            power_abs = percent * head.max_power
            cmd = dialect.laser_on.format(power=power_abs)

        await self.execute_interactive_command(cmd)

    async def set_focus_power(self, head: "Laser", percent: float) -> None:
        """
        Sets the laser power for focus mode using the focus_laser_on command.

        Args:
            head: The laser head to control.
            percent: Power percentage (0.0-1.0). 0 disables power.
        """
        dialect = self.dialect

        if percent <= 0:
            await self._wait_for_idle()
            cmd = dialect.laser_off
        else:
            power_abs = percent * head.max_power
            cmd = dialect.focus_laser_on.format(power=power_abs)

        await self.execute_interactive_command(cmd)

    async def _wait_for_idle(self, timeout: float = 5.0):
        deadline = asyncio.get_event_loop().time() + timeout
        while self.state.status == DeviceStatus.JOG:
            if asyncio.get_event_loop().time() > deadline:
                logger.warning(
                    "Timed out waiting for JOG to finish before "
                    "sending laser-off command."
                )
                break
            await asyncio.sleep(0.05)

    def can_jog(self, axis: Axis | None = None) -> bool:
        """GRBL supports jogging for all axes."""
        return True

    async def jog(self, speed: int, **deltas: float) -> None:
        """
        Jogs the machine using GRBL's $J command.

        Args:
            speed: The jog speed in mm/min
            **deltas: Axis names and distances (e.g. x=10.0, y=5.0)
        """
        dialect = self.dialect
        cmd_parts = [dialect.jog.format(speed=self._to_machine_speed(speed))]

        for axis_name, distance in deltas.items():
            cmd_parts.append(
                f"{axis_name.upper()}{self._to_machine_length(distance)}"
            )

        # If no axes specified, do nothing
        if len(cmd_parts) == 1:
            return

        cmd = " ".join(cmd_parts)
        await self.execute_interactive_command(cmd)

    def on_http_data_received(self, sender, data: bytes):
        pass

    def on_http_status_changed(
        self, sender, status: TransportStatus, message: str | None = None
    ):
        self._update_command_status(status, message)

    def on_websocket_data_received(self, sender, data: bytes):
        logger.debug(
            f"WS RX: {data}",
            extra={"log_category": "RAW_IO", "direction": "RX", "data": data},
        )
        try:
            data_str = data.decode("utf-8").strip()
        except UnicodeDecodeError:
            logger.warning(f"Received non-UTF8 data on WebSocket: {data!r}")
            return

        for line in data_str.splitlines():
            is_status_report = line.startswith("<") and line.endswith(">")
            is_ok = line == "ok"
            if is_status_report:
                log_category = "STATUS_POLL"
            elif is_ok:
                log_category = "MACHINE_RESPONSE"
            else:
                log_category = "MACHINE_EVENT"
            logger.info(line, extra=self._log_extra(log_category))
            request = self._current_request

            # If a command is awaiting a response, collect the lines.
            if request and not request.finished.is_set():
                request.response_lines.append(line)

            # Process line for state updates, regardless of active request.
            if is_status_report:
                state = parse_state(
                    line,
                    self.state,
                    lambda message: logger.info(message),
                    report_in_inches=self._report_in_inches,
                )
                old_status = self.state.status
                if state != self.state:
                    self.state = state
                    if state.status != old_status:
                        logger.info(
                            f"Device state changed: {self.state.status.name}",
                            extra=self._log_extra("STATE_CHANGE"),
                        )
                    self.state_changed.send(self, state=self.state)
            elif line == "ok":
                self._update_command_status(TransportStatus.IDLE)
                if request:
                    request.finished.set()
            elif line.startswith("error:"):
                self._update_command_status(
                    TransportStatus.ERROR, message=line
                )
                if request:
                    request.finished.set()

    def on_websocket_status_changed(
        self, sender, status: TransportStatus, message: str | None = None
    ):
        self._update_connection_status(status, message)

    def get_setting_vars(self) -> list["VarSet"]:
        return get_grbl_setting_varsets()

    async def detect_unit_system(self) -> UnitSystem | None:
        """
        Queries the device's ``$$`` settings and infers the unit
        system from the ``$13`` (Report in inches) flag.
        """
        try:
            response_lines = await self.execute_interactive_command("$$")
        except (ConnectionError, asyncio.TimeoutError) as e:
            logger.warning(f"Unit system detection failed: {e}")
            return None
        self._report_in_inches = is_report_in_inches(response_lines)
        return detect_unit_system_from_settings(response_lines)

    async def read_settings(self) -> None:
        response_lines = await self.execute_interactive_command("$$")
        self._report_in_inches = is_report_in_inches(response_lines)
        # Get the list of VarSets, which serve as our template
        known_varsets = self.get_setting_vars()

        # For efficient lookup, map each setting key to its parent VarSet
        key_to_varset_map = {
            var.key: varset for varset in known_varsets for var in varset
        }

        unknown_vars = VarSet(
            title=_("Unknown Settings"),
            description=_(
                "Settings reported by the device not in the standard list."
            ),
        )

        for line in response_lines:
            match = grbl_setting_re.match(line)
            if match:
                key, value_str = match.groups()
                # Find which VarSet this key belongs to
                target_varset = key_to_varset_map.get(key)
                if target_varset:
                    # Update the value in the correct VarSet
                    apply_setting_to_varset(target_varset, key, value_str)
                else:
                    # This setting is not defined in our known VarSets
                    if unknown_vars.get(key) is None:
                        unknown_vars.add(
                            Var(
                                key=key,
                                label=f"${key}",
                                var_type=str,
                                value=value_str,
                                description=_("Unknown setting from device"),
                            )
                        )

        # The result is the list of known VarSets (now populated)
        result = known_varsets
        if len(unknown_vars) > 0:
            # Append the VarSet of unknown settings if any were found
            result.append(unknown_vars)

        num_settings = sum(len(vs) for vs in result)
        logger.info(
            f"Driver settings read with {num_settings} settings.",
            extra={"log_category": "DRIVER_EVENT"},
        )
        self.settings_read.send(self, settings=result)

    async def write_setting(self, key: str, value: Any) -> None:
        """Writes a setting by sending '$<key>=<value>'."""
        if isinstance(value, bool):
            value = 1 if value else 0
        cmd = f"${key}={value}"
        await self.execute_interactive_command(cmd)

    async def set_wcs_offset(
        self, wcs_slot: str, x: float, y: float, z: float | None
    ) -> None:
        p_num = gcode_to_p_number(wcs_slot)
        if p_num is None:
            raise ValueError(f"Invalid WCS slot: {wcs_slot}")
        cmd = self.dialect.format_wcs_offset(
            p_num,
            self._to_machine_length(x),
            self._to_machine_length(y),
            self._to_machine_length(z) if z is not None else None,
        )
        await self.execute_interactive_command(cmd)

    async def read_wcs_offsets(self) -> dict[str, Pos]:
        response_lines = await self.execute_interactive_command("$#")
        offsets = {}
        for line in response_lines:
            match = wcs_re.match(line)
            if match:
                slot, x_str, y_str, z_str = match.groups()
                z_str = z_str or "0.000"
                parsed: Pos = (float(x_str), float(y_str), float(z_str))
                offsets[slot] = (
                    tuple(inches_to_mm(v) for v in parsed)
                    if self._report_in_inches
                    else parsed
                )
        sync_state_wco(
            self.state,
            offsets,
            self._machine.active_wcs if self._machine else None,
        )
        self.state_changed.send(self, state=self.state)
        self.wcs_updated.send(self, offsets=offsets)
        return offsets

    async def read_parser_state(self) -> str | None:
        """Reads the $G parser state to determine the active WCS."""
        try:
            response_lines = await self.execute_interactive_command("$G")
            return parse_grbl_parser_state(response_lines)
        except DeviceConnectionError as e:
            logger.warning(f"Could not read parser state: {e}")
            return None

    async def run_probe_cycle(
        self, axis: Axis, max_travel: float, feed_rate: int
    ) -> Pos | None:
        assert axis.name, "Probing requires a single, named axis."
        axis_letter = axis.name.upper()
        dialect = self.dialect
        cmd = dialect.probe_cycle.format(
            axis_letter=axis_letter,
            max_travel=self._to_machine_length(max_travel),
            feed_rate=self._to_machine_speed(feed_rate),
        )

        self.probe_status_changed.send(
            self, message=f"Probing {axis_letter}..."
        )
        response_lines = await self.execute_interactive_command(cmd)

        for line in response_lines:
            match = prb_re.match(line)
            if match:
                x_str, y_str, z_str, success = match.groups()
                if int(success) == 1:
                    pos: Pos = (float(x_str), float(y_str), float(z_str))
                    if self._report_in_inches:
                        pos = tuple(inches_to_mm(v) for v in pos)
                    self.probe_status_changed.send(
                        self, message=f"Probe triggered at {pos}"
                    )
                    return pos

        self.probe_status_changed.send(self, message="Probe failed")
        return None

    def _update_command_status(
        self, status: TransportStatus, message: str | None = None
    ):
        log_data = f"Command status: {status.name}"
        if message:
            log_data += f" - {message}"
        logger.info(log_data, extra=self._log_extra("MACHINE_EVENT"))
        self.command_status_changed.send(self, status=status, message=message)

    def _update_connection_status(
        self, status: TransportStatus, message: str | None = None
    ):
        log_data = f"Connection status: {status.name}"
        if message:
            log_data += f" - {message}"
        logger.info(log_data, extra=self._log_extra("MACHINE_EVENT"))
        self.connection_status_changed.send(
            self, status=status, message=message
        )
