barebaric/rayforge/rayforge/machine/models/manager.py

import asyncio
import logging
from pathlib import Path
from typing import Optional

import yaml
from blinker import Signal

from ...context import get_context
from ...shared.tasker import task_mgr
from ...shared.util.atomic import atomic_write_yaml, load_yaml_with_backup
from ..device.profile import DeviceProfile
from ..device.profile_diff import (
    SettingDiff,
    find_outdated_profiles,
    split_reviewable,
    sync_device_notes_from_profile,
)
from ..device.schema_migration import (
    CURRENT_SCHEMA_VERSION,
    find_schema_migrations,
)
from ..driver.driver import ResourceBusyError
from .controller import MachineController
from .machine import Machine

logger = logging.getLogger(__name__)


class MachineManager:
    def __init__(self, base_dir: Path):
        base_dir.mkdir(parents=True, exist_ok=True)
        self.base_dir = base_dir
        self.controllers: dict[str, MachineController] = {}
        self.machines: dict[str, Machine] = {}
        self.machine_added = Signal()
        self.machine_removed = Signal()
        self.machine_updated = Signal()
        self.load()

    def initialize_connections(self):
        """
        Triggers initial connection for all machines with auto_connect enabled.
        This is called after the UI is fully initialized to ensure proper
        signal handling during connection attempts.
        """
        for machine in self.machines.values():
            if machine.auto_connect and not machine.is_connected():
                task_mgr.add_coroutine(
                    lambda ctx, m=machine: self._rebuild_and_connect_machine(
                        m
                    ),
                    key=(machine.id, "initial-connect"),
                )

    async def shutdown(self):
        """
        Shuts down all managed machine controllers and their drivers
        gracefully.
        """
        logger.info("Shutting down all machine controllers.")
        tasks = [
            controller.shutdown() for controller in self.controllers.values()
        ]
        if tasks:
            await asyncio.gather(*tasks)
        logger.info("All machine controllers shut down.")

    def get_controller(self, machine_id: str) -> "MachineController":
        """
        Gets the controller for a machine, creating it if it doesn't exist.
        This enables lazy instantiation of controllers.
        """
        if machine_id in self.controllers:
            return self.controllers[machine_id]

        machine = self.get_machine_by_id(machine_id)
        if not machine:
            raise ValueError(f"No machine found with ID {machine_id}")

        logger.debug(
            f"Creating controller for machine '{machine.name}' on first use."
        )
        controller = MachineController(
            machine, get_context(), task_mgr.schedule_on_main_thread
        )

        # Wire up the machine's signal proxies to the new controller
        machine._connect_controller_signals(controller)

        self.controllers[machine_id] = controller
        return controller

    def has_controller(self, machine_id: str) -> bool:
        """
        Returns whether a controller has already been instantiated for the
        given machine. Unlike ``get_controller``, this never lazily creates
        a controller and never raises, so it is safe to call for machines
        that have already been removed.
        """
        return machine_id in self.controllers

    async def _rebuild_and_connect_machine(self, machine: "Machine"):
        """
        A single, sequenced task that rebuilds a machine's driver and then
        connects if auto_connect is on.
        """
        controller = self.get_controller(machine.id)
        # Only rebuild if not already connected to avoid disconnecting
        if not machine.is_connected():
            await controller.rebuild_driver()
        if machine.auto_connect and not machine.is_connected():
            await self._safe_connect(machine)

    async def _safe_connect(self, machine: "Machine"):
        """
        Attempts to connect a machine, suppressing ResourceBusyErrors.
        """
        try:
            await machine.connect()
        except ResourceBusyError:
            context = get_context()
            if machine is context.config.machine:
                logger.warning(
                    f"Active machine '{machine.name}' could not connect "
                    "because resource is busy."
                )
            else:
                logger.debug(
                    f"Inactive machine '{machine.name}' deferred connection: "
                    "resource busy."
                )
        except Exception as e:  # noqa: BLE001 - async auto-connect task
            logger.error(
                f"Failed to auto-connect machine '{machine.name}': {e}"
            )

    def set_active_machine(self, new_machine: Machine):
        """
        Sets the active machine, handling the connection lifecycle for
        shared resources.
        """
        context = get_context()
        old_machine = context.config.machine

        if old_machine and old_machine.id == new_machine.id:
            return  # No change

        logger.info(f"Switching active machine to '{new_machine.name}'")

        async def switch_routine(ctx):
            # 1. Disconnect the old machine if it's connected
            if old_machine and old_machine.is_connected():
                logger.info(
                    f"Disconnecting previous machine '{old_machine.name}'"
                )
                await old_machine.disconnect()
                # Add a small delay for the OS to release the port
                await asyncio.sleep(0.2)

            # 2. Update the global config. This triggers UI updates, so it
            #    must run on the main thread (GTK is not thread-safe).
            await task_mgr.run_on_main_thread(
                context.config.set_machine, new_machine
            )

            # 3. Connect the new machine if it's set to auto-connect
            if new_machine.auto_connect:
                logger.info(
                    f"Connecting to new active machine '{new_machine.name}'"
                )
                await self._safe_connect(new_machine)

        task_mgr.add_coroutine(switch_routine)

    def filename_from_id(self, machine_id: str) -> Path:
        return self.base_dir / f"{machine_id}.yaml"

    def add_machine(self, machine: Machine):
        if machine.id in self.machines:
            return
        self.machines[machine.id] = machine
        machine.changed.connect(self.on_machine_changed)
        self.save_machine(machine)
        self.machine_added.send(self, machine_id=machine.id)

    def remove_machine(self, machine_id: str):
        machine = self.machines.get(machine_id)
        if not machine:
            return

        # Shut down and remove the associated controller if it exists
        if machine_id in self.controllers:
            controller = self.controllers.pop(machine_id)
            # Shutdown is async, so schedule it
            task_mgr.add_coroutine(lambda ctx: controller.shutdown())

        machine.changed.disconnect(self.on_machine_changed)
        machine.context.dialect_mgr.dialects_changed.disconnect(
            machine._on_dialects_changed
        )
        del self.machines[machine_id]

        machine_file = self.filename_from_id(machine_id)
        try:
            machine_file.unlink()
            logger.info(f"Removed machine file: {machine_file}")
        except OSError as e:
            logger.error(f"Error removing machine file {machine_file}: {e}")

        self.machine_removed.send(self, machine_id=machine_id)

    def get_machine_by_id(self, machine_id):
        return self.machines.get(machine_id)

    def get_placeholder_machines(self) -> list["Machine"]:
        """Returns all machines that are still untouched placeholders."""
        return [m for m in self.machines.values() if m.placeholder]

    def get_machines(self) -> list["Machine"]:
        """Returns a list of all managed machines, sorted by name."""
        return sorted(self.machines.values(), key=lambda m: m.name)

    def create_default_machine(self):
        machine = Machine(get_context())
        # Mark it so the UI can offer the setup wizard while this
        # placeholder is still the active machine.
        machine.placeholder = True
        # Fresh machines already carry current defaults; stamp them so
        # they never trigger the schema-migration review dialog.
        machine.schema_version = CURRENT_SCHEMA_VERSION
        self.add_machine(machine)
        return machine

    def save_machine(self, machine):
        logger.debug(f"Saving machine {machine.id}")
        machine_file = self.filename_from_id(machine.id)
        try:
            data = machine.to_dict(include_frozen_dialect=False)
        except Exception as e:
            logger.error(f"Failed to serialize machine {machine.id}: {e}")
            raise
        atomic_write_yaml(machine_file, data)

    def load_machine(self, machine_id: str) -> Optional["Machine"]:
        machine_file = self.filename_from_id(machine_id)
        if not machine_file.exists():
            raise FileNotFoundError(f"Machine file {machine_file} not found")
        try:
            data, _ = load_yaml_with_backup(machine_file)
        except (OSError, yaml.YAMLError) as e:
            msg = f"skipping unreadable machine file {machine_file.name}"
            logger.error(f"{msg}: {e}")
            return None
        if not data:
            msg = f"skipping invalid machine file {machine_file.name}"
            logger.warning(msg)
            return None
        machine = Machine.from_dict(data, context=get_context())
        machine.id = machine_id
        self.machines[machine.id] = machine
        machine.changed.connect(self.on_machine_changed)

        if machine.dialect_migrated:
            logger.info(
                f"Saving machine '{machine.name}' after dialect migration."
            )
            self.save_machine(machine)
            machine.dialect_migrated = False

        return machine

    def on_machine_changed(self, machine, **kwargs):
        self.save_machine(machine)
        self.machine_updated.send(self, machine_id=machine.id)

    def get_pending_profile_reviews(
        self,
    ) -> list[tuple[Machine, DeviceProfile]]:
        """Returns ``(machine, profile)`` pairs whose source device
        profile changed since the machine's last review and has at
        least one reviewable setting difference.

        Profile-maintained device notes are synced silently first, so a
        documentation-only profile change never raises a dialog.

        Pairs whose profile changed but where the machine already
        matches (no diff) are silently marked reviewed so they do not
        re-trigger. The manager owns the profile lookup and the
        silent-stamping; callers only need to present the returned
        pairs.
        """
        context = get_context()
        profiles_by_id = {
            p.id: p for p in context.device_profile_mgr.get_all()
        }
        outdated = find_outdated_profiles(self.get_machines(), profiles_by_id)
        for machine, profile in outdated:
            if sync_device_notes_from_profile(machine, profile):
                machine.changed.send(machine)
        reviewable, nothing_to_do = split_reviewable(outdated)
        for machine, profile in nothing_to_do:
            machine.reviewed_profile_hash = profile.content_hash()
            machine.changed.send(machine)
        return reviewable

    def get_pending_schema_migrations(
        self,
    ) -> list[tuple[Machine, list[SettingDiff]]]:
        """Returns ``(machine, diffs)`` pairs for every loaded machine
        whose ``schema_version`` is older than the current one and that
        has at least one reviewable setting diff.

        The manager owns the machine list and the schema-version
        comparison; callers (the UI) only need to present the returned
        diffs.
        """
        pending: list[tuple[Machine, list[SettingDiff]]] = []
        for machine in self.machines.values():
            if machine.schema_version >= CURRENT_SCHEMA_VERSION:
                continue
            diffs = find_schema_migrations(machine)
            if diffs:
                pending.append((machine, diffs))
        return pending

    def load(self):
        for file in self.base_dir.glob("*.yaml"):
            try:
                self.load_machine(file.stem)
            except (OSError, ValueError, TypeError, yaml.YAMLError) as e:
                logger.error(f"Failed to load machine from {file}: {e}")
