barebaric/rayforge/rayforge/machine/transport/transport.py

from abc import ABC, abstractmethod
from enum import Enum, auto
from gettext import gettext as _

from blinker import Signal


class TransportStatus(Enum):
    UNKNOWN = auto()
    IDLE = auto()
    CONNECTING = auto()
    CONNECTED = auto()
    ERROR = auto()
    CLOSING = auto()
    DISCONNECTED = auto()
    SLEEPING = auto()


TRANSPORT_STATUS_LABELS = {
    TransportStatus.UNKNOWN: _("Unknown"),
    TransportStatus.IDLE: _("Idle"),
    TransportStatus.CONNECTING: _("Connecting"),
    TransportStatus.CONNECTED: _("Connected"),
    TransportStatus.ERROR: _("Error"),
    TransportStatus.CLOSING: _("Closing"),
    TransportStatus.DISCONNECTED: _("Disconnected"),
    TransportStatus.SLEEPING: _("Sleeping"),
}


class Transport(ABC):
    """
    Abstract base class for asynchronous data transports.
    """

    def __init__(self):
        """
        Initialize transport with callbacks and notification handler.

        Signals:
            received: Function to handle received data
            status_changed: Function to handle connection status changes
        """
        self.received = Signal()
        self.status_changed = Signal()

    @property
    @abstractmethod
    def is_connected(self) -> bool:
        """
        Whether the transport is actively connected.
        """

    @abstractmethod
    async def connect(self) -> None:
        """
        Establish connection and start data flow.
        """

    @abstractmethod
    async def disconnect(self) -> None:
        """
        Gracefully terminate connection and cleanup resources.
        """

    @abstractmethod
    async def send(self, data: bytes) -> None:
        """
        Send binary data through the transport.

        Raises:
            ConnectionError: If transport is not connected
        """

    @abstractmethod
    async def purge(self) -> None:
        """
        Clear any buffered data in the transport.

        This method is used to resync communications by discarding any
        pending data in the receive buffer. It should not affect the
        connection state.
        """
