barebaric/rayforge/(commit log)

2025-10-29 fix: task manager ignored events from cancelled tasks, leading to memory leaks
    [manager.py]
2025-10-30 fix: task manager called when_done of new task instead of old task when task was cancelled/replaced
    [manager.py]
2025-11-01 fix: "reset to natural size" buttons did not work for DXF and Ruida files #65
2025-11-03 fix: compatibility with Gtk 4.18
    [log_dialog.py]
2025-11-03 fix: event loop not running when sending job
    [manager.py]
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2025-11-05 fix: workpieces using stale ops after being cut/pasted to a new layer
2025-11-05 fix: crash when the log view is open on Windows #68
    [log_dialog.py]
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2025-11-05 fix: port settings lose focus while changing port
    [general_preferences_page.py, smoothie.py]
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2025-11-21 fix: edge producer removed geometry from vector input if cut side was not "centerline" #71
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2025-11-22 add a "reset size" button to the notification that shows when a workpiece was auto-resized on import
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2025-11-23 fix: forgot to update drivers in last commit #75
    [grbl.py, grbl_serial.py, smoothie.py]
2025-11-26 some fixes for the smoothie driver #75
    [smoothie.py, telnet.py]
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2025-11-30 fix: pyright detected invalid str argument in machine dialect definition
    [dialect.py]
2025-12-03 terminology cleanup: replace gcode by machine_code where applicable #14
    [driver.py, dummy.py, grbl_serial.py]
2025-12-03 refactor: job runner no longer uses hard coded gcode encoder; instead it asks the machine/driver to encode #14
    [driver.py, dummy.py, grbl.py, grbl_serial.py, machine.py, smoothie.py]
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2025-12-05 fix missing icons on some distros #86
    [general_preferences_page.py]
2025-12-09 replace numerous themed icons by built-in icons #86
    [device_settings_page.py, general_preferences_page.py, hook_list.py, log_dialog.py, settings_dialog.py]
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2025-12-27 fix: popover not readable in dark mode in camera alignment dialog #90
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2025-12-28 fix a potential race condition in the grbl serial driver
    [grbl_serial.py]
2025-12-29 fix: boolean settings not normalized before writing to device #94
    [grbl.py, grbl_serial.py]
2025-12-29 fix: grbl serial driver not recovering from command timeouts
    [grbl_serial.py]
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2025-12-31 replace some icons by built in ones #86
    [dialect_list.py, machine_hours_page.py]
2025-12-31 fix: grbl serial: no attempt to connect after initial config
    [grbl_serial.py]
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2026-01-01 replace timer icon by built in icon #86
    [settings_dialog.py]
2026-01-01 fix: segfault due to UI callback in subthread
    [machine.py]
2026-01-01 fix: reverse axis setting now only affects display
    [general_preferences_page.py, machine.py]
2026-01-01 fix: inverted Y coordinates in gcode #93
    [machine.py]
2026-01-01 fix: reformatted correctly the files
    [general_preferences_page.py, machine.py]
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2026-01-05 fix: invalid default offset in machine settings
    [machine.py]
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2026-01-05 replace udp.py by version from StevenIsaacs #14
    [udp.py]
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2026-01-06 fix: axis grid not aligned with origin for machines with origin top-left
    [axis.py]
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2026-01-06 next attempt at fixing coordinate system settings for machines with negative axis #93
    [general_preferences_page.py, machine.py]
2026-01-07 next attempt fixing coordinates for negative axis machines with top right origin
    [driver.py, grbl.py, grbl_serial.py, machine.py, smoothie.py]
2026-01-07 fix a traceback in the machine settings dialog
    [settings_dialog.py]
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2026-01-08 fix: dialect changes not instantly applied
    [machine.py]
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2026-01-09 add a machine setting to allow defining the arc tolerance
    [advanced_preferences_page.py, machine.py]
2026-01-09 fix: subprocesses using stale G-code dialect
    [machine.py]
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2026-01-10 device errors are now shown prominently next to the device selector #113
    [driver.py, dummy.py, general_preferences_page.py, grbl.py, grbl_serial.py, grbl_util.py, machine.py]
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2026-01-10 fix: dialect backward compatibility
    [dialect.py]
2026-01-10 fix: traceback in gcode_to_p_number
    [grbl_util.py]
2026-01-10 fix: 2d canvas with WCS in non bottom-left orientation
    [axis.py]
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2026-01-10 fix a mistakenly disabled test
    [settings_dialog.py]
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2026-01-11 [Windows] Fixed focus given to last focused window instead of parent when closing dialogs (#115)
    * added a little tip for svg importing when failing
    * feat: added the patched dialog class & started to replace Adw.Window by it everywhere
    * finished all reconvertions
    * Revert "added a little tip for svg importing when failing"
    This reverts commit ec0428f9eda8e1c555a9272946cf3d778cb6bcd4.
    * fixed line len
    * fix: imports
    * fixed settings dialog being deleted for some reason
    * Fixed app interpreted as a filename arg when running the app command
    * moved patched_dialog_window & fixed settings dialog
    * forgot to save the files
    [dialect_editor.py, gcode_editor.py, machine_hours_page.py, settings_dialog.py]
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2026-01-13 fix: device not reporting position while running unless machine settings were saved in the same session
    [grbl_serial.py]
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2026-01-13 fix: laser dot moving in wrong direction when origin is not bottom-left
2026-01-13 fix: selected WCS not synced to UI when connecting
    [driver.py, grbl_serial.py, grbl_util.py, machine.py]
2026-01-13 fix: job not stopping on machine alarm in grbl serial driver
    [grbl_serial.py]
2026-01-13 fix: drivers no longer get Ops object; they get the pre-encoded result from the OpsEncoder as produced by the pipeline, to avoid double-applying coordinate system transforms
    [driver.py, dummy.py, grbl.py, grbl_serial.py, smoothie.py]
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2026-01-13 fix: driver self-cleared alarm in some cases
    [grbl_serial.py]
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2026-01-13 fix: grbl: coordinate system out of sync after a homing command
    [grbl.py, grbl_serial.py, grbl_util.py]
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2026-01-13 fix: device error not properly displayed #113
    [general_preferences_page.py, grbl_serial.py]
2026-01-13 fix/iimprove grbl error messages
    [grbl_util.py]
2026-01-13 fix: axis labels drawn twice on top of each other
    [axis.py]
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2026-01-14 rework jog direction handling and add tons of tests
    [jog_widget.py, machine.py]
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2026-01-15 fix a race condition in tasker.Manager.wait_unil_settled()
    [manager.py]
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2026-01-15 more coordinate system fixes for the 2d canvas axis renderer, add more tests
    [axis.py]
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2026-01-18 fix: traceback when using the "invert image" switch in the import dialog
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2026-01-22 fix: traceback when dialect contained deprecated attributes
    [dialect.py]
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2026-01-22 show an error if a user tries to delete a dialect that is in use
    [dialect_list.py, dialect_manager.py]
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2026-01-24 string fix: incorrect description of machine acceleration
    [general_preferences_page.py]
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2026-01-29 replace the jog dialog: all controls are now moved to the bottom control panel
    [control_panel.py, jog_widget.py]
2026-01-29 de-couple g-code preview from simulation mode: g-code preview is now no longer automatically opened, keeping the toggles separate
2026-01-29 add a setting to open the last project, a fixed project, or no project on startup #130
    [general_preferences_page.py]
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2026-01-30 fix: machine not reconnecting immediately on driver settings changes
    [machine.py]
2026-01-30 fix: jog buttons insensitive after switching machines
    [jog_widget.py]
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2026-01-31 fix: after creating a machine from a profile the driver was not set
    [controller.py, general_preferences_page.py]
2026-01-31 fix: TaskManager.wait_unitl_settled() waited for timeout even if already settled
    [manager.py]
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2026-02-01 fix: race condition during machine shutdown cause warnings and intermittent test failure
    [controller.py]
2026-02-01 fix: some strings were not translatable
    [controller.py, hook_list.py, macro.py]
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2026-02-08 major refactoring: stages now no longer hold any artifact state, state is centralized in artifact manager. still buggy
    [manager.py]
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2026-02-10 pipeline key handling refactor step 1 - still broken
    [manager.py]
2026-02-11 pipeline key handling refactor step 2 - also still broken
    [manager.py]
2026-02-11 pipeline key handling refactor step 3 -still broken
    [manager.py]
2026-02-11 test now pass. still broken in the app
    [manager.py]
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2026-02-12 pipeline: job is no longer a singleton
    [manager.py]
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2026-02-13 pipeline: various cleanups and fixes. still several issues
    [manager.py]
2026-02-13 pipeline: fix a memory leak due to double refcount increase
    [manager.py]
2026-02-13 pipeline: fix: resizing caused incorrect invalidations
    [manager.py]
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2026-02-13 fix: pipeline not processing multiple steps correctly
    [manager.py]
2026-02-14 fix: progress reporting reset while tasks still running
    [manager.py]
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2026-02-15 macos: use <Meta> for command shortcuts #70
    [settings_dialog.py]
2026-02-15 next attempt to fix windows tests
    [manager.py]
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2026-02-17 replace the log view by a fully featured G-code console
    [console.py, control_panel.py, driver.py, dummy.py, grbl.py, grbl_serial.py, smoothie.py]
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2026-02-17 contour and shrinkwrap operations no longer "abuse" laser dot size for tolerance calculations
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2026-02-18 fix various Gtk deprecations
    [console.py]
2026-02-18 refactor camera controller, better error handling and logging, don't try V4L on windows
    [controller.py]
2026-02-18 add more code to try and prevent opencv crash on windows
    [controller.py]
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2026-02-20 autoformat some scripts, fix linter errors
    [connection_status_widget.py]
2026-02-20 fix a memory leak caused by losing handles between DAG generations
    [manager.py]
2026-02-20 fix: improve camera device scanning to avoid crash on Windows #143
    [controller.py]
2026-02-20 add a pipeline stress test, fix memory leaks
    [manager.py]
2026-02-22 fix a potential memleak
    [manager.py]
2026-02-22 pipeline memory leaks fixed, stress test passes
    [manager.py]
2026-02-22 fix a race condition between worker pool task completion and pipeline shutdown
    [manager.py]
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2026-02-22 fix: get_caller_stack() misintepreted depth
    [manager.py]
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2026-02-22 try fixing flaky stress test on Windows
    [manager.py]
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2026-02-23 try fixing stress test for windows again
    [manager.py]
2026-02-23 yet another attempt fixing the stress test for windows
    [manager.py]
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2026-02-23 fix a race condition in task manager during shutdown
    [manager.py]
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2026-02-23 fix: speed entered in Jog dialog is not converted to base units #146
    [control_panel.py]
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2026-02-24 try fixing endless loop in stresstest on Windows
    [manager.py]
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2026-02-26 fix: coordinate handling was still wrong after #144
    [axis.py, control_panel.py, hardware_page.py, machine.py]
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2026-03-04 fix: unpickling data from addons in the subprocesses failed
    [manager.py]
2026-03-05 improve error handling while serializing machine
    [manager.py]
2026-03-05 refactor addon handling to hopefully fix issues on Windows
    [manager.py]
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2026-03-05 try to fix flaky task manager test
    [manager.py]
2026-03-05 feat(camera): add image enhancement, distortion correction and improved alignment UI - Add temporal noise reduction (denoise) with configurable strength - Implement fisheye lens distortion correction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
    [controller.py]
2026-03-06 fix(ui): correct nudge directions and update zoom controls
    - Fix swapped dy values for up/down nudge buttons in point bubble widget
    - Replace icon_name with child=get_icon() for zoom buttons
    - Update tooltips to reflect scroll-based zoom (without Ctrl modifier)
    - Adjust instructional text to match new zoom controls
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2026-03-08 fix: traceback when setting WCS offset in control panel
    [controller.py]
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2026-03-11 replace an icon by an internal one
    [console.py, hooks_macros_page.py, settings_dialog.py]
2026-03-14 fix Y axis sometimes drawn on wrong side of canvas
    [axis.py]
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2026-03-14 fix potential race in task manager schedule_delayed_on_main_thread()
    [manager.py]
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2026-03-24 silence a duplicate error notification from the driver
    [grbl_serial.py]
2026-03-24 fix: remove duplicate "connecting" log message from grbl serial driver
    [grbl_serial.py]
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2026-03-26 fix: grbl: status bytes not accounted for in buffer size tracking
    [grbl_serial.py]
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2026-03-26 sketcher: magnetic snap now also works while creating geometry, not just in select mode
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2026-03-28 fix: position reporting ignored for grbl machines that reported only X and Y without Z #179
    [grbl_util.py]
2026-03-28 replace rotary visualization by one that leaves the work surface visible
    [axis.py]
2026-03-28 some progress, but still an X-shift bug
    [coordspace.py]
2026-03-29 rotary mode is now a layer setting, no longer a document setting
    [hardware_page.py]
2026-03-29 fix an offset in the 3D canvas
    [coordspace.py]
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2026-03-29 fix: laser not turned off after framing; change default repetition to 20
    [laser.py]
2026-03-29 fix an endless loop in the rotary module settings page
    [rotary_module.py, rotary_module_page.py]
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2026-03-30 replace some icons by built in icons #185
    [device_settings_page.py, dialect_editor.py, dialect_list.py, general_preferences_page.py, grbl_serial.py]
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2026-04-01 changing a machine setting no longer causes mainwindow to switch back to 2D canvas
2026-04-01 fix: some glb models not positioned correctly, better default size, other glb related fixes
    [creality-roller.FCStd]
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2026-04-01 add no-go zone collision checking
    [nogo_zones_page.py, zone.py]
2026-04-02 fix: signal loop when selecting a different g-code dialect #189
    [dialect_list.py]
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2026-04-03 fix: UI fails to apply WCO to Canvas and Current Position widget #190
    [controller.py, machine.py]
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2026-04-05 fix: z axis coordinate handling and add z step down support for rotary mode
    [coordspace.py, machine.py]
2026-04-05 split canvas3d in two to avoid GL imports in subprocess
    [rotary_module_page.py]
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2026-04-05 fix: deadlock when switching WCS while 3d canvas visible
    [controller.py]
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2026-04-05 cleanup: remove old _DIALECT_REGISTRY, fully replaced by the dialect manager
    [dialect_list.py, dialect_manager.py, machine.py]
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2026-04-09 fix: grbl serial not connecting #196
    [grbl_serial.py]
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2026-04-10 fix potential races in the pipeline/3d canvas
    [manager.py]
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2026-04-11 fix: G5 commands in LinuxCNC and Marlin templates did not respect the omit unchanged axis flag
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2026-04-13 fix: deleting the active machine could lead to no machine being active
    [device_settings_page.py]
2026-04-14 fix: re-syncing WCS with the machine did not clear stale WCS
    [machine.py]
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2026-04-14 fix: debouncing caused material test not to update when switching presets #187
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2026-04-15 fix: Grbl should NOT account for status reports in its serial buffer count
    [grbl.py]
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2026-04-17 grbl serial: extract "ok" from responses BEFORE processing anything else, to handle some buggy firmware better
    [grbl.py, grbl_serial.py]
2026-04-17 fix previous commit: ensure grbl serial processes infos before OK
    [grbl_serial.py]
2026-04-17 major refactoring/replacement of kinematics and 3D simulator #195
    [machine.py, rotary_module.py, rotary_module_page.py]
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2026-04-18 fix: WCS synchronization fails if device does not report Z coordinates
    [grbl.py, grbl_serial.py, grbl_util.py]
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2026-04-18 3d canvas now displays rotaries correctly in all configurations
    [machine.py, rotary_module.py, rotary_module_page.py]
2026-04-18 fix g-code for rotary missing rotary command
    [machine.py]
2026-04-18 fix: no Z in gcode for rotary in Z replacement mode
    [machine.py]
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2026-04-19 fix: opening a layer in rotary replacement mode overwrites machine Y dimensions
    [machine.py]
2026-04-19 fix: 3d canvas axis extent frame with inverted margins when origin is top-right
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2026-04-19 replace machine profiles by declarative device packages that include config and dialect
    [manager.py]
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2026-04-19 fix: tests fail on windows
    [manager.py]
2026-04-19 support assigning each layer a WCS
    Add per-layer Work Coordinate System (WCS) support, allowing different
    layers to use different coordinate origins. Key changes:
    - Add Layer.wcs property with set_wcs()/get_effective_wcs() methods
    - Replace machine.wcs_offsets dict with CoordinateSystem model that
    stores name, label, and offset for each WCS slot
    - Add get_wcs_offset(), get_wcs_label(), set_wcs_label() to Machine
    - Implement _apply_per_layer_wcs_offset() in machine.py to apply
    per-layer WCS offsets at LayerStartCommand boundaries
    - Update encode_ops pipeline to pass doc for per-layer WCS lookup
    - Add _active_wcs tracking in gcode encoder to emit WCS commands
    at each LayerStartCommand w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
    [controller.py, coordinate_system.py, dummy.py]
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2026-04-20 fix: rotary cylinder rendered with diameter of chuck, not workpiece #195
    [machine.py]
2026-04-20 fix: grbl sending initial $I as realtime command, though it is not one
    [grbl.py, grbl_serial.py]
2026-04-20 fix: delayed main thread callbacks not cancellable via handle.cancel()
    concurrent.futures.Future.cancel() does not propagate to the asyncio
    task created by run_coroutine_threadsafe. Use loop.call_later instead,
    which returns a TimerHandle with working cancellation.
    [manager.py]
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2026-04-20 Fix race condition between $I and $# commands during connection
    Add _execute_interactive_command() for commands that need their
    response data. Unlike _execute_command (queue-based, async), this
    method acquires the command lock, drains outstanding acks, sends
    the command, and waits for the response under the lock — ensuring
    no stale or interleaved acknowledgements.
    Use it for $I in the connection loop so it completes before
    CONNECTED is emitted, preventing $# (triggered by CONNECTED)
    from racing with $I. Also switch $#, $G, $$ and probe commands
    that depend on response data.
    Fixes #217
    [grbl_serial.py]
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2026-04-20 fix: snap fails to launch with gpu-2404 slot not connected error #196
    Explicitly declare the gpu-2404 content plug with mesa-2404 as default
    provider so snapd auto-installs it. Also fix deprecated snapcraftctl
    build call.
2026-04-20 Fix stress test deadlock after connection flow change
    Update connected_driver fixture to complete the new connection
    handshake introduced in 306a626: send a status report to satisfy
    _handshake_received and provide the response. Without these,
    the connection loop retries during streaming and _execute_interactive
    command steals an ok from the streaming queue, causing a permanent
    ack count mismatch.
2026-04-20 Fix stress test deadlock after connection flow change
    handshake introduced in 6d5dd27: send a status report to satisfy
    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
2026-04-20 fix: GRBL alarm codes were mapped to wrong error descriptions
    Alarm codes and error codes share the same numeric space in GRBL but
    have completely different meanings. For example, alarm:2 is "Soft
    Limit" while error:2 is "Invalid Number Format". The code was using
    the error lookup table for both, causing misleading messages when the
    machine triggered a soft limit alarm.
    [grbl_serial.py, grbl_util.py]
2026-04-21 improved error messages for Grbl alarms
    [grbl_network.py, grbl_serial.py, grbl_util.py]
2026-04-21 fix: zero axis not working over GRBL network connection (#220)
    The GRBL network driver did not URL-encode the command text, causing
    the '#' in '$#' to be interpreted as a URL fragment delimiter. The
    server received just '$' instead of '$#', returning help text rather
    than WCS offset data. The empty response then wiped all coordinate
    systems via update_wcs_offsets_batch, which were saved to disk as an
    empty list.
    Two fixes:
    - URL-encode commands in GrblNetworkDriver._send_command so that $#
    is sent as %24%23
    - Guard _on_driver_wcs_updated against empty offset dicts to prevent
    a failed sync from destroying the WCS defaults
    [controller.py, grbl_network.py]
2026-04-21 fix: handle PEP 440 versions in update check to avoid false notifications
    PEP 440 versions like 1.6.0b2.post6+git.7f927a18 could not be parsed
    by semver, causing is_newer_version() to fall back to string comparison
    and incorrectly report older stable releases as newer.
    [grbl_network.py]
2026-04-21 fix: handle PEP 440 versions in update check to avoid false notifications
    PEP 440 versions like 1.6.0b2.post6+git.b0ca3352 could not be parsed
    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
    [grbl_network.py]
2026-04-21 fix: cancel button not working on GRBL network driver (#222)
    The cancel() method sent the literal string '%18' to _send_command(),
    which URL-encodes its argument. The '%' was double-encoded to '%25',
    so the ESP3D/FluidNC web server received the literal string '%18'
    instead of the Ctrl-X soft-reset byte (0x18).
    Fix: pass the raw byte '\x18' instead, so quote() produces the
    correct '%18' on the wire.
    Additionally, cancel() now emits the job_finished signal so the UI
    properly exits the running state, matching the serial driver behavior.
    [grbl_network.py]
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2026-04-22 fix: GRBL buffer flow control race condition on Windows
    GrblSerialTransport used task_mgr.loop to signal space availability,
    but that event loop is unrelated to where async waiters are running.
    On Windows with ProactorEventLoop, the cross-loop scheduling caused
    the signal to arrive too late for the test_run_respects_buffer_size
    test. Capture the correct loop in connect() and use it directly,
    removing the transport's dependency on the task manager.
    [grbl.py]
2026-04-22 fix: remove task_mgr dependency from GRBL serial driver
    Same issue as the transport layer: request.finished events were being
    signaled via task_mgr.loop instead of the caller's event loop. Replace
    all six call_soon_threadsafe calls with a _set_request_finished helper
    that uses the loop captured during connect().
    [grbl_serial.py]
2026-04-23 Remove JSON log dump, enrich session log with extra attributes
    Replace the MemoryHandler/DebugLogEncoder JSON pipeline with a SessionFileFormatter that injects log_category and machine_id tags directly into session log lines. The UILogHandler now buffers records for console history, eliminating the 5000-record MemoryHandler cap and the separate log_records.json file from debug archives.
    [console.py]
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2026-04-24 fix: use M3 constant power for focus laser so it stays on permanently
    [grbl.py]
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2026-04-25 initial ruida driver that supports only jogging
    refactor: all encoders now return an EncodedOutput class
    refactor Driver.run() to accept the EncodedOutput, add RuidaEncoder
    fix tests
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2026-04-26 Fix power percentage rounding in step summary
    Use round() instead of int() to avoid truncating floating-point
    values. For example, 0.35 * 100 = 34.999... was truncated to 34%
    by int() but correctly rounds to 35% with round().
    Fixes #227
2026-04-26 fix: pipeline recalculation loop
    [controller.py, machine.py]
2026-04-26 fix: ruida driver periodically disconnecting
    [udp.py]
2026-04-26 ruida: homing now performs "soft" homing (return to 0,0 instead of reset)
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2026-04-26 Hide G-code settings page for non-G-code drivers and make dialect optional in profiles
    DeviceProfile.from_path() no longer requires dialect.yaml when the
    profile's driver has uses_gcode=False. create_machine() skips dialect
    creation for non-G-code drivers. The machine settings dialog now
    hides the G-code sidebar row and page when the active driver has
    uses_gcode=False, and re-shows it when switching back.
    [settings_dialog.py]
2026-04-26 Add generic GRBL, Smoothieware, and Ruida device profiles
    Replace the vague "Other Device" profile with three specific ones:
    Generic GRBL, Generic Smoothieware (both with dialects), and Generic
    Ruida (no dialect). Add tests for loading non-G-code profiles without
    dialect.yaml, creating machines without dialects, and exporting
    non-G-code machines without dialect.yaml.
    [machine.py, udp.py]
2026-04-26 Add driver maturity enum and show warning banner for non-stable drivers
    Introduces DriverMaturity (STABLE, EXPERIMENTAL, KNOWN_BUGGY) on the
    Driver base class. The Ruida driver is marked KNOWN_BUGGY. The machine
    settings dialog now displays a warning banner with icon, message, and a
    clickable issue tracker link when a non-stable driver is selected.
    Centralizes GitHub/issue URLs in const.py.
    [driver.py, settings_dialog.py]
2026-04-26 Fix reuse_port error on Windows by checking socket support
    [udp.py]
2026-04-26 replace asyncio-serial by threading in the serial transport reader loop, in an attempt to make read buffer overflows less likely when the asyncio loop is congested #208
    [serial.py]
2026-04-26 fix: pipeline held reference to old machine after switching to a new machine
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2026-04-28 Split RowAdapter into per-type modules with native VarSetWidget debouncing
    Move the monolithic row_adapter.py into an adapter/ package with one
    file per adapter class (switch, entry, spin_row, slider, textarea,
    combo, speed). Remove the redundant VarRowFactory class and have
    callers use create_row_for_var() directly. Add proper typing to all
    adapter create() signatures. Fix double unit label in speed row
    subtitles by formatting the number without format_value(). Add
    set_subtitle_format() to UnitSpinRowHelper so callers don't reach
    into internals. Add native debouncing to VarSetWidget via debounce_ms
    parameter, used by step settings dialog at 300ms.
    [general_preferences_page.py]
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2026-04-28 Auto-register Var subclasses and adapters to eliminate manual registries
    Var.__init_subclass__ auto-populates a class registry for deserialization,
    replacing the hand-maintained _CLASS_MAP. @register_adapter decorators on
    each adapter class replace the manual _ADAPTER_MAP with MRO-based lookup.
    Editor type list is now derived from display_name class attributes via
    get_editable_var_types(). Also fixes UrlVar/WebsocketUrlVar missing from
    deserialization and print() -> logger.warning() in varset.py.
2026-04-28 Complete the adapter pattern: move all isinstance dispatch out of VarSetWidget
    Add update_from_var(), connect_changed(), and needs_rebuild() to the
    RowAdapter ABC so each adapter owns its own signal wiring, attribute
    updates, and rebuild logic. VarSetWidget no longer knows about specific
    GTK widget types or Var subclasses — it delegates everything to adapters.
    Hostname validation moves into HostnameAdapter. The choices-based rebuild
    check moves into ComboAdapter.needs_rebuild().
    [console.py]
2026-04-28 Invert dependencies for HostnameVar and BaudrateVar to decouple core from machine layer
    [grbl_network.py, grbl_serial.py, grbl_telnet.py, smoothie.py]
2026-04-28 Add OAuthFlowVar: reusable OAuth 2.0 flow for driver varsets
    Introduces a three-layer OAuth architecture: a standalone OAuthFlow
    service (localhost callback + code exchange), an OAuthFlowVar that
    stores tokens and resolves {key} URL templates from sibling vars,
    and an OAuthFlowAdapter that renders the UI (ActionRow for fixed
    endpoints, ExpanderRow with entry rows for custom ones).
    Also adds a _varset back-reference on Var so template resolution can
    look up sibling values at flow-start time.
2026-04-29 Fix OAuthFlow port-in-use detection on Windows
    On Windows, HTTPServer may set SO_REUSEADDR which allows binding to
    an already-in-use port, preventing the OSError from being raised.
    Add a raw socket probe before creating the HTTPServer to reliably
    detect port conflicts on all platforms.
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2026-04-30 Fix GRBL buffer overflow on devices with smaller RX buffers
    Some custom GRBL firmwares (e.g. Sculpfun iCube Ultra) report a
    smaller serial RX buffer than the standard 127 bytes via the OPT
    response. Rayforge was hardcoding 127, causing buffer overflow,
    garbled commands, and GRBL error:2 (Invalid Number Format).
    Parse the RX buffer size from the [OPT:...] response and configure
    the transport accordingly. Falls back to 127 for standard GRBL.
    [grbl.py, grbl_serial.py, grbl_util.py]
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2026-04-30 fix: use ephemeral ports in ruida tests to avoid Windows CI port conflicts
    [udp_server.py]
2026-04-30 feat: resize images in linear light for correct interpolation (pixel math phase 3)
    Convert all image resize operations to work in linear light: add
    resize_linear() for pyvips (scRGB colourspace chain) and
    resize_linear_nd() for numpy/opencv (channel-by-channel LUT-based
    conversion). Update all callers in workpiece, source_asset, tracing,
    camera controller, and vips utilities. Includes tests for both
    functions.
    [controller.py]
2026-04-30 fix: use linear light in color LUT gradients and BT.601 luminance for transparency (pixel math phase 4)
    Move create_lut_from_color to srgb.py and interpolate in linear light
    for perceptually uniform gradients. Replace simple average with BT.601
    weighted luminance in make_surface_transparent. No changes to
    number_badge.py (already uses BT.601 weights, negligible impact).
    [colors.py, controller.py]
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2026-05-01 Add job sanity check system with detailed issue reporting
    Replace the simple no-go zone boolean check with a composable sanity
    check framework that reports machine extent violations, workarea
    violations, and no-go zone collisions. Each check emits at most one
    issue per unique violation (per axis direction or per zone). A new
    SanityCheckDialog shows a structured error/warning list before
    proceeding with export or send operations.
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2026-05-02 feat(website): dynamically fetch latest release assets for download links
    Add GitHub API integration to fetch the latest release information and use it to populate download URLs and version labels. This ensures users always get links to the most recent version without manual updates to the static version variable.
    - Implement `useLatestGithubRelease` custom hook for fetching release data.
    - Add `findReleaseAsset` utility to select the correct asset per OS and method.
    - Update Windows and macOS install components to use dynamic URLs.
    - Add a primary download button that adapts based on fetch status.
    - Fall back to static URLs if the API fetch fails.
2026-05-02 Fix IndexError when laser combo selection is out of sync with machine heads
2026-05-02 Fix GRBL buffer deadlock from lost ok responses on \r\r\n line endings
    [grbl.py, grbl_serial.py]
2026-05-02 Fix deadlock detection when GRBL doesn't report Bf: in status reports
    The _is_grbl_idle_or_desynced check could not detect a buffer desync
    when the device omits the Bf: field and the IDLE status is overridden
    to RUN during jobs. Store the raw GRBL status before the override and
    check it in deadlock detection so recovery triggers even without Bf:.
    [grbl_serial.py]
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2026-05-02 fix: deadlock detection triggered incorrectly when status polling was off
    [grbl_serial.py]
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2026-05-02 open serial ports in exclusive mode to avoid clashes with other apps
    [serial.py]
2026-05-02 refactor: offload serial write operations to executor to prevent blocking
    [serial.py]
2026-05-03 feat(website): replace navbar links with floating social buttons
    Move GitHub and Discord links from the navbar to floating action buttons (FABs) in the bottom right corner. This improves visual hierarchy and reduces navbar clutter while maintaining accessibility. Also adds a Patreon link to the floating buttons and removes custom navbar item wrapper logic.
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2026-05-03 Fix status report fragmentation caused by parse buffer reset on job start
    When a GRBL status poll response arrived split across serial reads,
    _init_job_state() would call reset() which cleared the parse buffer,
    discarding the first fragment. The second fragment then appeared alone
    in the console as a spurious MACHINE_EVENT.
    Split reset() into reset_flow_control() (RX buffer accounting only) and
    reset() (full including parse buffer). Job init now uses the lighter
    reset, preserving partial status data. Also add a defense-in-depth
    guard in _handle_line to silently discard incomplete status fragments.
    [grbl.py, grbl_serial.py]
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2026-05-03 refactor(blog): replace custom sidebar and footer with Docusaurus components
    - Use BlogSidebarContent and Link components for better integration
    - Add i18n support for reading time and "Read more" link labels
    - Simplify layout by removing original footer wrapper and using Layout
    - Improve sidebar rendering with visible items filtering
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2026-05-03 feat(blog): sort tags alphabetically and simplify reading time display
    - Replace `TagsListInline` with custom `BlogTags` component that sorts tags case-insensitively
    - Simplify reading time display by removing translation wrapper and using plain text
    - Refactor `aria-label` translation call to use two-argument syntax for consistency
2026-05-03 Fix sporadic Ruida test failure caused by UDP port collision
    The simulator's jog transport binds to an ephemeral port that could
    randomly be assigned 40200, which the driver hardcodes as its response
    port. Make response_port configurable and use port 0 in tests to avoid
    the collision.
2026-05-04 refactor(website): consolidate button styles and update components
    Replace multiple specific button CSS classes with a unified `.rfButton` system
    and update components to use the new classes. This improves maintainability
    by reducing CSS duplication and ensuring consistent button styling across
    the website.
2026-05-05 fix a gtk theme warning
    [laser_control_widget.py]
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2026-05-07 fix a Gtk deprecation warning
    [laser_control_widget.py]
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2026-05-08 fix RX buffer size handling in GRBL serial #234
    [grbl_util.py]
2026-05-08 ensure atomic buffer space checks and resets flow control in GrblSerialDriver #234
    [grbl.py, grbl_serial.py]
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2026-05-09 Fix Marlin test import error on Windows by deferring fcntl/select to usage sites
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2026-05-10 Fix model loading, improve lighting and laser path visibility in 3D view
    Handle TextureVisuals meshes by checking visual type before accessing
    vertex_colors. Add fill light for better front/left illumination, raise
    ambient brightness, and remap power values to LUT range 0.5-1.0 so
    low-power laser paths remain visible.
    [head-diode.FCStd]
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2026-05-14 Move buffer management and RAW_IO logging into GRBL transport layer
    Move RAW_IO TX/RX logging, buffer-space waiting with timeout, and
    deadlock recovery into GrblSerialTransport where it belongs. The
    driver now provides an on_stall callback for deadlock recovery;
    poll and recovery skip the driver's _cmd_lock since it's already
    held by the caller (safe because pyserial serializes writes).
    Key changes:
    - send_gcode() now handles buffer-space waiting internally with
    timeout and on_stall callback; callers no longer need a separate
    ensure_buffer_space() call
    - BufferStallError raised when recovery fails
    - RAW_IO logging moved from grbl_serial driver to transport layer
    - Removed _wait_for_buff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
    [grbl.py, grbl_serial.py]
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2026-05-19 Port remaining code and tests to the Ops index-based API
    Port all transformers, producers, simulators, encoders, and ~700+
    tests from direct Command/ops.commands usage to the index-based Ops
    API. Add lazy state computation in clipping._get_state() to avoid
    expensive preload_state() call. Update tracking docs to reflect
    remaining work.
    [zone.py]
2026-05-21 completely replace rayforge/core/ops by raygeo
    [advanced_preferences_page.py]
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2026-05-25 Fix manual laser control routing
    [laser_control_widget.py]
2026-05-28 Fix buffer stall recovery aborting jobs during slow moves
    The buffer stall callback (_on_buffer_stall) was returning False
    (recovery failed) when the machine was in Run state, causing
    send_gcode to raise BufferStallError and trigger a soft-reset.
    This produced GRBL ALARM:3 by aborting the machine mid-motion.
    When the machine is actively running (not idle), a buffer stall
    is transient -- the machine simply hasn't finished its current
    move yet. Return True to signal retry instead of False (abort).
    Also increase deadlock_timeout from 2s/10s to 5s/30s to better
    accommodate slow feed rates (e.g. F200 takes 30s for a 100mm move).
    Fixes #256
    [grbl_serial.py]
2026-05-28 Add deadlock_detection driver option (disabled by default)
    Adds a new "Deadlock detection" toggle to the GRBL serial and
    telnet driver settings. When disabled (default), the buffer stall
    callback simply retries the wait without attempting deadlock
    detection or recovery. This prevents false ALARM:3 errors caused
    by the driver misinterpreting slow moves as deadlocks.
    When enabled, the driver will poll the machine state during stalls
    and attempt G4 P0.01 recovery if a true deadlock is detected.
    The option appears as a switch in the device settings UI alongside
    the existing "Poll device status during jobs" toggle.
    [grbl_serial.py, grbl_telnet.py]
2026-06-01 Fix machine settings not applying until restart
    Closes barebaric/rayforge#266
    Several machine settings changes were not propagating to listeners
    until the app was restarted. This fixes multiple root causes:
    - set_driver()/set_driver_args() now emit changed signal synchronously
    instead of relying solely on the async rebuild_driver callback
    - _hydrated_dialect cache is cleared when dialect UID or dialect
    definitions change, preventing stale G-code dialect usage
    - JogWidget now listens to machine.changed to update button sensitivity
    and limit status when machine settings change
    - WorkSurface incremental update path now calls
    _update_pipeline_view_context() so canvas reflects non-dimen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
    [advanced_preferences_page.py, hardware_page.py, jog_widget.py, machine.py]
2026-06-01 Add device profile for Creality Falcon 10W
    Based on configuration shared by @thehamstermuffin in issue #266.
    10W diode laser engraver with 400x415mm work area, GRBL-based.
2026-06-02 Use adaptive deadlock timeouts based on per-command time estimates
    Instead of a fixed deadlock_timeout, compute a per-gcode-line timeout
    from Ops.estimate_command_times(). Each line's timeout is set to
    max(5s, estimated_move_time * 3), capped at 120s. Lines without an
    op_index fall back to a 30s default.
    This replaces the previous static 2s/10s/30s timeouts from PR #262
    with values that scale with actual move duration, preventing false
    ALARM:3 errors on slow moves while keeping deadlock detection fast
    on short moves.
    [driver.py, dummy.py, grbl_network.py, grbl_serial.py, marlin_serial.py, smoothie.py]
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2026-06-04 Fix GRBL network disconnect with MKS DLC32 (#273)
    Disable client-side WebSocket ping/pong keepalive to prevent
    protocol errors with MKS DLC32 boards. The board's WebSocket
    server sends incorrectly masked responses after receiving a ping,
    causing the websockets library to close the connection every
    20-30 seconds.
    This is safe because:
    - The server already sends its own pings
    - HTTP polling provides a secondary keepalive at 0.5s intervals
    [websocket.py]
2026-06-05 Install raygeo from local checkout instead of PyPI in Windows build
    The Windows CI was installing raygeo from PyPI (v0.4.1) which doesn't
    include the new image and raster modules. Install from the local git
    checkout instead so the build always uses the current raygeo source.
2026-06-06 fix: avoid ValueError when removing the active machine (#280)
    When the currently selected machine was deleted, MachineManager.remove_machine
    tore down its controller before emitting machine_removed. The cascading
    config-changed handler in MainWindow._on_machine_signals_changed then tried to
    disconnect the controller's laser_power_changed signal via
    self._current_machine.controller, which lazily re-resolves the controller
    through the manager and raised "No machine found with ID ...". The unhandled
    exception aborted the handler, leaving the UI stuck on the removed machine's
    settings until restart.
    Add a non-lazy has_controller check on MachineManager (and a matching
    Machine.has_controller pro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
    [machine.py, manager.py]
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2026-06-08 Fix OctoPrint driver tests: remove unnecessary multiprocessing dependency
    Replace lite_context/machine fixtures with a lightweight driver fixture
    that doesn't create a TaskManager. The OctoPrint tests never use tasking
    features, so the multiprocessing.Manager() was pure overhead causing
    ResourceTracker semaphore leak warnings and 20x slower test execution.
2026-06-08 Shut down multiprocessing Manager in TaskManager.shutdown()
    Prevents semaphore leaks from the Manager's internal process being
    left for GC to clean up.
    [manager.py]
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2026-06-08 Detect and recover from crashed/unresponsive worker processes (#283)
    Workers track their active task in a DictProxy (survives result queue
    corruption from crashed peers). The listener health check detects:
    - Dead workers via is_alive() — emits worker_died for orphan cleanup
    - Per-worker timeouts (30s) — terminates unresponsive workers individually
    Workers now send a 'running' message with their PID so per-worker start
    times are tracked. Cancelled tasks are skipped early in the worker loop
    before running user_func, preventing stale tasks from blocking the queue.
    Replacement workers are spawned automatically.
    [manager.py]
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2026-06-09 Add GrblSerialSimpleDriver with ping-pong protocol
    Implements a minimal GRBL serial driver that sends one G-code line at
    a time and waits for 'ok' before proceeding. No character-counting
    buffer management, no deadlock detection, no buffer stall recovery.
    Key differences from GrblSerialDriver:
    - Uses raw SerialTransport instead of GrblSerialTransport
    - No RX buffer tracking or backpressure
    - Strict ping-pong: send -> wait ok -> send next
    - Simpler connection loop with handshake detection
    - No command queue or interactive/queued command separation
    - Marked as EXPERIMENTAL maturity level
    Useful for devices where the advanced buffer-counting protocol causes
    issues (false ALARM:3, communicatio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
    [grbl_serial_simple.py]
2026-06-09 Fix CI errors: add Tuple import, remove unused imports, fix line length
    [grbl_serial_simple.py]
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2026-06-09 Fix pyright type errors in GrblSerialSimpleDriver
    - Make cleanup() async to match Driver base class
    - Make _start_job() sync (not async) like GrblSerialDriver
    - Add assert for machine.dialect None check in create_encoder
    - Fix parse_state() call to pass required default arg
    - Remove invalid pos_x/pos_y assignments (use parse_state instead)
    - Fix alarm_code_to_device_error() to pass single alarm_code arg
    [grbl_serial_simple.py]
2026-06-09 Add Rayforge 1.8 Beta release notes and update UI documentation
    - Introduced new blog post for Rayforge 1.8 Beta detailing Rust-powered pipeline, redesigned Ops structure, and new GRBL driver.
    - Updated bottom panel documentation across multiple languages to include new "Go to WCS Zero" functionality.
    - Updated screenshots for print-and-cut features and bottom panel console to reflect recent UI changes.
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2026-06-13 fix multiprocessing warnings on Python 3.12
    - Replace module-level Manager() with spawn-context Manager() to avoid
    os.fork() in multi-threaded processes (DeprecationWarning)
    - Use cancel_join_thread() before close() on multiprocessing queues to
    prevent reentrant resource_tracker warnings (UserWarning)
    [manager.py]
2026-06-13 Update tests to match optimizer no longer splitting scanlines
    The optimizer no longer splits scanlines at zero-power gaps, so the
    tests that expected splitting behavior are updated to verify atomic
    scanline preservation instead.
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2026-06-14 Fix links to 3D Preview in material test grid and shrink wrap documentation
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2026-06-14 import LightBurn cut settings as layer workflow step parameters
    Carry per-layer cut settings (power, speed, kerf, passes) through the
    five-phase import pipeline so the assembler can pre-configure the
    layer's workflow step, avoiding the need for manual re-entry.
    Pipeline flow:
    Importer.vectorize() -> VectorizationResult.layer_settings
    NormalizationEngine -> LayoutItem.settings
    ItemAssembler.create_items() -> creates configured ContourStep on Layer
2026-06-14 Move Otsu thresholding and connected-component denoising to raygeo
    Replaces OpenCV-based thresholding and component filtering with Rust
    implementations in the raygeo library.
    raygeo (external/raygeo):
    - grayscale_to_binary: Otsu auto-threshold and fixed-threshold with invert
    - component_areas: 8-connected component labeling via Union-Find
    - filter_components: remove components below min_area threshold
    rayforge:
    - tracing.py: replace cv2.threshold with grayscale_to_binary
    - denoise.py: replace cv2.connectedComponentsWithStats with
    component_areas + filter_components (removes cv2 dependency)
    - test_denoise.py: update to use new raygeo API
2026-06-15 Replace svgelements in AI addon with raygeo.svg.svg_string_to_geometry
    Remove 150 lines of svgelements boilerplate (parse_svg_to_geometry,
    _add_path_to_geometry, _convert_pixel_to_user_units, _length_to_px,
    _to_float) and call svg_string_to_geometry directly.
    [controller.py]
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2026-06-15 Port encoder functions to raygeo: rasterize_scanlines and transform_to_cylinder
    - Delete scanline_rasterizer.py (replaced by raygeo.image.rasterize_scanlines)
    - Update TextureEncoder to use raygeo.image.rasterize_scanlines
    - Remove transform_to_cylinder from vertexencoder.py (now in raygeo.geo.algo.cylindrical)
    - Update scene_compiler.py imports to use raygeo directly
    - Update test imports to use raygeo.geo.algo.cylindrical
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2026-06-27 fix: grbl error state when machine enters HOLD
    [grbl_network.py, grbl_util.py]
2026-06-27 raygeo 0.13.0: rename AdaptiveClearing to Wavefront, fix area_tolerance default
    Bump raygeo from 0.12.1 to 0.13.0 and port the addon:
    Module path migrations:
    - raygeo.ops.assembly.hsm → ops.assembly.entry + ops.assembly.wavefront
    - raygeo.geo.algo.cleared_area → raygeo.ops.cut.cleared_area
    Producer changes (AdaptiveClearing → Wavefront):
    - Replace adaptive_peeling with adaptive_wavefronts (removed in 0.13.0)
    - ClearedArea constructor now requires boundary/islands; use initial=
    parameter instead of add_cleared_polygons
    - Lower area_tolerance default from 1.0 to 0.01 — the milling-era
    default caused the wavefront loop to break immediately on the first
    ring for laser tools (0.05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
2026-06-28 wavefront: make entry spiral flat (no Z movements)
    Set safe_z equal to z_cut (both 0.0) so raygeo's adaptive_entry
    skips helical plunge and ramp, producing only a flat spiral.
    grbl_util: reformat ternary for readability
    [grbl_util.py]
2026-06-28 fix: ops misaligned with workpiece at high zoom
    When zooming in very far, the 8192px cairo surface cap binds on one
    axis before the other for non-square workpieces, producing different
    effective pixels-per-mm on X and Y. The composite blit used a single
    eff_ppm derived from the width for both axes, shifting ops vertically
    relative to the workpiece. Track per-axis ppm and apply them
    independently.
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2026-06-29 skip overscan transformer for drivers with native overscan
    Ruida firmware applies its own overscan, so Rayforge's OverscanTransformer
    would double it up. Add a native_overscan driver capability flag (true for
    Ruida) and:
    - inject driver_native_overscan into the production settings dict
    - early-return in OverscanTransformer.run when the flag is set
    - show a banner and disable the overscan widget controls in the UI
    - add a warning icon to the post-processing expander header when an
    enabled overscan setting is unsupported, so the warning is visible
    without unfolding
    [driver.py]
2026-07-02 replace fragile 1x1 Cairo surface text path with Pango-based text_to_geometry #293
    - Replace _vectorize_text_to_ops' 1x1 pixel Cairo surface + select_font_face('Sans')
    with Pango-based FontConfig/text_to_geometry for robust font fallback
    - Fix coordinate space: convert mm layout positions to Pango's 96 DPI pixel
    space, then scale geometry back to mm
    - Make draw_preview use the same pixel-space layout and shared Pango rendering
    in _setup_text_path_on_context via text_to_geometry + geometry_to_cairo to
    eliminate misalignment between preview and ops
    - Remove min_abs_font_size clamp in _calculate_abstract_layout - it was
    designed for 300 DPI pixel space (2 px ≈ 0.17 mm) but now opera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
2026-07-03 Fix contour producer dropping open contours in Outside/Inside cut modes
    Separate open contours before grow() and re-add them afterward.
    grow() only operates on closed contours, so open contours were being
    silently dropped when cut side was Outside or Inside (Centerline
    mode was unaffected because it skips grow() entirely).
2026-07-05 grbl: abort buffer stall recovery after cancel to prevent resending G-code to freshly reset firmware
    When a job is cancelled via Ctrl-X soft reset, GRBL's modal state
    (including feedrate) is cleared. If the buffer stall recovery was
    active, it would resume sending queued G1 commands without an F
    word after the reset, triggering GRBL error 22 ('Feed Rate Missing').
    Fix by checking _is_cancelled in _on_buffer_stall and returning
    False to abort instead of retrying.
    [grbl_serial.py]
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2026-07-05 bump raygeo to 0.14.0
    Breaking API changes:
    - CoolantMode::Air split into AirAssistMode/HeadCoolantMode
    - raygeo.ops.assembly.entry moved to raygeo.cnc.machining.entry
    - adaptive_entry/adaptive_wavefronts return AssemblyResult
    - Geo function renames: any_overlap->does_any_overlap, etc.
    Bump addon API version to 16 for the incompatible changes.
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2026-07-12 fix: toggle buttons of varsets not changing background color when toggled on
2026-07-12 Fix pixi environment solving for osx-arm64
    - Scope libglvnd (X11-only) to linux-64; it has no osx-arm64 build
    and was blocking every environment from solving
    - Pin scipy/numpy to match requirements.txt and the linux-64 lock
    - Move libvips into the shared deps; pyvips needs it on every platform
2026-07-12 Fix macOS-only transport test failures
    Running tests via pixi on osx-arm64 for the first time surfaced bugs
    Linux CI never exercised:
    - SerialServerTransport closed its PTY slave fd immediately; macOS's
    PTY driver raises EIO on the master once no process holds the
    slave open, so keep our own fd open for the transport's lifetime
    - TelnetTransport.disconnect() double-fired DISCONNECTED, since
    cancelling the connection task doesn't raise CancelledError
    through it (the loop swallows it and exits normally)
    - Telnet integration tests asserted server-side state right after
    connect() returned; that ordering isn't guaranteed across event
    loop backends, so poll for it instead
    [serial_server.py, telnet.py]
2026-07-12 Fix TelnetTransport.disconnect() hanging tests on Linux
    - The connection task can be cancelled before its first scheduling
    slot, so _manage_connection's finally block never runs and the
    writer is never closed - guard on self.writer instead of returning
    unconditionally, so cleanup happens exactly once either way
    - Catch OSError alongside ConnectionResetError on wait_closed()
    - Clear self._connection_task after handling it
    [telnet.py]
2026-07-13 Delegate layout and assembly logic to raygeo
    - material_test_grid_producer: replace manual layout/drawing methods
    (_calculate_abstract_layout, _draw_rectangle, _draw_filled_box,
    _setup_text_path_on_context, _vectorize_text_to_ops) with direct
    calls to generate_material_test_grid() and preview helper
    - wavefront_producer: replace manual multi-pocket wavefront with
    direct call to adaptive_wavefronts_multi_pocket()
    - raster_producer: set part.image before calling raster()
    - shrinkwrap_producer: set part.image before calling shrinkwrap()
2026-07-13 Wrap material test grid ops in a section with workpiece UID
    Missing since the delegation to raygeo's generate_material_test_grid,
    causing test_workpiece_uid_in_section_commands to fail in CI.
2026-07-13 some producer cleanups by moving code into helpers
    - Add MachineDefaults dataclass and resolve_machine_defaults() to
    centralise duplicated machine parameter resolution
    - Refactor Rasterizer and WavefrontProducer to use wrap_assembler_result()
    - Add always_wrap param to wrap_assembler_result for raster section markers
    - Move _has_no_fills check from Rasterizer to _execute_raster stage
    - Make WavefrontProducer return empty artifact on missing geometry
    instead of raising ValueError
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2026-07-14 refactor: replace OpsProducer pipeline with assembler registry
    - Remove AssemblerMeta.resolve_params in favor of Step.get_assembler_kwargs()
    - Replace step.assembler_name/assembler_params with ASSEMBLER_NAME ClassVar
    and real typed attributes on each Step subclass
    - Add MachineDefaults dataclass wired through the pipeline
    - Thread Step through pipeline instead of separate assembler_name/params
    - Add AssemblerRegistry with _register_laser_assemblers fallback for workers
    - Make task_mgr a required parameter on AddonManager, passed at construction
    so _build_and_update_manifest always finds shared_state
    - Remove set_task_manager method (redundant with constructor parameter)
    - Remove _ensure_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
2026-07-15 refactor: eliminate AssemblerMeta, migrate UI widgets to step attributes
    - Add orchestration ClassVars to Step base (IS_VECTOR, SPLIT_CONTOURS,
    SET_POWER, NORMALIZE_WINDINGS, ALWAYS_WRAP, SECTION_TYPE) and
    override on each Step subclass - replaces AssemblerMeta fields
    - Delete AssemblerMeta class entirely; AssemblerRegistry becomes a
    plain name -> Callable map with no param_keys filtering
    - Add set_step_property() helper to StepComponentSettingsWidget base
    for undoable step attribute writes via ChangePropertyCommand
    - Migrate contour, frame, shrinkwrap, wavefront, and raster widgets
    to read/write step attributes directly instead of opsproducer_dict
    - Add override_threshold, thresho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
2026-07-15 delete producers, now replaced by step methods + assemblers
    - Delete all producer files: OpsProducer, ProducerRegistry, PlaceholderProducer,
    and all 6 laser producer implementations (contour, frame, shrinkwrap,
    raster, wavefront, material_test_grid)
    - Remove register_producers hook spec, registration table entry, and all
    implementations (laser_worker, sketcher)
    - Move CutSide/CutOrder enums to rayforge/core/cut_side.py
    - Migrate material test widget + command to step attributes (no more
    opsproducer_dict or producer parameters)
    - Widget frontend passes 4 args (editor, title, page, step) — no more
    producer arg
    - Base class makes component parameter optional with default None
    - Add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
2026-07-15 feat: add CNC spindle/coolant support and adapt to raygeo enum API
    - Add spindle and coolant fields to GcodeDialect with defaults
    - Implement _handle_spindle and _handle_coolant in GcodeEncoder
    - Handle air_assist/coolant returning enums from raygeo ops
    - Fix section_params 3-tuple unpacking in laser tests
    - Bump raygeo to 1.21.0
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2026-07-15 Add bidirectional raster scan X-offset calibration
    Fixed-corner mechanical/firmware skew between left-to-right and
    right-to-left raster passes misaligns alternate scan rows on some
    machines, regardless of speed (a different case from the
    timing-delay skew LightBurn's speed table addresses).
    - Adds a bidir_x_offset_mm param to the Rasterizer producer (UI
    control + serialization), per engrave step rather than a single
    machine-wide value, since different jobs may want different
    corrections, and this may need to vary by speed in the future
    - Adds BidirScanOffsetTransformer, which shifts each right-to-left
    raster pass along X by that offset during gcode generation,
    preserving per-pixel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
2026-07-15 Improve material test grid block isolation
    - Doubles the auto-calculated overscan distance for individual test
    blocks, so backlash settling happens outside the visible engrave
    area rather than muddying whatever parameter the grid is testing
    - Adds Optimize to the default transformers, but disabled: its
    nearest-neighbor travel reordering has no concept of cell
    boundaries and was interleaving lines from different cells
    instead of engraving each one fully before moving to the next.
    Left toggleable rather than removed, so it's easy to compare
    with/without
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2026-07-15 bump to raygeo 1.12.2 to fix label power not applied in material grid
2026-07-18 fix: raster/wavefront settings sliders showing wrong default values
    Line Spacing, Sample Interval, and Step Over sliders displayed a
    hardcoded 0.1mm literal whenever the underlying step property was
    unset, but generation actually falls back to the laser's spot size
    (machine_defaults.line_interval_mm / laser.spot_size_mm) in that
    case. The slider never reflected what was really going to be
    generated until the user manually touched it, which is misleading
    and made a 0.04mm scan-line spacing look like it should have been
    0.1mm.
    Adds a shared get_selected_laser() helper on
    StepComponentSettingsWidget so the display fallback can be computed
    from the actual selected laser instead of a disconnecte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
2026-07-18 fix: overscan Automatic Distance switch permanently greyed out
    _update_sensitivity() computed auto_row's own sensitivity as
    "enabled and not auto and not native" -- a self-referential formula
    where the row disables itself whenever it's active. Since
    OverscanTransformer defaults auto=True, the switch was insensitive
    from the moment it was added, with no way to click it back off via
    the UI. distance_row correctly depends on "not auto" (manual
    distance is meaningless while auto-calculating); auto_row itself
    should only depend on the transformer being enabled and non-native.
2026-07-18 fix: auto overscan/lead-in-out distance recalculates to a smaller value on toggle
    EngraveStep, ContourStep, ShrinkWrapStep, and FrameStep all seeded
    their Overscan/LeadInOut transformer's initial auto-calculated
    distance from machine.max_cut_speed at step-creation time, while the
    settings widget's own _recalculate_distance() (fired when the user
    re-enables Auto after disabling it) uses step.cut_speed instead.
    Since distance scales with speed^2, and step.cut_speed is typically
    far lower than the machine's absolute max, toggling Auto off and
    back on silently shrinks the distance to a different value than what
    was shown when the step was first created -- with no actual change
    in speed or accele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
2026-07-19 fix: blank sketcher UI text on packaged installs (issue #315)
    The custom po_compiler.py wrote empty msgstr entries to .mo files,
    unlike GNU msgfmt which skips them. When register_addon_domain loaded
    such .mo files, gettext returned empty strings instead of falling
    back to the msgid, blanking out sketcher menu/button/label text.
    Fix by filtering untranslated entries in compile_po_to_mo, and add
    a defensive guard in register_addon_domain for pre-existing broken
    .mo files on user systems.
2026-07-21 Add dot width correction for raster engraving
    Adds EngraveStep.dot_width_correction_mm, wiring the new raygeo
    dot_width_correction_mm parameter through get_assembler_kwargs/
    assemble_on_surface and a matching Raster settings UI row. Follows
    the same convention as line_interval_mm/sample_interval_mm: None
    means "auto" (half the selected laser's spot_size_mm[0]), an
    explicit float overrides it.
    Requires the corresponding raygeo change (branch
    feature/dot-width-correction), which does the actual power-array
    trimming.
    Also adds a mocked test asserting assemble_on_surface resolves the
    auto-default correctly (half the laser's spot size when unset, the
    explicit override when set) -- the same "res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
2026-07-22 fix: use persistent /dev/v4l/by-id/ paths for camera identification on Linux
    On Linux, camera device numbers (/dev/videoN) are assigned by the
    kernel based on discovery order and can change between reboots.
    This caused Rayforge to grab the wrong camera after a full shutdown.
    The fix uses /dev/v4l/by-id/ symlinks which are based on persistent
    hardware identifiers (vendor, product, serial number). Changes:
    - New v4l module scans /dev/v4l/by-id/ for video capture symlinks
    - Camera scanning now returns by-id paths instead of numeric indices
    - Existing configs with numeric device IDs are auto-migrated on load
    - Camera names in the UI are derived from the by-id path for clarity
    Closes #317
    [controller.py]
2026-07-22 refactor: encapsulate v4l display and migration logic in v4l module
    Add display_name() and migrate_camera_data() as the public API for the
    v4l module, removing scattered resolve_device_id and
    friendly_name_from_by_id imports from the camera model and UI layers.
    - Camera model no longer depends on v4l
    - UI files use display_name() for clean device labels
    - Camera names use friendly display names instead of raw paths
    - Add tests for new public API functions
    - Fix line length lint errors in test_v4l.py
    [controller.py, machine.py, settings_dialog.py]
2026-07-27 Wire contour compute through raygeo intent pipeline
    Contour workpiece compute nodes now build StageSpec::Compute with a
    real ContourSpec populated from the step's resolved assembler kwargs
    and machine defaults, instead of the placeholder ContourSpec.
    Step gains overridable build_compute_payload / assembler_token_params
    hooks; ContourStep overrides both. IntentBuilder takes the machine,
    resolves MachineDefaults (folding in arc_tolerance / supports_arcs /
    supports_curves), and delegates to the step. The compute version token
    folds in the step's assembler params so contour-spec and machine
    changes invalidate the cache.
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2026-07-27 Replace multiprocessing pipeline with raygeo intent orchestration
    - Rewrite Pipeline to wrap IntentController (dispatch=True), removing
    the DAG/SHM/multiprocessing stage runner entirely
    - Delete stage, dag, context, and lifecycle modules; ArtifactStore is
    now a simple in-process dict with reference counting
    - Remove ArtifactManager wrapper; move checkout_handle to ArtifactStore
    - IntentController: debounced rebuilds on background thread, epoch
    filtering, pause/resume, auto_rebuild, signal relays
    - IntentBuilder: stable node keys, SHA-1 version tokens, position-
    sensitive folding, typed Machine/Dialect access (no getattr)
    - All step kinds have build_compute_payload overrides returning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
2026-07-27 pipeline: replace machine.encode_ops with MachineTransformCompute stage
    Delete encode_ops/_prepare_ops_for_encoding/_apply_per_layer_wcs_offset/
    _apply_replacement_downstream from Machine. Wire MachineTransformSpec
    + MachineTransformCompute (Rust) into IntentBuilder. cmd.py frame
    path uses MachineSpace transform + driver encoder directly.
    Fix all driver/machine/cmd tests to use new production paths. Remove
    obsolete test_encode_ops_* and TestPrepareOpsForEncoding tests. Add
    E2E pipeline tests verifying origin, WCS offset, and linearize
    behaviour on the final G-code output.
    [machine.py]
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2026-07-27 fix: populate mapped_ops in JobArtifact for 3D rotary rendering
    The pipeline rewrite (7f317574) dropped the KinematicMapping pass
    that previously created mapped_ops for the JobArtifact. Without it,
    the 3D scene compiler fell back to raw ops (Y in mm, no extra_axes
    degrees), causing rotary textures and lines to be compressed in Y by
    a factor of 360/(pi*d) (~4x at d=30mm) because the cylinder mesh
    treated mm values as degrees via radians().
    Restore the mapped_ops creation in _on_job_encoded, matching the
    original job_compute.py logic: copy ops, apply KinematicMapping with
    apply_gear_ratio=False when rotary modules are present.
2026-07-28 pipeline: cancel in-flight intent on force_rebuild; handle None encode
    When a rebuild is requested while one is already running, signal
    the in-flight Intent to cancel cooperatively instead of waiting
    for it to finish before starting the next generation.
    Also handle the case where the encode stage returns None (e.g. after
    cancellation) in Pipeline._on_job_encoded rather than crashing on
    handle.text.
    Tests: bypass Pipeline.doc property setter in view_manager tests
    to avoid triggering an intent rebuild on a mock doc.
2026-07-28 fix(rotary): add module fallback and trigger pipeline rebuild on machine changes
    - Add Machine.get_rotary_module_for_layer() that falls back to the
    default module (or the first available module) when the layer has
    rotary_enabled but no valid rotary_module_uid.
    - Use this fallback in apply_to_job_ops, _build_rotary_mappings,
    configure_for_layer, canvas3d, and the cache token payload so that
    rotary mapping is always applied when rotary is enabled.
    - Remove the rotary_module_uid requirement from _resolve_rotary_layer_by_uid
    and get_rotary_axis_for_layer since the fallback handles missing UIDs.
    - Connect machine.changed to pipeline._on_machine_changed so that
    setting changes (rotary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
    [machine.py]
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2026-07-28 pipeline: configurable cache budget, error notifications, 3D scene memory fixes
    [general_preferences_page.py]
2026-07-28 pipeline: fix two hang-on-generation bugs
    - IntentController._rebuild(): early-return when already rebuilding,
    prevents the constructor's debounced timer from racing with
    force_rebuild() and starting a concurrent rebuild chain.
    - Pipeline.generate_job_artifact(): pass weak=False to blinker connect
    so the _on_finished closure isn't silently garbage-collected before
    the pipeline completes, leaving the future unresolved.
2026-07-29 feat: rewrite scene compiler to use Rust compile_scene_3d, chunked GL upload in canvas3d
    - scene_compiler.py: replace Python vertex/texture generation with
    delegation to raygeo's Rust compile_scene_3d()
    - Delete rotary_coords.py (superseded by Rust scene compiler)
    - compiled_scene.py: use Any type for offset fields to accept both
    numpy arrays and lists from Rust
    - canvas3d.py: chunked VBO upload via GLib.idle_add to avoid
    blocking the main thread; move snapshot building to background
    thread via task_mgr.run_thread
    - Bump raygeo dependency to 1.26.0
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2026-08-02 fix: serialize CNC step attributes in project files
    CncAssemblerStep and its concrete subclasses did not override
    to_dict/from_dict, so CNC parameters (tool_diameter, spindle_rpm,
    target_depth, etc.) were silently dropped on save. Add polymorphic
    serialization overrides plus a Step._serialized_keys() hook so
    unknown keys from newer files still land in extra instead of being
    mistaken for known CNC attributes.
2026-08-02 refactor: rename selected_laser_uid to selected_head_uid
    Rename the step head-selection attribute and serialization key to be
    domain-neutral. get_selected_laser() becomes get_selected_head() and
    returns a generic Head. Old project and recipe files load via alias
    migration, keeping the legacy key out of extra.
    Also restrict LaserHeadVar choices to laser heads (via the
    machine_capability property, avoiding a circular import) and guard
    the kerf-sync handler so selecting a SpindleHead cannot crash.
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2026-08-02 fix: disambiguate EngraveStep raster power range from max_power
    EngraveStep overloaded max_power (laser hardware max in mW) as its
    raster power ceiling (0-1 float), colliding semantics under one
    serialized key. Rename the raster range to min_power_level /
    max_power_level. LaserStep.max_power is now cleanly typed as int.
    Legacy engrave files keyed the raster range as min_power/max_power;
    from_dict migrates those into the _level attributes and resets the
    hardware max_power slot instead of inheriting the raster ceiling.
    EngraveStep gains _serialized_keys for its raster keys.
2026-08-02 refactor: give steps the machine, drop MachineDefaults
    Pass the Machine to build_compute_payload/assembler_token_params and
    let each domain step resolve its own process parameters from it. This
    eliminates the laser-flavoured MachineDefaults object that was shared
    through the pipeline and removes it from core entirely.
    Laser steps read the machine (arc tolerance, head spot) directly via
    LaserStep.get_laser_spot; CNC steps ignore it. The pipeline and its
    controller now require a machine, so the step methods' machine
    parameter is typed non-optional. CNC payload power is expressed as
    the spindle RPM / max RPM ratio so toolpaths render at the right
    intensity instead of the zero-power colour.
2026-08-02 refactor: strip laser attributes from core Step
    Move laser-only attributes (power, kerf, air assist, etc.) from the core
    Step into the laser addon's LaserStep base and its concrete steps. Steps
    now own their import-settings application via apply_import_settings, so
    the lightburn importer no longer special-cases laser attributes and the
    assembler no longer mutates step settings directly.
2026-08-02 fix: power-dim 3D toolpaths on first open
    Build the op player before extracting playback offsets during the
    chunked artifact upload, so the ring/scanline renderer gets a valid
    playhead on the first render instead of drawing every vertex. Also
    upload the colour LUTs before vertex data and give the scanline
    overlay a power brightness ramp so it dims by power.
2026-08-02 refactor: separate driver features from step capabilities
    Drivers now report plain DriverFeatures data (PWMParams for PWM
    support) instead of building concrete Capability objects. The machine
    resolves a head's effective capabilities through an addon-registered
    resolver registry, so core no longer depends on the laser addon's
    PWMCapability.
    Move PWMCapability into the laser addon and resolve it there. Head
    spot resolution moves from LaserStep to a static LaserHead.get_spot_size,
    and head-specific process defaults move to Head.get_defaults. Steps no
    longer carry driver-capability or head-resolution methods.
    [driver.py, head.py, laser.py, machine.py]
2026-08-02 refactor: registry-backed step capabilities and machine-driven settings
    Add a StepCapabilityRegistry populated by addons via a new
    register_step_capabilities hook; recipes resolve their capability
    through it. Capabilities declare the machine capabilities they require,
    and machines filter a step's theoretical capabilities to the usable
    ones.
    Drop the separate driver-capability concept: PWM is now a
    MachineCapability inferred from Driver.supports_pwm(), and driver PWM
    params feed a dedicated machine settings group in the step dialog.
    Steps own their operation color via Step.get_operation_color() so the
    UI no longer references concrete capability names. The laser head
    selector is handled throu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
    [driver.py, head.py, laser.py, machine.py]
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2026-08-02 refactor: de-duplicate kerf and path offset into a single offset_mm
    The offset is now the sole per-step displacement, defaulting to half
    the laser head's spot size. Kerf becomes a derived read-only property
    on the laser head (spot_size_mm[0] / 2) and is no longer stored or
    edited on steps. The OffsetCapability/WITH_OFFSET axis is removed as
    redundant.
    - steps: drop kerf_mm, rename path_offset_mm to offset_mm
    - migrate legacy files: offset_mm = path_offset_mm + kerf_mm / 2
    - create() seeds offset_mm from the default head's kerf
    - UI: PathOffsetRow/KerfRow replaced by a single OffsetRow; kerf is no
    longer synced on head change
    - LightBurn importer maps kerf (full width) to offset_mm (halved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
    [laser.py]
2026-08-03 feat: unified machine configuration wizard with AI spec lookup
    Replace the legacy profile selector + config wizard with a single
    adaptive wizard (profile pick, controller, connection, probe, AI spec
    lookup, hardware, head, rotary, cameras, review) driven by a working
    DeviceProfile. Add Lightburn import flow, per-page wizard classes, and
    a page-based camera wizard (image settings, lens calibration, world
    alignment) with reusable widgets.
    Remove the built-in generic device profiles and the old
    profile_selector/config_wizard modules.
    [ai_lookup_page.py, camera_page.py, connection_page.py, controller_page.py, grbl_network.py, hardware_page.py, head_page.py]
2026-08-04 deps: bump raygeo to 1.31.2
    Pick up fixes for multipass raster engraving:
    - full-sweep mode now power-gates masked regions instead of
    engraving full rectangles
    - per-pass OpsSection wrapping prevents optimizer from
    reordering segments across Z-passes
    - cross-hatch now interleaves angles per pass instead of
    processing all passes at one angle before starting the other
    Also fix z-fighting between Z-passes in the 3D sim view by
    disabling depth writes during scanline and cut-line rendering
    so passes blend instead of occluding each other.
2026-08-04 add some icons to avoid theme fallback that breaks on some platforms
    [controller_page.py]
2026-08-05 refactor: unit spin rows use a subtitle format string with {unit}/{max} placeholders
    Replace the implicit plain-subtitle-plus-appended-unit behavior with an
    explicit subtitle_format: callers pass a format string whose {unit}
    (the unit label) and {max} (the formatted upper bound) placeholders are
    substituted, and no unit is appended separately. The generic {max}
    replaces the speed-specific {max_speed}. Update all UnitSpinRowHelper
    and UnitSelectorSpinRow callers.
    [general_preferences_page.py, hardware_page.py, head_preferences_page.py]
2026-08-05 feat: add service registry + settings-page hooks and enforce addon requires ordering
    Add a generic ServiceRegistry and register_services hook so addons can
    publish services resolved by key (no cross-package import), and a
    register_settings_pages hook so addons can contribute pages to the
    Settings dialog. Enforce manifest requires at load time with a
    topological pass so dependencies load before dependents. Bump
    PLUGIN_API_VERSION to 18.
    [settings_dialog.py]
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2026-08-05 Bump raygeo to 1.32.1 and fix raster pixel extent
    - Pin raygeo to 1.32.1 in pixi.toml, requirements.txt, and the Debian
    requirements bundle.
    - Recompute raster pixels-per-mm from the actual integer target
    dimensions so the rendered image pixels exactly cover the workpiece
    size; the int() truncation previously left the image slightly smaller
    than size_mm, shrinking the raster by up to one pixel.
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2026-08-06 fix: wake in-flight ping-pong on cancel in simple GRBL driver
    [grbl_serial_simple.py]
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2026-08-06 fix: refresh step settings when a recipe is applied
    Applying a recipe wrote settings to the step without emitting its
    'updated' signal, so the settings dialog widgets (e.g. laser power)
    kept showing stale values until the dialog was reopened.
    Emit step.updated for every applied setting and force-resync the
    settings page rows when the recipe_applied signal fires.
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2026-08-06 fix: apply per-widget CSS for material colors in list
    Global CSS providers shared the .material-color class, so each new
    provider overrode the previous one and all rows showed the same color.
    Use a per-widget CssProvider like the material selector does.
2026-08-06 refactor: make screenshot filenames mirror targets 1:1
    Screenshot scripts now derive output filenames from the target via
    shared get_target()/target_to_filename() helpers instead of hardcoded
    names. Config-wizard targets are now top-level (config-wizard:*), the
    wizard page id 'connection' is renamed to 'connect', and existing PNGs
    plus docs/i18n references are renamed to match.
    Also register install-guide anchors with Docusaurus' broken-anchor
    checker and fix cross-locale anchor links in developer docs.
    [unified_wizard.py]
2026-08-06 fix: migrate legacy opsproducer params when loading steps
    Steps saved before the raygeo-pipeline refactor stored their producer
    parameters inside opsproducer_dict.params, which the load path ignored.
    Restore them so saved settings (e.g. wavefront step-over) survive loading
    instead of falling back to machine defaults.
    Also give WavefrontStep a raster-trace fallback for vectorless workpieces
    so pockets still get cleared when the source has no boundaries.
2026-08-06 refactor: isolate GL state and shader uniforms at the orchestrator level
    SceneRenderer brackets each child renderer call in a render_pass that
    restores GL pipeline state (incl. texture bindings) and each shader's
    uniforms on exit, so renderers no longer manage cross-renderer state
    themselves. Shader now snapshots/restores uniforms via the context
    manager protocol; SceneRenderer owns the BackgroundShader like every
    other shader; renderers drop redundant manual resets.
2026-08-06 refactor: normalize all renderers to prepare(ctx) + render(ctx, shaders)
    Every BaseRenderer now conforms to a uniform protocol: prepare(ctx)
    performs per-frame state setup and render(ctx, shaders) performs the
    draw, pulling all state from RenderContext and picking its program
    from the ShaderSet. The SceneRenderer populates the per-frame ctx
    fields and dispatches each renderer uniformly inside render_pass.
    - OpsRenderer/RingBufferRenderer: is_rotary flag; read mvp and
    executed-vertex counts from ctx; the layer group no longer passes
    mvp or counts positionally and its deferred ring tuple drops the mvp
    - LaserBeamRenderer: update_from_state collapsed into prepare(ctx)
    - TextureArtifactRend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
2026-08-07 refactor: replace min/max_value_in_base bounds with base-unit lower/upper
    [advanced_preferences_page.py, hardware_page.py, head_page.py, head_preferences_page.py, nogo_zones_page.py, rotary_module_page.py, rotary_page.py]
2026-08-07 refactor: drive scene rendering through an ordered render registry
    Replace the bespoke per-renderer dispatch in SceneRenderer.render with a
    registry of LayerRenderer entries built in draw order, and collapse the
    orchestrator to a two-pass prepare/render loop.
    - LayerRendererGroup splits into prepare(ctx) + render(ctx, shaders)
    (ops) + render_ring(ctx, shaders); the deferred ring tuple is gone
    - rings draw after textures via a RingPassAdapter registered late
    - SceneRenderer.render(ctx) reads all frame state from the context;
    canvas3d.on_render populates the machine/doc/op_player/viewport flags
    and the rotary MVP helpers (mvp_flat_gl, mvp_rot_gl, cyl_mesh_mvp_gl,
    rot_4x4) once per fra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
2026-08-07 fix: force isolated config for screenshot runs
    Force RAYFORGE_CONFIG_DIR in the screenshot CLI so runs never fall back
    to the developer's personal machine configuration, and extend the test
    machines with the new laser head fields (laser_type, pulse width, PWM
    frequency).
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2026-08-07 Standardize matrix convention at the shader boundary
    RenderContext now carries row-major matrices exclusively and
    Shader.set_mat4/set_mat3 transpose to column-major internally (GL_TRUE),
    removing the ad-hoc transposes at renderer call sites. Drop the
    mvp_flat_gl/mvp_rot_gl/cyl_mesh_mvp_gl fields in favor of row-major
    mvp_rot/cyl_mesh_mvp; fix the texture_renderer cylinder double-transpose
    and the axis/plane reverse multiplication order. Add test_matrix_convention
    guarding the boundary.
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2026-08-07 feat(sim3d): smooth distance-based playback with sub-command interpolation
    Playback now advances the simulated clock by real time times the speed
    multiplier and lands on the command in effect at that time, so motion
    follows machine feed/rapid rates instead of one step per command. The
    toolpath reveal and laser head are interpolated within the in-progress
    command (fractional executed vertex count with a moved boundary vertex
    in the shader, and axes interpolated via render_state), and every tick
    redraws so long moves no longer jump. Scrubbing the slider during
    playback resyncs the clock so playback continues from the dragged
    position. The laser beam follows the in-progress command's laser_on s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
2026-08-08 feat(sim3d): glide step buttons instead of jumping
    Step forward/backward now animates the simulated clock over a fixed
    ~0.2 s window regardless of the command's simulated length, so the
    toolpath reveal and laser head glide to the next command instead of
    teleporting. Rapid clicks accumulate into a signed queue that is
    coalesced and retargets the in-flight glide, moving the coalesced
    number of commands in the time of a single step; opposing clicks
    cancel out. The simulated clock is resynced when a player is attached
    even if the slider does not move, and any seek, scrub, or play start
    cancels the glide and drops queued steps.
2026-08-08 fix(sim3d): use unmapped ops for playback time model
    Rotary-mapped ops keep endpoint Y at a constant while the real
    rotation lives in extra axes, so line distances lose their Y
    component and arcs become degenerate (nearly-coincident endpoints
    with huge mixed-unit radii sweep almost 2pi). The cumulative-time
    index built from them produced absurd durations for random commands,
    e.g. 394s for a 0.1mm arc. The playback time model now uses the raw
    assembled ops, whose unwrapped geometry carries the true path; the
    mapped ops still drive state and rendering. Command indices and order
    are identical between the two, so the index stays in sync.
2026-08-08 deps: bump raygeo to 1.33.0
    Pin raygeo to 1.33.0 in pixi.toml, requirements.txt, and the Debian
    requirements bundle. The release includes the 1.32.2 fix for
    Part::from_geometry_multi_face dropping open contours, which caused
    stroke-only cut lines (e.g. engraved crosshairs in imported SVGs) to
    be missing from the generated ops. Beyond that, 1.33.0 adds:
    - a cached cumulative-time index on Ops (find_index_at_time,
    get_cumulative_time_at) powering simulated playback at real machine
    speed
    - lifting cylinder-mapped overlay lines off the cylinder, which fixes
    inconsistent-looking ops during simulation in rotary mode: some ops
    previously moved slightly through the cylinder
    - CI workflow up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
2026-08-08 test(sim3d): mock missing GL calls in renderer and theme tests
    The UI test suite on Windows CI runs without a GL context, so any real
    OpenGL call raises GLError(1282). Mock glActiveTexture/glBindTexture/
    glDepthMask in the ops-renderer clamp test and glClearColor in the
    theme-resolver test, matching the other render tests.
2026-08-08 fix(sim3d): grab keyboard focus when the 3D canvas is clicked
    Clicking the canvas did not move keyboard focus to the GLArea, so the
    previously-focused widget kept consuming key events and Space no longer
    toggled playback. Grab focus via a GestureClick on any button press.
2026-08-08 apply the second batch of ruff auto-fixes
    [axis.py]
2026-08-08 lint: fix low-count ruff errors (SIM118, LOG015, UP007, F401, B018, TRY401, DTZ, S112, B023, etc)
    [grbl_serial.py, machine.py]
2026-08-08 lint: fix P1 errors (G201, DTZ005, TRY004)
    [controller.py]
2026-08-08 lint: fix SIM117 by combining nested with statements
    [grbl_network.py]
2026-08-08 lint: fix F841 unused exception variables
    [controller.py, grbl_serial.py, grbl_serial_simple.py]
2026-08-08 lint: fix S110 try-except-pass by narrowing or logging
    [controller.py, dummy.py, machine_dropdown.py, websocket.py]
2026-08-08 lint: fix SIM102 by combining nested if statements
    [grbl_serial.py, grbl_util.py]
2026-08-08 lint: fix BLE001 by narrowing exceptions in ui_gtk
    [ai_lookup_page.py, camera_page.py, connection_page.py, manager.py]
2026-08-08 lint: fix BLE001 blind exceptions and E501 line lengths
    Narrow blind exception catches across addon_mgr, app, builtin_addons,
    camera, core, doceditor, image, license, machine, shared, simulator,
    and ui_gtk to concrete exception types. Use targeted noqa comments at
    genuine boundaries (arbitrary user eval/scripts, plugin providers,
    async task/callback boundaries, shutdown cleanup). Wrap the E501
    line-too-long violations and align tests with the narrowed handlers.
    [controller.py, grbl_network.py]
2026-08-09 lint: fix pyright errors across steps, drivers, and tests
    Type the OpsTransformer lookup with a Protocol so pyright knows the
    LeadInOutTransformer API. Return False explicitly from the SVG load
    capability probe. Key the GRBL settings map by var.key instead of Var
    instances. Use type-ignore for dynamic builtins._ and row attribute
    assignment, and cast dynamically-typed steps to Any in tests.
    [dialect_editor.py, grbl_network.py, grbl_serial_simple.py]
2026-08-09 lint: fix RUF012 by annotating mutable class attributes as ClassVar
    [general_preferences_page.py, settings_dialog.py]
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2026-08-09 fix: run machine switch config update on the main thread
    The machine switch coroutine ran on the TaskManager background thread and
    called config.set_machine directly, which synchronously fired config.changed
    handlers that mutate GTK widgets off the main thread. This raced with the GTK
    frame clock and caused native segfaults inside libgtk-4 during machine
    switches. Route the config update through a new TaskManager.run_on_main_thread
    helper so UI updates always happen on the main thread.
    [manager.py]
2026-08-09 fix: draw toolpath and scanline trail above the raster texture
    Render hardware (models, cylinder) before the ops and raster texture,
    and ops before the ring buffer so the trail stays on top. The toolpath
    and trail lines use GL_ALWAYS depth so they are never culled by the
    texture's surface depth on a curved cylinder face; depth writes stay
    off so later geometry is unaffected.
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2026-08-09 fix: use max-reduction mipmaps to prevent raster minification moire
    Build a max-reduction mip pyramid for the power texture and select the
    mip level from the texel footprint in the shader, so scanline rows do
    not alias into moire banding when the texture is minified. Zero-power
    pixels write depth instead of discarding so occluders behind the raster
    cannot bleed through the preview.
2026-08-09 refactor: move scanline dilation into raygeo rasterizer
    Replace the O((2r+1)^2) Python np.roll dilation loop with a radius_px brush fused into raygeo's rasterize_scanlines. Fixes wraparound bleed at texture edges via bounds-clamping. Depends on the new raygeo radius_px support; pixi pin bump is staged separately.
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2026-08-10 fix: prepare sim3d vertex uploads in a worker thread
    Move the CPU-bound vertex decompression and concatenation out of the
    main-thread GL upload path. ChunkedUploadController now runs each item's
    prepare() via task_mgr.run_thread and only performs glBufferData uploads
    on the main thread, so a complex layer no longer blocks a frame.
2026-08-10 perf: reduce 3D canvas main-thread stalls after pipeline finish
    Offload CPU-bound vertex/texture/overlay preparation to worker threads
    and batch per-frame GPU work so the pipeline-finish path no longer
    freezes the UI:
    - render only on demand (auto_render off) so idle callbacks are not
    starved by continuous GLArea rendering
    - size ring buffers to the actual overlay vertex count instead of a
    fixed 4M-vertex capacity
    - batch axis label glyphs into one buffer upload and draw, cache
    shader uniform locations, and restore only changed uniforms
    - skip texture-binding and line-width state save/restore in render_pass
    - dedupe scene recompilation when the pipeline settles on the same job
    gener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
2026-08-10 deps: bump raygeo to 1.37.0
    Upgrade the geometry engine for the memory and threading wins of the
    v1.37.0 release:
    - Release the GIL in scene compilation, texture rasterization and
    CompressedArray decompression (py.detach), so rayforge's background
    scene-compile and chunked-upload worker threads no longer stall the
    UI thread.
    - OpNode shrinks from ~104 B to 72 B: raster job heap drops from
    ~183 MB to ~134 MB (~27%).
    - Switch to mimalloc with immediate purging: freed pages return to the
    OS instead of inflating glibc arenas with fragmentation churn
    (reclaims ~3 GB of wasted RSS in the app).
    - Scanline runs are optimized as index ranges without per-run Ops, the
    final pipeline stag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
2026-08-10 replace step capabilities with multi-step-type recipe targeting
    Recipes now target a list of step types instead of a single capability
    plus an optional step type. Removes the StepCapability class, its
    registry, and the register_step_capabilities hook entirely (it was only
    used by recipes); MachineCapability is unaffected.
    - Recipe.target_step_types replaces target_capability_name/target_step_type
    - matching drops the capability axis; specificity ranks by step-type count
    - from_dict best-effort migrates legacy recipe files
    - new StepTypeSelectionDialog (searchable multi-select) replaces the
    task/step-type dropdowns in the recipe editor
    - step-specific tabs show for a single targeted type;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
    [machine.py]
2026-08-10 register step settings pages via a dedicated registry
    Replace the step_settings_loaded hook with a
    step_settings_page_registry singleton and a register_step_settings_pages
    hook that addons use to register their page classes by assembler name.
    The dialog looks up the page class from the registry and builds extra
    settings pages from the page class's extra_pages producer methods.
    Also make get_registries fully table-driven: the three UI extension
    registries that were hardcoded in registration.py are now RegistryEntry
    entries with no hook (they are populated as side effects of other
    registration hooks), so core no longer imports UI modules directly.
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2026-08-11 refactor: unify item transforms onto the point-matrix path (#334)
    Rework world_item_to_machine and machine_item_to_world to transform the
    bounding-box corners through the matrix-based point methods, leaving
    only the corner selection (which bbox corner the position refers to) as
    scalar logic. The point transform itself now flows through a single
    source of truth.
    Add regression guards: a 16-config item round-trip across every native
    origin/reversal combination, plus forward pins for origin-with-reversal
    configs and broader machine_item_to_world coverage.
    [coordspace.py]
2026-08-11 feat: add workspace orientation as a matrix composition (#334)
    Introduce WorkspaceOrientation (native/rotated_left/rotated_right) on
    MachineSpace and compose the 90-degree rotation into the single
    world<->machine matrix path, so every point and item transform gains
    rotation automatically. The machine keeps reading native coordinates;
    the rotation only controls how the bed is presented in world space.
    machine_item_to_world swaps item extents under rotation to keep its
    bounding-box corner selection correct.
    Add a 48-config point+item round-trip and rotation-direction forward
    pins. Remove the now-tautological scalar/matrix equivalence guard,
    since the point methods delegate to the matrix and t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
    [coordspace.py]
2026-08-11 refactor: add MachineView facade and decouple WorkOriginElement (#334)
    Introduce MachineView, a display-facing projection of MachineSpace that
    exposes how the bed appears after the workspace rotation (visible origin
    corner, axis directions). It lives in machine/models so presentation
    concerns stay off the coordinate model.
    WorkOriginElement no longer imports MachineSpace; it takes the two axis
    booleans it needs through set_axis_direction, matching AxisRenderer's
    primitive-setter pattern. WorkSurface reads MachineView and passes the
    primitives. This is a breaking addon-API change; PLUGIN_API_VERSION is
    bumped to 21.
    [machine_view.py]
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2026-08-12 deps: bump raygeo to 1.38.2, restore air assist emission
    raygeo 1.38.2 fixes a regression from the encoder pipeline migration
    where laser step air assist settings never reached the ops stream.
    - LaserStep.populate_payload stamps payload.air_assist so M8/M9 are
    emitted again in the G-code
    - add doceditor e2e test asserting air assist commands in the
    exported G-code
2026-08-12 fix: bump raygeo to 1.38.3 for WCS offset fix
    The machine-transform stage now subtracts WCS offsets in machine space
    (after w2m) instead of world space (before w2m), fixing wrong G-code
    with axis reversal + WCS.
    Adds parametrized regression test covering all origin/reversal/WCS
    combinations.
2026-08-12 refactor: route coordinate transforms through MachinePanel
    Move display-facing coordinate conversions from MachineSpace to
    MachinePanel, which holds a reference to the Machine and derives a
    MachineSpace on demand. All UI callers (canvas, doceditor, simulator)
    now use machine.panel.* instead of machine.get_coordinate_space().*.
    MachinePanel gains proxy methods for world↔machine point/item
    transforms, workarea geometry, axis labels, and command offsets. A
    reference_position_world property replaces the removed
    Machine.get_reference_position_world method.
    Backend callers (encoder, frame generation) continue using
    MachineSpace.from_machine directly.
    [machine.py, machine_panel.py]
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2026-08-12 refactor: make both canvases consume MachinePanel presentation
    Add extent_frame and has_custom_work_area to MachinePanel so the
    presented geometry API is complete. ViewportConfig.from_machine_with_wcs
    now derives width/depth, model-matrix flips, margin_shift, extent frame,
    and axis flags from machine.panel instead of raw machine attributes.
    WorkSurface._machine_coords_to_canvas delegates to
    panel.machine_point_to_world() and _update_extent_frame_flat reads
    panel.extents/margins/workarea_size.
    [machine_panel.py]
2026-08-12 refactor: centralize inline world-transform helpers
    MultiSelectionGroup bounding boxes now use
    CanvasElement.get_world_bounding_box() instead of manual corner math,
    and the framing-selection path in Canvas consumes the same helper.
    Add MachinePanel.work_area_center() and replace three duplicate
    work-area center computations in array_dialog, layer_column, and
    drag_drop_cmd. Move selection bounds reporting from MainWindow into
    WorkSurface.get_selection_bounds(), which uses
    panel.get_workarea_world_rect() for the machine fallback.
    [machine_panel.py]
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2026-08-13 chore: bump raygeo to 1.39.0
    Upgrade the raygeo dependency to the 1.39.0 release (concave hull
    shrink-wrap rework) across pixi, pip, and debian requirement files.
    The concave hull wrapper now passes the new
    allow_self_intersections flag through to the backend and documents
    the membrane-band behavior. The hull test's remaining TODO is
    resolved: the concave hull must not intersect the grown convex hull
    and must enclose the per-component shapes.
2026-08-14 feat: replace tri-state menu with apply toggle in recipe post-processing
    The recipe post-processing page used a tri-state menu (leave
    unchanged / enabled / disabled) to decide whether the recipe should
    touch a transformer. Replace it with a plain toggle-button prefix on
    the expander row: on = apply, off = leave unchanged, with the group
    dimmed-but-interactive while off.
    The group now builds its enable control directly as a Gtk.Switch that
    both host pages place into the expander header, so the step settings
    dialog and the recipe editor share the same layout and construction
    code. Also update the recipe editor tests and the post-processing
    screenshot.
2026-08-14 fix: pass camera device IDs as ints to OpenCV 5.0 VideoCapture
    OpenCV 5.0 treats string arguments to VideoCapture as filenames,
    so probing with numeric strings like "0" never opens a camera.
    This broke device discovery on systems without /dev/v4l/by-id/
    symlinks (built-in webcams, Windows). Convert numeric device IDs
    to ints before probing; keep device paths as strings.
    [controller.py]
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2026-08-14 fix(sim3d): depth-test toolpath and scanline trail against models
    Use a small depth bias toward the camera instead of GL_ALWAYS so the
    toolpath and scanline trail win against the coplanar raster texture
    while the laser head model occludes them. Also prepare the laser beam
    before the model renderers so the point light reaches them again.
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2026-08-14 refactor: delete the StepRow hierarchy and update recipe docs
    Phase 6 cleanup: the step settings dialog is fully varset-driven, so
    the legacy row framework is gone.
    - Delete step_settings/rows (StepRow, ComboRow, CoolantRow,
    CutSpeedRow, HeadRow, SliderRow, SpinRow, SwitchRow, TravelSpeedRow)
    and their tests.
    - base.py: add_section takes plain widgets; recipe apply cancels
    pending edits and overrides (authoritative), while step.updated
    resyncs via sync_from_model preserving in-progress edits.
    - SpinRowAdapter no longer asserts on IntVar/FloatVar so plain
    Var(var_type=int/float) fallback rows (e.g. GRBL device settings)
    still render; digits/min/max are read only when present.
    - D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
2026-08-15 fix: keep ActionManager doc in sync when a project is loaded
    ActionManager cached the initial document in __init__, so handlers like
    edit-stock-item looked up items against the stale empty doc after loading
    a project, silently failing to open stock properties. Reconnect doc
    signals and retarget the current doc on editor document_changed.
2026-08-15 fix: honor panel rotation when nudging items with arrow keys
    [machine_panel.py]
2026-08-15 fix: make alignment, flip, spread, and move-to-corner commands honor panel rotation
    [machine_panel.py]
2026-08-15 fix(materials): reject absolute texture paths on Windows
    _is_safe_texture_name used path.is_absolute(), which on Windows returns
    False for POSIX-style absolute paths like /etc/evil.webp. Detect rooted
    paths under both POSIX and Windows semantics so textures can never
    escape the material library directory.
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2026-08-16 fix(sim3d): stop laser beam from drawing over the head model
    Depth-test the laser beam against the scene instead of disabling the
    depth test, so the laser head model and workpiece occlude it. Also
    align the beam height with the head-model placement by using the same
    effective focal distance default in both, so the beam spans from the
    workpiece to the nozzle rather than through the head model when no
    focal distance is configured.
    [laser.py, machine.py]
2026-08-16 build(deps): upgrade raygeo to 1.40.2
    Brings the raster fixes from 1.40.1: segmented-scan power modulation now
    follows the actual scan direction and rasterize_scanlines decides pixel
    coverage by pixel-center membership, so reversed scanlines no longer
    draw dashed and rows stop aliasing after re-gridding. 1.40.2 is a
    test-only alignment with those semantics (no API change), which keeps
    CI green on all platforms.
2026-08-16 fix(sim3d): add ops underlay toggle and guard zero-vertex exec count
    - Add a win.show_ops_underlay toggle button to the 3D canvas overlay,
    between the grid and travel buttons, that hides the raster underlay
    texture. The state persists in canvas_view and is applied through
    ctx.camera.show_ops_underlay.
    - _fractional_exec_count: when no vertices are uploaded, return 0
    instead of the raw command count, which could exceed vertex_count
    and crash the draw with executed > vertex_count.
    - Update the mip pyramid test to the GL floor-halving sizes shipped in
    the texture underlay fix.
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2026-08-16 refactor(sim3d): move scene visibility from camera to ScenePresenter
    Visibility of scene categories (grid, stock, models, ops underlay,
    no-go zones, workpiece images, travel moves) was scattered across
    renderers via early-return checks against ctx.camera.show_* flags,
    mixing a scene-assembly concern into the camera context.
    Introduce a SceneVisibility dataclass owned by ScenePresenter, carried
    per-frame through RenderContext.visibility. SceneRenderer now applies
    visibility in one place (_active_registry) using each renderer's
    visibility_key, so renderers no longer read visibility flags.
    CameraContext is now pure camera math (matrices, colors, line width).
    Travel moves remain excluded at up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
2026-08-16 fix(ui): right-align Adw.ComboRow inline values via monkey patch
    Adw.ComboRow's default factory draws a left-aligned, ellipsized label
    with width-chars=1, which collapses the selected value to a single
    letter plus an ellipsis whenever the row is squeezed (e.g. by an
    expanded title box). Monkey-patch Adw.ComboRow so every row renders
    the inline value right-aligned and never ellipsized, keeping its
    natural width flush against the row's trailing edge.
    Rows that install a custom factory or use-subtitle keep their custom
    rendering; setting either resets list-factory to None so the custom
    factory governs both the popover and the inline display. Drop the
    now-obsolete min-width CSS workaround and t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
    [hardware_page.py]
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2026-08-16 fix(sim3d): encode engrave power as opacity in preview LUTs
    [colors.py]
2026-08-16 fix(materials): keep removed tint color unset across save/reload
    MaterialAppearance.to_dict() omits the color key when the color is
    None (not tinted), but from_dict() fell back to the class default
    #f0f0f0 when the key was absent. Removing a material's tint then
    reopening the app resurrected the default gray. Treat a missing
    color as None to make the round trip symmetric.
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2026-08-16 feat(sim3d): textured rotary stock cylinder with material selection
    - Layer: stock_material_uid field with setter and property, persisted
    through LayerCmd history for dirty tracking
    - Stock compiler: solid textured cylinder rod (end caps, 48-ring shell)
    built from the layer's rotary diameter and chosen stock material,
    replacing the wireframe preview for stocked layers
    - Material selector: shared MaterialRow widget with swatch button used
    by both the layer settings and stock properties dialogs
    - Depth fixes uncovered while integrating the cylinder: window-space
    gl_FragDepth bias via a dedicated LineDepthBiasShader for toolpath
    and scanline trail lines (the old clip-space bias disp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
2026-08-16 fix(tracing): resize content only when downscaling for vtracer
    Downscaling the bordered image blended the white border into the
    content, so removing a fixed BORDER_SIZE offset and upscaling produced
    traced contours that were wider than the actual image content. Strip
    the border, resize the content, and re-add a fresh border so the
    downscaled trace keeps the exact content extent.
2026-08-16 fix(sim3d): update raygeo to 1.41.1 for rotary ortho toolpath fix
    Raygeo 1.41.1 lifts the rotary toolpath and scanline-trail lines by
    their linearization sagitta (MAX_SAGITTA) so their chords stay on or
    above the faceted cylinder surface. Previously the chords periodically
    sank below the stock shell / engrave quads; orthographic views resolve
    the sub-millimetre gap and hid those stretches, rendering the toolpath
    as a dashed line (perspective rounded it away, so only ortho was
    affected).
    Update the scene-compiler tests to the toolpath radius + MAX_SAGITTA.
2026-08-16 fix(tasker): enforce wait_until_settled timeout against wall clock
    [manager.py]
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2026-08-17 fix(tests): use generous wait_until_settled timeouts on CI
    The Windows CI runner stalled a 0.3s test coroutine for ~1.2s, so
    wait_until_settled(1000) hit its wall-clock deadline (now strictly
    enforced since 61460536) and correctly returned False, failing
    test_wait_until_settled_with_running_tasks.
    Raise the timeouts so transient scheduler stalls on slow runners do
    not exceed them, mirroring d7c73bce.
2026-08-17 ci: bump pinned pixi to 0.76.2 to fix broken upgrade
    pixi 0.68.x has a bug where 'pixi upgrade' fails with 'No
    Python interpreter found in the dependencies' on workspaces with a
    local editable pypi dependency (prefix-dev/pixi#6093, fixed in
    0.69.0 by prefix-dev/pixi#6095). Rayforge has exactly that setup
    with 'rayforge = { editable = true, path = "." }', so the weekly
    Update Pixi Dependencies job dies in the 'Upgrade dependencies'
    step.
    Bump the pinned CI pixi version to the current latest, which also
    matches the locally used pixi that wrote the current lock file.
2026-08-17 ci: exclude PyGObject from pixi upgrade to avoid stubs conflict
    The weekly Update Pixi Dependencies job fails during 'pixi upgrade'
    with:
    failed to solve the pypi requirements of environment 'default'
    Because pygobject-stubs==2.17.0 depends on pygobject>=3.55.0 and
    pygobject==3.50.0 ... your requirements are unsatisfiable.
    help: The following PyPI packages have been pinned by the conda
    solve ... pygobject==3.50.0
    pixi upgrade loosens every spec in pixi.toml before re-solving. The
    loosened conda solve backtracks PyGObject to 3.50.0, which violates
    the pygobject>=3.55.0 floor imposed by pygobject-stubs==2.17.0 in
    the subsequent pypi solve stage, so the whole upgrade aborts (see
    htt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
2026-08-19 fix: frame drives rotary axis instead of physical Y axis (#356)
    Apply the active layer's rotary mapping to the framing path so a
    TRUE_4TH_AXIS (or AXIS_REPLACEMENT) rotary layer sweeps the rotary axis
    instead of driving the physical Y axis. Previously the frame rectangle
    was encoded directly, bypassing the rotary kinematic mapping that the
    regular send path applies.
    - Add RotaryModule.is_replacement() to encapsulate the mode check
    - Map world-space frame ops before the world->machine transform and
    run the AXIS_REPLACEMENT degrees->machine-units pass after it
    - Add unit tests for the frame mapping helper plus an end-to-end SVG
    doceditor test asserting an A-axis move in the frame G-code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
    [rotary_module.py]
2026-08-19 Fix step settings speed field cursor jumping on clamp
    A widget's own debounced edit committed to the model round-tripped back
    through step.updated -> sync_from_model, rewriting the field while the
    user was still editing it. When the typed value was clamped to the
    machine max, this reset the text and jumped the cursor to the start.
    Track keys the widget is currently delivering as data_changed and skip
    them in sync_from_model so an in-progress edit is never overwritten by
    its own commit. Also make the spin-row setters idempotent to avoid
    redundant rewrites.
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2026-08-19 Make material test step rows unit-aware and preserve labels
    The material test step's speed and offset rows (label_speed, fixed_speed,
    speed_range, offset_range) displayed hardcoded mm/min and mm values
    regardless of the user's unit preferences, and their descriptions and
    subtitles baked in the unit strings. Convert them to SpeedVar and
    quantity-hinted TupleVars so the rows render unit-converting
    SpeedSpinRow/LengthSpinRow rows and drop the hardcoded units.
    TupleAdapter now builds unit-aware rows when the var declares a
    quantity and exchanges values in base units. Config/machine changes
    re-run update_from_var, which no longer clobbers a tuple row's first
    component title with the var's label,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
2026-08-19 fix: material test engrave raster smaller than the workpiece
    The material test preview (draw_preview) rendered the grid at its
    natural size and blitted it unscaled, so the grid only covered part
    of the raster surface. The Engrave step then mapped that image back
    to the workpiece size, leaving the engraved grid smaller than the
    workpiece. Scale the rendered grid to fill the full target surface.
2026-08-19 fix: material test preview misaligns with ops after resizing
    The procedural preview was always rendered at the recipe's natural
    size and then stretched to fill the surface. When the workpiece was
    resized (especially non-uniformly) the grid image no longer matched
    the material-test ops, which scale to fill workpiece.size. Thread the
    workpiece size through the render context into the drawing function so
    the preview is generated at the current size.
    Bump raygeo to 1.42.1 for the material test label layout fixes.
2026-08-19 feat(material): engrave material test speed labels in the user's speed unit
    Material test grid labels (axis titles, row/column speed values, and
    the fixed-speed caption) now render in the preferred speed display unit
    (mm/min, mm/s, in/min, in/s) instead of hardcoded mm/min. The step
    forwards the display-unit settings through the assembler spec, and the
    dialog preview uses the same settings.
    Bump raygeo to 1.43.0 (pixi.toml, requirements.txt, debian bundle,
    pixi.lock) for the new MaterialTestGridSpec label-unit fields.
    [general_preferences_page.py]
2026-08-19 fix: hide travel speed setting when machine lacks support
    [general_preferences_page.py, machine.py]
2026-08-21 fix: make GRBL driver own the hold/pause state so resume works
    Status polling is disabled while a job runs (poll_status_while_running
    defaults to False), so the driver never observes the firmware HOLD status
    after a pause. As a result state.status stayed RUN, the UI hold/resume
    toggle never entered "Resume" mode, and every click re-sent "!" (pause)
    instead of "~" (resume). Users resorted to Send, which is blocked by the
    "job already running" guard, yielding "Sending failed".
    set_hold() now records the hold intent and immediately reflects it in
    state.status (HOLD on pause, RUN on resume) and emits state_changed,
    independent of firmware status polling. The status-report handler also
    forces HO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
    [grbl_serial.py, grbl_serial_simple.py]
2026-08-21 Localize machine job failure notifications
    Move the notification out of the generic _start_job executor into the
    job-specific methods (frame_job, send_job) that intrinsically know the
    job kind. Each method now owns a complete, self-contained translatable
    sentence instead of embedding translated fragments into a shared
    template.
    Also mark the RuntimeError message in _execute_monitored_job for
    translation.
2026-08-21 fix: wire calibration card board into camera capture page
    The camera wizard's card page generates the CharucoBoard but it was
    never passed to the capture page, so the calibrator was never
    initialized and clicking Capture Frame silently did nothing. Sync the
    board when navigating to the capture page.
2026-08-21 fix: don't starve GRBL status polling during buffer stalls
    The connection loop sent its 0.5s status polls while holding _cmd_lock.
    A gcode send holds that same lock for the entire buffer-space wait,
    including stall retries, so a full RX buffer (e.g. a job paused with
    '!') blocked polls indefinitely. The driver state went stale, the UI
    hold/resume toggle desynced, and unresponsive firmware went unnoticed.
    Status polls are realtime bytes that bypass the GRBL RX buffer and its
    accounting (like '!'/'~' sent via _send_realtime), so no lock is
    needed. The connection loop now sends them without taking _cmd_lock.
    [grbl_serial.py]
2026-08-21 fix: abort GRBL job when device stops responding during buffer stalls
    The buffer stall callback retried forever when a job was paused or the
    device was silent, with no way to detect a controller that died mid-job
    (as seen in a user dump: 60+ seconds of 'Recovery successful, retrying
    send' while the firmware answered nothing, and no way to unpause).
    Liveness is now tracked at receipt, not interpretation: a monotonic
    response counter is bumped for every received status report, ok, and
    error, even when the report cannot be parsed. During buffer stalls the
    driver polls the device; after UNANSWERED_POLL_LIMIT (3) consecutive
    polls with no response of any kind, the job is aborted with a
    DeviceCon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
    [grbl_serial.py]
2026-08-21 fix: reflect RUN state at GRBL job start when status polling is off
    Status polling is disabled during jobs by default, so with no firmware
    reports arriving the driver never left the pre-job state and the UI
    kept showing Idle while a framing job was running (observed live).
    Like the hold-state fix before it, the driver owns the state while a
    job runs: _start_job() now sets RUN and emits state_changed, matching
    GrblSerialSimpleDriver. An existing ALARM is not masked, and the first
    status report after the job ends corrects the state as before.
    [grbl_serial.py]
2026-08-21 fix: send GRBL realtime console commands directly, not as gcode
    Console input of GRBL realtime characters (~, !, ?) went through
    run_raw(), which streams every line as buffered gcode via _start_job().
    The firmware executes realtime characters on receipt, bypasses the RX
    buffer, and never acknowledges them -- so besides queuing them behind
    buffered commands, the streamer then waited forever for an 'ok' that
    cannot come. Worse, _start_job() clobbered the driver's job state: in
    the original incident dump, two console '~' resume attempts against a
    wedged controller each started a phantom one-line job, flipping job
    state and leaving the user unable to send anything.
    run_raw() now splits realtime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
    [grbl_serial.py, grbl_serial_simple.py, grbl_util.py]
2026-08-21 fix: give 'job already running' rejection an actionable message
    When Send or Frame was pressed while another job ran, the user saw
    'Sending failed: Tried to start a job while another is running.' --
    a developer-oriented RuntimeError that gave no hint how to proceed.
    In the original incident dump, the running job was a zombie and Stop
    would have unwedged it, but nothing told the user that.
    The guard now raises a dedicated JobAlreadyRunningError whose message
    says what to do: wait for the job to finish or press Stop. Expected
    refusals are handled distinctly from failures: _start_job no longer
    logs a traceback for them, and frame_job/send_job notify the user
    with the plain message instead of t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
2026-08-21 fix: set has_z in builtin device profiles and persist it correctly
    Research each builtin machine profile for a motorized Z axis and mark
    the two-axis diode lasers with has_z: false. Z-capable machines
    (Carvera, Monport 60W, OMTech Polar, Sculpfun S40/S70 MAX, Thunder
    Nova 35) keep the default.
    Also fix two plumbing gaps: the wizard hardware page wrote None
    instead of False when Z was disabled, and MachineConfig.from_machine
    never exported has_z, losing the setting on profile export.
    [hardware_page.py]
2026-08-21 feat: review device-profile updates on configured machines
    Machines created from a device profile now record the profile id and
    the content hash of their last review. At startup, machines whose
    profile changed since then are flagged and a review dialog lists every
    differing setting (machine settings, laser head fields, G-code dialect
    template) with current vs. profile values; each row can be toggled
    before applying. Head objects and dialect copies are updated in place,
    never replaced, so UIDs stay stable.
    Review metadata lives at the attribute definition sites: MachineConfig
    fields carry setting bindings via dataclass field metadata, head
    attributes use a head_setting descriptor with serial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
    [head.py, laser.py, machine.py, profile_review_dialog.py, unified_wizard.py]
2026-08-21 fix: complete job-generation waiters when the rebuild fails
    Awaiting generate_job_artifact_async relied entirely on the happy
    path: job_generation_finished only fired after a successful intent
    build and encode. An unexpected exception in the background rebuild
    thread escaped unhandled, the completion signal never fired, and the
    awaiting send-job coroutine blocked forever while holding the job
    guard — wedging every later send attempt.
    The rebuild worker now catches unexpected errors in both the build
    and execution phases and emits job_generation_finished with a failed
    status; the encode path no longer drops the signal when the aggregate
    output is missing; and generate_job_artifact maps tha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
2026-08-21 fix(sim3d): stabilize 3D camera pan, zoom, and orbit
    - Clamp orbit pivots and plane picks to the grid so far clicks no longer
    cause extreme rotation, and fall back to a grid-clamped target
    - Normalize orbit sensitivity by pivot distance and ortho zoom so the
    view rotation rate stays consistent regardless of distance/zoom
    - Make perspective dolly multiplicative and clamped so zooming cannot
    overshoot past the target or reverse direction
    - Keep only the lateral component of the zoom cursor correction so it
    cannot fight the dolly
    - Pan the camera at mouse speed (pixel-based) and scale by the on-screen
    world-per-pixel so the plane tracks the pointer 1:1 in every view
    - Reject grazing-r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
2026-08-22 fix: keep spin entry text on clamped mid-edit round-trip
    Editing a SpinRow below its lower bound (e.g. pressing Delete in
    '150.00' yielding '10.00') emitted the range-clamped value; the
    consumer round-trip then rewrote the entry text via set_value(),
    resetting the cursor so Delete appeared to act like Backspace.
    Skip rewrites that merely echo the clamp of the raw entry text;
    GTK reformats the text itself when editing ends.
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2026-08-22 feat(screenshots): prevent config leaks with restore_config decorator
    All screenshot script mains are now wrapped in @restore_config, which
    suppresses config and machine persistence for the duration of the run
    and restores the config directory byte-for-byte afterwards. Staged
    machine settings (active machine, WCS, cameras, theme) can therefore
    no longer leak into tests/config, even on direct uiscript invocations.
    Also adds the main:3d-bee screenshot with its bee project asset and
    the matching test machine configuration.
2026-08-22 feat(website): redesign homepage and unify site styling with landing page
    - Redesign homepage hero with editorial style (Open Sans, charcoal/white,
    lifestyle photo with scrims)
    - Add 'Make your own parts' section with wood/blue/tree image blend
    - Add three-card feature section (Design / Prepare / Create) with soft
    tree side images
    - Remove redundant feature sections; fold AI mention into design section
    - Make Open Sans the site-wide default font, load all needed weights
    - Unify button styles across pages with homepage dark-ink/ghost language
    - Replace vibrant purple/cyan/red palette with charcoal + single warm
    orange accent site-wide (docs, blog, devices, sponsor, contributing)
    - Neutr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
2026-08-22 i18n(website): update localized homepages to redesigned layout
    Rewrite the de, es, fr, pt-BR, uk, and zh-CN homepage copies to mirror
    the redesigned landing page: new hero with two-line title, capability
    strip, 'Make your own parts' section, three feature cards, tutorial
    spotlight, and community section. Replaces references to removed CSS
    classes and the old embedded-video hero.
2026-08-22 fix: rewrite stale spin entry text after unit switch
    Switching the display unit (e.g. mm/min -> mm/s) narrows the adjustment
    bounds below the displayed value. The stale entry text then clamps to
    the new bound, so the clamp-echo guard took the converted value for a
    round-trip of a mid-edit and skipped the rewrite, leaving the old text
    (e.g. '1000.0' instead of '16.7') visible.
    Only preserve raw entry text that differs from the committed adjustment
    value (a genuine in-progress edit); a text matching the committed value
    is a stale rendering and must be rewritten. The config-change handler
    now likewise compares against the unclamped entry text instead of the
    range-clamped readback.
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2026-08-22 feat: bake laser engraving into the 3D stock as persistent charring
    Laser raster and vector ops now char the stock in the 3D preview
    instead of floating preview quads: the material fold emits a burn
    surface map, the stock compiler maps it onto prism vertices via
    power UVs, and the stock shader renders a power-keyed scorch ramp
    with a heat halo on top-facing surfaces. Texture layers covered by
    a visible stock's burn are suppressed, the show_lut_overlay toggle
    is removed in favor of mutually exclusive stock/underlay visibility,
    and the dependency is bumped to raygeo 1.44.0.
2026-08-22 feat: bake laser engraving into rotary stock in the 3D preview
    Rotary layers now char their cylindrical stock like flat stock does:
    the intent builder emits a material fold per rotary layer against a
    raygeo CylinderStock over the unrolled axial x circumference domain
    (centered on the machine origin), keyed stock:{layer.uid}; material
    states resolve to layers as well as stock items. The cylinder shell
    duplicates its seam at the bottom so power UVs span the unrolled
    domain without crossing the texture cut, and the shader burns lateral
    faces only via a uRotary guard on local normals.
    Also: rotary LUT quads are suppressed when a burn map covers them,
    the wireframe cylinder stays hidden while a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
2026-08-22 feat: guarantee a default stock material via the material manager
    The material manager now owns default-material resolution: it prefers
    the user-configured default (new config setting), then oak from any
    registered library, then a bundled oak shipped under
    rayforge/resources/materials/ that is never registered as a library
    and thus invisible in the material manager UI.
    New stock assets and layers get the configured default material and
    thickness at creation time (stock_cmd/layer_cmd). The 3D scene
    presenter falls back to the default material for flat and rotary
    stock, the wireframe cylinder placeholder is removed, and the 2D
    canvas resolves the default when a stock's material cannot be
    reso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
2026-08-22 feat: physical burn model with fluence-based charring in the 3D preview
    Replace the PWM-power burn approximation with a physically motivated
    fluence (J/cm²) model end to end:
    - Laser heads expose wavelength, optical wattage, and spot size; laser
    steps stamp them (plus scan speed) into the compute payload and fold
    them into the cache token so machine changes invalidate the burn.
    - Materials carry per-wavelength absorption data in their YAML; the new
    core.optical helpers resolve the coefficient for the active beam.
    - The intent builder emits fluence via raygeo 1.46 LaserPhysics, and
    the fold max-reduces it into an F32 surface map.
    - The stock shader's burn block maps absorbed fluence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
    [laser.py]
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2026-08-22 Fix workflow row step button outline not updating on laser color change
    WorkflowRow connected to machine.changed directly, but only if the
    machine existed at construction time. Since WorkflowRow is created
    during LayersTab init (before a machine may be assigned), the signal
    was never connected.
    Switch to config.changed which is always forwarded from
    machine.changed via config.set_machine, matching the pattern used by
    StepBox.
2026-08-22 fix(machine): subtract WCS offset in workpiece framing coordinates
    Framing built its ops in machine space and encoded them directly,
    skipping the WCS command offset subtraction performed by the regular
    send pipeline's machine-transform stage. The controller added the
    active WCS offset back on its end, applying it twice and driving the
    head toward doubled coordinates (issue #362).
    Frame ops now pass through a new MachineSpace.get_machine_to_command_matrix()
    so emitted coordinates are relative to the active WCS origin.
    [coordspace.py]
2026-08-22 fix: send $H instead of per-axis homing commands from Jog panel Home All button
    [jog_widget.py]
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2026-08-22 fix(simulator): interpolate along arc paths in render_state instead of linear lerp
    render_state() previously did linear interpolation between arc start
    and end points. For full circles (start == end) the head stayed put;
    for partial arcs it traced a chord. In rotary mode the cylinder
    rotation also stalled because the rotary angle was linearly
    interpolated between identical start/end values.
    Add _interpolate_arc() that traces the circle geometry for X and
    computes the rotary-axis angle from the arc's Cartesian Y
    displacement via a degrees-per-mm conversion factor. Full circles
    are detected and given a 2pi sweep. The extra_axes interpolation is
    skipped for the rotary axis during arcs.
    Al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
2026-08-23 Add mirror tools to sketcher
    Add Mirror Vertically and Mirror Horizontally toolbar buttons that
    mirror the current selection in-place across the bounding-box center.
    Constraints spanning the selection boundary are dropped; internal
    constraints are preserved. Chirality-sensitive constraints
    (AngleConstraint) are negated or dropped if expression-based.
    - MirrorCommand with MirrorAxis/MirrorDirection enum
    - Polymorphic Entity.mirror() (Bezier flips cp deltas, Arc toggles
    clockwise)
    - Polymorphic Constraint.mirror() / is_mirror_compatible()
    (AngleConstraint negates signed value)
    - Constraint.get_referenced_point_ids()/get_referenced_entity_ids()
    refactored from depends_on_* f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
2026-08-23 Sketcher: track saved state, fix history coalescing and add undo/redo buttons
    - Mark the document as changed while the sketch is being edited (the
    sketcher uses its own HistoryManager which was disconnected from the
    document's saved-state tracking). Undoing back to the entry state
    restores the previous saved state.
    - Add MoveEntitiesCommand so dragging an entity creates an undoable
    command; previously entity moves bypassed the history entirely.
    - Coalesce the constraint-create + dialog-edit into a single history
    entry via a new HistoryManager.coalesce() that bypasses the time
    threshold. Skip the no-op CreateOrEditConstraintCommand when an
    existing constraint is found.
    - Apply t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
2026-08-23 Add Ctrl+D duplicate tool to sketcher
    Ctrl+D duplicates the current selection in-place: selected entities
    and their points are copied with fresh IDs, internal constraints
    (all references within the selection) are copied and remapped to the
    duplicates. Constraints referencing geometry outside the selection
    are not copied, matching the mirror tools' behavior. Fixed points
    (e.g. the origin) are duplicated as movable points. After
    duplicating, only the copies are selected. Undo removes the
    duplicates and restores the previous state.
    Also fixes a hit-testing z-order issue: entities and points were
    hit-tested in list order while rendering draws in list order, so
    overlapping geometry (e.g. fresh d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
2026-08-23 Show USB serial ports first with two-line port selector
    Sort serial ports so USB adapters (ttyUSB/ttyACM) come before
    hardware ports, both in SerialTransport.list_ports() and the
    port dropdown. Add SerialTransport.list_port_info() providing
    device descriptions from pyserial, or from /dev/serial/by-id
    symlink names when running sandboxed.
    Rework SerialPortAdapter into a two-line combo row mirroring the
    WCS selector: device path plus a dimmed description line. A
    configured port that is not currently plugged in is pinned to
    the top of the list instead of being appended at the end.
    [serial.py]
2026-08-23 fix(test): replace fixed sleep with wait_for_send_call in buffer stall test
    The 10ms sleep between acks was a race: on slow CI runners, line2 hadn't
    hit the wire yet, causing the second ack to be consumed early and line2
    to never be acked — spinning the drain loop forever on unknown status
    reports. Use wait_for_send_call() like the sibling test does.
2026-08-23 Fix Windows failures in serial port sorting tests
    is_usb_serial_port() treats every port as USB on non-POSIX systems,
    so the new sorting and port info tests must pin os.name to posix
    when exercising Linux-style /dev/tty* paths.
2026-08-23 Fix slow GRBL serial handshake with grblHAL compatibility level 0
    grblHAL at COMPATIBILITY_LEVEL 0 announces itself as 'GrblHAL ...'
    instead of 'Grbl ...', which did not match the welcome-message
    handshake check. Combined with devices dropping the initial '?'
    poll while still booting, every connection attempt timed out
    (2s wait + 5s sleep per retry).
    Accept the grblHAL banner and repeat the '?' poll for up to 2s
    until the device responds. Also clear the handshake event before
    opening the port so early responses are not discarded.
    [grbl_serial.py, grbl_serial_simple.py]
2026-08-23 Pin os.name to posix in serial port adapter UI tests
    The adapter sorts via is_usb_serial_port(), which treats every port
    as USB on non-POSIX platforms. Patch os.name alongside the port
    scan so the Linux-style fixtures sort as expected on Windows.
2026-08-25 Add parametric circular array tool to the sketcher
    Implements circular arrays (polar patterns) for issue #358:
    - New PatternStrategy framework (sketcher/core/patterns/) so further
    array types (e.g. linear) only need a strategy subclass
    - Copies are entity groups linked to the template member through new
    RotationalConstraints; deleting a member removes only its own
    constraints and never redistributes survivors
    - The construction guide circle acts as the array's master: it carries
    the pattern definition, its radius dimension resizes the whole array,
    and double-clicking it reopens the edit dialog (regenerating missing
    or re-distributing members)
    - Non-modal dialog with live preview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
2026-08-25 fix(sim3d): keep playhead, slider, and gcode viewer in sync
    Playback stalled for tens of seconds on large jobs because every
    tick-driven slider move triggered a full OpPlayer.seek() on the main
    thread, replaying commands from scratch while the background snapshot
    build had not finished (issue #370). The playhead is now anchored by
    command index instead:
    - OpPlayer.set_playhead()/set_progress_anchor() place the playhead by
    index, exact across clusters of zero-duration commands; forward
    playback advances state incrementally via sync_state_to_playhead().
    - The overlay never seeks during tick-driven updates; user scrubs and
    G-code viewer clicks stay seek-based.
    - With an op map, the slide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
2026-08-26 Add permission pre-flight page to machine wizard
    Check serial-port and camera access before discovery starts; when
    devices exist but the user cannot open them, open the wizard on a new
    first page that explains the problem per platform (Snap interfaces vs.
    owner groups derived from the device node) and lets each remediation
    command be copied with a single click.
    [permissions_page.py, unified_wizard.py]
2026-08-26 Turn tool outputs off when a job is stopped or aborted
    Fixes #379
    The dialect's laser/tool-off postscript is baked into the G-code, so
    it never runs when a job is interrupted mid-stream. A persistent PWM
    command (M3 S{power}) therefore stayed latched after Stop.
    - Add GcodeDialect.emergency_stop (configurable failsafe command,
    e.g. M112; defaults to M112 for Marlin and Smoothieware) and
    get_safety_off_commands() for the deduplicated tool/aux-off set
    - Send the safety commands on every cancel in the GRBL serial
    (advanced + simple), GRBL network, Marlin, and Smoothie drivers,
    best-effort so an unresponsive device cannot block cancellation
    - Error/interruption paths additionally send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
    [driver.py, dummy.py, grbl_network.py, grbl_serial.py, grbl_serial_simple.py, marlin_serial.py]
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2026-08-26 fix(discovery): show real GRBL banner and survive slow-booting devices
    The generic discovery layer assumed text-line/ASCII output by
    extracting a banner with extract_banner(); that is driver-specific
    knowledge. Move banner extraction into each driver's recognizer
    (name field): GRBL skips bare ok/error: acks (which arrived ahead
    of the real banner when a DTR reset delayed the boot), and Marlin
    gains its own boot-message extractor. build_identity no longer
    guesses a banner from raw bytes.
    Also fix intermittent probe failures: opening a USB-serial port
    toggles DTR and resets many GRBL boards, whose bootloader can take
    longer than the 2 s handshake window; every retry then reopened the
    port and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
    [grbl_probe.py, grbl_serial.py, grbl_util.py, machine.py, marlin_serial.py, marlin_util.py]
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2026-08-26 feat(discovery): discover ESP3D boards via mDNS
    ESP3D v3 firmware advertises a dedicated _esp3d._tcp service.
    GrblNetworkDriver now declares it, so ESP3D boards show up on the
    wizard's discover page. A resolved announcement carries everything
    the driver needs (host and HTTP port; ws_port and protocol have
    setup-var defaults), so the wizard skips the connect page and goes
    straight to probing.
    [grbl_network.py]
2026-08-26 Refactor device discovery into channel-based machine/discovery package
    - Split driver/discovery.py into machine/discovery/{types,spec,
    serial_channel,mdns_channel,engine,session}.py
    - Replace DISCOVERY/MDNS_SERVICES/MDNS_TXT_MAP driver attributes with
    a single DiscoverySpec of per-channel recognizers
    - Move USB/serial identity helpers (GENERIC_TOKENS, normalize_tokens,
    build_identity) into the serial channel; split corporate-suffix
    tokens out and strip them before vendor matching
    - Discover networked GRBL boards announcing only generic _http._tcp:
    grbl-owned HTTP fingerprint probe (driver/grbl/grbl_fingerprint.py)
    wired via MdnsRecognizer.fingerprint; candidates deduped against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
    [discover_page.py, driver.py, grbl_fingerprint.py, grbl_network.py, grbl_serial.py, manager.py, marlin_serial.py]
2026-08-26 feat(discovery): confidence-based profile matching with USB id evidence
    Replace the single-winner profile matcher with ranked candidates:
    every known profile gets a confidence score (0.0 no match to 1.0
    certain), and the wizard only auto-adopts a result when exactly one
    candidate is certain. Stock USB-serial bridge pairs (CH340, CP210x,
    ...) are denylisted and can never produce certainty; declared
    usb_ids act as positive evidence only.
    - new machine/device/matching.py: ProfileMatch, confidence tiers,
    generic-chip denylist, pure scoring helpers
    - profiles declare device.usb_ids as hex "vid:pid" strings
    - machines remember the discovered device's vid/pid (hex in yaml)
    - exporting a machine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
    [machine.py, manager.py, profile_page.py]
2026-08-26 feat(smoothie): telnet spec probing + package layout
    SmoothieDriver now supports probing over its existing telnet
    transport.
    - smoothie/ package directory: smoothie_driver.py (was smoothie.py)
    + smoothie_util.py (pure parsing: build_smoothie_profile from
    version + config-get replies)
    - supports_probing = True; probe() does the orchestration inline
    (temp machine + driver, connect, query, disconnect)
    - execute_interactive_command collects framed reply lines until ok,
    suppressing ? status polling while a command is in flight
    - win_setup.sh: install zeroconf (was missing from the Windows pip
    list, breaking import on MSYS2 CI)
2026-08-26 feat(octoprint): spec probe via /api/version + /api/printer
    OctoPrintDriver now supports probing: queries the server for its
    version and printer state over HTTP, returning an auto-populated
    DeviceProfile. Works without an API key when the server has access
    control disabled (the common case for discovered devices).
    - supports_probing = True; probe() sets up the driver manually
    (bypassing the api_key requirement) and issues GET /api/version
    and GET /api/printer
    - octoprint_util.py: pure build_octoprint_profile from API
    responses (printer name → meta.name, server version →
    driver_config.server_version); all failures become warnings
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2026-08-26 feat(discovery): mark already-configured devices as read-only
    Discovered devices whose connection key matches a machine already
    configured in the app are now shown as insensitive rows with a
    Configured badge and no Select button, instead of being selectable.
    The row title shows the configured machine's real name and the
    subtitle shows its configured work area, rather than the generic
    discovery label. Placeholder machines are ignored. Configured devices
    are also skipped during auto-probing.
    [discover_page.py]
2026-08-26 fix(sketcher): fold font changes during text edit into session command
    Changing the font via the properties panel while a text edit session
    was active pushed a standalone ModifyTextPropertyCommand that snapshotted
    the live-resized geometry as its pre-state (issue 5). Route the change
    through TextBoxTool.apply_font_change, which stages it on the session's
    finalize command whose pre-edit state was captured at session start.
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2026-08-26 feat: early script flag, template function registry, safe_evaluate, and CLI docs
    - Add --script CLI flag that runs Python scripts synchronously during
    startup, before addons are loaded and before the main window is
    created. This allows scripts to register plugins, configure the
    context, or register template functions.
    - Create sketcher/core/template_functions.py: a public registry for
    text-box template functions. Built-in functions: today, date, now,
    time, timestamp, uuid, uuid8, uuid4. Scripts can extend via
    register_template_function().
    - Fix ParameterContext.evaluate to use shared safe_evaluate instead of
    raw eval with __builtins__ sandbox. evaluate() now raises ValueError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
    [script.py]
2026-08-26 fix: cache snap index and invalidate on registry mutation
    SnapEngine now tracks EntityRegistry._entity_version and DragContext
    to skip index rebuilds when nothing has changed. Producers no longer
    filter snap lines by proximity at build time -- all snap lines are
    yielded unconditionally and filtered at query time by the existing
    _find_best_lines_for_both_axes method.
2026-08-26 perf(sketcher): optimize hot paths in coincident-point lookup, ellipse tessellation, and arc polygonization
    - get_coincident_points: build adjacency map once (O(C)) instead of
    scanning all constraints per point (O(P*C))
    - Ellipse.to_geometry: cap eccentricity-driven segment count at 256
    - Arc.to_polygon_vertices: scale sample count by swept angle instead
    of fixed 16, with min 2 and max 64 segments
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2026-08-26 Gracefully skip values in VarSet.set_values that cannot be coerced to the expected type
    Previously, set_values would crash if a value in the dict could not be
    coerced to the Var's expected type (e.g. a serial device path for an
    int-typed PortVar). This happened when driver_args from one driver type
    were loaded into the VarSet of a different driver type, causing the
    machine settings dialog to fail to open.
2026-08-26 fix(discovery): probe serial ports concurrently and keep partial results on scan timeout
2026-08-26 fix(discovery): clear stale discovered USB identity on non-USB pick
    _discovered_usb was only ever written when the picked device carried a
    vid, never cleared. Picking a GRBL serial board and then an OctoPrint
    server stamped the board's vid/pid onto the network machine, corrupting
    its export/matching evidence. Assign unconditionally so devices without
    a USB identity clear it, and pin the flow with a regression test.
    [unified_wizard.py]
2026-08-27 fix(device): harden profile matching, discovery session, and OctoPrint probing
    Matching: a declared model missing from the identity no longer zeros
    out a valid vendor match - score_tokens falls back to
    CONFIDENCE_VENDOR_TOKENS instead, so machines whose USB description
    carries only their brand name still surface their correct profile in
    the picker. An "any product id" usb_ids entry is no longer shadowed
    by sibling specific pids (score_usb_ids), and the dead
    CONFIDENCE_USB_ID tier was removed.
    Discovery session: serial vs network devices are now distinguished by
    the host parameter instead of the port's type, so a string-typed
    network port can never make a device held or immediately pruned.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
2026-08-27 fix(device): journal flag, align_cameras, and probe result dataclass
    Journal: the discovery journal is a bounded, fully rewritten journal,
    not an append-only log - the module docstring now says so.
    match_device gained a journal flag so display-only pre-filtering
    (ProfilePage suggestions) scores without recording, keeping one
    selection journaled once.
    Panel orientation: set_panel_orientation gained align_cameras so
    profiles can adopt their stored orientation without re-projecting
    calibrated cameras - profile camera alignments are stored in the
    profile's orientation. Callers no longer poke _orientation directly.
    Smoothie: the six parallel lists threading through probe() and
    build_smoothie_pr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
    [discover_page.py, grbl_util.py, machine.py, machine_panel.py, manager.py, probe_page.py]
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2026-08-29 fix(sketcher): stabilize snap index, solve loop, and drag magnetism
    - Rebuild the snap line index from a quantized position fingerprint:
    the solver and array sync move points in place without bumping the
    registry version, so the cached index served snap lines from stale
    geometry (lines crossing no visible geometry).
    - Suppress sketch.updated while a solve is running: sync_arrays'
    re-apply re-triggered solves and pipeline rebuilds in a feedback
    loop.
    - Skip snap attraction for points coincident with dragged points and
    for derived array member points: the template center sits on the
    guide start and static copies are re-distributed under the drag,
    making the drag point hunt betw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
2026-08-29 perf(sketcher): solve only the dragged component during drags
    Dragging geometry re-solved the entire sketch on every mouse move,
    so drag cost scaled with the whole sketch even when the dragged
    element was constraint-independent of the rest.
    Partition the constraint graph into connected components (union-find
    over the points each constraint couples, including the points of
    referenced entities so entity-level constraints merge correctly).
    Since parameters are constant during a solve, the system decouples
    exactly along these components. Drags now compute the scope once at
    drag start - the dragged group plus its components - and restrict
    the solve to it via Sketch.solve(point_scope=...) and a S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
2026-08-29 perf(sketcher): stop rebuilding the snap index on every drag move
    Each mouse move ran two full snap queries, and both were
    prohibitively expensive on large sketches:
    - produce_points() recomputed all O(n^2) entity-pair intersections
    on every query, even when nothing but the cursor had moved.
    The intersection list is now computed once and cached, keyed by
    the positions of non-dragged entity points plus the dragged
    sets that define the exclusion, and shared by produce() and
    produce_points().
    - The index fingerprint included dragged points, whose positions
    change on every drag solve, so the index was rebuilt on every
    move even though every producer excludes dragged geometry from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
2026-08-29 fix(machine): make travel speed support a driver capability
    supports_travel_speed() previously gated purely on the dialect's
    can_g0_with_speed flag, which wrongly hid travel speed settings from
    non-G-code machines like Ruida even though their binary protocol
    carries the speed. The check now delegates to the driver class:
    non-G-code drivers always support travel speed, G-code drivers
    depend on the dialect.
    Also fix a persistence race in DeviceProfile.create_machine: the
    dialect_uid was assigned after add_dialect() fired dialects_changed,
    so the machine could be saved with the default grbl dialect instead
    of the profile's dialect.
    [driver.py, machine.py]
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2026-08-30 test: run UI tests in virtual display with software renderer
    pixi run uitest now wraps pytest in xvfb-run so GTK windows no longer
    open on the developer's screen, and forces GSK_RENDERER=cairo because
    the GTK GL renderer can hang in the proprietary NVIDIA GLX driver when
    rendering to Xvfb. The CI workflow no longer adds its own xvfb-run
    wrapper since the task handles it.
2026-08-30 fix(ui): stop startup dialogs from stacking into an invisible modal
    The profile-review check was scheduled unconditionally at startup, so
    on first launch the profile-review dialog could present while the
    usage-consent dialog was still up. Both are modal for the main window,
    and on some window managers (e.g. MATE) one ends up hidden behind the
    other while keeping the input grab, leaving the visible dialog's
    buttons unresponsive.
    The consent dialog, setup wizard, and profile/schema reviews now run
    strictly in sequence: profile reviews are deferred until after the
    consent dialog is answered and the setup wizard (if any) is closed.
2026-08-30 Capture docs screenshots on an invisible GNOME session
    Run the screenshot harness inside Xvfb with gnome-shell as the
    window manager on a private D-Bus session, so captures are
    deterministic and never appear on the developer's desktop. The
    session shell serves gnome-screenshot with real shadows and
    alpha; without a WM the helpers fall back to root capture,
    content cropping and synthetic framing.
    - Start/track the session (Xvfb, private bus, WM) in cli.py,
    with --no-xvfb to keep the previous desktop behavior
    - Publish the desktop font via Gtk.Settings: the private session
    has no XSettings provider, so GTK would fall back to Sans 10
    - uiscript: quit the app when a script fails instead of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
2026-08-30 feat(sketcher): add contour offset tool
    Offset replaces the selected contours with their offset: lone circles,
    arcs and ellipses are updated in place and keep their entity type;
    chains of connected segments are replaced by a new atomic polygon
    entity (center + handle frame for move/rotate/uniform-scale). Open
    paths become closed slots with round end caps; closed contours grow or
    shrink via raygeo's Clipper2 offsetting, with live preview in the
    offset dialog. Selections are partitioned into connected components
    and offset per contour; the whole operation is one undoable command.
    Includes the polygon entity (rendering, serialization, mirror, drag
    anchors), polymorphic offset protocol on entit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
2026-08-30 feat(sketcher): add pie menu submenus as partial outer ring
    Grouped tools (arrays, constraints, waypoints, rectangles) collapse
    into a single parent entry when the inner ring runs out of space;
    their children appear in a partial outer ring around the hovered
    parent. Radial corridors prevent accidentally switching submenus,
    and groups with fewer than two visible children stay flattened
    into the inner ring.
2026-09-01 sketcher: perf and array-template fixes
    - Add point-usage reference counting to EntityRegistry for O(1)
    is_point_used lookups.
    - Cache coincident-point connected-component groups in Sketch so
    get_coincident_points is O(1) after the first call.
    - Add Constraint.is_world_anchored() so horizontal/vertical
    constraints are stripped from array templates.
    - Filter origin-pinned constraints from array templates.
    - Cap solver iterations at 5000 to guard against stalls.
2026-09-01 sketcher: fix array undo rotation bug, add standalone point tracking
    Fixes a bug where undoing a guide drag spurious-rotates every array
    member by the tangent change between the dragged and original guide
    positions. The array's template_anchor is mutated by sync-time
    re-applies during the drag, but the drag command's undo only
    restored points — leaving a stale anchor. The post-undo reanchor
    computed delta = current_tangent − stale_anchor_angle and rotated
    all members, causing near-touching rectangles to overlap and the
    multi-face part builder to merge intersecting loops → missing
    contours in ops.
    Fix: Sketch.capture_undo_state / apply_undo_state atomically
    captures and restores points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
2026-09-01 sketcher: add Constraint.get_edit_subtitle() polymorphic method
    Replace 4-way isinstance chain in sketchcanvas.py's
    _on_constraint_edit_requested with a polymorphic get_edit_subtitle()
    method on the Constraint base class. Override in RadiusConstraint,
    DiameterConstraint, AngleConstraint, DistanceConstraint,
    HorizontalConstraint, and VerticalConstraint.
    261 tests pass, lint clean.
2026-09-01 refactor: replace isinstance endpoint dispatch with get_endpoint_ids() on Entity
    In sketch.py _to_geometry(), replace the three isinstance cascades that
    extract endpoint pairs by entity type with calls to the existing
    get_endpoint_ids() method. This covers:
    - The adjacency list builder (u, v = ...)
    - The get_endpoints() closure used in chain traversal
    - The start point selection for move_to on the first chain segment
2026-09-03 fix: stop sketcher status bar from resizing the window (#385)
    The sketcher status bar rebuilds its shortcut entries whenever tool
    state changes, which happens continuously while dragging elements.
    Because the entries differ in width between states, the bar's minimum
    width - and with it the main window's minimum size - changed during
    drags. GTK enforces the minimum window size, so on macOS the window
    visibly resized, and the sketcher side panel followed because the
    Paned divider gets clamped on every window resize.
    Host the shortcut row in a scrolled window with an EXTERNAL horizontal
    policy. The bar no longer propagates the content width into the
    window's size request; if it is too narrow,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
2026-09-06 feat: make mouse gestures configurable via new settings page
    Navigation and menu gestures on the 2D canvas, 3D canvas, and in the
    sketch editor can now be rebound in a dedicated Mouse Gestures page in
    the settings dialog.
    The new rayforge.ui_gtk.gestures package provides:
    - GestureSpec/GestureSlot/GestureContext: a declarative model of
    rebindable gestures (button + modifier combinations for click, drag,
    and scroll input).
    - gesture_registry: an addon-capable registry (wired into
    REGISTRY_TABLE for automatic cleanup) that resolves the effective
    binding per slot from config with default fallback.
    - GestureRouter: attaches generic any-button drag/click and scroll
    controllers to a wi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
    [settings_dialog.py]
2026-09-06 fix: resolve ruff 0.16 lint errors in gesture code
    - Use a module-level singleton instead of a function call in the
    GestureSpec dataclass default (RUF009).
    - Import Callable from collections.abc (UP035).
    - Replace function-call argument defaults in test fakes with a
    module-level constant (B008) and reuse the existing fake config
    instead of a mutable class attribute (RUF012).
    - Assert button presence before use in the preferences page test.
2026-09-06 fix: resolve pyright findings in gesture code
    - Narrow the button type in GestureSpec.display_label before dict
    lookup.
    - Drop the gesture/controller parameter annotations on the router's
    private GTK signal handlers, matching the untyped pattern already
    used by CameraController's handlers and keeping the test fakes
    assignable.
    - Handle the Optional str returned by get_label() in the preferences
    page tests.
2026-09-07 fix(sim3d): re-derive slider position when the playback range shrinks
    The playback slider could stay pinned at 100% while the 3D view
    showed a fresh, barely-started playhead (issue #370 follow-up).
    Gtk.Range.set_range() clamps the stored value into the new range,
    so whenever a regenerated job produced a smaller G-code extent, the
    slider from the previous (larger or further-advanced) job was
    clamped to the new upper bound: 100%. The re-sync in
    _refresh_slider_range() relied on _set_slider_for_op(), which
    silently no-ops exactly in the cases where it was needed: a fresh
    player sits on the first LAYER_START (a command with no G-code
    output, span count 0), and a playhead from the old job can be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
2026-09-07 fix(sim3d): add bounded diagnostics for playback slider sync
    In case the slider fix does not resolve the reported issue, add
    debug-level diagnostics that make a failing session visible in the
    log without flooding it:
    - player and op map swaps (set/cleared, with command and line
    counts) - a mismatched pair is the prime suspect for desync;
    - the range-shrink correction itself, logging the clamped value,
    the new extent, and the re-derived position;
    - playback start (sim time, total, extent, speed) and every stop
    with an explicit reason (finished, user pause, canvas unrealized,
    player lost, destroy) plus wall-clock duration;
    - a one-shot warning when the playhead target regresses during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
2026-09-10 fix(machine): warn when gcode field contains only a number
    A bare number like '6000' in a macro, hook, or dialect command
    field is not a valid G-code command and gets sent to the machine
    as-is, producing errors like in #393.
    Show a non-blocking warning (banner and row icon) in the macro
    editor and dialect editor dialogs when a field contains only a
    numeric literal, suggesting a prefixed command instead.
    Fixes #393
    [dialect_editor.py, gcode_editor.py, validation.py]
2026-09-10 fix(tests): satisfy pyright in number-only warning tests
    Pass a real parent window to the dialogs and avoid direct attribute
    access on PreferencesRow for dynamically attached attributes.
2026-09-10 feat: add drag knife and tangential knife cutting support
    Implements barebaric/rayforge#359 as a new builtin addon plus the
    core head/capability groundwork it needs.
    Core:
    - MachineCapability: new DRAG_KNIFE and TANGENTIAL_KNIFE values with
    labels and descriptions.
    - machine/models/knife.py: DragKnifeHead (blade offset setting) and
    TangentialKnifeHead; both dispatch correctly in head_from_dict and
    are editable in the machine settings heads page.
    - The encoder heads table now includes non-laser heads so knife head
    UIDs resolve for tool changes.
    Addon (rayforge-addon-dragknife):
    - DragKnifeCutStep: cuts contours with a trailing-blade drag knife.
    Internally attaches a DragKnifeTrans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
    [head.py, head_preferences_page.py]
2026-09-10 fix: degrade gracefully when raygeo lacks the knife transforms
    CI installs the raygeo pin from PyPI, which predates the knife
    transform specs (barebaric/raygeo#28). The addon now gates its
    registration on a raygeo availability check: without the specs it
    logs a warning and registers nothing instead of failing to import,
    the transformers import their specs lazily, and the addon test
    suite is ignored via collect_ignore_glob so test collection no
    longer errors. Once the raygeo pin includes the knife transforms,
    everything activates automatically.
2026-09-10 feat: add boolean operations to the sketcher
    Add Union, Difference, Intersection and Exclude operations over
    sketch selections, backed by raygeo's Clipper2 boolean functions.
    Boolean results are baked destructively into multi-ring
    PolygonEntity outlines where winding is the semantic: outer
    contours are CCW, hole contours CW. Downstream, the existing
    raygeo face classification treats CW rings as holes, so a
    difference result cuts correctly without any schema change.
    - PolygonEntity: optional ring list (backward compatible), winding
    invariant after build/mirror/placement, hole-aware contains_point,
    enclosed area, hit-testing, geometry, fills, serialization and
    multi-ring offsetting
    - c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
2026-09-11 refactor: use raygeo topology, drop private imports
    Address review feedback:
    - Rename the contour preprocessing helpers to public API
    (partition_components, walk_component, chain_vertices) instead of
    importing them privately, and expose outline_item,
    group_rings_into_solids and rings_to_geometry through the
    entities package.
    - Replace the hand-rolled winding normalization with raygeo's
    Geometry.normalize_winding_orders, and the winding/containment
    classification in group_rings_into_solids with
    Geometry.split_inner_and_outer_polygons. Only the hole-to-solid
    assignment (smallest containing outer) remains local.
2026-09-11 feat(sketcher): support text boxes in array tools
    Array templates can now be text boxes. Copies are baked without
    stale construction-line references (their fourth frame corner follows
    from the parallelogram identity), so they render and hit-test
    correctly and cannot be cascade-deleted with the template's helpers.
    The text box geometry signature now covers content and font, so
    editing the template's text or font re-derives every copy on the
    next solve; in-place copy updates re-derive content, font and fill
    from the template.
    Entity group previews sample multi-contour entities into one
    polyline per contour, so the array dialog preview shows the full
    glyph outlines instead of only the first c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
2026-09-11 build: require raygeo 1.52.0, drop FontConfig copy workaround
    raygeo 1.52.0 ships the FontConfig copy protocol (barebaric/raygeo#29,
    released as v1.52.0). Pin it in requirements.txt, pixi.toml, the
    debian bundle requirements and pixi.lock, and remove the
    _fontconfig_is_copyable skipif guard from the text array tests so
    they always run.
2026-09-11 fix(machine): warn when continuous laser mode lacks s_command
    Enabling 'Continuous laser mode' on a dialect whose movement
    templates have no {s_command} placeholder makes the exporter
    compute laser power for every segment and then silently drop
    it: continuous mode also suppresses the separate laser_on power
    updates, so the machine never sees any power at all (seen in
    #403: 'M4 S0' with no S value anywhere).
    Show a non-blocking warning in the dialect editor for that
    combination: the affected movement template rows and the toggle
    itself get a warning icon, and the banner names the first
    offending template. The warning updates live when templates are
    edited or the toggle flips, and never block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
    [dialect_editor.py, validation.py]
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2026-09-13 website: patch npm audit vulnerabilities in dependencies
    Bump transitive dependencies in the website lockfile to patched
    versions to resolve the open Dependabot alerts:
    - svgo 3.3.5: removeScripts namespace/control-character bypass and
    foreignObject HTML sanitization (GHSA-w27v-7q3p-w38r,
    GHSA-4vpr-x523-8j87)
    - nanoid 3.3.19: infinite loop in custom generators with zero size
    - js-yaml 4.3.2: maxTotalMergeKeys CPU bypass via empty merge sources
    - fast-uri 3.1.7: host confusion and SSRF fixes (IDN canonicalization,
    percent-encoded scheme, IPv6 normalization, repeated percent-decoding)
    - colord 2.10.0: slow rejection of oversized malformed color strings
    - joi 17.13.8: prototype pollution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
2026-09-14 fix: Machine Settings dialog is now a single instance per main window, preventing duplicate windows fix: the machine counters action now opens the maintenance page instead of a nonexistent page
    [settings_dialog.py]
2026-09-14 fix GTK crash when switching to a driver that requires configuration
    Selecting a driver such as RuidaRPAAdapter without connection details
    crashed the app with a GTK assertion (priv->object == object in
    gtk_list_factory_widget_setup_factory) and left users in a crash loop
    at startup, because the driver choice is persisted immediately.
    Fixes:
    - bottom_panel: stop re-emitting items_changed on the unchanged WCS
    list model. Faking item replacements violates the list model
    contract and crashes GTK while it is setting up factory widgets.
    The model is now spliced only when the displayed content (WCS set,
    labels, offsets) actually changed.
    - laser_control_widget: only swap the laser head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
    [controller.py, general_preferences_page.py, laser_control_widget.py, machine.py]
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2026-09-14 keep connected driver alive when setup arguments are edited
    Editing driver setup arguments (e.g. numeric fields) while the machine
    is connected tore the driver down and reconnected on every debounced
    change, and a fast editing burst could occasionally leave the driver
    disconnected. When the driver class is unchanged and the driver has a
    live connection, the running instance is now kept and the edited
    arguments are applied by the rebuild that runs once the connection is
    gone, e.g. after an explicit disconnect or a drop.
    Also reset the connection status directly in disconnect() instead of
    leaving it stale until the scheduled rebuild runs.
    [controller.py]
2026-09-14 Fix missing material textures in wheel-based installs
    Add *.webp to the builtin_addons recursive-include in MANIFEST.in.
    Without it, setuptools (with include-package-data = true) drops the 58
    git-tracked material texture files from the built wheel, since
    setuptools-git-versioning does not register a git file finder.
    This broke material thumbnails on flatpak and deb installs, where the
    package is installed via pip from a git checkout or sdist; the
    materials list still showed (yaml files are included) but every
    texture fell back to gray.
    Fixes #418
2026-09-15 Revert "keep connected driver alive when setup arguments are edited"
    This reverts commit f28ffc2415ffbf672dfb1a4d23995ea183aba2f6.
    [controller.py]
2026-09-15 add opt-in Driver.update_settings for live driver reconfiguration
    Testing feedback showed that keeping the connected driver untouched
    made edited settings appear to require a restart, since there was no
    clear event that applied them.
    Replace the keep-live behavior with an opt-in hook as suggested in the
    issue: when the driver class is unchanged, the controller asks the
    live driver via update_settings() to absorb the new arguments. Drivers
    that can do so without dropping the connection return True and keep
    running; the default returns False and requests a teardown/rebuild,
    which is the previous robust behavior for all drivers that did not opt
    in.
    The Ruida adapter opts in: timeout and magic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
    [controller.py, driver.py]
2026-09-15 fix CI lint and restore pipeline fail-fast contract
    - rpa_adapter: return the keep-alive condition directly (SIM103).
    - pipeline: keep raising for empty documents; the fail-fast contract
    is intentional and prevents the UI settle->refresh loop from
    forcing rebuilds forever.
    - mainwindow: log preview assembly failures at debug level instead,
    they are cosmetic and occur for everyday states like an empty
    document.
2026-09-15 route job encoding by driver capability, not leftover dialect
    When a machine is switched to a non-G-code driver such as the Ruida
    RPA adapter, its dialect_uid kept pointing at the Grbl dialect. Job
    encoding picked the native Grbl encoder based on that stale dialect
    and handed GRBL G-code to the Ruida driver, which failed to stage the
    job with 'Missing '(' in gluescript line: G21 ;Set units to mm'.
    - Machine.set_driver now syncs the dialect with the driver's G-code
    capability: non-G-code drivers clear the leftover dialect, and
    switching back to a G-code driver restores the framework default.
    - IntentBuilder._build_encoder now consults the driver's uses_gcode
    flag before routing to the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
    [machine.py]
2026-09-15 make encoder routing tests hermetic
    Setting driver_name on a machine backed by the real context lazily
    creates a MachineController, which schedules the debounced
    rebuild-driver-on-init coroutine on the task manager. Sync tests never
    pump the event loop, so the task can still be pending at teardown and
    the task_mgr fixture fails with 'Task manager still has tasks'.
    Build the routing tests on the isolated_machine fixture instead: its
    mocked context never constructs a real controller, so no background
    task is scheduled. This matches the other encoder-routing tests in
    the file.
2026-09-18 docs: add Debian apt install instructions to website
    Add a native Debian section to the Linux install methods on the website
    installation page. Rayforge is now in the official Debian archive, so
    users can install it with a plain 'apt install rayforge'. The section
    notes the current suite availability (unstable and testing, next stable
    release to follow), links the Debian package tracker, and includes the
    dialout group step needed for serial port access.
    English page first; translated pages follow.
    Closes #424
2026-09-18 fix: tolerate platform libm ULP noise in ruidarpa golden test
    The UCRT64 migration exposed that raygeo's arc linearization relies on
    the platform libm (f64::sin_cos/atan2): glibc and msvcrt agreed
    bit-for-bit, but Windows UCRT differs by 1 ULP, which repr() leaks into
    the byte-exact golden transcript. Quantize float tokens to 10 decimals
    in the fixture comparison so cross-platform libm noise cannot fail the
    test while still catching any real encoder drift. An upstream prompt
    for making raygeo's linearize path deterministic is added under
    docs/prompts.
2026-09-18 fix(grbl): hard-abort streaming sender on cancel (issue #428)
    Cancelling a job while the streaming sender was parked waiting for
    GRBL RX buffer space did not stop the sender: cancel() only set
    flags, sent Ctrl-X and reset flow-control state. The reset replaced
    the _space_available Event under the parked sender's feet, so the
    wake-up signal was lost deterministically, and the sender stayed
    stranded (holding _cmd_lock) until its stall timeout fired. Any
    interactive command issued in that window (e.g. $X from 'Clear
    Machine Alarm') cleared _is_cancelled in _execute_command, so the
    stall handler later saw 'not cancelled' and resumed streaming the
    cancelled job to the freshly reset controller (is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
    [grbl.py, grbl_serial.py]
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2026-09-20 feat(laser): per-step power mode (constant M3 / dynamic M4)
    Laser steps gain a Power Mode setting (Dynamic (M4) default /
    Constant (M3)), written to the op stream like the other process
    settings. The encoder renders the dialect's constant-power
    (focus_laser_on) template instead of the dynamic one when a step
    requests constant power, so vector cuts no longer suffer power
    sags at corners (issue #422) while raster engraving keeps dynamic
    power.
    Also passes focus_laser_on into the encoder dialect spec (it was
    previously driver-only) and switches framing to constant power:
    on stock Grbl with laser mode enabled a stationary M4 emits no
    beam at all.
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2026-09-20 fix(laser): show Power Mode row on the Laser settings page
    LaserSettingsPage filters the recipe varset with a hardcoded key
    list, so the new power_mode var never rendered on the Laser tab
    (spotted by AVRASM2 in #422).
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2026-09-20 Avoid duplicate HTTP snapshot frame processing
    Block snapshot reads until the next poll interval instead of returning the cached frame on every capture-loop tick. This keeps cached-frame reuse for offline cameras while avoiding repeated memcpy, undistort, and redraw work between polls.
2026-09-20 Reconnect network streams after read failures
    Track consecutive failed reads in OpenCvUrlSource so RTSP and HTTP streams raise OSError after repeated empty frames. This triggers the controller reconnect path instead of looping forever on None frames.
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2026-09-20 Dispose temporary camera settings controller
    Ensure the temporary CameraController used to adopt local camera settings is disposed after reading settings, including the failure path, so it releases resources and disconnects model signals.
    [settings_dialog.py]
2026-09-20 fix(laser): cap material test speed at the live machine limit
    The material test page derived its speed bounds from
    step.max_cut_speed, a snapshot taken once at step creation and
    persisted in project files. Raising the machine's max cut speed
    afterwards never lifted the UI cap, leaving the spin rows pinned
    at the old limit (e.g. 1000 mm/min).
    Resolve the ceiling from the active machine instead, mirroring the
    laser step settings page, and re-clamp presets against it. Also
    replace the TupleAdapter isinstance checks with base-class no-op
    methods on RowAdapter so the bounds application survives the
    dual-module (rayforge_addons.* vs short name) import identity of
    builtin addon code.
    Fixes #439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
2026-09-20 fix(laser): wire power mode into the assembler payload
    The Power Mode step setting only reached create_initial_ops, which
    the assembler-based job pipeline does not consume: jobs went through
    build_compute_payload/populate_payload, and the raygeo ComputePayload
    had no power_mode field, so jobs always emitted dynamic power
    regardless of the dropdown (spotted by AVRASM2 in #422).
    Requires raygeo 1.53.1, which carries power_mode on ComputePayload
    and injects it as a SetPowerMode op. Adds step -> payload ->
    executed-ops regression tests covering the real job path.
2026-09-20 docs(laser): frame power 0 traces with beam off
    Update the Frame Power row description: 0% no longer disables
    framing, it frames without firing the laser.
    [head_preferences_page.py]
2026-09-21 fix(laser): preserve power mode through the Optimize transformer
    The contour default transformer chain includes Optimize, which
    rebuilds the op stream from state snapshots and dropped the
    SetPowerMode command - so optimized jobs fell back to dynamic
    power even with the payload wired correctly (found via community
    testing in #422). Requires raygeo 1.53.2. Adds an end-to-end
    regression test running the step through assembler + Optimize.
2026-09-21 refactor(laser): store power mode as the raygeo PowerMode enum
    The step now holds the PowerMode member itself instead of a name
    string validated by hand: set_power_mode normalizes through the
    enum, serialization round-trips via .name, and create_initial_ops/
    populate_payload pass the member straight through. Requires the
    PowerMode __str__ fix from raygeo 1.53.3 so the stringified value
    resolves in choice widgets.
2026-09-21 fix(win): preinstall libgfortran to pin the fc-libs provider
    The current UCRT64 db offers gcc-libgfortran 16.2.0-3 as the default
    provider for fc-libs, which cannot be resolved because its exact
    gcc-libs=16.2.0-3 pin is no longer in the db. Under --noconfirm pacman
    then silently skips python-opencv and its dependency subtree, breaking
    the Windows test suite with a missing cv2 module.
    Explicitly installing libgfortran first resolves fc-libs with a working
    package. Temporary workaround until gcc-libgfortran is removed from the
    repositories (https://github.com/msys2/MINGW-packages/issues/31811).
2026-09-22 feat(laser): add round corners option to the Frame operation
    The Frame operation gains a Round Corners toggle and a Corner Radius
    setting. When enabled, the frame's four corners are rounded to the
    given radius instead of meeting at 90 degrees, which avoids sharp,
    fragile corners on some materials without hand-drawing a rounded
    outline.
    Requires the frame corner_radius support added in barebaric/raygeo#38.
    Implements barebaric/rayforge#447.
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2026-09-22 fix(ui): resolve GTK/libadwaita deprecation warnings
    Migrate Adw.MessageDialog to Adw.AlertDialog, replace
    Gdk.Texture.new_for_pixbuf with Gdk.MemoryTexture, use
    Gtk.Widget.add_css_class, and switch Gtk.ColorButton to
    Gtk.ColorDialogButton.
    [dialect_editor.py, head_preferences_page.py]
2026-09-22 fix(laser): use arc tolerance for rounded Frame corners
    raygeo 1.54.1 emits the Frame operation's rounded corners as true
    arcs and accepts arc_tolerance / allow_arcs on FrameSpec. Pass the
    machine's arc tolerance and arc support through so the corners are
    smooth instead of a fixed polyline and the tolerance setting takes
    effect.
    Also keep the Arc and Curve Tolerance row editable when arc support
    is disabled, since the tolerance is still used to linearise curves.
    Requires raygeo 1.54.1.
    Fixes the resolution issue reported in #447.
    [advanced_preferences_page.py]
2026-09-23 fix(ui): stop driver dropdown focus critical and tighten its rows
    Keep the driver combo's Adw.ActionRow non-focusable so gtk_list_box_row_grab_focus is not called on a list box row placed in a Gtk.ListItem; trim the dropdown row height via scoped CSS. Only close ExperimentalAddonDialog when still presented. Demote the per-retry RPA direct driver connect warning to debug.
    [general_preferences_page.py]
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2026-09-23 fix: persist config, machines and recipes atomically with backups
    Settings, machine profiles and recipes were saved with plain in-place
    writes: the destination file was truncated before serialization, so a
    crash or power loss mid-save could leave it empty or half-written, with
    no backup to fall back on. A config that failed to parse was then
    silently replaced with defaults on the next start, permanently losing
    the user's settings.
    All three managers now write through a shared helper that serializes
    in memory first, writes a temp file in the same directory, fsyncs it,
    and swaps it into place with os.replace(). The previous version is kept
    as a .bak sidecar, and loaders fall back to that back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
    [manager.py]
2026-09-23 Refactor camera sources and selection UI
    Combine the camera source modularization, typed configuration and
    forward-compatible serialization, translated documentation, lifecycle
    fixes, and camera selection UI improvements.
    [controller.py]
2026-09-23 fix(sketcher): carry helper geometry when arrays move members
    A text box exposes only its three defining frame points; its fourth
    corner is referenced solely by its construction lines (helper
    geometry). Every rigid motion of an array member built its group from
    the member entities alone, leaving the corner behind: during a guide
    drag the template's ParallelogramConstraint stayed violated (the
    corner lagged), and the drag-end global solve repaired it by dragging
    and rotating the whole box.
    Move helper geometry with the member in every array motion: template
    placement (create/redo), curve re-anchor, circular translate and
    radial re-projection, plus undo snapshots. Standalone-point discovery
    n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
2026-09-24 build: require raygeo 1.54.2
    raygeo 1.54.2 fixes the contour nesting classification, which previously
    relied on a single probe point per contour. When imported vector shapes
    overlap slightly - e.g. two figures in an imported SVG - the probe could
    land inside the neighbouring shape, misclassifying a solid as a hole and
    corrupting the generated Contour toolpath (barebaric/rayforge#456).
2026-09-24 feat: move the laser head to a clicked point or typed X/Y coordinates (#452)
    - Machine control: a "Move to Position" popover in the Current
    Position area offers direct X/Y (and Z, when available) coordinate
    entry and hosts the selection/workarea corner and WCS origin
    shortcuts
    - Canvas: new "Click Canvas to Move Head" mode (mirrors Click to
    Zero, mutually exclusive with it) and a "Move Head Here" background
    context-menu action
    - Drivers: move_to() accepts an optional absolute Z target; move_to
    dialect templates carry a removable Z word via {z_cmd}, and the
    per-device profiles only declare it for machines with a Z axis
    - MoveToPopover sensitivity follows the machine connection s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
    [driver.py, dummy.py, grbl.py]
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2026-09-24 fix(pipeline): flush pending debounced rebuilds when settling
    A model change during a job (e.g. machine hours update) arms a
    debounced rebuild whose timer lives on the task manager loop. The
    settle APIs returned as soon as processing flipped idle, so the
    rebuild could fire after the caller observed an idle pipeline -
    spawning a background task during test teardown and failing the
    strict no-lingering-tasks check in CI.
    Quiesce the pipeline in wait_until_settled instead: flush armed
    debounce timers, wait out one debounce period, and re-check, so a
    rebuild armed by a late main-thread callback cannot start after
    settling.
2026-09-24 fix(machine): use jog speed for move-to commands
    All "Move To" entry points (coordinate popover, canvas click-to-move,
    context menu) sent absolute moves at a hardcoded 1500 mm/min while the
    jog pad used the configurable Jog Speed field, so the head appeared
    mysteriously slow next to jogging.
    Driver.move_to() now accepts an optional speed in mm/min and falls
    back to the previous default when omitted; every driver passes it
    through (OctoPrint as a jog API field, Ruida RPA as an mm/s override
    for that move). The bottom panel shares the Jog Speed field value
    with the move-to popover and the canvas/context-menu handlers.
    Reported in #458.
    [driver.py, dummy.py, grbl_network.py, grbl_serial.py, grbl_serial_simple.py, marlin_serial.py]
2026-09-24 feat(ui): add Ctrl+M shortcut for click-canvas-to-move-head
    Adds a toggle-move-head window action bound to <Primary>m that arms
    the same click-canvas-to-move-head mode as the bottom panel button,
    so the mode can be invoked from the keyboard without reaching for
    the panel.
    Also fixes a crash in MoveToPopover: the connection status signal
    carries a message keyword the handler did not accept, which broke
    the idle callback on every status change that included one.
    Requested in #458.
    [move_to_popover.py]
2026-09-24 Update translation catalogs and translate new strings
    Regenerate .pot files for the main app, laser_essentials, and
    sketcher, merge them into all .po files, and fill the previously
    untranslated entries (56 main app, 8 laser_essentials) for de, es,
    fr, pt, uk, and zh_CN. Also fix the msginit default Last-Translator
    header in the uk and zh_CN catalogs.
2026-09-25 Add GrblSerialNextDriver with the GRBL protocol stack in Rust
    Integrate the newly released raydriver 0.1.0 (Rust/PyO3 GRBL driver)
    as GrblSerialNextDriver, a drop-in experimental alternative to the
    Python GRBL (Serial) driver:
    - The full protocol stack runs in Rust: character-counting flow
    control, job streaming with stall detection/deadlock recovery,
    handshake + status polling + reconnect, interactive command
    queueing, cancel/safety-shutdown semantics, settings, WCS offsets
    and probe cycles
    - The shell only translates between the Rayforge Driver interface
    (blinker signals, VarSets, dialect data) and the Rust session
    - Dialects remain Rayforge data: interactive command templates a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
2026-09-25 Fix GrblSerialNextDriver breaking silently after driver switch
    Switching drivers via the preferences dropdown reset driver_args to
    {}, so the Rust driver was set up without a port: setup failed
    silently, the session was never created, and the machine showed
    status "unknown" while every command died on a bare assert.
    - Carry over driver arguments the newly selected driver also
    understands (e.g. port and baudrate between serial drivers)
    - Only pass cached_rx_buffer_size to GrblSession when set; a None
    value crashed PyO3 integer extraction during setup
    - Assign new_driver.config before setup() in rebuild_driver, so the
    cached RX buffer size learned from the device reaches the session
    - R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
    [controller.py, driver.py, general_preferences_page.py]
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2026-09-25 fix(machine): keep parent_uid on migrated dialect copies
    A machine's dialect copy now stays linked to the built-in it came
    from, so on load GcodeDialect.from_dict inherits fields the stored
    copy does not explicitly override from the up-to-date built-in,
    while user edits remain preserved.
    [dialect_manager.py]
2026-09-25 fix(machine): respect Z axis extents in jog limits and move-to entry
    Z jogs were never clamped (soft-limit checks handled X/Y only), so a
    large jog distance was sent to the machine verbatim. Z is now checked
    against the configured axis extents, and the MoveTo popover's Z row
    accepts the full extent range instead of clamping negative coordinates
    to zero. Adds Z Min/Z Max rows to the hardware settings page.
    [hardware_page.py, machine.py, move_to_popover.py]
2026-09-25 feat(machine): allow binding serial ports by USB VID:PID
    Serial ports identified only by their device path break auto-reconnect
    whenever the OS re-enumerates USB devices: powering a machine off and
    back on can turn /dev/ttyUSB0 into /dev/ttyUSB1 (or COM1 into COM3),
    leaving the configured port pointing at nothing.
    SerialPortVar now also accepts a 'vid:pid' spec (e.g. 0403:6001):
    - SerialTransport.connect() resolves the spec against the currently
    enumerated ports on every attempt, so the reconnect loop follows the
    device to its new path. A missing match fails the attempt with a
    descriptive error, like an absent path does.
    - The Python serial drivers (GrblSerial, GrblSerialSimple, Marl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
    [grbl_serial.py, grbl_serial_simple.py, marlin_serial.py, serial.py]
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2026-09-26 fix(grbl): heal flow-control state jammed by lost acks (issue #428)
    After a soft reset, some firmwares (the Sculpfun iCube over Bluetooth
    in issue #428) acknowledge the post-cancel safety shutdown commands
    with silence; acks can also vanish on a flaky link. Their pending
    entries then jam the driver forever: every later 'ok' is
    mis-attributed to a stale FIFO entry, and
    execute_interactive_command() blocks on an unbounded
    pending_queue.join() — 'Read from Device' hangs and the machine
    controls appear dead while status polls keep working.
    - GrblSerialTransport now timestamps the oldest un-acked command
    (oldest_pending_age()).
    - execute_interactive_command() waits via _await_pending_drained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
    [grbl.py, grbl_serial.py]
2026-09-26 fix(grbl): derive ack deadlines from per-command duration estimates
    A fixed staleness threshold is unsafe: commands like slow moves or
    homing legitimately hold their ack far longer than any constant. The
    heal now uses the same estimate-derived timeouts that drive the
    per-line stall timeouts:
    - PendingCommand carries its own ack deadline. send_gcode() passes
    the dynamic per-line timeout (estimate * safety factor, 5..120 s)
    it already receives; interactive commands keep a short default.
    - The transport reports pending_ack_overdue() only once the oldest
    entry outlives its own deadline, and re-stamps conservatively when
    the queue head changes (healing can only happen later, never
    earl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
    [grbl.py, grbl_serial.py]
2026-09-26 fix(grbl): recycle the connection when the device stops responding
    [grbl_serial.py]
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2026-09-26 add pointer laser offset with runtime alignment
    Machines with a pointer laser mounted at a fixed distance from the
    cutting beam previously required manual XY-offset arithmetic when
    aligning stock by the pointer dot. Add a per-head pointer offset
    (disabled by default) plus a session-only "pointer alignment" toggle
    that together make the pointer dot a first-class aiming reference:
    - LaserHead gains pointer_offset_enabled/x/y settings, serialized
    into the machine profile with backward-compatible defaults, with
    a "Pointer Offset" group in Machine Setup -> Heads
    - Set Work Zero at Current Position (and Zero X/Y) adds the offset,
    so the work origin lands where the pointer dot marks the stoc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
    [controller.py, head_preferences_page.py, laser.py, machine.py, move_to_popover.py]
2026-09-26 Address pointer-alignment feedback: dry-run, dot states, jog-pad send
    Replaces "Burn Anyway" with "Dry-Run with Pointer": the send
    confirmation dialog can now generate the job once with the pointer
    offset folded into the WCS offsets, so the pointer dot traces the
    toolpath while the beam runs displaced by the offset. A transient
    Machine flag (pointer_job_shift_enabled) routes all job WCS offsets
    and template variables through get_job_wcs_offset() for that one
    generation, is folded into the pipeline cache tokens, and the shifted
    artifact is discarded afterwards so regular sends stay unshifted.
    The beam dot is now drawn hollow while the pointer dot is filled
    (alignment on) and filled again whi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
    [jog_widget.py, machine.py]
2026-09-26 Cap pointer dry-run power at framing power; freeze Move-To DRO
    Dry-Run with Pointer traced the toolpath at full job power (e.g.
    S800), firing into the stock. The send action now caps all laser
    power at the head's framing power via the new raygeo 1.55.0
    Ops.cap_power, covering both SetPower commands and per-dot scanline
    power bytes, and re-encodes for that run; regular sends are
    bit-identical. The confirmation dialog text no longer claims the
    beam fires at job power. Framing-power 0 (IR-only machines) emits a
    beam-off trace.
    The dry-run flag is bound at the send_job call site via partial, so
    _start_job stays a generic executor and _run_frame_action keeps its
    signature.
    Toggling Pointer Alig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
    [move_to_popover.py]
2026-09-26 Fix pointer dry-run: encode power cap in the pipeline
    The dry-run capped power by re-encoding the artifact's ops, but those
    ops are the job aggregate's world-space output: re-encoding them
    dropped the entire world-to-machine/WCS transform, so the controller
    added its WCS offset back and the head moved exactly where a regular
    burn would - the pointer dot did not trace the toolpath (regression
    reported by AVRASM2).
    Instead, the cap now flows through the encode context: raygeo 1.56.0
    clamps all emitted power (SetPower and scanline dots) at
    EncodeContext.power_cap. Machine.get_job_power_cap() reports the
    default head's framing power while pointer_job_shift_enabled is set;
    build_encode_context c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
    [machine.py]
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2026-09-26 Refresh device WCO from the WCS read-back
    GRBL includes WCO in status reports only when it changes, so right
    after a WCS write the cached WCO in DeviceState can be stale and a
    derived machine position (WPos + WCO on controllers reporting WPos)
    is wrong until the next report carries the new WCO. Zeroing again
    in that window read the wrong machine position and wrote the old
    offset back, making the zero buttons appear to jump around when
    pressed repeatedly.
    The $# read-back reports every slot authoritatively; the GRBL
    drivers now refresh the state's WCO and derived positions from the
    active slot's offset before announcing the new offsets.
    [grbl_network.py, grbl_serial.py, grbl_serial_simple.py, grbl_util.py]
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2026-09-27 fix(machine): restore counting down time estimate in machine dropdown
    The dropdown received its ETA only through driver progress callbacks.
    GRBL-style drivers acknowledge commands when the firmware buffers
    them, so for short jobs every callback fired within the first
    milliseconds and eta_seconds never became a value at all; for longer
    jobs nothing refreshed the label after the initial ack burst.
    The JobMonitor now receives the job's estimated duration (already
    computed for machine hours) and uses it as the ETA until measured
    speed samples span a one-second window, which also keeps burst
    samples from producing absurd speeds. While a job runs, the main
    window refreshes the dropdown once per s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
    [machine_dropdown.py]
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2026-09-27 feat: Add machine notes - fix machien diff display
    [manager.py, profile_review_dialog.py]
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2026-09-29 fix: Address code review feedback
    Markdown parser:
    - Nest mixed emphasis markers (*foo **bar** baz*) instead of
    flattening them into sibling runs.
    - Only close fenced code blocks with a bare fence; an info string on
    the closing line stays inside the block.
    - Skip :::enddetails markers inside fenced blocks when searching for
    the end of a details section.
    Markdown renderer:
    - Re-render when the Adwaita dark/high-contrast setting changes, so
    inline code backgrounds follow the theme.
    - Cancel the debounced preview refresh when the editor is destroyed.
    - Remove an unused CSS rule for inline code.
    UI:
    - Keep a 6px gutter between the editor/preview panes and the split
    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
    [notes_page.py, review_page.py]
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2026-09-29 refactor: rework markdown editor widgets
    - split the markdown widget module into a package, one file per class
    - render every toolbar action with a bundled get_icon() icon and add
    the missing formatting SVGs
    - keep the text selected after applying bold, italic, and friends
    - use blinker signals instead of dedicated Gtk signals
    - open the notes editor non-modal, surviving the settings dialog
    [notes_page.py]
2026-09-30 fix(frame): make framing a driver capability so Ruida can frame
    Framing a job on Ruida was broken: the frame action emitted a bare
    MOVE_TO/LINE_TO/DWELL pseudo job, and the ruidarpa encoder fails fast
    on exactly that shape. Per review feedback, framing is now a driver
    capability instead of a synthetic opstream forced through every
    encoder:
    - Driver.frame() is the new framing API. The default implementation
    preserves the G-code behavior: a well-formed job opstream (job →
    layer → workpiece markers, M3 constant power at frame power, frame
    speed) built by the moved build_frame_ops() helper. The line_to
    trace stays for G-code: feed moves are what makes the frame visible
    at frame po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
    [driver.py]
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2026-09-30 fix: round clicked selection to machine precision and use other font for ruler rendering
    [axis.py]
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2026-10-01 Report host OS in usage tracking, reword consent prompt
    The usage tracker sent a hardcoded Linux/Chrome User-Agent, so every
    event was counted as Linux in the analytics OS dimension. The UA now
    reflects the actual host OS.
    The consent dialog and privacy settings wording is replaced with a
    plain, shorter description of what the data is used for; the opt-in
    flow itself is unchanged. New strings are translated in all shipped
    Tests get a RAYFORGE_NO_USAGE_TRACKING guard so they never send real
    events, plus coverage for the UA and the consent semantics.
    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
    [general_preferences_page.py]
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2026-10-01 feat(automation): shared CodeEditor widget and editor polish
    - Refactor the machine-code editor into a shared CodeEditor widget
    (Adw.ToolbarView composition, .view text surface, flat toolbar
    buttons) used by both the macro editor dialog and CodeVar rows.
    The dialog drops its header buttons; the popovers (template
    placeholders, macro includes) now live in the editor toolbar, with
    a 420px minimum width and no title row.
    - Macro editor dialog: wrap the editor in a card, put the name row
    into a GtkListBox (fixes the AdwEntryRow-in-GtkBox warning), and
    fix the editor expansion.
    - CodeVar: typed variable_context_level / macros_provider fields;
    the Command step provides machine macr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
    [gcode_editor.py]
2026-10-01 fix(machine): don't reverse jogs outside limits
    _adjust_jog_distance_for_limits clamped the jog target to the nearest
    limit even when the current position was already beyond it. A reported
    position outside the travel range then turned any jog, in either
    direction, into a long move back to that limit. On a Ruida RDC8445S,
    whose controller reports Z around 3176 mm, a single Z jog drove the bed
    into its end stop.
    Clamp through a shared helper that only ever shortens a jog: jogs
    further out of range become zero and jogs back towards the range are
    allowed, stopping at the far limit. would_jog_exceed_limits now flags
    exactly the jogs the clamp shortens or blocks, so a working jog back
    into range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
    [machine.py]
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2026-10-02 fix: add FluidNC protocol variant to GRBL network driver
    FluidNC serves its WebSocket on the same port as its HTTP web
    interface and uses different command/status endpoints than the
    ESP3D-style layout the driver was built around. Users had to guess
    ports and got confusing 'did not receive a valid HTTP response'
    errors when the WebSocket handshake hit the raw Telnet port.
    Add a FluidNC protocol variant that uses FluidNC's native
    /?commandText= command endpoint, tolerates FluidNC's response
    shapes, and documents that the WebSocket port should match the
    HTTP port.
    Closes #490
    [grbl_network.py, grbl_util.py]
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2026-10-04 fix: normalize timestamps when zipping device exports
    The zip format cannot store timestamps before 1980. Machine exports
    copy 3D model files that may carry such timestamps (e.g. when
    extracted by tools that do not set a proper date), causing the export
    to fail with 'ZIP does not support timestamps before 1980'. Write
    entries explicitly and clamp invalid dates to the zip epoch.
    Closes #500
    [manager.py]
2026-10-04 refactor(machine): consume GRBL parsing from the raydriver parser
    The pure GRBL response parsing now lives in the raydriver library;
    this switches every consumer outside the old Grbl drivers over to it
    and drops the duplicated code:
    - Smoothie parses status reports via raydriver.grbl.parser, with
    explicit session<->driver state conversions in the new
    machine/driver/session_state.py.
    - Device probing and dialect detection use the raydriver parsers,
    including the new parse_opt_flags (raydriver 0.3.0), so the local
    OPT regex is gone.
    - The Rust shell driver uses the raydriver discovery matchers and
    error tables.
    Bumps the raydriver pin to 0.3.0 (pixi.toml, requirements.txt,
    debian b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
    [grbl_dialect_detect.py, grbl_probe.py, session_state.py]
2026-10-04 feat(machine): replace the Python GRBL serial and telnet drivers with the Rust driver
    The Rust-backed driver takes over the canonical GrblSerialDriver
    name: serial_next.py becomes grbl_serial.py, the "GRBL (Rust)"
    experimental label graduates to "GRBL (Serial)" with stable
    maturity, and the old 2100-line Python protocol implementation is
    deleted along with its tests.
    GrblTelnetDriver is rewritten as a thin shell over the same Rust
    session (raydriver has shipped a telnet transport since 0.2.0);
    its setup vars and resource URI format are unchanged.
    Machine configs saved under either the classic or the experimental
    driver name keep resolving: the new class carries the classic name,
    and a tran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
    [grbl_serial.py, grbl_telnet.py]
2026-10-04 fix: stop Ruida setup wizard from requiring optional connection fields
    The setup wizard treated every connection var without a default as
    mandatory. For the Ruida driver the optional USB device and Magic
    fields are registered without defaults, so the Next button stayed
    disabled even with a valid hostname entered.
    Vars can now be marked optional. The Ruida USB device var uses this
    since a network-only connection is valid. The Magic field is instead
    prefilled with the standard 0x88 because the protocol always needs a
    magic number; leaving it empty already fell back to 0x88 in the
    backend.
    Fixes #501
    [connection_page.py, unified_wizard.py]
2026-10-04 feat: add Ruida connection mode selector to the setup wizard
    The Ruida connection form showed the hostname and USB fields
    unconditionally, with no way to express which transport applies. A
    new 'connection' choice var (Auto/Network/USB) now drives field
    visibility: network mode shows only the hostname, USB mode only the
    device selector, and auto keeps both (the backend opens USB when
    available and falls back to UDP).
    Var gains a required_when hook and is_required()/is_visible()
    helpers so requiredness can depend on other values; the wizard
    connection page and _connection_args_complete evaluate required
    vars per refresh. VarSet.validate() skips hidden vars, which also
    fixes validation of USB-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
    [connection_page.py, unified_wizard.py]
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2026-10-06 fix: use pangocairo to fix font render issues
    [axis.py]
2026-10-06 fix some Gtk warnings; update changelog and screenshots
    [general_preferences_page.py]
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2026-10-10 feat(machine): speed-dependent bidirectional scan offset table
    On machines where the laser fires with a fixed delay, the skew between
    left-to-right and right-to-left raster passes grows with the speed, so
    one offset per step only fits one speed.
    - Machine.bidir_offset_table holds (speed mm/min, offset mm) rows,
    sorted by speed, saved with the machine profile.
    - interpolate_bidir_offset() interpolates linearly between rows and
    clamps to the first and last row; an empty table means 0.
    - BidirScanOffsetTransformer keeps a non-zero per-step offset and
    otherwise looks up the step's speed in the table, which the intent
    builder passes along and folds into the compute token.
    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
    [machine.py]
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
